katsuhaa/abarth595-round-gauge/ui_spec.md

# 595 表示器 仕様書

- 2026-11-12(表示器 meter_display 2.16.0、CANリーダー c6_can_link 2.0.0)
- 対象: アバルト 595(シリーズ 4)の純正ブースト計の位置に付ける丸型表示器と、OBD コネクタ付近の CANリーダー。画面・操作・使う CAN 信号・RaceChrono の登録をこの 1 冊にまとめた(2026-10-08 の UI 仕様書、サーキット画面・減光の仕様書、RaceChrono チャンネル一覧を統合)
- 配線・部品は別資料「595表示器_配線図」(Rev.1.6)
- 数値はファームウェア(meter_display/config.h)の値。設定で変えられるものは 8 章

## 1. 構成

| 部分 | 内容 |
| --- | --- |
| 表示器 | Waveshare ESP32-S3-Touch-AMOLED-1.75(丸型 466×466、タッチ、IMU QMI8658 内蔵)。arduino-esp32 3.3.11、NimBLE-Arduino 1.4.3。ボード「ESP32S3 Dev Module」、USB CDC On Boot = Enabled、PSRAM = OPI PSRAM、Partition Scheme = Huge APP |
| CANリーダー | Seeed XIAO ESP32C6 + SN65HVD230 ×2。C-CAN(500 kbps)と B-CAN(50 kbps)を受信だけ(送信・ACK なし)。CAN の生データを UART 921600 bps で表示器へ送る: 中身が変わった ID は最短 20 ms 間隔、変わらない ID は 1 秒ごと、1.5 秒受けていない ID は送らない |
| GPS | HGLRC M100(u-blox M10)。表示器が UBX で設定を書く: 衛星系は GPS・Galileo・QZSS(BeiDou・GLONASS・SBAS は切)、測位 20 回/秒、115200 bps、NAV-PVT だけ。M10 の測位の上限は GPS+Galileo で既定 10 回/秒なので、表示器が起動時に M10 の OTP(一度だけ書ける設定)に高性能設定を書いて 20 回/秒にする(未設定のときだけ書き、M100 をリセットして確かめる。永久で元に戻せない。結果は 受信の状態 → GPS →「OTP」。手順は u-blox の SAM-M10Q 統合マニュアル 2.1.5 のとおり: 確かめる問い合わせ(VALGET 層 4)が NAK = まだ書いていない → 書いてリセットし、同じ問い合わせが高性能の値を返せば「済」。書くのはこの表示器で一度だけ(NVS に印。2.14.5))。表示器の「IO17」← M100 の送信、「IO18」→ M100 の受信(2026-10-31 の試験で確定。配線図 Rev.1.7 の GPS の矢印とは逆)。時計・過負荷時間の時刻・RaceChrono に使う |
| RaceChrono | 表示器が Bluetooth LE 機器「595 meter」(RaceChrono DIY)になり、GPS・車の CAN の生データ・IMU を 1 台で送る(10 章) |
| 電源 | IG 連動の 12 V(ヒューズ F49 から 5A→3A のヒューズ電源)→ 表示器内の降圧コンバータ(MP1584EN)で 5 V → CANリーダー・M100 |

## 2. 操作

- タッチは触れて 0.1 秒で確定し、離したときに動く。それより短いタッチは無視。
- 画面(サーキット・タコ・データ): 左へスワイプ = 次、右へ = 前(サーキット → タコ → データ → サーキット)。スワイプ = 横に 160 px 以上(縦の 2 倍以上)。タップは何もしない。
- 長押し: 0.4 秒で案内(上「‹ スワイプ ›」、下「長押し ▶ 設定」)と外周の円が出て、1.2 秒で設定に入る。途中で離す・80 px 以上動かすと何もしない。
- 設定の中: 上の帯「‹ 名前」= 1 つ上へ(設定の段では「‹ 設定」で元の画面へ)。左右の半分のタップかスワイプ = 前・次。長押し 1.2 秒 = カテゴリ・メニューに入る(下の帯「長押しで開く」)。変更の画面: − + で値、「決定」のタップで保存(帯が 3 回点滅)、「‹ 戻る」で捨てる。リセットなどの赤い帯はタップ(確認の画面を通す)。
- 自動で戻る: 設定の中で操作が無いまま「自動で戻る」(初期 3 分)たつと、覚えている画面へ。覚えている画面 = 60 秒以上見ていたサーキット・タコ・データ。次の起動もその画面から。
- オープニング: 電源 ON で覚えている画面に応じた動き(サーキット = 輪が点いて消える、タコ = 針が振り切って戻る、データ = 外周の輪と自己診断 CAN・GPS・IMU・タッチ、版の表示)約 3 秒。タッチで飛ばせる。

## 3. 回転数の表示(全画面で共通)

S = 設定「シフトポイント」(初期 5800 rpm)。S を変えると下の回転数は同じ幅だけ動く。

| 項目 | 決まり |
| --- | --- |
| 輪(両側) | 26 マス(400 rpm/マス、すき間 2°)、半径 176〜228。左右対称に下から上へ点く。点き始め S−4400(1400)、S で全周 |
| 輪(片側) | 4 時の位置から右回りに真上まで 23 マス(200 rpm/マス)。点き始めは同じ、S で真上(最後のマス)。真上〜4 時には何も出さない |
| 色 | 灰 #8D97AD → 青 #2B7BFF(S−2800)→ 緑 #22E36A(S−1800)→ 黄 #FFDC00(S−400)→ 赤 #FF2A2A(S+400)。切り替わりの手前 400 rpm で直線的に混ぜる。消えているマスは背景色 |
| 背景(サーキット) | 黄の手前まで黒。黄 #C4A000、赤 #A31515(輪と同じ混ぜ方) |
| 点滅 | S−400 から。消灯 80 ms 一定、点灯は 150 ms(始まり)→ 50 ms(S)に回転数に比例して短く。画面全体を明るさ 0 で消す。S+200 以上は点滅せず、全点灯・明るさ 100 % |
| ピークホールド | 3000 rpm 以上で 200 rpm 以上はっきり上がったら、最高の回転数に印を出す(1.5 秒止まり、2000 rpm/s で今の回転数まで下がる)。最後に上がってから 5 秒で消す。3000 rpm 未満に下がったら消す。回転数が印を超えたら取り直す。サーキット = 画面の端の黄色の三角(輪のマスの位置。片側は 1 つ)、タコ = 黄色の印(半径 186〜228) |
| 明るさ | ふだん = 「明るさ」(初期 80 %)。ライトのスイッチが入の間 = 「イルミネーションの明るさ」(初期 30 %)。点滅の消灯 = 0。S+200 以上とオープニングの赤 = 100 %(ライトに関係なく)。フェードなし。明るさの 2 項目は、変更の画面を出している間はその値で表示 |

## 4. サーキット画面

| 要素 | 決まり |
| --- | --- |
| 回転数の輪 | 3 章 |
| 時計 | 輪の内側。目盛 60 本(毎時は長く太い。太さは毎時 4.5 px、1 分ごと 2.5 px。2.16.0 で太くした)。時針・分針は四角の塗りつぶしで、色で見分ける(2.16.0): 時針(短針)= 白、分針(長針)= 黄 #FFDC00(背景が黄のときは紺)。まわりに細い黒の縁(弧・目盛の上と、黄・赤の背景で形を分ける)。秒針は赤 #FF3B30 の正三角形(縁つき)。時刻 = GPS の UTC + 9 時間。GPS の時刻が分かるまで針は出さない(デモの間はビルドした時刻から進める)。1 秒ごとに動く |
| 水温・燃料の弧 | 時計の内側(半径 98〜134、長さ 100°)。水温 = 上の弧(左端から時計回り。40〜120 ℃、70 ℃まで青 #2F8BFF、それより上は白。警告温度から上の地は暗い赤 #6A1C26)、アイコンは右端。燃料 = 下の弧(左端から反時計回り。0〜100 %、白。燃料の警告 未満の地は暗い赤)、アイコンは左端。信号なしは「– –」 |
| 真ん中 | 上から順に当てはまる 1 つ: ① ピークの三角を出している間 = ピークの回転数(88 px)と「rpm」。上がり切って下がったあとは黄、加速中(今の回転数が数字の 100 rpm 以内)は白。② 過負荷時間が黄(黄が切なら赤)になってから 0 に戻るまで = 半径 96 の黒い円に、タイトル「過負荷」と 分:秒(白・黄・赤)。クールダウン中はタイトル「クールダウン」とリセットまでの残り(水色)。条件を満たせば下に「▼ (過負荷 回転数)rpm」と経過時間、GPS の時刻が不明なら上に「時刻 待ち」。③ 過負荷の機能が切で、ギア N が 60 秒続いた = 「▼ (過負荷 回転数)rpm」とその回転数未満になってからの経過時間。④ そのほか = デジタル時計(時:分)。接続の状態(GPS・IMU・RaceChrono・CAN の 4 行、点は 緑 = 正常・灰 = 待ち・切・赤 = 異常)は、変わってから 10 秒の間と GPS の時刻が分かるまでの間だけ出す |
| 注意・警告 | 2 段。注意 = 水温 ≥ 警告温度 − 5 ℃、燃料 < 燃料の警告 + 10 %: 弧の伸びた所とアイコンが暗い黄 #E0B000(点滅なし)。警告 = 水温 ≥ 警告温度、燃料 < 燃料の警告: 赤 #E3241B で 250 ms ごとに点滅(消灯側は暗い赤 #8E130D)。背景は塗らない(黒のまま)。戻るときは境目から 1 ℃・1 % の幅 |
| メンテナンス | 累積時間がメンテナンスの時間に達したら赤の「メンテナンス」(7 章) |
| デモ | 模擬データの間は「SIM」と場面番号 |

## 5. タコ画面

| 要素 | 決まり |
| --- | --- |
| 回転計 | 0〜8000 rpm。0 を左下(3 時から時計回りに 120°)に置き、1000 rpm = 25°(6000 が真上)。目盛線は 1000・500・250 ごと(灰)、数字は ×1000(60 px、白)。赤の範囲は S から(暗い赤の帯、数字は赤)。回転数が S 以上の間は目盛線・数字・針を全部赤(S−100 まで下がると戻す)。針は白、太さ 14 px、黒い縁 3 px と影。ピークの印は黄(3 章) |
| ブースト | 中央の輪(半径 62〜108)。0 bar を左下(回転計の 0 と同じ角度)、1.4 bar を真上、2.0 bar を端(回転計の 8000 と同じ角度)に置き、その間は比例。1.4 bar から赤。目盛線 0・0.5・1.0・1.4・2.0、数字 0・1・2 は輪の内側。今の値は右上に数字(bar、小数 2 桁、56 px、白。負圧は −。信号なし「– –」) |
| ギア | ブーストの数字の下(右下、100 px)。1〜5・N・R、分からないときは「–」(9 章) |
| 注意・警告 | 水温・燃料が注意・警告のときだけ、右下に札(アイコン + 数字)。注意 = 黒地に暗い黄の枠と文字(点滅なし)、警告 = 赤い札に白い文字(250 ms 点滅)。正常なら出さない。境目は 4 章と同じ |
| SPORT | スポーツモードの間、下の真ん中に赤の「SPORT」 |
| メンテナンス | 7 章 |

## 6. データ画面

| 要素 | 決まり |
| --- | --- |
| 外周 | 回転数の輪(半径 222〜232)。真上から時計回りに 0〜8000 rpm で一周。色は 3 章 |
| 上の 3 行 | GPS: 衛星の数と測位の回数/秒(受信なし = 赤、切 = 灰)。IMU: 前後・横の加速度 [g](応答なし = 赤、切 = 灰)。CAN: C-CAN・B-CAN の受信数/秒(C-CAN が 0 = 赤)。左の点 = 緑(正常)・灰(待ち・切)・赤(異常) |
| 中 | 水温 ℃・燃料 %(注意は暗い黄、警告は赤で点滅、信号なし「– –」。境目は 4 章と同じ) |
| 下 | ▲ 累積時間(過負荷 回転数以上だった時間の累計)。その下は ▼(未満の累計)。メンテナンスまでの累積時間が入なら、▼ の代わりに「メンテまで」の残り、達したら赤の「メンテナンス」 |

## 7. 過負荷時間・累積時間・メンテナンス

境目 = 設定「過負荷 回転数」(初期 3000 rpm)。

| 項目 | 決まり |
| --- | --- |
| 過負荷時間 | 回転数が境目以上なら 1 秒に 1 秒増え、未満なら 1 秒に 1 秒減る(エンジン停止中も。電源 OFF の間は GPS の時刻から求めて次の起動で引く)。未満が「過負荷がリセットされる時間」(初期 5 分)続いたら 0。上限 9:59:59。回転数の信号が無い間は変わらない |
| 色 | 「過負荷時間 黄」(初期 10 分)以上で黄、「過負荷時間 赤」(初期 30 分)以上で赤。0 の色は使わない。両方 0 で機能を切(数えない・出さない) |
| クールダウン | リセットのあと一度黄(黄が切なら赤)になり、境目未満が 1 分続いたら、タイトルを「クールダウン」にしてリセットまでの残りを水色で出す。境目以上に戻ると「過負荷」に戻る |
| 累積時間 | ▲ = 境目以上だった時間の累計、▼ = 未満の累計(回転数の信号がある間だけ数える)。1 分ごとに保存し、電源を切っても続く |
| メンテナンス | 「メンテナンスまでの累積時間」(初期 5 時間、0 = 切)に ▲ が達したら、サーキット・タコ・データに赤の「メンテナンス」 |
| 累積時間 リセット | 値を 0:00:00 から 30 分ずつ入れて「リセット」: ▲ をその値、▼ を 0、過負荷時間もその値以下にする |

## 8. 設定

設定の段(左右で送る)にカテゴリ、長押しで中へ。中は 1 画面 1 項目。保存先は NVS(名前空間 "meter")。カテゴリの並びは下の表の順(走行記録が最初。2.15.3)。電源を入れてから最初に設定に入ったときは走行記録、そのあとは前に見ていたカテゴリから。

| カテゴリ | 項目 | 範囲 / 刻み | 初期値 |
| --- | --- | --- | --- |
| 走行記録 | 今の ODO。長押しで 1 年の画面(8.1) | | |
| 画面 | 明るさ | 10〜100 % / 10 | 80 |
| | イルミネーションの明るさ | 10〜100 % / 10 | 30 |
| | 自動で戻る | 1〜10 分 / 1 | 3 |
| シフトポイント | シフトポイント | 3000〜7500 rpm / 100 | 5800 |
| | 回転数の輪 | 両側・片側 | 両側 |
| 警告・過負荷 | 水温の警告 | 90〜125 ℃ / 5 | 110 |
| | 燃料の警告 | 5〜50 % / 5 | 20 |
| | 過負荷 回転数 | 2000〜6000 rpm / 100 | 3000 |
| | 過負荷時間 黄 | 0〜90 分 / 5(0 = 切) | 10 |
| | 過負荷時間 赤 | 0〜90 分 / 5(0 = 切) | 30 |
| | 過負荷がリセットされる時間 | 1〜30 分 / 1 | 5 |
| | メンテナンスまでの累積時間 | 0〜99 時間 / 1(0 = 切) | 5 |
| | 累積時間 リセット | 0:00:00 から 30 分ずつ、99 時間まで | – |
| 受信の状態 | 長押しで中へ。CAN・GPS・IMU・RaceChrono の 4 グループ(下) | | |
| 本体の状態 | 長押しで中へ。FPS(直近 3 分のグラフ。平均 20 未満で赤)・CPU・クロック・温度・RAM・PSRAM・フラッシュ・起動のきっかけ・走行記録(件数・今日の距離・ODO の受信。下の行に ODO と最後に書いた時刻) | | |
| その他 | デモ | 入・切 | 切 |
| | デフォルトに戻す | 設定を全部初期値に。過負荷時間は 0。累積時間・IMU の向きは残す | |

受信の状態の中:

- CAN: 通信速度・受信・誤り・欠落・CANリーダー(版)・C-CAN/B-CAN(受信数。ここから「CAN確認」)・燃料(b5 の生の値)・ライト(点/消と今の明るさ)・前後で比べる。
- GPS: 測位(衛星の数と回数/秒)・位置・速度・OTP(M100 の高性能設定: 済 20 Hz / 待ち / 未 10 Hz / 不明 / 異常。不明・異常は赤)。IMU: 加速度・向きの補正(取り直し)。RaceChrono: 送信(入・切。次の起動から)・接続・送った数(CAN・GPS・IMU の数/秒。捨てた数。2.14.2: RaceChrono が IMU の PID 0618A0F1/F2 を頼んでいなければ「IMU 未設定」(片方なら F1/F2未設定)で待ち)。
- 点の色: 緑 = 正常、赤 = 異常、灰 = 待ち・切。まとめは、赤が 1 つでもあれば「異常 n」、通信の項目が全部緑なら「正常」、ほかは「待ち」。
- CAN確認: 「変化を記録」を押すたびに、前の記録から 1〜8 回変わったバイトを持つ ID に絞る(スイッチのような信号)。行を開くと 8 バイトの値と 20 秒の折れ線。「前後で比べる」(2.16.0 で作り直し): 下の「前を記録」「後を記録」を交互に押す(1 回目は前)。押してから 10 秒受けたものを 1 回の記録にし、何回でも繰り返して絞る。記録は保存されるので、電源を切っても続けられる(エンジンをかけ直さないと戻らない切り替えにも使える)。候補は、毎回の記録の間ずっと変わらなかったビットで、前ではいつも同じ値・後ではいつもその逆のもの(一覧の「b0 & 02  01 → 03」= バイト & 候補のビット、1 回目の前 → 1 回目の後のそのバイトの値)と、前では毎回受けて後では一度も受けなかった ID(後は受信なし)、その逆(前は受信なし)。受信が始まって 15 秒は記録できない(帯に待ちの秒)。記録の間に状態を変えると、変わったビットは候補から外れて戻らないので、切り替えてから押す。画面: 候補の件数・前と後の回数・件数の移り変わり、左「やり直す」(記録を全部消す)、右「一覧」(今は受けていない ID は「今は受信していない」で、詳細なし)。2.15.x までの前の記録は読み戻さない。
- デモ: 入の間は UART を読まず、模擬の値(場面 1〜9)を出す。
- 落ちる起動が 2 回続いたら、表示器が RaceChrono 送信と GPS を自分で切にする(送信を入に戻すと次の起動から戻る)。
- 保存するもの: 設定、累積時間 ▲▼、覚えている画面、IMU の向き、過負荷時間と時刻、前後で比べるの記録、GPS を止めた印。走行記録はパーティション spiffs(8.1)。

### 8.1 走行記録(2.15.0。詳しくは仕様書 odo_log_spec.md)

- 記録: ODO(B-CAN 0C014003、km)とその日の過走行時間(▲ と同じ数え方)を、低速(10 km/h 以下。停車も入る)かリバースのとき、前の記録から増えていて 60 秒以上あいていれば 1 件(32 バイト)書く。日付は GPS の時刻(日本時間)。時刻が分かるまでは書かない。0 時をまたいだら、次に低速・リバースになったときに前の日の締めの記録を書く。
- 保存先: パーティション spiffs(Huge APP で 896 KB = 28,672 件、輪のように古い方から消す)。Partition Scheme を切り替えると消える。
- 画面: 設定 → 走行記録(今の ODO)→ 長押しで 1 年 → 長押しで 3 ヶ月 → 1 ヶ月 → 1 週(日曜〜土曜)→ 1 日(1 年は 2.15.2 から)。1 画面 1 期間: 期間・終わりの ODO(大きく。今の期間は今の ODO)・始まり〜終わりの ODO・距離・▲ 過走行時間。左右のタップかスワイプで前・次の期間(今の期間より先、いちばん古い記録の期間より前へは進まない)。長押しで細かい方(その期間の中の、今日までで最後の期間)、上の帯で粗い方(来た期間へ戻る)。記録の無い日は、その前の記録の ODO。3 ヶ月は 1〜3 月・4〜6 月・7〜9 月・10〜12 月。GPS の時刻が分かるまでは「時刻 待ち」と今の ODO・起動からの距離。

## 9. 使う CAN 信号(表示器での換算)

すべて 29 ビット ID。b0 が先頭のバイト。「信号なし」= その時間受けなかったら値を消す。

| 信号 | バス | ID | 位置・換算 | 使う所 | 信号なし |
| --- | --- | --- | --- | --- | --- |
| 回転数 | C | 0618A001 | b2〜b3(ビッグエンディアン)= rpm | 輪・タコ・ピーク・過負荷・累積時間 | 2 秒 |
| アクセル | C | 0618A001 | b7 / 2.55 = % | (表示には使っていない) | 2 秒 |
| 車速 | C | 0210A006 | b4〜b5 / 128 = km/h | ギアの推定 | 2 秒 |
| クラッチ | C | 0628A001 | b5 の 0x20 = 踏んでいる | (ギアの保持には使っていない) | 2 秒 |
| 水温 | C | 0A18A001 | b3 − 40 = ℃ | 弧・数字・警告 | 3 秒 |
| リバース | C | 0A18A001 | b7 の 0x04 = R | ギア | 2 秒 |
| ブースト | C | 0A1CA001 | b2 × 0.02 = bar(大気圧との差) | タコ | 2 秒 |
| 燃料 | C | 0A18A000 | b5 = %。0 と 100 超は捨てて前の値のまま(エンジン停止中と始動・停止の前後約 1 秒は 0 で来る) | 弧・数字・警告 | 5 秒 |
| スポーツモード | C | 0A18A000 | b4 の 0x10 = SPORT | タコ | 5 秒 |
| ODO | B | 0C014003 | b1 の下位 4 ビット + b2 + b3(20 ビット、ビッグエンディアン)= km。減った値と 5 km を超えて増えた値は捨てる(同じ値が 20 回続いたら使う) | 走行記録 | 2 秒(書かない) |
| ライトのスイッチ | B | 06214000 | b0 の 0x08 = 入(ほかのビットは見ない。違う値が 0.3 秒続いたら切り替え) | 明るさ | 5 秒(明るさは最後の状態のまま) |
| ギア | – | – | R はリバースのビット。1〜5 は 回転数 ÷ 車速 を各ギアの計算値(変速比 3.909 / 2.238 / 1.520 / 1.156 / 0.872、最終減速比 3.353、タイヤ外周 1.878 m)と比べ、±12 % に入ったギア。車速 2 km/h 未満は N、5 km/h 未満か 500 rpm 未満は前の値のまま、どれにも合わなければ「–」 | タコ | |

## 10. RaceChrono の登録

### 10.1 機器

RaceChrono(iPhone)の 設定 → Add other device → Add other device → RaceChrono DIY で「595 meter」(Bluetooth LE)を 1 台登録する。GPS はこれで届く(登録不要)。IMU と車の CAN は、車両プロファイル → CAN-Bus チャンネル に 10.3 の表を登録する。IMU は CAN の形で 20 回/秒送る(取り付けの向きは自動で覚える: 停車 3 秒で「上」、発進の加速で「前」)。

### 10.2 入力の決まり

- チャンネルは「種類」を一覧から選ぶ(自由な名前は付けられない)。種類ごとに RaceChrono が受ける単位が決まっているので、方程式はその単位に合わせてある: 速度・ホイールスピード = m/s(km/h ÷ 3.6)、マニホールド圧 = psi(bar × 14.5038)、ポジション = %、温度 = ℃、角度 = °、加速度 = m/s²、ヨーレート = deg/s。
- PID は 10 進で入力する(入れると「0x 06 18 A0 01」のように表示される)。
- 方程式の割る数には小数点を付けてある(整数 ÷ 整数は切り捨てになる)。ビット番号は b0 の最上位ビットを 0 と数える。
- 表示器は登録した PID だけを送る(最大 48 種、1 PID につき最短 50 ms)。B-CAN の登録は不要。
- リバースとスポーツモードは、合う種類が無いので RaceChrono には登録しない(表示器で見る)。

### 10.3 チャンネル

| # | 種類 | PID(10 進) | 方程式 | 備考 |
| --- | --- | --- | --- | --- |
| 1 | エンジン回転数 | 102277121 | `bytesToUint(raw, 2, 2)` | rpm |
| 2 | スロットルポジション | 102277121 | `bytesToUint(raw, 7, 1) / 2.55` | % |
| 3 | 速度 | 34643974 | `bytesToUint(raw, 4, 2) / 460.8` | m/s(km/h ÷ 3.6) |
| 4 | ホイールスピード FL | 35168262 | `bytesToUint(raw, 6, 2) / 57.6` | 左前。m/s |
| 5 | ホイールスピード FR | 35168262 | `bytesToUint(raw, 4, 2) / 57.6` | 右前 |
| 6 | ホイールスピード RL | 35168262 | `bytesToUint(raw, 2, 2) / 57.6` | 左後 |
| 7 | ホイールスピード RR | 35168262 | `bytesToUint(raw, 0, 2) / 57.6` | 右後 |
| 8 | ステアリング角 | 3186690 | `(bitsToUint(raw, 24, 20) - 7235) * 0.1` | °、左が +。7235 = 直進の生の値(10/22 の走行ログの直進区間)。直進で値が出るときは、その 10 倍を 7235 に足して直す(+1.5° なら 7250) |
| 9 | ブレーキ圧 | 1089542 | `bytesToUint(raw, 1, 2)` | 生の値(圧力への倍率は未確定。単位は付かない数字として見る) |
| 10 | ブレーキポジション | 135307264 | `bitsToUint(raw, 18, 1) * 100` | 0 / 100 %(踏んでいる = 100) |
| 11 | クラッチポジション | 103325697 | `bitsToUint(raw, 42, 1) * 100` | 0 / 100 %(踏んでいる = 100) |
| 12 | 水温 | 169385985 | `bytesToUint(raw, 3, 1) - 40` | ℃ |
| 13 | マニホールド圧(吸気圧) | 169648129 | `bytesToUint(raw, 2, 1) * 0.290076` | ブースト。psi(0.02 bar = 0.290076 psi。68 → 19.7 psi = 1.36 bar)、大気圧との差。要るときだけ |
| 14 | 燃料レベル | 169385984 | `lowPass(highPass(bytesToUint(raw, 5, 1), 1), 100)` | %。1〜100 以外(エンジン停止中の 0)は NaN で記録しない。要るときだけ |
| 15 | 縦加速度 | 102277361 | `bytesToIntLe(raw, 0, 2) * 0.00980665` | m/s²、前が + |
| 16 | 横加速度 | 102277361 | `bytesToIntLe(raw, 2, 2) * 0.00980665` | m/s²、右が + |
| 17 | Z加速度 | 102277361 | `bytesToIntLe(raw, 4, 2) * 0.00980665` | m/s²、上が +(重力は引いてある)。10/15 に登録済みの種類 |
| 18 | ヨーレート | 102277362 | `bytesToIntLe(raw, 0, 2) * 0.01` | deg/s、左が + |

- 1〜12 と 15〜18 がふだんの登録(PID 10 種)。13・14 は要るときだけ(PID が 1 種ずつ増える)。
- 種類の名前は RaceChrono の一覧の表記に合わせる(英語表示なら Engine RPM / Throttle position / Speed / Wheel speed FL〜RR / Steering angle / Brake pressure / Brake position / Clutch position / Coolant temperature / Manifold pressure / Fuel level / Longitudinal acceleration / Lateral acceleration / Z acceleration / Yaw rate)。
