katsuhaa/abarth595-round-gauge/cad/595merter.FCStd

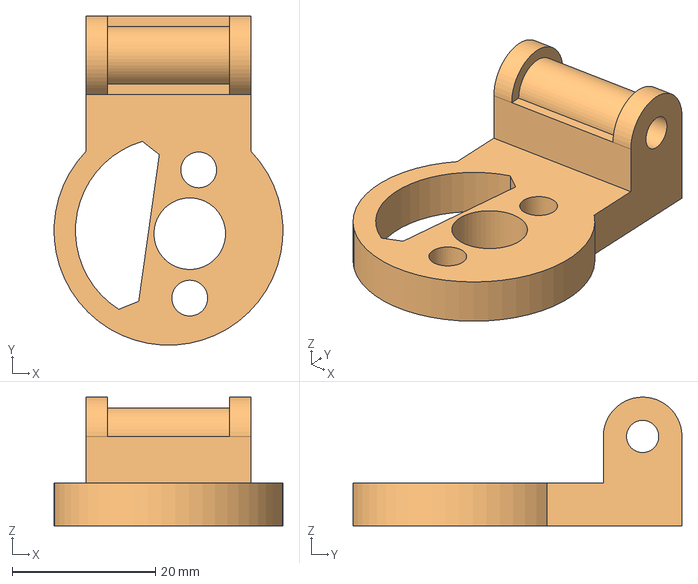
[picture p5: CAD file, 2026-10-29]
cad/595merter.FCStd
32.0 x 46.0 x 18.0 mm
flex-bracket-spacer
flex-bracket+spacer
