katsuhaa/abarth595-round-gauge/cad/obd2-can-link.FCStd

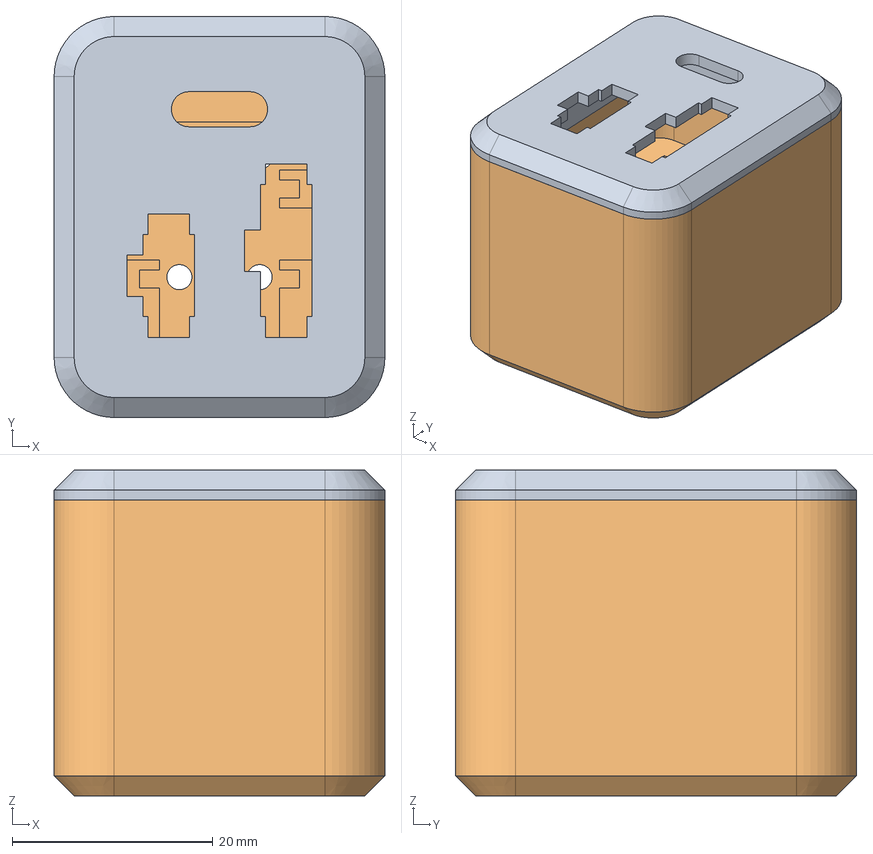
[picture p6: CAD file, 2026-10-25]
cad/obd2-can-link.FCStd
33.0 x 40.0 x 32.5 mm
canreader-lid
canreader-body
