katsuhaa/abarth595-round-gauge/meter_display/config.h

// config.h - 595 メーター表示器の設定値
//
// 画面の配置と色は ui_spec.md(キャンバス版 23)のとおり ui.cpp に書いてある。
// ここには、仕様書で【仮】【未定】になっている値と、基板まわりの値をまとめた。
// 【未定→仮】は、仕様書で未定だった所に今回仮に置いた値。
#pragma once

// ---------------------------------------------------------------- 版(2026-10-23 から git で管理。上げるたびにコミットする)
// 形式は「大.中.小」。小 = 直しだけ、中 = 機能・画面の追加や変更、大 = CANリーダー(c6_can_link)とのデータ形式が変わるとき。
// データのオープニング(自己診断の下)と設定の上の帯に出す。CANリーダーの版は 受信の状態 → CAN の「CANリーダー」に出る
// 2.0.0(2026-10-23): 値への換算・ギアの推定・燃料のなましを c6_can_link から移した(c6_can_link 2.0.0 と組で使う。1.x の c6_can_link でも動く)
// 2.0.1(2026-10-23): タッチの読み取りのあとに 0xAB を書くのをやめた(長押しが「離した」で切れる)。受信の状態の「描画」を、
//   サーキット・タコで 1 回描いて送る時間の最長にした(前は直近 1 秒に送った回数で、受信の状態の画面では必ず 2 になっていた)
// 2.1.0(2026-10-23): サーキット・タコ・データの操作を、左右のスワイプで画面を替え、長押しで設定に入る形にした(短いタップは何もしない)
// 2.2.0(2026-10-23): 実車で試した結果から、長押し 0.8 秒・表示は半分から・スワイプの幅 160 px。ピークホールドは 3000 rpm 以上で、
//   回転数が下がっているときだけ出し、ピークを超えたら消す(時間がたつと下がるのは前のまま)。通信が切れているのに設定の「受信の状態」
//   「RaceChrono」が「正常」と出ていたのを直した。
//   受信の状態に「燃料」(生の値となましの値)を足した(燃料が 100 % から動かない件を実車で見るため)
// 2.3.0(2026-10-24): タッチは TOUCH_CONFIRM_MS 押し続けてから決める(短いタッチは何もしない)。サーキット・タコ・データでは
//   決まった時点で真ん中に操作の案内を出す。長押しは表示が 0.8 秒、設定へ 1.2 秒。設定の「決定」で保存したら「保存しました」を出す。
//   設定の上の帯を「‹ 設定」にした。設定の並びを 明るさ・受信の状態・シフトポイント・水温の警告・時間の記録・自動で戻る・デモ にし、
//   RaceChrono と CAN確認 は受信の状態の中へ移した(受信の状態に GPS・IMU も足した)。受信の状態の「描画」を「FPS」にし、
//   1 回だけの大きな描き直し(受信が切れた瞬間など)で赤にならないようにした
// 2.3.1(2026-10-24): 2.3.0 を実機で試した結果から: タッチが決まるまでを 0.3 → 0.1 秒(設定の中で、ふつうのタップが効かなかった)。
//   長押しは 0.4 秒で表示を出し、外周は 0.8 秒で一周して 1.2 秒で設定(2.3.0 は 0.8 秒で表示、外周 0.4 秒)。案内は長押しの表示と
//   同じ形の札 2 つ(上に「長押し ▶ 設定」、真ん中に「‹ スワイプ ›」)にし、動きをなくした。「保存しました」の画面をやめ、保存した値を
//   緑で数回点滅させる(2.3.0 はコミットしていない試しの版)
// 2.4.0(2026-10-24): 2.3.1 を実機で試した結果から(2.3.0・2.3.1 はコミットしていない試しの版):
//   受信の状態を分け直した(CAN・GPS・IMU・RaceChrono のグループ。中は 1 ページ 1 項目。同じ値は 1 か所だけ。CAN確認は CAN の
//   「C-CAN・B-CAN」から開く。「送り元」は「CANリーダー」)。受信と関係ない FPS・起動は、設定の新しい項目「本体の状態」へ。
//   上の帯は今いる所の名前。変更の画面は値を枠で囲み、下の「決定」を水色の帯にした(項目の画面と見た目を分けた)。
//   スワイプは右へ = 次(前は左へ = 次。2.4.2 で左へ = 次に戻した)。設定の中の項目・ページの送りもスワイプにし、どの画面も離したときに決める。
//   案内は上に「‹ スワイプ ›」、下に「長押し ▶ 設定」(上下対称)。長押しの途中は案内のままスワイプの札を灰にして外周が回る
//   (暗くしない)。長押しを取り消す動きを 30 → 80 px にし、取り消したら案内は出したまま長押しの札を灰にする。
//   ピークホールドは 5 秒止まってから下がり、ピークが 3000 rpm 以上なら上がっていても出す。タコは回転数がシフト点以上の間、
//   目盛線・数字・針を全部赤にする
// 2.4.1(2026-10-24): 設定の中の左右の「‹」「›」のタップで前・次に送るのを戻した(2.4.0 はスワイプだけで、矢印が押せなかった。
//   スワイプでも送れる)。変更の画面の値の枠をやめ、値を水色にした(「決定」の水色の帯はそのまま。2.4.0 はコミットしていない試しの版)
// 2.4.2(2026-10-24): スワイプを左へ = 次(サーキット → タコ)に戻した(2.4.0〜2.4.1 は右へ = 次。本人「間違えました 左にスワイプでタコでした」)。
//   設定の中のスワイプも左へ = 次(右の「›」のタップと同じ向き)。2.4.1 はコミットしていない試しの版
// 2.4.3(2026-10-24): 設定の中の下の帯は、開く・変更するときはどれも「決定」にした(「開く」「変更」「詳細」をやめた。本人「操作の統一感
//   がなく戸惑う」)。CAN確認は CAN の最後のページから開く。IMU の向きの取り直しは確認の画面を通す。変更の画面で「決定」で保存したら、
//   押した所(下の帯)を点滅させ、その間は値を太くし、終わってから戻る(戻った画面で値を緑で点滅させるのはやめた)。
//   本体の状態に CPU・クロック・温度・RAM・PSRAM・フラッシュを足した。FPS は直近 3 分(サーキット・タコを出していた秒)の 1 秒ごとの値の
//   グラフを出し、赤は平均で決める(前は最低で決めていて、毎回赤だった)。サーキットのピークの三角形は、シフト点で輪の真上まで行く
//   (前は 12 マス目で止まっていた)。2.4.2 はコミットしていない試しの版
// 2.4.4(2026-10-24): 設定の中でメニューに入る(開く)のは、下の帯の長押しにした(サーキット・タコ・データから設定に入るのと同じ HOLD_MS。
//   下の帯は「長押しで開く」。本人「メニューに入るときは長押しで開くにします。下の帯にも長押しで開くと書いてください」)。「決定」は値を
//   確定するとき(変更の画面)だけ(2.4.3 は開くのも「決定」で、意味が 2 つになっていた)。ピークホールドは、止まる時間を 2.2.0 と同じ
//   1.5 秒に戻し、そのあと下がりながら出し続け、回転が落ち始めてから 5 秒で消す(2.4.0 の「5 秒止まる」は本人の意図の取り違え)。
//   2.4.3 はコミットしていない試しの版
// 2.4.5(2026-10-24): 2.4.4 を実機で試した結果から: 「長押しで開く」は画面のどこを長押ししても開く(2.4.4 は下の帯だけ。本人「その場所では
//   なく画面全体です」)。「決定」は変えていなくても押したら点滅させる(本人「決定のフラッシュが消えました」。2.4.3〜2.4.4 は保存したときだけ)。
//   ピークホールドの印を出す時間(5 秒)を数え直すのは、回転数がはっきり上がったとき(PEAK_RISE_RPM 以上)だけにした(本人「今度ピーク
//   ホールドが消えていません」。2.4.4 は 3000 rpm 以上で回転数が少しでも上がるたびに数え直していて、走っている間は消えなかった)。
//   印が 3000 rpm を切ったら消す(本人「3000 以下に下がった場合は消してしまっていいです」。2.4.4 は 5 秒までは出していた)。
//   2.4.4 はコミットしていない試しの版
// 2.5.0(2026-10-24): オープニングを、覚えた画面(サーキット・タコ・データ)ごとの 3 種類にして、長く(約 3.3 秒)した(本人「もう少し長く
//   印象的に」「アニメーションはサーキット、タコ、データの 3 つ」「データは GPS などの状態を出す。それ以外は状態の画面は出さなくていい」)。
//   サーキット: 白い光が輪を走り、回転数を上げるように点いて、背景も赤のリミッター、下げるように消えてギアが浮かぶ。タコ: 針が振り切りまで
//   上がって戻る(通った所から文字盤が出る)。データ: 外周の輪と、1 行ずつ確かめる自己診断。流れは下のオープニングの節。
//   データ画面の外周に回転数の輪を足した(本人「実際の画面にも回転数のグラフを追加したい」「アニメーションと同じ幅で」。DATA_RING_*)。
//   2.4.5 を実機で試した結果から: 設定の中で、矢印のタップでは下の帯「長押しで開く」を変えない(水色にするのは長押しの外周が回り始める
//   HOLD_SHOW_MS から。本人「左右の矢印をタップした時に長押しで開くボタンが反転してしまうので混乱します」)。
//   2.4.5 はコミットしていない試しの版
// 2.6.0(2026-10-24): CAN確認に「前後で比べる」を足した(受信の状態 → CAN の最後のページ。本人「長く変化する燃料のような CAN ID を
//   今のメニューで絞り込めるか」「変化が少ない項目の中で、給油のようなイベントを記録して変化が大きいものを検出する」)。前を記録 →
//   電源を切って給油など → 入れ直して後を記録で、前も後も変化が少なく差が大きいバイトを出す。前の記録は NVS に保存する。CAN_PP_*
// 2.7.0(2026-10-24): 燃料を C-CAN 0A18A000 b5(残りの %)にした(2.6.0 までの B-CAN 0C014003 b5 は燃料ではなかった。本人「どうも燃料の
//   canID が違うのではないかとおもうぐらいズレます」)。値が落ち着いているので、なまし・給油の判定・保存をやめた(下の 燃料)。
//   長押しの表示(外周)が出たあとに離したら何もしない(本人「長押しを認識して、アニメーションが出た後に指を離した場合は何も動作しない
//   ほうがいい」。2.6.0 までは、その所のタップになっていた)。設定・CAN確認の上の帯と、タップで動く下の帯は、押している間は反転し、
//   下の帯は離して PRESS_FLASH_MS 見せてから動く(本人「can確認画面などでボタンを押した時に押したことがわかりにくいので、反転表示を
//   入れてください」)。前後で比べるの案内を「エンジンを切る前に記録」にした。2.6.0 はコミットしていない試しの版
// 2.8.0(2026-10-25): ブーストを C-CAN 0A1CA001 b2 × 0.02 bar にした。2.7.0 までの 0A18A001 b4 は燃料の量だった(本人「ブースト圧と車速は
//   比例で立ち上がりますか？」「燃料ではないですか？　減速ですぐに０になるも理にかないます」。減速の燃料カットで 0、クラッチを踏んで
//   900〜1300 rpm に落ちると戻る)。係数は本人決定(「0.02で行きます」)。10/22 の全開(2 速)の最大 68 → 1.36 bar。
//   タコのブーストの輪は、真上(0 時)を 1.4 bar、端を 2.0 bar にした(本人「ブーストのグラフを１．４barを天井にしてください」
//   「グラフが０時になったときに１．４としてください」「端は２．０にします」。2.7.0 は真上が 1.5 bar)。赤は 1.4 bar から。
//   0〜1.4 bar を左下から真上まで、1.4〜2.0 bar を真上から端まで、それぞれ比例。目盛線は 0・0.5・1.0・1.4・2.0
// 2.9.0(2026-10-26): ライトのスイッチ(B-CAN 06214000 b0 の 0x08。下の VEH_ID_LIGHT)が入の間は、ふだんの明るさを設定の新しい項目
//   「イルミネーションの明るさ」(明るさの次。初期値 30 %)にする(本人「ライトがONの時に表示の明るさを落とす機能を追加したい」。
//   Project の仕様書 light_dimming_spec.md 第 3 版)。点滅の消灯(0)、シフト点 + RING_SOLID_OFFSET 以上の最大(100 %)とオープニングの赤は
//   ライトに関係なく今のまま(本人「A」)。明るさの 2 つの項目は、変更の画面を出している間はその値で表示する。
//   受信の状態 → CAN に「ライト」(燃料の次)。設定の名前が 1 行に入らないときは 2 行に分ける
// 2.10.0(2026-10-27): サーキット画面を作り直した(Project の仕様書 circuit_screen_spec.md 第 3 版、キャンバス「595 メーター サーキット画面・
//   タコ画面 案」)。輪の内側にアナログ時計(GPS の時刻 + 9 時間。目盛 12 本、四角い時針・分針・秒針を水温・燃料の弧の半分から重ねる)、
//   水温・燃料の弧は時計の内側(半径 98〜134。アイコンは水温が右端、燃料が左端)。真ん中のギアをやめ、ピークの回転数(「rpm」を下に)・
//   高負荷時間(黒い円の上にタイトルと白・黄・赤の文字。クールダウン時間を超えたらタイトルを「クールダウン」)・接続の状態(GPS・IMU・
//   RaceChrono・CAN)を出し分ける。高負荷時間(load): 3000 rpm 以上で増え、未満で減り、3000 rpm 以下が「高負荷時間 リセット」続いたら 0。
//   ▼ 3000rpm は高負荷時間の下に出し、高負荷時間が 0 になったら消す。タコはブースト圧の数字を上に小さくし、下にギア。警告の札を下へ。
//   設定に「高負荷時間 黄」「高負荷時間 赤」「クールダウン時間」「高負荷時間 リセット」「デフォルトに戻す」(本人 14:51「デフォルト設定を
//   作り、デフォルトに戻すを入れたい」)を足して 14 項目。GPS は RaceChrono 送信の入・切に関係なく動かす(meter_display.ino)。
//   スケッチが既定の 1.2MB APP を超えた(1,339,367 バイト)ので、「ツール」の Partition Scheme を Huge APP か Minimal SPIFFS にする(meter_display.ino の先頭)
// 2.11.0(2026-10-28): 時計の針と目盛を Apple Watch 風にした(時針・分針は枠が白・中が黒の四角、明るい背景では逆。目盛は 1 分ごとに
//   60 本。秒針は縁の付いた赤の正三角形。本人 10/28。キャンバス W1〜W6。下の HAND_*・SEC_*・CLK_TICK_*)。ピークの回転数は、回転が上がり切って
//   下がったあと印が止まっている間(TACH_PEAK_HOLD_MS)だけ黄、加速中と印が下がっている間は白(本人「ホールドしているときに黄色　それ以外は白」
//   「ピークになったときだけ黄色に。加速中も白」。下の PEAK_NUM_DROP_RPM)。サーキットの真ん中の接続の状態は、変わってから 10 秒と時刻が分からない間だけにし、ふだんはデジタル時計(STATUS_SHOW_MS)。タコの下の真ん中に「SPORT」(スポーツモードの間。C-CAN 0A18A000 b4 の 0x10。
//   本人 10/28「スポーツモードのCANIDが確定した」。下の VEH_SPORT_MASK・TACH_SPORT_*)。デモ表示の間は、GPS の時刻が分かるまで、ビルドした時刻
//   (日本時間)から電源を入れてからの時間で時計を進める(本人「デモで時計表示が無いので時刻を確かめられません」。meter_display.ino の timePoll。
//   時計の表示だけで、高負荷時間と保存する時刻には使わない)
// 2.12.0(2026-10-28): 設定に「回転数の輪」(両側・片側)を足して 15 項目(シフトポイントの次)。片側は、4 時の位置から右回りに
//   真上まで 23 マス(200 rpm ごと)並べ、シフト点(最後のマス)が真上(本人 10/28「片方だけのを実装したい」「シフトタイミングが天井で」
//   「なんで左回り？」「右の水平から天井までの回転角で表すように」「回転数の始まりは４時の位置から」。下の RING_ONE_*)。ピークの三角も 1 つ。既定は今までと同じ両側(SET_RING_DEFAULT)。
//   走行画面の背景は黄の手前まで黒(緑をやめた。本人「回転数の警告 → 黄色までは背景を黒に」。ui.cpp の BACK_C)
//   同じ 2.12.0 で(本人「versionは今のままで大丈夫です」)、設定を 6 つのカテゴリにまとめた(本人 10/28「設定の項目が長くなったので
//   カテゴリにまとめて」「シフトと言うメニューの名前はシフトポイントに」「過負荷のは高負荷メニューとして水温、高負荷のしたに」)。設定の段:
//   画面・シフトポイント・水温・過負荷・受信の状態・本体の状態・その他(左右で送り、長押しで中へ。受信の状態・本体の状態は今までどおり
//   長押しでその中へ)。カテゴリの中: 1 画面 1 項目(上の帯「‹ カテゴリ名」で戻る)。
//   過負荷(本人「過負荷は短期的な上昇によりクールダウンが必要になるという考え方と、それの累積によりメンテナンスの期間を推測する機能」
//   「過負荷に統一して今の過負荷計測を累積時間に」): 「高負荷時間」を「過負荷時間」に(サーキットの真ん中のタイトルも「過負荷」)。
//   「時間の記録」を「累積時間」に(▲ = 過負荷 回転数を超えていた時間の累計)。境目の回転数は設定の「過負荷 回転数」1 つにまとめ、
//   過負荷時間・累積時間・サーキットの「▼ 3000rpm」に使う(SET_LOADRPM_*。今までは LOAD_RPM・TIME_RPM・IDLE_RPM の 3000 固定)。
//   設定「メンテナンスまでの累積時間」(時間。0 = 切。初期値 5 時間): 累積時間がこれに達したらメンテナンスの時期。データ画面の下の行をメンテナンスまでの
//   残り(達したら赤の「メンテナンス」)にする(切のときは今までどおり ▼)。「累積時間 リセット」は 0:00:00 から 30 分ずつ値を入れてから
//   リセット(▲ をその値、▼ を 0。過負荷時間もその値以下にする。本人「累積時間が０なのに過負荷４９：３３と表示されています」)。
//   「デフォルトに戻す」で過負荷時間も 0 にする(本人「デモで過負荷時間が増えてしまうとそのあと消せません。デフォルト値に設定する場合には
//   クリアしてください」。累積時間と IMU の向きは残す)。
//   累積時間がメンテナンスの時間に達したら、サーキット・タコにも赤の「メンテナンス」(本人「メンテナンスの
//   表示は全ての画面で表示してください」)。
//   クールダウン(本人「タイトルは今何をしているのかを表示しているので、これをしろというタイトルはわかりにくく」「黄色以上の過負荷累積がある
//   場合…クールダウンという表示にリセット時間までのカウントダウンがはじまる」「回転数が落ちて１分以上過負荷にならなければ」「減らして
//   大丈夫です」): リセットのあとに一度でも黄になっていて、過負荷 回転数未満が 1 分続いたら、タイトルを「クールダウン」にして時間の所を
//   リセットまでの残り(水色)にする。設定の「クールダウン時間」はなくした。黄の初期値 15 → 10 分(本人「過負荷のしきい値は１０分程度」)。
//   境目は過負荷時間・リセット・累積時間・▼ のどれも「以上 = 過負荷、未満 = それ以外」にそろえた
// 2.12.1(2026-10-29): サーキットの真ん中の過負荷時間は、黄(黄が切なら赤)になってから 0 に戻るまで出す(黄になる前の白は出さない。
//   本人 10/29「過負荷回転数を超えたとき警告になっていないときに一瞬過負荷時間が表示されます」。過負荷 回転数を少し超えて下がると、
//   ピークの三角が消えてから過負荷時間が 1 秒を切るまでの間、白の「過負荷 0:01」が出ていた)。「黄になった」は電源を切ると忘れる。
//   サーキットの真ん中のピークの数字は、ピークを過ぎたら三角が消えるまで黄のまま(本人 10/29「ピークホールドの回転数が表示されたあとにも
//   一瞬白でその回転数が表示されます」。2.12.0 までは印が下がり始めると白になり、シフトアップのあと次のギアで前の最高の近くまで上がるまでと、
//   印が 3000 rpm を切って消えるまでの間、前の最高が白で出ていた)。白は今の回転数が数字の近くまで上がっている間(加速中)だけ
// 2.13.0(2026-10-29): GPS の測位が 10 回/秒で止まっていた(本人「GPSの更新が１０Hzのままです」)。M100(u-blox M10)は GPS+Galileo だと測位の上限が
//   既定で 10 回/秒(データシート 1.2 の表)。本人の決定: 衛星系は GPS+Galileo のまま、M10 の OTP に高性能設定を書いて上限を 20 回/秒にする
//   (「衛星系はGPS + Galileoで行きます　２０HzがでればOKです」「OTP入でお願いします」)。頼む回数は 20 回/秒(RC_GPS_RATE_HZ)。
//   起動時に版(MON-VER)と OTP の鍵(VALGET)を読み、未設定なら設定列 2 本を書いて M100 をリセットし、再起動後にもう一度読んで確かめる
//   (meter_display.ino の otpManage。RC_GPS_OTP_HIGH_PERF)。結果は 受信の状態 → GPS の 4 ページ目「OTP」とシリアル。永久の設定で元に戻せない
// 2.14.0(2026-10-30): 水温・燃料の警告を 2 段にした(本人「燃料の警告しきい値がちょっと高すぎます。まず、薄い黄色にしてから赤い警告にしたい」
//   「警告が目につきすぎて気になってしまうので、背景は黒のままにしてください」「水温についても同じように…しきい値−５度の時点で燃料と同じように
//   薄い黄色から警告表示に移行する」)。注意 = 暗い黄(点滅なし)、警告 = 赤(点滅)。どの画面でも背景は塗らない(サーキットの上下の赤い塗りはやめた)。
//   燃料の警告は設定「燃料の警告」(初期 20 %。注意は +10 % の 30 % 未満から)、水温の注意は 警告温度 − 5 ℃ から。設定のカテゴリ名は「警告・過負荷」
// 2.14.2(2026-10-30): 本人「IMU の値が RaceChrono で記録されていない」。表示器で切り分けられるように、受信の状態 → RaceChrono の「送った数」に
//   IMU の送信数/秒を足し、RaceChrono が IMU の PID(0618A0F1 加速度・0618A0F2 ヨーレート)を頼んでいなければ「IMU 未設定」(片方なら F1/F2未設定)と
//   出す(黄)。シリアルの 5 秒ごとの行にも同じ値。送る中身・ID は変えていない
// 2.14.3(2026-10-30): M100 への送信を仕様どおりの普通の UART にした(本人「仕様書どおりに設計してください。余計なコードは抜いてください」)。
//   2.14.2 までは、逆配線でも壊れないようにと送信をオープンドレイン + 内蔵の弱いプルアップで駆動し、受信ピンを起動時に自動判定していたが、
//   弱いプルアップでは M100 に設定が届かず(ACK/NAK が一度も返らない)、OTP の確認(MON-VER・VALGET)も「不明」のままだった。
//   オープンドレイン・受信ピンの自動判定・その試験の細工はすべて削除。配線は写真で確認済み(下の PIN_GPS_*)
// 2.14.4(2026-10-31): GPS の受信ピンと送信ピンを入れ替えた(受信 =「IO17」← M100 の送信、送信 =「IO18」→ M100 の受信。本人「本体に修正をいれ」)。
//   10/31 の試験(UART だけのスケッチ)で確かめた事実: M100 のデータ(115200 bps の UBX・NMEA)は「IO17」に来て、「IO18」には一度も来ない
//   (表示器のプルダウンでも H = M100 の受信の振る舞い)。受信「IO17」・送信「IO18」の普通の UART にすると、M100 は MON-VER と VALGET に毎回 1 回目で答える。
//   2.14.3 の説明(弱いプルアップでは届かない)は誤り: 2.13.0〜2.14.2 は受信ピンの自動判定の途中(受信を「IO17」に切り替えた所)で位置が届くと
//   判定がそこで止まり、受信も送信も「IO17」のまま問い合わせを M100 の送信の線に出していた。2.14.3 は受信が「IO18」(データの来ない線)だった。
//   OTP: この M100(ROM SPG 5.10)は OTP を確かめる VALGET(層 4)に NAK を返すので、otpManage は「異常」にして書かない
//   (RAM 層のクロックは 128 MHz × 3・64 MHz = 高性能設定は入っていない。10/31 の試験)
// 2.14.5(2026-10-31): OTP の高性能化を実行する(本人「高性能化を実行してください」)。2.13.0〜2.14.4 は確かめる問い合わせ(VALGET 層 4)の NAK を
//   「この版では読めない」とみなして書かなかったが、u-blox の手順(SAM-M10Q 統合マニュアル 2.1.5)ではこの問い合わせは書いたあとの確認(手順 5)で、
//   書く前は NAK になる(10/31 の試験: 層 4 は NAK、RAM 層のクロックは 128 MHz × 3・64 MHz = 未設定)。NAK のときは版を確かめて手順 3 の設定列 2 本を書き、
//   手順 4 のリセットのあと、手順 5 の問い合わせが高性能の値(192 MHz × 3・96 MHz)を返せば「済み」。別の値で返ったときは書かない。
//   OTP は書くたびに減るので、書くのはこの表示器で一度だけ(書く前に NVS の "otpw" を 1 にする。確かめられなくても自動では二度と書かない)
// 2.15.0(2026-11-08): 走行記録(仕様書 odo_log_spec.md 第 3 版)。B-CAN 0C014003 の ODO(km)と、その日の過走行時間(▲ と同じ数え方)を、
//   停車・低速(10 km/h 以下)・リバースのときに 60 秒以上あけて、パーティション spiffs(今まで使っていなかった 896 KiB)に 32 バイトずつ追記する
//   (本人 11/2「停止時（または低速走行時、リバース時）に書き換えたい」)。日付は GPS の時刻(日本時間)。設定に「走行記録」(本体の状態の前。
//   本人 11/8「設定に入れてください」): 3 ヶ月 → 1 ヶ月 → 1 週(日曜始まり)→ 1 日と、集計した ODO から長押しで細かい期間へ(2.15.2 で一番上に 1 年。本人 11/8「集計して出して、
//   選択して細かいデータにアクセスするように」)。1 画面 1 期間: 終わりの ODO・始まり〜終わりの ODO・距離・▲ 過走行時間。
//   本体の状態に「走行記録」(件数・今日の距離・ODO の受信)
// 2.15.1(2026-11-09): 2.15.0 はビルドできなかった(走行記録のシリアル出力の文字列 3 か所に改行が入っていた)。その文字列を直しただけ
// 2.15.2(2026-11-09): 走行記録の一番上に「1 年」(本人 11/9「入れてください」。年をまたいでも古い日へ早く行けるように)。
//   設定の「走行記録」の長押しで今年の画面、長押しで 3 ヶ月 → 1 ヶ月 → 1 週 → 1 日
// 2.15.3(2026-11-09): 設定のカテゴリの並びで「走行記録」を一番最初に(本人 11/9「設定のメニューで、この走行記録を一番最初にしてください」)。
//   設定に入ったとき最初に出る(電源を入れてから最初に設定に入ったとき。そのあとは前に見ていたカテゴリ)
// 2.16.0(2026-11-12): CAN確認の「前後で比べる」を作り直した(本人 11/12「燃料のCANIDを捕捉するエンジンを切っても保存するものがありますが、
//   それはもう使っていません。これを汎用的に作り直してESCのCANIDを捕捉するものを作成できますか？」。制御 OFF(スティーレが CAN のエラーを
//   起こして ESC を切る)の ID を探す。変化を記録では 13 件から先を絞れなかった)。「前を記録」「後を記録」を交互に何回でも押し、押してから
//   CAN_PP_WIN_MS 受けたものを 1 回の記録にする。候補はビット単位(毎回の記録の間ずっと変わらず、前ではいつも同じ値・後ではいつもその逆)と、
//   後は受信なし・前は受信なしの ID。全部の記録を NVS に書く(エンジンをかけ直さないと戻らない切り替えでも続けられる)。下の CAN_PP_*
//   サーキット画面の時計の時針・分針を、枠だけから塗りつぶしにして色で見分ける(本人 11/12「時計の短針と長針の枠のみから塗りつぶし＋色分け」
//   「青はちょっと醜いですね。黄色で行きます」。時針 = 白、分針 = 黄。細い黒の縁つき。背景が黄のときの分針は紺。下の HAND_*)。
//   時計の目盛を太くした(本人 11/12「メモリが見えないので少し太くしてください」。毎時 3 → 4.5、1 分ごと 1.5 → 2.5。下の CLK_TICK_*)
#define METER_FW_VERSION "2.16.0"

// ---------------------------------------------------------------- 回転数の輪(仕様書 3 章)
// シフト点(設定画面で変える値)を基準に、ほかの回転数はここからの差で決める。
// 【未定→仮】シフト点を変えると、点き始め・色の切り替わり・点滅の始まりが同じ幅だけ動く。
#define RING_STEP_RPM 400           // 1 マスぶんの回転数
#define RING_R_IN 176.0f            // 輪の内側の半径(10/20: 200 → 184、10/21: → 176。輪を太くする)
#define RING_R_OUT 228.0f           // 輪の外側の半径
// 10/21: 真上と真下の切れ目にも 1 マスずつ置いて全周 26 マスにした(シフト点で全周が点く。真下は 1 マス目と、真上は 12 マス目と
// 一緒に点く)。26 マスを等間隔(360/26 = 13.85°)に並べ、マスの間のすき間はこの角度
#define RING_GAP_DEG 2.0f
// 2.12.0: 片側の輪(設定「回転数の輪」= 片側)。4 時の位置から右回り(時計回り)に真上まで RING_ONE_SEGS マス: 1 マス目(点き始め)の
// 外の端が RING_ONE_START_DEG(3 時が 0°、時計回り。4 時 = 30°)、最後のマス(シフト点)の真ん中が真上。マスの間隔はこの間に全部が入る幅(約 10.7°)、
// すき間は RING_GAP_DEG。1 マス = RING_ONE_STEP_RPM(両側の半分。270° を使うので細かくした)。点き始めは両側と同じ
// シフト点 − 11 × RING_STEP_RPM(5800 なら 1400)。真上から 4 時まで(右上〜右)には何も出さない(消えているマスは両側と同じく背景のまま)。
// 色・点滅は両側と同じ
#define RING_ONE_START_DEG 30.0f     // 4 時(本人 10/28「回転数の始まりは４時の位置から」。その前は 3 時)
#define RING_ONE_STEP_RPM 200
#define RING_ONE_SEGS (11 * RING_STEP_RPM / RING_ONE_STEP_RPM + 1)  // 23
// 2.10.0: サーキットの真ん中のギアはやめた(ギアはタコの画面へ。下の TACH_GEAR_*)
#define RING_IDLE_MARK 0           // 1 = 点き始めより下の回転数で一番下のマスを橙に点ける(仕様書 3.2。LED バーで両端を確かめるためのもの)。
                                    // 0 = 点けない(2026-10-18 の決定。10/18 に渡した版は Mac に入っていなかったので 10/20 に入れた)
#define RING_BLEND_RPM 400          // 色の切り替わりの手前、この幅で色を混ぜる
#define RING_BLUE_OFFSET (-2800)    // 青になる回転数 = シフト点 + この値(5800 なら 3000)
#define RING_GREEN_OFFSET (-1800)   // 緑(5800 なら 4000)
#define RING_YELLOW_OFFSET (-400)   // 黄(5800 なら 5400)
#define RING_RED_OFFSET 400         // 赤(5800 なら 6200)
// 点滅の始まり = シフト点 + この値(10/21: 輪が黄になる所と同じ RING_YELLOW_OFFSET。5800 なら 5400。10/20 の 1000 rpm 手前(4800)は
// 最初の点滅が遅すぎた)。点滅はシフト点に近づくほど速くなる。消灯の時間は速さによらず一定(BLINK_OFF_MS)で、点灯の時間だけを
// BLINK_ON_SLOW_MS から BLINK_ON_FAST_MS まで回転数に比例して縮める(2026-10-20: 遅い点滅で画面が一瞬消えて見えなくなる
// のを避けるため、消灯を長くしない)。周期は始まりで 230 ms(1 秒に 4.3 回)、シフト点以上で 130 ms(1 秒に 7.7 回)。
// 切り替えの時刻は前の切り替えから数えるので、速さが変わっても位相は飛ばない。
// 0 以上(シフト点から点滅)にすると、点灯の時間は BLINK_ON_FAST_MS だけになる。
// 10/13〜10/19 の動き(シフト点から 100 ms 点灯 / 100 ms 消灯)に戻すなら 0、100、100、100。10/20 の動きは −1000、50、250、50。
#define RING_BLINK_OFFSET RING_YELLOW_OFFSET
#define BLINK_OFF_MS 80             // 消灯の時間(一定。10/21: 50 → 80、短すぎた)。パネルの描き替えは 60 Hz(1 コマ 16.7 ms。CO5300
                                    //   データシート)なので、50 より大きく縮めると消灯が出ないことがある
#define BLINK_ON_SLOW_MS 150        // 点滅の始まりでの点灯の時間(10/21: 250 → 150。始まりから、ある程度の速さにする)
#define BLINK_ON_FAST_MS 50         // シフト点以上での点灯の時間
// 点滅の終わり = シフト点 + この値(2026-10-20: 5800 なら 6000)。これ以上では点滅せず、輪は全部点いたまま、画面の明るさを
// 設定の値ではなく最大(100 %)にする。下回ると点滅に戻り、走行画面・ブースト計以外の画面では設定の明るさに戻る
#define RING_SOLID_OFFSET 200
// 点滅のしかた(走行画面)。1 = 画面全体: 消灯の間は画面全体を消す(輪は点いたまま)。
//                         0 = 輪だけ消す(仕様書 3.4、10/8 時点)。
#define BLINK_WHOLE_SCREEN 1
// 画面全体の消し方。1 = パネルの明るさを 0 にする(画面に送らないので、境目が出ない。消灯は黒だけ)。
//                   0 = BLINK_OFF_RGB の一色を画面に送る(色を選べるが、送っている途中の境目が見えることがある)。
#define BLINK_BY_BRIGHTNESS 1
#define BLINK_OFF_RGB 0x000000      // BLINK_BY_BRIGHTNESS 0 のときの消灯の色(0xRRGGBB)。例: 赤なら 0xE3241B
#define BG_MIN_INTERVAL_MS 80       // 背景の色を塗り直す最短の間隔(点滅の間隔を守るため)

// ---------------------------------------------------------------- オープニング画面(2026-10-21。仕様書に無い)
// 電源を入れると、覚えた画面(サーキット・タコ・データ)の前に見せる。タップ・スワイプで飛ばせる。
// 2.5.0(本人の指示 10/24「もう少し長く印象的に」「アニメーションはサーキット、タコ、データの 3 つ」「データ画面のアニメーションは
// GPS などの状態を出す。それ以外は状態の画面は出さなくていい」): 覚えた画面ごとに 3 種類にした(2.4.x までは 1 種類 2 秒で、
// 最後に自己診断を出していた)。どれも時刻だけで進む。
//   サーキット(合計 OPC_TOTAL_MS): 1. 輪を下から上へ、左右 2 つの白い光が走る(通ったマスは、消えているマスとして暗い灰で見せる)。
//     2. 真上で光が止まり、水温と燃料の弧の地とアイコンが出る。3. 回転数を上げるように輪が点いていく(はじめはゆっくり。色・点滅・
//     最大輝度は本物と同じ決まりで、仮の回転数から決める)。弧も一杯まで伸びる。4. 全部点いたら背景も赤にして最大輝度(リミッター)。
//     5. 背景が黒に戻り、回転数を下げるように消えていく(はじめは速く。今の回転数まで)。弧は今の値まで縮む。6. 時計(目盛と針)と
//     真ん中が浮かび(2.10.0。2.9.0 まではギア)、サーキットの画面になる
//   タコ(合計 OPT_TOTAL_MS): 1. 針が 0 から振り切り(TACH_MAX_RPM)まで上がり、針が通った所から目盛と数字が出る。ブーストの輪と
//     数字も一緒に上がる。シフト点を超えると目盛と針が赤、点滅・最大輝度も本物と同じ。2. 振り切りで止まる。3. 0 まで戻る。
//     4. 今の値に落ち着き、描き直さずにそのままタコの画面になる
//   データ(合計 OPD_TOTAL_MS): 1. 外周に輪の地を真上から左右へ描く(データ画面の回転数の輪と同じ所・同じ太さ。DATA_RING_R_*)。
//     2. 自己診断(CAN・GPS・IMU・タッチ)を 1 行ずつ出す。行を出してから OPD_CHECK_MS は確かめている間(点が点滅し、外周の輪が
//     1/4 埋まる)、そのあと結果(緑 = OK、灰 = 待ち・切、赤 = NG)。値はデータの画面に移るまで更新し続ける(受信が始まれば「待ち」が
//     OK に変わる)。3. 全部出たら外周の輪を結果の色(NG が無ければ緑、あれば赤)にし、版を出す。NG があれば OPENING_NG_EXTRA_MS 長く見せる
#define OPENING_ON 1                // 0 にするとオープニングなし(覚えた画面から始める)
#define OPC_SCAN_MS 420             // サーキット 1: 光が下から上へ走る
#define OPC_FLASH_MS 160            //            2: 真上で止まる
#define OPC_RISE_MS 1000            //            3: 点いていく
#define OPC_LIMIT_MS 600            //            4: 全部点いて背景も赤
#define OPC_FALL_MS 800             //            5: 消えていく
#define OPC_CLOCK_MS 400            //            6: 時計と真ん中が浮かぶ(2.10.0。2.9.0 まではギア)
#define OPC_TOTAL_MS (OPC_SCAN_MS + OPC_FLASH_MS + OPC_RISE_MS + OPC_LIMIT_MS + OPC_FALL_MS + OPC_CLOCK_MS)  // 3.38 秒
#define OPT_UP_MS 1300              // タコ 1: 0 から振り切りまで
#define OPT_TOP_MS 400              //      2: 振り切りで止まる
#define OPT_DOWN_MS 1100            //      3: 0 まで戻る
#define OPT_SETTLE_MS 500           //      4: 今の値に落ち着く
#define OPT_TOTAL_MS (OPT_UP_MS + OPT_TOP_MS + OPT_DOWN_MS + OPT_SETTLE_MS)  // 3.3 秒
#define OPD_RING_MS 400             // データ 1: 外周の輪の地
#define OPD_ROW_MS 400              //        2: 行を出す間隔
#define OPD_CHECK_MS 260            //           1 行を確かめている間
#define OPD_PULSE_MS 90             //           確かめている間の点の点滅(明・暗それぞれの時間)
#define OPD_HOLD_MS 1140            //        3: 全部出てから(版を出して見せる時間)
#define OPD_TOTAL_MS (OPD_RING_MS + 3 * OPD_ROW_MS + OPD_CHECK_MS + OPD_HOLD_MS)  // 3.0 秒
#define OPENING_NG_EXTRA_MS 2000    // データ: NG があるときに延ばす時間

// ---------------------------------------------------------------- 水温と燃料(仕様書 5 章)
// 走行画面では、回転数の輪の内側の円弧で出す(仕様書 5.4・5.5 の横バーから変えた。2026-10-14)。
// 水温は上の弧(左端から時計回りに伸びる)、燃料は下の弧(左端から反時計回りに伸びる)。
// 2026-10-22: 実走行で「細くて見えない」ので太さ 18 → 40 にした(遠目の案 A)。長さは 140° → 100°(太くしたぶん、端がギアに近づかないように)
// 2.10.0: 時計を外側にしたので、弧は時計の内側へ(126〜166 → 98〜134、太さ 36)。角度・色の決まりは同じ
#define ARC_R_IN 98.0f              // 弧の内側の半径
#define ARC_R_OUT 134.0f
#define ARC_SWEEP_DEG 100.0f        // 弧の長さ [度]
#define WATER_ARC_START_DEG 220.0f  // 水温の弧の左端(3 時が 0°、時計回り)。ここから 320° まで
#define FUEL_ARC_START_DEG 140.0f   // 燃料の弧の左端。ここから 40° まで(角度が減る向き)
// 弧のある側(水温は上、燃料は下)を、輪の内側の円の中で横一直線に切った形で区切る範囲(10/22)。2.13.0 までは警告の点滅の点灯側にここを
// 赤く塗っていたが、2.14.0 でやめた(本人 10/30「背景は黒のままにしてください」)。今はオープニングで弧とアイコンを消すのに使うだけ
#define ALARM_FILL_R 172.0f         // 区切る円の半径(輪の内側 RING_R_IN より内)
#define ALARM_WATER_Y1 170          // 水温: この y より上
#define ALARM_FUEL_Y0 296           // 燃料: この y から下
#define WATER_BAR_MIN_C 40.0f       // 弧の始まり【仮】
#define WATER_BAR_MAX_C 120.0f      // 弧の終わり【仮】
#define WATER_BLUE_END_C 70.0f      // ここまで青【仮】
// 2.14.0: 水温・燃料は 注意 → 警告 の 2 段(本人 10/30「まず、薄い黄色にしてから赤い警告にしたい」)。
//   注意 = 弧の伸びた所・アイコン・数字・札が暗い黄(点滅なし): 水温は 警告温度 − WATER_CAUTION_BELOW_C 以上(本人「しきい値−５度の時点で」)、
//          燃料は 燃料の警告 + FUEL_CAUTION_ABOVE_PCT 未満
//   警告 = 赤で点滅(消灯側は暗い赤): 水温は 警告温度(設定)以上、燃料は 燃料の警告(設定 SET_FUELWARN_*)未満。2.13.0 までは 30 % 固定(FUEL_ALARM_PCT)
//   背景はどの画面でも塗らない(本人「警告が目につきすぎて気になってしまうので、背景は黒のままにしてください」)。弧の地は正常と同じ
#define WATER_CAUTION_BELOW_C 5     // 注意になる水温 = 警告温度 − これ [℃]
#define FUEL_CAUTION_ABOVE_PCT 10   // 注意になる残量 = 燃料の警告 + これ [%](未満)
#define WATER_ALARM_HYST_C 1.0f     // 【未定→仮】境目を下回ってから、この温度ぶん下がるまで上の段のまま(ちらつき防止。注意・警告どちらの境目も)
#define FUEL_ALARM_HYST_PCT 1.0f    // 【未定→仮】上と同じ目的(境目以上に戻ってから、これだけ増えるまで上の段のまま)
// 警告の表示(水温が警告温度以上、燃料が 燃料の警告 未満)は赤で点滅する(2026-10-14)。
// データ画面: 点灯はアイコン・数字・単位が赤、消灯は暗い赤。走行画面は弧の伸びた所とアイコン、アナログ計は AN_BADGE_* の札
#define ALARM_BLINK_HALF_MS 250     // 250 ms 点灯、250 ms 消灯

// ---------------------------------------------------------------- ブースト計のページ(仕様書に無い。2026-10-14 に追加)
// 目盛の範囲は【未確認】: 取扱説明書(2016 年)は「車種により 2.0 bar まで」。写真では 0.5 刻みで 2 までの個体と、
// 0.4 刻みで 1.6 までの個体がある。実車の目盛に合わせてここを変える。
#define BOOST_SCALE_MIN_BAR 0.0f    // 帯の始まり(帯はこれより下に行かない。数字は負の値も出す)
#define BOOST_SCALE_MAX_BAR 2.0f    // 帯の終わり(端。角度は BOOST_END_DEG)。これより上は帯が端で止まる(数字は今の値のまま)
#define BOOST_TOP_BAR 1.4f          // 真上(0 時、BOOST_TOP_DEG)に来る値。2.8.0: 本人「グラフが０時になったときに１．４としてください」(2.7.0 は真上が 1.5)
#define BOOST_RED_FROM_BAR 1.4f     // ここから帯を赤にする(真上から端まで)。2.8.0: 真上と同じにした(2.7.0 は 1.6)
// 2026-10-21: このページは「アナログ計」になった。回転計が主役。10/22: ブーストは外周の右下の帯、水温・燃料は異常のときだけ。
// 角度は 3 時が 0°、時計回り。回転計は 0 rpm を TACH_START_DEG に置き、1000 rpm ごとに TACH_DEG_PER_1000 進める
// (120° + 25° × 6 = 270° → 6000 rpm が真上に来る)。
#define TACH_MAX_RPM 8000           // 目盛の終わり【仮】(595 の赤線は未確認)
#define TACH_START_DEG 120.0f       // 0 rpm の角度(左下)
#define TACH_DEG_PER_1000 25.0f     // 1000 rpm あたりの角度(6000 で 270° = 真上)
#define TACH_LABEL_STEP_RPM 1000    // 数字の間隔(×1000 で 0〜8)
// 2026-10-22(遠目の案): 実走行で「目盛の主張が強く針が見えにくい」ので、目盛線は灰色に落として 1000 と 500 だけにした。
// 数字は大きく(42 → 60 px)。赤の範囲は目盛の外側の細い帯
// 10/22 夜(決定): 10/21 の配置(白い目盛線 1000・500・250)のまま、目盛線の色を抑えた灰色にした(赤の範囲は暗い赤)。
// 数字は 60 px・太さ 600(白、赤の範囲は赤)
#define TACH_TICK_STEP_RPM 250      // 目盛線の間隔(1000 の倍数は長い、500 の倍数は中くらい)
#define TACH_RED_OFFSET 0           // 赤の始まり = シフト点 + この値【仮】(5800 から赤)
// 2.4.0(本人の指示 10/24): 回転数がシフト点以上の間は、回転計の目盛線・数字・針を全部赤にする。シフト点からこの値だけ下がったら戻す
// (境目で何度も描き直さないため。赤にする・戻すときは文字盤を全部描き直す)
#define TACH_ALL_RED_HYST_RPM 100
#define TACH_TICK_R_IN 198.0f       // 1000 ごとの目盛線の内側の半径
#define TACH_TICK_R_IN_M 208.0f     // 500 ごと
#define TACH_TICK_R_IN_S 216.0f     // 250 ごと
#define TACH_TICK_R_OUT 228.0f
#define TACH_TICK_HALF_DEG 1.1f     // 1000 ごとの目盛線の太さ(片側の角度。両側で約 8 px)
#define TACH_TICK_HALF_DEG_M 0.75f  // 500 ごと(両側で約 5.6 px)
#define TACH_TICK_HALF_DEG_S 0.5f   // 250 ごと(両側で約 3.9 px)
#define TACH_LABEL_R 166.0f         // 数字の中心の半径(書体は FONT_DIAL600_60)
// 針(10/22 夜): 白、根元から先まで同じ太さ、黒い縁と影つき。中央のブーストの輪(半径 124 まで)の外から伸ばす
#define TACH_NEEDLE_R_IN 126.0f     // 針の根元と先の半径、太さ(根元は中央のブーストの輪と目盛線の外)
#define TACH_NEEDLE_R_OUT 230.0f
#define TACH_NEEDLE_W_IN 14.0f
#define TACH_NEEDLE_W_OUT 14.0f
#define TACH_NEEDLE_EDGE 3.0f       // 針のまわりの黒い縁の幅 [px](目盛線や数字の上でも針が見えるように)
#define TACH_SHADOW_DX 5.0f         // 影: 針から右下へずらす量 [px]
#define TACH_SHADOW_DY 6.0f
#define TACH_SHADOW_GROW 4.0f       // 影の濃い所: 針より太くする量 [px]
#define TACH_SHADOW_SOFT 6.0f       // 影のぼけた所: さらに太くする量 [px](薄く重ねて、ぼかしの代わりにする)
#define TACH_SHADOW_ALPHA 215       // 影の濃さ(0〜255。黒をこの濃さで重ねる)。ぼけた所はこの半分
// 回転計のピークホールド(10/21): 最高の回転数の所に黄色の印(半径 TACH_PEAK_R_IN〜TACH_TICK_R_OUT、片側 TACH_PEAK_HALF_DEG)を
// 残す。TACH_PEAK_HOLD_MS 止まったあと、TACH_PEAK_FALL_RPM_PER_S の速さで今の回転数まで下がる(下がり切ったら消える)。
// 回転数の信号が無いときは消える。回転数の記録はどの画面でも続けている(アナログ計に切り替えたとき、直前の最高が見える)
// 2.2.0(本人 10/23「回転数が下がっているときに表示、ピークを超えたら消す」「時間が経ったら下がるは残す」): 印は回転数がピークより
// 下がっている間だけ出し、回転数がピークを超えたら消す(そこからまた最高を取り直す)。時間で下がるのは前のまま
// 2.4.0(本人 10/24「回転が下がっても 5 秒程度は残し、回転数が高い状態では上がっても下がっても表示し続けて」): ピークが PEAK_MIN_RPM
// 以上なら、回転数が上がっている間も出す(回転計の印は針の下、サーキットの三角形は点いたマスの上)。
// 2.4.4(本人 10/24「その仕様で大丈夫です」): 2.4.0 で止まる時間を 1.5 → 5 秒にしたのは取り違え(「回転が下がっても 5 秒ほど印を残す」の
// 意味だった)。止まる時間は 1.5 秒に戻し、そのあと TACH_PEAK_FALL_RPM_PER_S で今の回転数まで下がる。印は、最後にピークを付けてから
// (回転が落ち始めてから)TACH_PEAK_SHOW_MS で消す。2.4.5: 下がっている途中で PEAK_MIN_RPM を切ったら、その時に消す
// (本人「3000 以下に下がった場合は消してしまっていいです」。2.4.4 は TACH_PEAK_SHOW_MS までは出していた)
#define TACH_PEAK_HOLD_MS 1500
#define TACH_PEAK_FALL_RPM_PER_S 2000
#define TACH_PEAK_SHOW_MS 5000
// 2.4.5: 印を出す時間を数え直すのは、回転数がはっきり上がったとき: PEAK_MIN_RPM 以上で、前に数え直してからの最低の回転数より
// この値以上高い(回転数が一定のときのゆらぎでは数え直さない。2.4.4 は少しでも上がるたびに数え直していて、走っている間は消えなかった)
#define PEAK_RISE_RPM 200
// ピークホールドの印を出す条件(回転計の印とサーキットの三角形の両方): 回転数が PEAK_MIN_RPM 以上ではっきり上がってから(低い回転数では
// 出さない。本人 10/23)TACH_PEAK_SHOW_MS の間(2.4.4。2.4.5: はっきり = PEAK_RISE_RPM)。上がっている間は数え直し続けるので出ている。
// 回転計の印は針の下に描く
#define PEAK_MIN_RPM 3000
#define TACH_PEAK_R_IN 186.0f       // 10/22 夜: 見にくいので長く(210 → 186)、太く(1.6 → 2.0)
#define TACH_PEAK_HALF_DEG 2.0f
// 10/23: 針とブースト以外を少しだけ暗くした(数字 × 0.82、目盛線 × 0.93、ピークの印 × 0.88)。水温・燃料の札は暗くしない。色は ui.cpp の C_TICK など
// ブースト(10/22 夜・決定、10/23 に太く): 中央の輪。回転計と同じ向き(0 bar が TACH_START_DEG = 左下、時計回り)。
// 2.8.0: 0 bar = TACH_START_DEG(左下)、BOOST_TOP_BAR = BOOST_TOP_DEG(真上)、BOOST_SCALE_MAX_BAR = BOOST_END_DEG(端)で、その間はそれぞれ比例
// (0〜1.4 bar は 1 bar あたり 107°、1.4〜2.0 bar は 83°)。2.7.0 は 1 bar あたり 100° の比例で、真上が 1.5 bar。
// 10/23: 内側へ太くした(84〜108 → 62〜108)。伸びた所はトーンを落とした白(#A9AFBA)、BOOST_RED_FROM_BAR から上は
// 暗めの赤。地は暗い紺(赤の範囲は暗い赤)。目盛線(BOOST_TICK_BARS)は輪の外、数字(1 bar ごと)は輪の内側。今の値は輪の右に大きい数字(太さ 500、白)
#define BOOST_RING_R_IN 62.0f
#define BOOST_RING_R_OUT 108.0f
#define BOOST_TOP_DEG 270.0f        // 真上(回転計の 6000 rpm と同じ角度)
#define BOOST_END_DEG 320.0f        // 端(回転計の 8000 rpm と同じ角度。2.7.0 の 2.0 bar と同じ所)
#define BOOST_TICK_BARS { 0.0f, 0.5f, 1.0f, 1.4f, 2.0f }  // 目盛線を引く値(2.8.0: 真上の 1.4 と端の 2.0。2.7.0 は 0.5 ごと)
#define BOOST_TICK_R_IN 111.0f      // 目盛線
#define BOOST_TICK_R_OUT 120.0f
#define BOOST_TICK_HALF_DEG 1.3f
#define BOOST_MARK_R_IN 58.0f       // 先端の白い目印の半径と片側の角度
#define BOOST_MARK_R_OUT 112.0f
#define BOOST_MARK_HALF_DEG 1.3f
#define BOOST_LABEL_R 44.0f         // 数字 0・1・2 の中心の半径(書体は FONT_DIAL500_28)。10/23: 輪を内側へ太くしたので 64 → 44
// 2.10.0: ブースト圧の数字を上に移して小さく(76 → 56 px)、その下にギア(本人「ブースト　とギヤは上下逆にしてください」)
#define BOOST_NUM_FONT FONT_DIAL500_56  // 今の値の数字の書体(太さ 500、白。10/23: 水色 → 白)
#define BOOST_NUM_X 430             // 今の値の数字の右端とベースライン(2.10.0: 278 → 205。右端はキャンバス T1 の 426 から 4 px 右へ:
#define BOOST_NUM_BASE 205          //   負圧の「−」が輪の終わり(2 bar の所)に触れないように)
#define TACH_GEAR_FONT FONT_GEAR_100   // ギア(2.10.0。サーキットの真ん中から移した)。文字の中心の x とベースライン
#define TACH_GEAR_CX 372
#define TACH_GEAR_BASE 294
// 水温・燃料(10/22): 純正のメーターにあるので、ここには異常のときだけ赤い札を出す(ギアの下、右下の空き。両方なら 2 段、
// 1 つなら上の段)。札 = アイコン(40 px)+ 数字(FONT_DIAL500_40)。点滅の消灯側は暗い赤の札
// スポーツモードの「SPORT」(2.11.0。タコの下の真ん中。目盛・輪・札の無い所)。文字の中心の x とベースライン、色
#define TACH_SPORT_FONT FONT_NUM600_34
#define TACH_SPORT_CX 233
#define TACH_SPORT_BASE 446
#define TACH_SPORT_RGB 0xE3241B
#define AN_BADGE_X 234
#define AN_BADGE_W 140
#define AN_BADGE_H 46
#define AN_BADGE_Y 318              // 上の段の上端(2.10.0: ギアの入る所を空けるため 304 → 318。本人「水温、燃料は少し端に移動して」)
#define AN_BADGE_PITCH 52           // 段の間隔

// ---------------------------------------------------------------- サーキット画面(走行画面)の追加(10/23)
// 回転数のピークホールド: 輪の両側、画面の端に付く黄色の三角形(内向き)。位置は輪のマスと同じ並び(ピークの回転数のマスの位置)。
// 三角形は外周の所で幅 32 px・高さ 28 px(正三角形に近い)。底辺は画面の外(半径 PEAK_TRI_R_BASE)に置き、画面の円で切れて端に付く
#define PEAK_TRI_R_TIP 205.0f       // 先の半径
#define PEAK_TRI_R_BASE 250.0f      // 底辺の半径(画面の外)
#define PEAK_TRI_HALF_W 26.0f       // 底辺の半幅(半径 233 の所で 16 px になる)
// 3000rpm 以下の経過時間: 回転数が IDLE_RPM 以下になってからの時間を数える(停止・走行に関係なく。IDLE_RPM を超えたら 0 に戻る)。
// ギアが N のまま IDLE_SHOW_AFTER_N_MS 続いたら「▼ 3000rpm」と経過時間(分:秒)を出す(2.10.0: 高負荷時間の下。高負荷時間が 0 になったら消す)
#define IDLE_RPM 3000                // 2.12.0: 設定の「過負荷 回転数」の初期値と同じ(表示器は設定の値を使う)
#define IDLE_SHOW_AFTER_N_MS 60000

// ---------------------------------------------------------------- サーキット画面の時計と真ん中(2.10.0。仕様書 circuit_screen_spec.md 第 3 版 4 章)
// 時計: 輪の内側に目盛と、時針・分針・秒針(2.11.0: 目盛 60 本、時針・分針は四角の枠、秒針は赤の三角。下の 2.11.0 の説明)。時刻は GPS の時刻(UTC)+ CLOCK_TZ_SEC。GPS の時刻が分かるまで針は出さない
// (2.11.0: デモ表示の間は、ビルドした時刻から進めた時刻で出す)。
// 針は水温・燃料の弧の太さの半分(HAND_R_IN)から出して、弧とアイコンの上に重ねる(本人「針はH3のデザインでいきます」)。
// 針を除いた絵を別の画面メモリーに取っておき、針が動いたら前の所をそこから写して消す(輪のマスには掛からないよう、半径 CLK_CLIP_R の中だけ)
#define CLOCK_TZ_SEC (9 * 3600)     // 日本時間
// 2.11.0: 針と目盛は Apple Watch 風(本人 10/28「applewatchの針の配色を採用」「枠白中黒　背景が明るい場合は逆」「メモリは細くていいので
// applewatchのメモリの配置関係に」。キャンバス W1〜W6)。目盛は 1 分ごとに 60 本(毎時の 12 本は長く太い)。暗い背景では毎時が白、ほかは白の
// 半分の濃さ。明るい背景(黄)では黒と、黒の半分弱の濃さ。
// 2.11.0〜2.15.x の時針・分針は、四角の枠と中の 2 色(暗い背景は枠が白・中が黒、明るい背景は逆。枠の太さ 3.5、枠の外側の太さ 15.5)。
// 秒針は赤の正三角形(軸なし。外向き)に縁(暗い背景は白、明るい背景は黒。本人「三角形は正三角形」「フチありで」)。
// 背景が赤でも赤のまま(本人「背景が赤でも赤でいいです」)
// 2.16.0: 時針・分針を塗りつぶしにして、色で見分ける(本人 11/12「時計の短針と長針の枠のみから塗りつぶし＋色分け」)。2.15.x までの枠の外側と
// 同じ大きさの四角(太さ HAND_W、角の丸み HAND_CORNER)を、時針は HAND_H_RGB、分針は HAND_M_RGB で塗る。色は 時針(短針)= 白、分針(長針)= 黄
// (本人 11/12「青はちょっと醜いですね。黄色で行きます」。はじめに出した水色 0x5FD0FF をやめた。黄は回転数の輪の黄と同じ色)。
// 背景が明るい(黄)ときは、黄の分針が見えないので紺にする(ピークの回転数と同じ決まり。ui.cpp の handColOn。これは Claude の仮の判断)。
// 塗りのまわりに細い黒の縁(HAND_EDGE。黒の背景では見えない。水温・燃料の弧、目盛、アイコンの上と、黄・赤の背景で針の形を分ける)。
// 秒針は 2.11.0 のまま
#define CLK_TICK_R_OUT 174.0f       // 目盛の外の半径(輪の内側 RING_R_IN の 2 px 内)
#define CLK_TICK_H_R_IN 156.0f      // 毎時の目盛の内の半径と太さ
#define CLK_TICK_H_W 4.5f           // 2.16.0: 3.0 → 4.5(本人 11/12「メモリが見えないので少し太くしてください」)
#define CLK_TICK_M_R_IN 167.0f      // 1 分ごとの目盛
#define CLK_TICK_M_W 2.5f           // 2.16.0: 1.5 → 2.5(同じ)
#define HAND_R_IN 115.0f            // 時針・分針の縁の外側の根元の半径(塗りは 116.5 から。真ん中の文字の四角(半径 114 以内)に掛からない所)
#define HAND_H_R_OUT 163.0f         // 時針の縁の外側の先の半径(塗りの先は 161.5。2.15.x までの枠の外側と同じ)
#define HAND_M_R_OUT 174.0f         // 分針の縁の外側の先の半径(塗りの先は 172.5。縁の画素が、消すときに写す円(半径 CLK_CLIP_R)から出ないよう 174)
#define HAND_W 15.5f                // 時針・分針の塗りの太さ(2.15.x までの枠の外側と同じ)
#define HAND_EDGE 1.5f              // 塗りのまわりの縁の太さ
#define HAND_CORNER 3.75f           // 塗りの角の丸み(2.15.x までの枠の外側と同じ。本人「丸い形状の針が全体のイメージと合わないで、少し四角く」)
#define HAND_H_RGB 0xFFFFFF         // 時針(短針)の色: 白
#define HAND_M_RGB 0xFFDC00         // 分針(長針)の色: 黄(背景が黄のときは紺)
#define HAND_EDGE_RGB 0x000000      // 縁の色: 黒
#define SEC_TRI_SIDE 26.0f          // 秒針の正三角形の一辺(縁の線の真ん中)
#define SEC_TRI_R_TIP 174.0f        // 秒針の縁の外側の先の半径(キャンバスは線の真ん中で 174。分針と同じ理由で 174)
#define SEC_FRAME 1.5f              // 秒針の縁の太さ
#define SEC_RGB 0xFF3B30            // 秒針の赤
#define CLK_CLIP_R 175.0f           // 針を消すときに写す円の半径(輪のマスは RING_R_IN − 0.5 から)
// 真ん中(弧とアイコンと針に掛からない四角 CENTER_*。角まで半径 111 以内)。上から順に当てはまった 1 つを出す:
//   1. ピークの三角を出している間: ピークの回転数(PEAK_NUM_FONT)と、その下に「rpm」。回転が上がり切って下がったあとは黄(背景が黄色の
//      ときは紺)、加速中(今の回転数が数字の近く)は白(2.11.0。PEAK_NUM_DROP_RPM。2.12.1: 印が下がり始めても黄のまま)
//   2. 過負荷時間が黄(黄が切なら赤)になってから 0 に戻るまで(2.12.1。黄になる前の白は出さない。load::warned): 半径 LOAD_DISC_R の
//      黒い円の上に、タイトル(「過負荷」か「クールダウン」)と時間を白・黄・赤(クールダウンは水色)の文字で。
//      条件を満たせば下に ▼ 3000rpm と経過時間。GPS の時刻がまだ分からないときは上に「時刻 待ち」
//   3. 高負荷時間の機能が切で、▼ 3000rpm の条件を満たす: ▼ 3000rpm と経過時間(2.9.0 と同じ決まり)
//   4. どれでもない: 接続の状態(GPS・IMU・RaceChrono・CAN の 1 行ずつ。データ画面の簡易版。本人「接続状態を確認しておきたい」)
#define CENTER_X0 141
#define CENTER_X1 326
#define CENTER_Y0 172
#define CENTER_Y1 295
#define PEAK_NUM_FONT FONT_NUM600_88
#define PEAK_NUM_BASE 253           // ピークの数字のベースライン
#define PEAK_RPM_BASE 276           // 「rpm」のベースライン(FONT_NUM600_22)
// 2.11.0: ピークの数字を黄にするのは、今の回転数が数字(最高)よりこれ以上低いときだけ(本人 10/28「回転数はピークになったときだけ黄色に。
// 加速中も白」)。加速中は数字 = 今の回転数なので白。回転数のゆらぎで黄と白が入れ替わらないよう、少し下がっただけでは黄にしない
#define PEAK_NUM_DROP_RPM 100
#define LOAD_DISC_R 96.0f           // 高負荷時間の黒い円の半径(本人「背景は円形のが自然かもしれません」。弧 ARC_R_IN の 2 px 内)
#define LOAD_WAIT_BASE 178          // 「時刻 待ち」のベースライン(FONT_JP600_18)
#define LOAD_TITLE_BASE 209         // タイトルのベースライン(2.11.0: 「高負荷」を FONT_JP600_30。入らない「クールダウン」は FONT_JP500_24)
#define LOAD_TITLE_MAX_W 120        // タイトルを 30 px で出す最大の幅(黒い円の中)
#define LOAD_TIME_BASE 258          // 時間のベースライン(分:秒は FONT_NUM600_64、時:分:秒は FONT_NUM600_56)
#define LOAD_IDLE_BASE 289          // ▼ 3000rpm の行のベースライン
// 2.12.0: クールダウン(本人 10/28「タイトルは今何をしているのかを表示している」「黄色以上の過負荷累積がある場合…クールダウンという表示に
// リセット時間までのカウントダウンがはじまる」「カウントダウンの表示は回転数が落ちて１分以上過負荷にならなければ」「減らして大丈夫です」):
// リセットのあとに一度でも黄(黄が切なら赤)になっていて、過負荷 回転数未満がこの時間続いたら、タイトルを「クールダウン」にして、
// 時間の所をリセットまでの残り(水色)にする。過負荷 回転数以上になったら「過負荷」に戻す
#define LOAD_COOL_SHOW_MS 60000
#define STATUS_Y0 186               // 接続の状態の 1 行目の真ん中の y と、行の間隔
#define STATUS_PITCH 30
#define STATUS_DOT_X 148            // 点の真ん中の x(半径 6)、名前の書き出し、値の書き出し(キャンバス N1〜N3 と同じ)
#define STATUS_NAME_X 160
#define STATUS_VALUE_X 274
// 2.11.0: 真ん中の 4 番目(ほかに出すものが無いとき)は、ふだんはデジタル時計(時:分、日本時間)。接続の状態は、変わってから STATUS_SHOW_MS の
// 間と、GPS の時刻がまだ分からない間に出す(本人 10/28「サーキットでの状態表示はデジタル時計にして、状態のデータは変化があった時に１０秒
// 程度表示する」)。変わったかは行ごとの色と言葉で見る(GPS の衛星の数は見ない)
#define STATUS_SHOW_MS 10000
#define CLOCK_DIGI_FONT FONT_NUM600_64
#define CLOCK_DIGI_BASE 256

// ---------------------------------------------------------------- 高負荷時間(2.10.0。app.cpp の load。仕様書 circuit_screen_spec.md 第 3 版 3 章)
// 回転数が LOAD_RPM 以上なら 1 秒で 1 秒増え、未満なら 1 秒で 1 秒減る(案 B。エンジンが止まっている間も)。LOAD_RPM 未満が
// 設定の「高負荷時間 リセット」(分)続いたら 0(2.12.0: 「以下」→「未満」)。表示器の電源が切れていた時間も減らす(GPS の時刻で求める。
// 1 分ごとに NVS へ)。色: 設定の「高負荷時間 黄」以上で黄、「高負荷時間 赤」以上で赤(0 の色は使わない。両方 0 で機能を切)。
// 2.12.0: 「クールダウン」は黄に達したあとの冷ましている途中の表示(上の LOAD_COOL_SHOW_MS。2.11.0 までは設定の「クールダウン時間」以上で
// タイトルを替えて 0 まで残していた)
#define LOAD_RPM 3000                // 2.12.0: 設定の「過負荷 回転数」の初期値(表示器は設定の値を使う)
#define LOAD_MAX_MS (35999UL * 1000UL)  // 上限 9:59:59【仮】

// ---------------------------------------------------------------- データ画面(仕様書 6 章)
// 10/23: 回転数と全開の割合をやめて、上に GPS・IMU・CAN の値、下に 3000rpm 超と 3000rpm 以下の累計時間(電源を切っても続けて数える。
// TIME_SAVE_MS ごとに NVS へ。設定の「時間の記録」でリセット)
#define TIME_RPM 3000               // ▲ = この回転数以上の時間、▼ = この回転数未満の時間(回転数の信号があるときだけ数える)。2.12.0: 表示器は設定の「過負荷 回転数」
// 2.5.0: 外周に回転数の輪(本人 10/24「データのオープニング画面で外周のアニメーションは実際の画面ではないので、実際の画面にも回転数の
// グラフを追加したい」「アニメーションと同じ幅で」)。真上から時計回りに、0〜DATA_RING_MAX_RPM で一周。点いている所の色はサーキットの
// 輪と同じ決まり(シフト点と RING_*_OFFSET で 灰・青・緑・黄・赤。切り替わりの手前 RING_BLEND_RPM で混ぜる)、残りは輪の地(暗い紺)。
// データのオープニングの輪も同じ所・同じ太さ。中の絵(行・水温と燃料・時間)は、この内側(中心から 217 px まで)に収まっている
#define DATA_RING_R_IN 222.0f       // 輪の内側の半径(2.5.0: オープニングの輪の 214 から外へ寄せた。中の絵と重ならないように)
#define DATA_RING_R_OUT 232.0f      // 輪の外側の半径(太さ 10 px。オープニングの輪と同じ。画面の縁は 233)
#define DATA_RING_MAX_RPM TACH_MAX_RPM  // 一周の回転数(タコの振り切りと同じ)
#define TIME_SAVE_MS 60000          // 累計時間と「覚えている画面」を NVS に書く間隔(変わったときだけ書く)
#define WOT_THROTTLE_PCT 95.0f      // 全開とするアクセル開度【仮】
#define MOVING_SPEED_KMH 1.0f       // 【未定→仮】走行時間 = 車速がこの値以上の時間。全開の時間もこの間だけ数える

// ---------------------------------------------------------------- CAN確認(10/23。2.4.0: 設定 → 受信の状態 → CAN の「C-CAN・B-CAN」の下「CAN確認」)
// 「変化を記録」を押すたびに候補を絞り込む。1 回目 = 基準を取る(全部の ID が候補)。2 回目から = 前の候補のうち、前の記録から今までに
// 「値が違っていて、変わった回数が 1〜CAN_REC_MAX_CHANGES 回」のバイトを持つ ID だけを残し、基準を取り直す
// (カウンターや回転数のように動き続けるバイトは回数が多くて外れる)。【仮】回数の上限は実車で試して決める
#define CAN_MAX_IDS 160             // 覚える ID の数(C-CAN と B-CAN の合計)
#define CAN_HIST_SAMPLES 200        // 詳細の折れ線に出す点の数
#define CAN_HIST_INTERVAL_MS 100    // 【未定→仮】点の間隔。200 点 × 100 ms = 20 秒ぶん
#define CAN_REC_MAX_CHANGES 8       // 記録と記録の間にこの回数より多く変わったバイトは候補から外す
#define CAN_REC_HIST 4              // 件数の移り変わりを出す数(312 → 41 → 12 …)
// 2.16.0: 「前後で比べる」を作り直した(下の 2.16.0 の所)。2.6.0〜2.15.x の説明は記録として残す。
// 2.6.0: 「前後で比べる」(受信の状態 → CAN の最後のページ)。燃料のように、ゆっくり変わる値の ID を、給油などの前後で見つける
// (本人 10/24「長く変化する燃料のような CAN ID を絞り込めないか」「変化が少ない項目の中で、給油のようなイベントの前後で変化が大きい
// ものを検出する」)。「前を記録」「後を記録」を押した時点の直前 CAN_PP_WIN_MS の履歴(上の CAN_HIST_*)から、バイトごとに最小・最大・
// 真ん中の値を取る。候補 = 前も後も幅(最大 − 最小)が CAN_PP_QUIET 以下で、真ん中の値の差が CAN_PP_MIN_DIFF 以上のバイト。
// 前の記録は NVS に書く(給油で電源を切っても残る)。
// 2.7.0: 前も後もエンジンがかかっている間に記録する(燃料 0A18A000 b5 などは、エンジンが止まっている間 0 になり、前の 10 秒に入ると
// 「変化が少ない」から外れる)。10/22 の給油のログで試すと、前 = 止まってエンジンを切る前の 10 秒、後 = エンジンをかけて 5〜15 秒で、
// 増えたもの 3 個(燃料 0A18A000 b5 の 31 → 100 と、同じ値の B-CAN 06214000 b5 を含む)・減ったもの 4 個だった
// (2.6.0 の試験は前の 10 秒にエンジンを切った所が入っていて燃料が外れていた。そこで 1 番目だった 0C014003 b5 は燃料ではなかった)
// 2.16.0: 作り直した「前後で比べる」(本人 11/12「汎用的に作り直してESCのCANIDを捕捉するもの」)。下「前を記録」「後を記録」を交互に押す
// (1 回目は前)。押してから CAN_PP_WIN_MS のあいだ受けたフレームを 1 回の記録にして、何回でも繰り返して絞る。候補は
//   ビット: 毎回の記録で受けた ID の、記録の間ずっと変わらなかったビットのうち、前ではいつも同じ値、後ではいつもその逆のもの
//           (カウンターや回転数のように記録の間に動くビットは外れる。ゆっくり動く値は、前をもう一度記録すると合わなくなって外れる)
//   ID:     前では毎回受けて後では一度も受けなかった ID(後は受信なし)と、その逆(前は受信なし)
// 全部の記録を NVS に書く(電源を切っても続けられる: 制御 OFF のように、エンジンをかけ直さないと戻らない切り替え)。
// 記録の間に状態を変えると、変えたビットは「ずっと変わらなかった」から外れて候補に戻らないので、切り替えてメーターの表示が
// 変わってから押す。CAN確認の変化を記録とは別(互いに消さない)
#define CAN_PP_WIN_MS 10000         // 1 回の記録の長さ [ms](押してから)
#define CAN_PP_SETTLE_MS 15000      // 受信が始まってから記録できるまで [ms](電源を入れた直後・エンジンをかける間の値を入れない)
#define CAN_PP_MAX 40               // 一覧に出す候補の数(C-CAN → B-CAN、ID の小さい順に。件数は全部を数える)

// ---------------------------------------------------------------- 画面の操作(10/23。2.1.0 でスワイプと長押しに変えた)
// タッチ(2.3.0): 触れてから TOUCH_CONFIRM_MS 押し続けたら「タッチ」と決める。それより前に離したタッチは何もしない
//   (反応が良すぎて、軽く触れただけで動いていた。本人の指示 10/24「0.3 秒ぐらいから試す」)。時間はすべて触れた瞬間から数える。
//   TOUCH_CONFIRM_MS < HOLD_SHOW_MS < HOLD_MS にしておくこと
// 2.4.0: どの画面も離したときに決める。スワイプ = 触れた所から横に SWIPE_MIN_PX 以上動いていて、横の動きが縦の SWIPE_DIR_RATIO 倍以上。
//   左へ = 次、右へ = 前(2.1.0 から。2.4.0〜2.4.1 は右へ = 次にしていたが、本人 10/24「間違えました 左にスワイプでタコでした」で戻した)。
//   サーキット・タコ・データは画面
//   (サーキット → タコ → データ → サーキット)、設定の中は項目・ページ(本人の指示 10/24「設定の項目移動もスワイプに」)。
//   タップ = 動きが HOLD_CANCEL_PX 未満(位置は触れた所)。サーキット・タコ・データのタップは何もしない。
// サーキット・タコ・データ: タッチが決まったら案内を出す: 上に「‹ スワイプ ›」、下に「長押し ▶ 設定」(2.4.0: 上下対称、同じ幅。
//   本人の指示 10/24)。決まった時点で指が HOLD_CANCEL_PX 以上動いていれば(スワイプの途中)出さない。案内の間は画面の描き直しを止め、
//   離したら消す。
//   長押し: HOLD_SHOW_MS 押し続けたら、案内のままスワイプの札を灰にし、外周がそこから HOLD_MS までに一周していく(2.4.0: 暗くしない。
//   札の文字も位置も変えない。本人の指示 10/24「タイトルが変わることで認識しづらい」)。HOLD_MS で設定(前回見ていた項目)。
//   指が HOLD_CANCEL_PX 以上動いたら長押しを取り消し、案内は出したまま長押しの札を灰にする(2.4.0。前は元の画面に戻っていて、
//   タッチを受けているのか分からなかった)。
//   2.2.0(10/23 実車): 長押し 0.4 → 0.8 秒、表示を出すのを 0.1 秒 → 長押しの半分に(スワイプの途中で出てうるさい)、
//   スワイプの幅 80 → 160 px(80 px は画面で約 7.5 mm。ごく小さく動かしただけで替わっていた)。画面は 466 px で直径 約 44 mm
//   2.3.1(10/24): 外周が一周する時間を 0.4 → 0.8 秒、設定へ 0.8 → 1.2 秒(表示を出すのは 0.4 秒のまま。本人の指示「この時間を 0.8 秒に」)。
//   タッチが決まるまで 0.1 秒(2.3.0 の 0.3 秒では、設定の中のふつうのタップが効かなかった)
//   2.4.0(10/24): 長押しを取り消す動き 30 → 80 px(約 3 → 約 8 mm。本人「少しだけ指がずれたときに長押しになりません」)
//   【未確認】しきい値は実車で試して決める。シリアルの「タッチ: 離した(…)」の行に、触れた所からの動き(横・縦)を出す
// 設定の中: 画面を上・下の帯と、真ん中の左半分・右半分に分ける。上の帯 = 「‹ 今いる所の名前」(1 つ上へ。設定の項目は「‹ 設定」で
// 元の画面へ)、下の帯 = その画面の操作、真ん中の左右 = 前・次(変更の画面では − +)。2.4.1: 2.4.0 でやめた左右のタップを戻した
// (本人「設定画面は選ぶ量が多いのでボタンの方がわかりやすい。矢印があるのに押せないのはイラつく」)。スワイプでも送れる。
// タップもスワイプも離したときに決めるので、動きが HOLD_CANCEL_PX 未満の短いスワイプは、触れた側の半分のタップになる。
// 2.4.4: メニューに入る(項目・グループ・CAN確認の一覧などを開く)のは長押し(HOLD_MS。サーキット・タコ・データから設定に入るのと同じ。
//   2.4.5: 画面のどこでも。本人「長押しで開くはその場所ではなく画面全体です」)。下の帯は「長押しで開く」。HOLD_SHOW_MS 押し続けたら
//   帯が水色になり、外周が回る(2.5.0: 2.4.5 までは TOUCH_CONFIRM_MS で水色にしていて、矢印のタップでも帯が反転した。本人「混乱します」)。
//   指が HOLD_CANCEL_PX 以上動いたら取り消し(帯は灰。離すと戻る)。外周が回り始めてから HOLD_MS の前に離したら何もしない(2.7.0)。
//   短いタップでは開かない(その所のタップ)。値を確定する「決定」(変更の画面)、消す操作の赤い帯、「変化を記録」はタップ
#define TOUCH_CONFIRM_MS 100
#define HOLD_SHOW_MS 400
#define HOLD_MS 1200
#define HOLD_CANCEL_PX 80           // 長押しを取り消す動き(触れた所からの距離)。これ未満で離せばタップ(2.4.0: 30 → 80)
#define SWIPE_MIN_PX 160            // スワイプとみなす横の動き(約 15 mm。画面の幅の 3 分の 1 ほど)
#define SWIPE_DIR_RATIO 2           // 横の動きが縦の何倍以上ならスワイプか
#define ZONE_TOP_Y 120              // これより上 = 上の帯
#define ZONE_BOT_Y 346              // これから下 = 下の帯
// 「覚えている画面」: サーキット・タコ・データのうち、HOME_CONFIRM_MS 続けて見ていた画面。次の起動と、設定から時間で戻るときにこれを出す
#define HOME_CONFIRM_MS 60000
// 設定の「決定」で値を保存したあと、押した所(下の「決定」の帯)を点滅させる回数と、消す・点けるのそれぞれの時間。点滅の間は値を太くし、
// 終わってから元の画面へ戻る(2.4.3。本人「押したところにアクションがある方が直感的」「値は太くするか少し大きく」。2.3.1〜2.4.2 は
// 戻った画面で値を緑で点滅させていた。2.3.0 の「保存しました」の画面はうるさかった。本人の指示 10/24「数回フラッシュぐらいで十分」)
#define SAVED_FLASH_COUNT 3
#define SAVED_FLASH_MS 100
// 押した帯の反転(2.7.0。本人「can確認画面などでボタンを押した時に押したことがわかりにくいので、反転表示を入れてください」):
// 設定・CAN確認の上の帯と、タップで動く下の帯(「変化を記録」「前を記録」「後を記録」、赤い帯)は、タッチが決まってから離すまで
// 反転して描く(水色の帯に地の色の字。赤い帯は白い帯に赤の字)。下の帯の操作は、離してから PRESS_FLASH_MS 反転のまま見せてから行う
// (押している間は指で帯が隠れる)。上の帯は離したらすぐ 1 つ上へ。長押しの表示が出たら・指が動いて取り消したら反転をやめる。
// 「長押しで開く」の帯と「決定」(押したあとに点滅する)は今までどおり
#define PRESS_FLASH_MS 250

// ---------------------------------------------------------------- 受信の状態・本体の状態の判定(2026-10-22 夜。1 画面 1 項目にしたので、
// 下の点の色で全項目の判定を一度に見せる。緑 = 正常、赤 = 異常、灰 = 待ち・切)【仮】
//   2.4.0: 受信の状態 = グループ(CAN・GPS・IMU・RaceChrono)のまとめ。中は 1 ページ 1 項目:
//     CAN: 通信速度 = 受けていれば緑(バイトは届くのに読めなければ赤)、受信 = フレームが来ていれば緑、
//       誤り・欠落 = 直近 INFO_RECENT_MS に増えたら赤、CANリーダー = 版が違えば赤、C-CAN・B-CAN = C-CAN が 0 なら赤(下「CAN確認」)、
//       燃料 = 表示に使っている % (0A18A000 b5。2.7.0。判定に使わない)、
//       ライト = ライトのスイッチ(点・消)と今の明るさ %。下の行に b0 と、電源を入れてから最初に受けるまでの秒(2.9.0。判定に使わない)
//     GPS: 測位 = 送信が入なのに届かなければ赤、位置・速度。IMU: 加速度 = 応答なしは赤、向きの補正(下「向きを取り直す」)
//     RaceChrono: 送信(入・切。下「変更」)、接続 = 開始できなければ赤、送った数 = 直近 INFO_RECENT_MS に捨てたら赤。
//     GPS・IMU・RaceChrono は、送信が切なら「切」の灰(GPS・IMU も動かしていない)
//   本体の状態(2.4.0: 受信の状態から移した): FPS = 下の FPS_*、起動 = 起動のきっかけ
// まとめ(2.2.0): 赤が 1 つでもあれば「異常 n」。無くても、通信の項目(CAN: 通信速度・受信・誤り・欠落・CANリーダー・C-CAN・B-CAN、
//   GPS: 測位、IMU: 加速度、RaceChrono: 接続・送った数)が 1 つでも緑でなければ「待ち」。全部緑のときだけ「正常」(2.1.0 までは、
//   起動などの緑が 1 つあれば通信が切れていても「正常」と出ていた)。設定の「受信の状態」のまとめは、4 グループの赤を全部数え、
//   「待ち」は CAN の項目だけで決める(スマホが未接続でも「待ち」にしない)。CAN の 通信速度 は、起動から INFO_LINK_GRACE_MS たっても
//   受けていなければ赤(デモ表示の間は灰)
#define INFO_RECENT_MS 60000
#define INFO_LINK_GRACE_MS 5000
// FPS(2.3.0。2.0.1〜2.2.0 は「描画」で、1 回描いて送る時間の最長を出していた): サーキット・タコで 1 回描いて送るのにかかった時間から
// 「回/秒」を出す。2.4.3(本人「過去数分の FPS の値がここに出るほうがいい」): 1 秒ごとにまとめ、サーキット・タコを出していた秒だけを
// 新しい方から PERF_FPS_SECS 秒ぶん覚える。平均 = 全部の回の平均、最低 = 1 秒ごとの値で一番低い秒(「平均 45 最低 21」)。下にグラフ
// (縦は 0〜FPS_GRAPH_MAX 回/秒、INFO_FPS_MIN に細い線)。平均が INFO_FPS_MIN 未満なら赤。数えた回が FPS_MIN_FRAMES 未満なら「– –」の灰。
// 画面を切り替えた回・タコの目盛を赤にする(戻す)回の全体の描き直しと、案内・長押しの表示は数えない(サーキットの背景の色を塗り直す回は
// 数える。全体の描き直しで遅い)。2.3.0〜2.4.2 は直近 100 回の遅い方 5 % を除いた最低で赤にしていたので、背景の色が変わる回が多いと
// 毎回「最低 9」の赤になっていた
#define PERF_FPS_SECS 180
#define FPS_GRAPH_MAX 60
#define FPS_MIN_FRAMES 30
#define INFO_FPS_MIN 20

// ---------------------------------------------------------------- 設定(仕様書 8 章)
// 【未定→仮】刻みと上下限。値は NVS(名前空間 "meter")に保存する。
#define SET_SHIFT_DEFAULT 5800
#define SET_SHIFT_MIN 3000
#define SET_SHIFT_MAX 7500
#define SET_SHIFT_STEP 100
#define SET_AUTORET_DEFAULT 3       // 分【決定】
#define SET_AUTORET_MIN 1
#define SET_AUTORET_MAX 10
#define SET_AUTORET_STEP 1
#define SET_BRIGHT_DEFAULT 80       // %【仮】
#define SET_BRIGHT_MIN 10
#define SET_BRIGHT_MAX 100
#define SET_BRIGHT_STEP 10
// イルミネーションの明るさ(2.9.0): ライトのスイッチが入の間のふだんの明るさ(切・まだ受けていない間は上の明るさ)。
// 「明るさ」と同じ値にすれば、ライトで変わらない
#define SET_ILLUM_DEFAULT 30        // %【仮】
#define SET_ILLUM_MIN 10
#define SET_ILLUM_MAX 100
#define SET_ILLUM_STEP 10
#define SET_WARN_DEFAULT 110        // ℃【仮】
#define SET_WARN_MIN 90
#define SET_WARN_MAX 125
#define SET_WARN_STEP 5
// 燃料の警告(2.14.0): 残量がこれ未満で警告(赤)、これ + FUEL_CAUTION_ABOVE_PCT 未満で注意(暗い黄)。2.13.0 までは 30 % 固定(10/22 に 15 → 30)。
// 本人 10/30「燃料の警告しきい値がちょっと高すぎます」: 30 % は注意の始まりにして、警告の初期値は 20 %【仮】
#define SET_FUELWARN_DEFAULT 20     // %
#define SET_FUELWARN_MIN 5
#define SET_FUELWARN_MAX 50
#define SET_FUELWARN_STEP 5
#define SET_DEMO_DEFAULT 0          // デモ表示(0 = 切、1 = 入)。入の間は UART を使わず、表示器の中で作った模擬の値を出す
#define SET_RING_DEFAULT 0          // 回転数の輪(2.12.0。0 = 両側、1 = 片側。上の RING_ONE_*)
// 過負荷 回転数(2.12.0): 過負荷時間(これ以上で増え、未満で減る)・累積時間(▲ = これ以上の時間、▼ = これ未満の時間)・サーキットの
// 「▼ 3000rpm」(これ未満の経過時間)の境目。初期値は LOAD_RPM・TIME_RPM・IDLE_RPM と同じ 3000
#define SET_LOADRPM_DEFAULT LOAD_RPM
#define SET_LOADRPM_MIN 2000
#define SET_LOADRPM_MAX 6000
#define SET_LOADRPM_STEP 100
// メンテナンスまでの累積時間(2.12.0): 累積時間(▲)がこの時間に達したらメンテナンスの時期。時間。0 = 切。初期値 5 時間(本人 10/28「時間は５時間」)
#define SET_MAINT_DEFAULT 5
#define SET_MAINT_MIN 0
#define SET_MAINT_MAX 99
#define SET_MAINT_STEP 1
// 累積時間 リセット(2.12.0): 値を入れてからリセットする(本人 10/28「今の累積走行時間を入れる入力を追加してください」「累積時間の入力は
// リセットと同じ画面に」「最初0:00:00が出て＋ーボタンで３０分ずつ」)。0:00:00 から TRIP_IN_STEP_MIN 分ずつ、0〜TRIP_IN_MAX_H 時間。
// 下「リセット」で ▲ をその値、▼ を 0 にしてすぐ保存
#define TRIP_IN_STEP_MIN 30
#define TRIP_IN_MAX_H 99
#define SET_RC_DEFAULT 1            // RaceChrono への送信(0 = 切、1 = 入)。変えると次の起動から効く。
                                    //   BLE・GPS・IMU のどれかが原因で落ちる(リセットが続く)と、表示器が自分で 0 にする(下の RC_CRASH_LIMIT)
// 過負荷時間(2.10.0)。分。黄・赤は 0 で「切」
#define SET_LOADY_DEFAULT 10        // 過負荷時間 黄(2.12.0: 15 → 10。本人 10/28「過負荷のしきい値は１０分程度にすると思います」)
#define SET_LOADR_DEFAULT 30        // 過負荷時間 赤【仮】
// 2.12.0: 設定の「クールダウン時間」はなくした(「クールダウン」は黄に達したあとの冷ましている途中の表示にした。下の LOAD_COOL_SHOW_MS)
#define SET_LOAD_MIN 0
#define SET_LOAD_MAX 90
#define SET_LOAD_STEP 5
#define SET_LOADRS_DEFAULT 5        // 高負荷時間 リセット(本人「５分は設定で」)
#define SET_LOADRS_MIN 1
#define SET_LOADRS_MAX 30
#define SET_LOADRS_STEP 1
// 2.10.0: 設定の「デフォルトに戻す」は、上の *_DEFAULT に全部戻して保存する(時間の記録・IMU の向き・高負荷時間の値は戻さない)

// ---------------------------------------------------------------- 受信
#define LINK_TIMEOUT_MS 1000        // 【未定→仮】この時間フレームが来なければ「信号がない」(LED バーの 1 秒と同じ)
// 速度の自動合わせ(候補は meter_link.h の METER_LINK_BAUD_CANDIDATES)。
// 「バイトは届くのに正しいフレームが 1 つも無い」区間が続いたら、次の候補へ移る。
// XIAO のリセット直後に出る短い起動ログ(115200 bps、1 秒未満)では移らない長さにしてある。
#define LINK_BAUD_WINDOW_MS 500     // 判定する区間の長さ
#define LINK_BAUD_BAD_WINDOWS 3     // この回数続いたら移る(500 ms × 3 = 1.5 秒)
#define LINK_BAUD_MIN_BYTES 16      // 区間の中のバイト数がこれ未満なら「届いていない」とみなす(移らない)

// ---------------------------------------------------------------- 車の CAN の生データから表示に使う値を作る(app.cpp の veh。2026-10-23 に c6_can_link から移した)
// 1.x の c6_can_link(XIAO)は値に直して「値のフレーム」(MlSignals)で送っていた。2.0.0 からは CAN の生データだけを送り、
// 値への換算・ギアの推定は全部ここで行う。値のフレームが届いているとき(c6_display_debug・デモ表示・
// 1.x の c6_can_link)はそちらを使い、届いていないときに生データから作る(mlink::getSignals)。
// 値の出どころ(すべて 29 ビット ID。「確認済み」は実車ログで確かめたもの):
//   回転数     C-CAN 0618A001 b2-b3(ビッグエンディアン、そのまま rpm)           確認済み(9/7)
//   アクセル   C-CAN 0618A001 b7(0〜255 = 0〜100 %)                             確認済み(9/7)
//   車速       C-CAN 0210A006 b4-b5(ビッグエンディアン)÷ 128 = km/h             確認済み(9/7)
//   クラッチ   C-CAN 0628A001 b5 の bit5(1 = 踏んでいる)。ギアの推定にだけ使う   確認済み(9/7)
//   水温       C-CAN 0A18A001 b3 − 40 = ℃                                      確認済み(10/22)
//   ブースト   C-CAN 0A1CA001 b2 × VEH_BOOST_BAR_PER_LSB = bar(大気圧との差)     確認済み(10/25。アイドル 0、10/22 の全開で最大 68)
//              (0A18A001 b4-b5 は燃料の量で、ブーストではない。2.7.0 まではこの b4 をブーストに使っていた)
//   リバース   C-CAN 0A18A001 b7 の bit2(1 = R)                                 確認済み(10/22)
//   燃料       C-CAN 0A18A000 b5 = %(0 は測れていない値。下の 燃料)                 確認済み(10/22 のログ 3 本。2.7.0)
//   ライト     B-CAN 06214000 b0 の 0x08(1 = ライトのスイッチが入)。明るさに使う(下の ライト)  確認済み(10/26 本人。2.9.0。10/28 本人: 実車で動作している)
//   スポーツ   C-CAN 0A18A000 b4 の 0x10(1 = スポーツモード)。タコに「SPORT」  確認済み(10/28 本人の写真: b4 = 10 でメーターがスポーツの表示、
//              00 で通常。10/22 のログ 3 本では b4 は 00 と 02 だけ)。2.11.0
//   ギア       R は上のビット。1〜5 は回転数 ÷ 車速の比から推定(下の VEH_GEAR_*)。2 km/h 未満は N
#define VEH_ID_RPM_ACCEL 0x0618A001UL
#define VEH_ID_SPEED 0x0210A006UL
#define VEH_ID_CLUTCH 0x0628A001UL
#define VEH_ID_ENGINE 0x0A18A001UL     // 水温・リバース
#define VEH_ID_FUEL 0x0A18A000UL       // 燃料(b5)
#define VEH_ID_BOOST 0x0A1CA001UL      // ブースト(b2)。2.8.0
#define VEH_BOOST_BAR_PER_LSB 0.02f    // ブーストの 1 LSB [bar](本人決定 10/25。2.7.0 までは 0A18A001 b4 × 0.01)
#define VEH_REVERSE_MASK 0x04          // 0A18A001 b7 のリバースのビット
#define VEH_ID_LIGHT 0x06214000UL      // ライト(B-CAN。b0)。2.9.0
#define VEH_LIGHT_BYTE 0               // 見るバイト(b0)
#define VEH_LIGHT_MASK 0x08            // 06214000 b0 のライトのスイッチのビット
// (B-CAN 02214000 b1 もライトで 28 / 00 に変わる(10/28 本人の写真、10/22 のログ)。使っていない)
#define VEH_SPORT_MASK 0x10            // 0A18A000(VEH_ID_FUEL)b4 のスポーツモードのビット(2.11.0。受けているかは燃料と同じ VEH_FUEL_TIMEOUT_MS)
// 「信号なし」にするまでの時間。c6_can_link は中身の変わらない ID を 1 秒ごとに送り直すので、それより長くする
// (1.x は XIAO が CAN を受けた時刻から 1 秒で判定していた)。受けていない ID は c6_can_link が送らなくなる(2.0.0)
#define VEH_TIMEOUT_MS 2000            // 回転数・アクセル・車速・クラッチ・ブースト・リバース
#define VEH_WATER_TIMEOUT_MS 3000      // 水温(1.x と同じ)
#define VEH_FUEL_TIMEOUT_MS 5000       // 燃料(b5 = 0 のフレームも数える。1.x と同じ長さ)
// ライト(2.9.0。B-CAN 06214000 b0 の 0x08 = ライトのスイッチ。本人 10/26: 表示器の CAN確認で、スイッチを 切 → 入 → 切 にして
//   b0 が 20 → 28 → 20。ほかの 7 バイトは同じ)。b0 のほかのビットは見ない(バイト全体では比べない): 10/22 の実車ログでは、
//   ライトが入のまま b0 = 28(停車中)と 08(走行中)を行き来する(0x20 は停車中に 1。意味は未確認)。
//   電源を入れてから最初に受けた値はすぐ使う。そのあとは、今と違う値を受けてから VEH_LIGHT_SETTLE_MS のあいだに元の値を受けなければ
//   切り替える。VEH_LIGHT_TIMEOUT_MS 受けなければ受信の状態に「受信なし」と出すが、明るさは最後の状態のまま(XIAO の再起動などの
//   短い途切れで明るさが上下しないように)。c6_can_link は中身の変わらない ID も 1 秒ごとに送り直す
#define VEH_LIGHT_SETTLE_MS 300        // 【仮】
#define VEH_LIGHT_TIMEOUT_MS 5000      // 【仮】
// ODO(2.15.0。B-CAN 0C014003 の b1 の下位 4 ビット + b2 + b3 = 20 ビットのビッグエンディアン = km。10/22 のログで 22927 → 22934 と
//   走行に合わせて 1 ずつ増えた。本人 11/2: 純正メーターの ODO が約 23,500 km で矛盾なし)。前の値より小さい値と、前の値から ODO_MAX_JUMP_KM を
//   超えて増えた値は捨てる(同じ値が ODO_ACCEPT_REPEAT 回続いたら、その値を使う。最初の値が壊れていたときに止まらないように)
#define VEH_ID_ODO 0x0C014003UL
#define ODO_MAX_JUMP_KM 5
#define ODO_ACCEPT_REPEAT 20
#define ODO_STALE_MS 2000              // これより長く受けていなければ「古い」(書かない)

// ---------------------------------------------------------------- 走行記録(2.15.0。仕様書 odo_log_spec.md 第 3 版)
// 書くのは次を全部満たしたとき: 低速(ODO_LOW_KMH 以下。停車も入るので、仕様書 第 3 版の「停車 3 秒」は待たない)・リバースのどちらか、GPS の時刻が分かっている、
//   前の記録から ODO か過走行時間が増えた、前の書き込みから ODO_MIN_INTERVAL_MS 以上。日付(日本時間)が変わったら、次に停車・低速・リバースに
//   なったときに前の日の締めの記録を書く(増えていなくても、間隔を待たずに)
// 記録は 1 件 ODO_REC_BYTES。パーティションの先頭から追記し、ODO_SECTOR_BYTES の区切りの最初に書く前にその区切りを消す(輪のように使う)
#define ODO_LOW_KMH 10.0f              // 本人 11/2
#define ODO_STILL_KMH 0.5f             // これ未満なら、記録の「書いたきっかけ」を停車にする
#define ODO_MIN_INTERVAL_MS 60000      // 本人 11/2
#define ODO_REC_BYTES 32
#define ODO_SECTOR_BYTES 4096
#define ODO_TABLE_DAYS 4096            // 日ごとの表(PSRAM)の日数。1 日 12 バイト。輪が一周する日数(1 日 10 回で約 2,870 日)より多く
#define ODO_WEEK_START 0               // 週の始まりの曜日(0 = 日曜。本人 11/8)
// 燃料(2.7.0): C-CAN 0A18A000 の b5 が残りの %(B-CAN 06214000 b5 にも同じ値)。10/22 のログ 3 本で 35 → 33 → 32・31、給油して 100。
//   どの区間もほとんど揺れない(幅 0〜2)ので、なましはしない(そのまま表示する)。
//   b5 = 0 は測れていない値で、使わない(前の値のまま): エンジンが止まっている間(IG ON でも)と、かけた直後・止めた直後の約 1 秒は 0 で来る。
//   100 を超える値も使わない。電源を入れてからエンジンがかかるまでは値なし(「– –」)。
//   2.6.0 までは B-CAN 0C014003 b5(1 LSB = 1 L と見ていた)をなまして使っていたが、燃料ではなかった(純正の燃料計が 8 目盛すべて点いて
//   いる間に 1 時間で 189 → 135 → 115 と動いた。本人 10/24「どうも燃料の canID が違うのではないかとおもうぐらいズレます」。
//   10/22 の給油の前後で +25(給油 25 L)だったのは偶然)。なましの値の保存(NVS の "fuel")もやめた
// ギアの推定【仮】: 回転数 ÷ 車速 [rpm per km/h] が、各ギアの計算値の ±VEH_GEAR_TOL_PCT % に入ればそのギア。
// 変速比と最終減速比は 595(C510 5 速)の公表値、タイヤ外周は 205/40R17 の計算値。この車で確かめた値ではない。
// 実車で合わなければ、シリアルの 5 秒ごとの「車の値」の行の「比」(クラッチを離して走っているときの rpm/kmh)を見てここを直す
#define VEH_GEAR_RATIOS { 3.909f, 2.238f, 1.520f, 1.156f, 0.872f }
#define VEH_FINAL_DRIVE 3.353f
#define VEH_TIRE_CIRC_M 1.878f
#define VEH_GEAR_TOL_PCT 12.0f
#define VEH_GEAR_MIN_KMH 5.0f          // これより遅いときは推定しない(前の値のまま)
#define VEH_STOP_KMH 2.0f              // これより遅ければ停車とみなして N
#define VEH_GEAR_MIN_RPM 500
// クラッチのビットでギアを止めるか(c6_can_link 1.0.0 で 0 にした)。10/22 のログでは、1 速でつながって走っている間も
// 0628A001 b5 bit5 がほぼ 1 のまま(1 速 901 回中 892 回が 1、2 速でも 4 割)で、1 速がなかなか出ない原因と見ている(有力)。
// 半クラッチの間は比がどのギアにも合わないので、止めなくても誤ったギアは出にくい。元に戻すときは 1
#define VEH_GEAR_HOLD_ON_CLUTCH 0

// ---------------------------------------------------------------- RaceChrono へ送る(BLE、GPS、IMU)。2026-10-14 に追加
// RC_ENABLE 0 にすると、この機能をコンパイルから外す(NimBLE-Arduino が無くてもビルドできる。切り分け用)
#define RC_ENABLE 1
// 落ちる起動(パニックやウォッチドッグによるリセット)がこの回数続いたら、RaceChrono の送信を設定で「切」にして、
// 表示器としては動き続ける。設定 → 受信の状態 → RaceChrono の「送信」で入に戻せる。60 秒落ちずに動いたら回数は 0 に戻る
#define RC_CRASH_LIMIT 2
// 表示器が RaceChrono DIY の BLE 機器(仕様: github.com/aollin/racechrono-ble-diy-device)になり、
// GPS(M100)・CAN(XIAO から届く生データ)・IMU(QMI8658)を 1 台で送る。RaceChrono では「設定 → Add other device →
// Add other device → RaceChrono DIY」(接続の種類 Bluetooth LE)で 1 つ登録する(GPS 機器の一覧には出ない。GPS も CAN も
// この 1 つの登録で届く)。
#define RC_BLE_NAME "595 meter"      // RaceChrono の機器一覧に出る名前
#define RC_BLE_CONN_PARAMS 0         // 1 = つながった直後に接続の間隔 7.5〜15 ms を頼む。0 = 頼まない(スマホ任せ。参考にした 2 つの実装と同じ)
#define RC_GPS_RATE_HZ 20            // M100 に頼む測位の回数/秒(2.13.0: 25 → 20)。M100(u-blox M10)の上限は GPS+Galileo で、既定 10、OTP の高性能設定で 20
                                     //   (GPS だけなら 18 / 25)。頼んだ値が上限より多いと上限で止まる。実際の回数は 受信の状態 → GPS に出る
// 2.13.0: M100 の OTP の高性能設定。1 = 起動時に確かめ、入っていなければ書く(永久。元に戻せない。本人 10/29 の決定、10/31「高性能化を実行してください」)。
//   0 = 確かめるだけ(書かない)。書くのは版(MON-VER の swVersion)が RC_GPS_OTP_FW_PREFIX で始まるときだけ(マニュアルの手順は ROM SPG 5.10 のもの)。
//   2.14.5: 確かめ方はマニュアルの手順 5 の問い合わせ(VALGET 層 4)。NAK = まだ書いていない。書くのはこの表示器で一度だけ(NVS の "otpw"。
//   別の M100 に替えたときも、"otpw" を消すまでは書かない)
#define RC_GPS_OTP_HIGH_PERF 1
#define RC_GPS_OTP_FW_PREFIX "ROM SPG 5.10"
#define RC_GPS_OTP_SETTLE_MS 1000    // 位置が届き始めてから、版と鍵を読むまでの間
#define RC_GPS_OTP_REPLY_MS 3000     // 応答(MON-VER・VALGET・ACK)を待つ時間。過ぎたら送り直す(RC_GPS_OTP_TRIES 回まで)
#define RC_GPS_OTP_TRIES 3
#define RC_GPS_BAUD 115200           // M100 の UART の速度。届かなければ別の速度(9600 など)で速度を書き換えてから使う
#define RC_GPS_CFG_LAYERS 0x03       // M100 の設定を書く層(bit0 = RAM、bit1 = BBR(電池で保持)、bit2 = フラッシュ)。
                                     //   RAM だけなら毎回の起動で設定し直す(数秒かかる)。BBR にも書くと次からすぐ届く
#define RC_GPS_RETRY_MS 2000         // 設定を送って、この時間 UBX が届かなければ速度を変えて送り直す
#define RC_GPS_LOST_MS 3000          // 位置(NAV-PVT)がこの時間来なければ「GPS が途切れた」として設定を送り直す
#define RC_IMU_HZ 20                 // IMU の値を RaceChrono へ送る回数/秒【仮】
#define IMU_SAMPLE_HZ 50             // IMU を読む回数/秒
#define RC_QUEUE_LEN 48              // 送る前の通知を溜める数(あふれた分は「捨てた」に数える)
#define RC_SEND_BCAN 1               // 1 = B-CAN の生データも RaceChrono へ送る。0 = C-CAN だけ(ID が C-CAN と重なるときは 0)
// 車の CAN を RaceChrono へ送る最短の間隔(PID ごと)。RaceChrono が頼む間隔がこれより短くても、この間隔より詰めない。
// c6_can_link 2.0.0 は表示器に回転数などを 50 回/秒で届けるため、生データを最短 20 ms 間隔で送る(1.x は 50 ms)。
// RaceChrono へ送る量を 1.x のときと同じに保つため、ここで 50 ms にそろえる(BLE の帯域。IMU は RC_IMU_HZ のまま)
#define RC_CAN_MIN_MS 50
// IMU の値を RaceChrono に CAN の 1 つとして送るときの ID。RaceChrono(iPhone)の PID 欄は 0x1FFFFF01 も 0x0FFFFF01 も
// 「有効な PID を入力してください」で弾いた(10/15。上限の規則は未確認)。通っている車の ID(0x0618A001)と同じ形で、
// 車が使っていない値にしてある【未確認: 車のログの ID 一覧と照合する。同じ ID が車から届いたらシリアルに警告が出る】。
// RaceChrono の CAN チャンネルの PID にこの値を入れる(0x 06 18 A0 F1)。中身は int16(下位が先)× 3:
//   RC_PID_IMU_ACCEL: 前後・横・上下の加速度 [mg](前が正、右が正、上が正。重力は引いてある)
//   RC_PID_IMU_GYRO : ヨーレート [0.01 deg/s](左回りが正)、ほか 2 軸は 0
#define RC_PID_IMU_ACCEL 0x0618A0F1
#define RC_PID_IMU_GYRO 0x0618A0F2
// IMU の向きの補正(取り付け角は自動で覚える。停車中の重力で「上」、発進の加速で「前」。覚えた向きは NVS に保存)
// 覚える前の向き(初期値)は「画面を立てて運転者に向け、本体の背面が車の前」。机の上で画面を立てた状態で 0/0/0 になる。
// 実機で確かめた軸(10/15): 画面を立てると +X が上、画面を伏せる(背面が上)と +Z が上 = +Z は背面の向き。
#define IMU_DEF_UP { 1.0f, 0.0f, 0.0f }   // 覚える前の「上」(センサーの軸、長さ 1)
#define IMU_DEF_FWD { 0.0f, 0.0f, 1.0f }  // 覚える前の「前」(= 背面)
#define IMU_LAT_SIGN 1               // 横加速度の符号(1 = 右が正。RaceChrono の向きと合わなければ -1)
#define IMU_STILL_KMH 0.5f           // この車速未満を停車とみなす
#define IMU_LEVEL_STILL_MS 3000      // 停車がこの時間続いたら「上」を覚える
// 車速の信号が無いとき(机の上、XIAO も GPS も無い)は、値が動かず大きさが 1 g に近い状態が 3 秒続いたら静止とみなして
// そのときの重力の向きを「上」にする(置き直すたびに更新)。ただし初期の「上」から IMU_QUIET_TILT 以内のときだけ
// (伏せた・仰向けの試験で「上」が動かないように)。「前」は車速が要る(発進の加速)
#define IMU_QUIET_G 0.03f            // 直前の値からの変化がこれ未満 [g] なら静止(大きさは 0.8〜1.2 g のとき。実機は 1.1 g と出る)
#define IMU_QUIET_TILT_COS 0.707f    // 初期の「上」との内積がこれ以上(45° 以内)
#define IMU_UP_EMA_MIN_KMH 5.0f      // 走行中の長期平均で「上」を直す(この車速以上の間だけ。坂に止めたままでも動かない)
#define IMU_UP_TAU_MS 600000         // その長期平均の時定数(10 分)
#define IMU_FWD_FROM_KMH 3.0f        // 発進の加速で「前」を覚える車速の範囲(集め始め)
#define IMU_FWD_TO_KMH 25.0f         // これより速いと集めない
#define IMU_FWD_DONE_KMH 15.0f       // ここまで加速したら平均を取る(後退ではここまで出さない前提)
#define IMU_FWD_SAMPLES 40           // 「前」を決めるのに最低限必要な加速中の値の数(50 回/秒なら 0.8 秒ぶん)
#define IMU_RELEARN_COUNT 5          // 覚えた向きと大きく違う値がこの回数続いたら、付け直したとみなして覚え直す

// ---------------------------------------------------------------- 数字の形
// 1 = 数字の幅をそろえる(仕様書 9.2)。Saira の等幅数字を使う。
// 0 = キャンバスの絵と同じ(書体に等幅数字が無く、数字ごとに幅が違う)。値が変わると数字が左右に動く。
#define DIGITS_TABULAR 1

// ---------------------------------------------------------------- 基板(Waveshare ESP32-S3-Touch-AMOLED-1.75)
// ピン番号は Waveshare 公式リポジトリの HARDWARE_REFERENCE.md と examples/arduino の pin_config.h による。
#define PIN_LCD_CS 12
#define PIN_LCD_SCLK 38
#define PIN_LCD_D0 4
#define PIN_LCD_D1 5
#define PIN_LCD_D2 6
#define PIN_LCD_D3 7
#define PIN_LCD_RST 39
#define PIN_I2C_SDA 15
#define PIN_I2C_SCL 14
#define PIN_TP_INT 11
#define PIN_TP_RST 40
#define PIN_LINK_RX 16              // 8 ピンヘッダの「IO16」 ← XIAO「D6」
#define PIN_GPS_RX 17               // 8 ピンヘッダの「IO17」 ← M100 の送信(UBX・NMEA が来る線)。2.14.4: 10/31 の試験で確定
#define PIN_GPS_TX 18               // 8 ピンヘッダの「IO18」 → M100 の受信(M100 の設定を送る線。普通の出力)。2.14.4: 10/31 の試験で確定
#define LCD_SPI_HZ 40000000         // 公式の例と同じ 40 MHz
#define LCD_COL_OFFSET 6            // 公式の例と同じ(画面の左端がコントローラーの 6 列目)
