katsuhaa/abarth595-round-gauge/meter_display/app.cpp

// app.cpp - 受信データの解釈(mlink)、車の CAN から値を作る(veh)、CAN の表(cantab)、全開と走行の時間(trip)。説明は app.h
#include "app.h"
#include <string.h>
#include <stdlib.h>
#include <algorithm>
#include <math.h>

// ================================================================ mlink
namespace mlink {

static uint8_t g_buf[192];
static int g_len = 0;

static MlSignals g_sig;
static bool g_sigSeen = false;
static uint32_t g_sigMs = 0;

static LinkStats g_st;
static uint32_t g_infoMs = 0;
static bool g_haveSeq = false;
static uint8_t g_lastSeq = 0;
static uint32_t g_lastGoodMs = 0;
static bool g_anySeen = false;  // 何かの正しいフレームを受けた(値のフレームが来ないとき、getSignals の linkUp に使う)
static uint32_t g_tickMs = 0, g_tickFrames = 0;
static uint32_t g_rxBytes = 0, g_tickBytes = 0;
static volatile bool g_graceOn = false;
static volatile uint32_t g_graceUntil = 0;

void graceUntil(uint32_t untilMs) {
  g_graceUntil = untilMs;
  g_graceOn = true;
}
static bool inGrace(uint32_t nowMs) {
  if (!g_graceOn) return false;
  if ((int32_t)(nowMs - g_graceUntil) >= 0) {
    g_graceOn = false;
    return false;
  }
  return true;
}

// 速度の自動合わせ
static const uint32_t BAUDS[] = METER_LINK_BAUD_CANDIDATES;
static const int N_BAUDS = sizeof(BAUDS) / sizeof(BAUDS[0]);
static int g_abIdx = 0;
static bool g_abStarted = false;
static uint32_t g_abWinMs = 0, g_abWinRx = 0, g_abWinGood = 0;
static int g_abBadWins = 0;

void begin() {
  g_len = 0;
  g_sigSeen = false;
  g_haveSeq = false;
  g_anySeen = false;
  g_tickMs = 0;
  g_tickFrames = 0;
  g_rxBytes = 0;
  g_tickBytes = 0;
  g_graceOn = false;
  g_abIdx = 0;
  g_abStarted = false;
  g_abBadWins = 0;
  memset(&g_st, 0, sizeof(g_st));
  g_st.baud = BAUDS[0];
}

// 種類と長さの組み合わせが、決めた形に合っているか
static bool plausible(uint8_t type, uint8_t len, const uint8_t *payload) {
  switch (type) {
    case ML_TYPE_SIGNALS: return len == sizeof(MlSignals);
    case ML_TYPE_INFO: return len == sizeof(MlInfo);
    case ML_TYPE_CAN: return len >= sizeof(MlCanHead) && (payload[0] & 0x0F) <= 8 && len == sizeof(MlCanHead) + (payload[0] & 0x0F);
    default: return false;
  }
}

static void handle(uint8_t type, uint8_t seq, const uint8_t *p, uint32_t nowMs) {
  platLock();
  if (g_haveSeq && (uint32_t)(nowMs - g_lastGoodMs) <= LINK_TIMEOUT_MS && !inGrace(nowMs)) {
    g_st.lostFrames += (uint8_t)(seq - g_lastSeq - 1);
  }
  g_haveSeq = true;
  g_lastSeq = seq;
  g_lastGoodMs = nowMs;
  g_anySeen = true;
  g_st.framesOk++;
  if (type == ML_TYPE_SIGNALS) {
    memcpy(&g_sig, p, sizeof(g_sig));
    g_sigSeen = true;
    g_sigMs = nowMs;
  } else if (type == ML_TYPE_INFO) {
    memcpy(&g_st.info, p, sizeof(MlInfo));
    g_st.info.name[sizeof(g_st.info.name) - 1] = 0;
    for (char *c = g_st.info.name; *c; c++) {  // 画面に出せる文字(ASCII)だけにする
      if (*c < 0x20 || *c > 0x7E) *c = '?';
    }
    g_st.infoValid = true;
    g_infoMs = nowMs;
  }
  platUnlock();
  if (type == ML_TYPE_CAN) {
    MlCanHead h;
    memcpy(&h, p, sizeof(h));
    cantab::onFrame((h.info >> 7) & 1, (h.info >> 6) & 1, h.id, h.info & 0x0F, p + sizeof(h), nowMs);
    platCanFrame((h.info >> 7) & 1, (h.info >> 6) & 1, h.id, h.info & 0x0F, p + sizeof(h), nowMs);
    veh::onFrame((h.info >> 7) & 1, (h.info >> 6) & 1, h.id, h.info & 0x0F, p + sizeof(h), nowMs);
  }
}

void feed(const uint8_t *data, size_t n, uint32_t nowMs) {
  g_rxBytes += (uint32_t)n;
  while (n > 0) {
    size_t room = sizeof(g_buf) - (size_t)g_len;
    size_t take = n < room ? n : room;
    memcpy(g_buf + g_len, data, take);
    g_len += (int)take;
    data += take;
    n -= take;

    int i = 0;
    for (;;) {
      while (i + 1 < g_len && !(g_buf[i] == ML_SYNC0 && g_buf[i + 1] == ML_SYNC1)) {
        i++;
        g_st.junkBytes++;
      }
      if (g_len - i < 5) break;  // 種類・連番・長さまでそろうのを待つ
      uint8_t type = g_buf[i + 2], seq = g_buf[i + 3], len = g_buf[i + 4];
      if (len > ML_MAX_PAYLOAD) {
        i++;
        g_st.junkBytes++;
        continue;
      }
      int total = (int)len + ML_OVERHEAD;
      if (g_len - i < total) break;  // 残りが届くのを待つ
      if (!plausible(type, len, g_buf + i + 5)) {
        i++;
        g_st.junkBytes++;
        continue;
      }
      uint16_t crc = mlCrc16(g_buf + i + 2, (size_t)len + 3);
      uint16_t got = (uint16_t)(g_buf[i + 5 + len] | (g_buf[i + 6 + len] << 8));
      if (crc == got) {
        handle(type, seq, g_buf + i + 5, nowMs);
        i += total;
      } else {
        if (!inGrace(nowMs)) g_st.crcErrors++;
        i++;  // 同期の 1 バイト目だけを捨てて探し直す(続きに正しいフレームがあれば拾える)
      }
    }
    if (i > 0) {
      memmove(g_buf, g_buf + i, (size_t)(g_len - i));
      g_len -= i;
    }
  }
}

void tick(uint32_t nowMs) {
  if ((uint32_t)(nowMs - g_tickMs) >= 1000) {
    g_tickMs = nowMs;
    g_st.framesPerSec = g_st.framesOk - g_tickFrames;
    g_tickFrames = g_st.framesOk;
    g_st.bytesPerSec = g_rxBytes - g_tickBytes;
    g_tickBytes = g_rxBytes;
    if (g_st.infoValid && (uint32_t)(nowMs - g_infoMs) > 3000) g_st.infoValid = false;
    // 長く途切れた値は「見ていない」に戻す(getSignals が時刻の差を符号つきで見るので、古いまま残さない)
    if (g_sigSeen && (uint32_t)(nowMs - g_sigMs) > 2 * LINK_TIMEOUT_MS) {
      platLock();
      g_sigSeen = false;
      platUnlock();
    }
    if (g_anySeen && (uint32_t)(nowMs - g_lastGoodMs) > 2 * LINK_TIMEOUT_MS) {
      platLock();
      g_anySeen = false;
      platUnlock();
    }
  }
}

void resyncSeq() {
  platLock();
  g_haveSeq = false;
  g_len = 0;
  platUnlock();
}

uint32_t baud() {
  return BAUDS[g_abIdx];
}

uint32_t autoBaud(uint32_t nowMs, size_t rxBytes) {
  if (!g_abStarted) {
    g_abStarted = true;
    g_abWinMs = nowMs;
    g_abWinRx = 0;
    g_abWinGood = g_st.framesOk;
    g_abBadWins = 0;
  }
  g_abWinRx += (uint32_t)rxBytes;
  bool locked = g_haveSeq && (uint32_t)(nowMs - g_lastGoodMs) <= LINK_TIMEOUT_MS;
  uint32_t next = 0;
  if ((uint32_t)(nowMs - g_abWinMs) >= LINK_BAUD_WINDOW_MS) {
    // この区間に、バイトは届いたのに正しいフレームが 1 つも無かったか
    bool bad = g_abWinRx >= LINK_BAUD_MIN_BYTES && g_st.framesOk == g_abWinGood;
    g_abBadWins = bad ? g_abBadWins + 1 : 0;
    g_abWinMs = nowMs;
    g_abWinRx = 0;
    g_abWinGood = g_st.framesOk;
    if (g_abBadWins >= LINK_BAUD_BAD_WINDOWS) {
      g_abBadWins = 0;
      g_abIdx = (g_abIdx + 1) % N_BAUDS;
      g_len = 0;  // 前の速度で読んだ途中のバイトは捨てる
      next = BAUDS[g_abIdx];
      locked = false;
    }
  }
  platLock();
  g_st.baud = BAUDS[g_abIdx];
  g_st.locked = locked;
  platUnlock();
  return next;
}

// 値のフレームが LINK_TIMEOUT_MS 以内に届いているか(platLock の中で呼ぶ)。
// 時刻は受信タスクが付けたもの。呼び出し側が nowMs を読んだあとに届いたフレームだと nowMs より新しい(差が負)
static bool sigUpLocked(uint32_t nowMs) {
  return g_sigSeen && (int32_t)(nowMs - g_sigMs) <= (int32_t)LINK_TIMEOUT_MS;
}
static bool anyUpLocked(uint32_t nowMs) {
  return g_anySeen && (int32_t)(nowMs - g_lastGoodMs) <= (int32_t)LINK_TIMEOUT_MS;
}

bool usingRaw(uint32_t nowMs) {
  platLock();
  bool raw = !sigUpLocked(nowMs) && anyUpLocked(nowMs);
  platUnlock();
  return raw;
}

void getSignals(Signals *out, uint32_t nowMs) {
  MlSignals s;
  bool sigUp, anyUp;
  platLock();
  s = g_sig;
  sigUp = sigUpLocked(nowMs);
  anyUp = anyUpLocked(nowMs);
  platUnlock();
  memset(out, 0, sizeof(*out));
  if (!sigUp) {
    // 値のフレームが来ていない(2.0.0 の c6_can_link は送らない): CAN の生データから作る(veh)
    out->linkUp = anyUp;
    if (anyUp) veh::getSignals(out, nowMs);
    return;
  }
  out->linkUp = true;
  out->rpmOk = s.valid & ML_V_RPM;
  out->speedOk = s.valid & ML_V_SPEED;
  out->throttleOk = s.valid & ML_V_THROTTLE;
  out->waterOk = s.valid & ML_V_WATER;
  out->fuelOk = s.valid & ML_V_FUEL;
  out->boostOk = s.valid & ML_V_BOOST;
  // ギアは、表示できる文字('1'〜'9'、'N'、'R')のときだけ使う。それ以外は「分からない」
  out->gearOk = (s.valid & ML_V_GEAR) && ((s.gear >= '1' && s.gear <= '9') || s.gear == 'N' || s.gear == 'R');
  out->rpm = s.rpm;
  out->speedKmh = s.speed_c / 100.0f;
  out->throttlePct = s.throttle_h / 2.0f;
  out->waterC = s.water_d / 10.0f;
  out->fuelPct = s.fuel_h / 2.0f;
  out->boostBar = s.boost_c / 100.0f;
  out->gear = s.gear;
  out->sim = s.flags & ML_F_SIM;
  out->scene = s.scene;
}

void getStats(LinkStats *out) {
  platLock();
  *out = g_st;
  platUnlock();
}

}  // namespace mlink

// ================================================================ veh(config.h の VEH_*。c6_can_link 1.1.0 の decode・decodeB・updateGear・sendSignals を移した)
namespace veh {

struct State {
  uint16_t rpm;
  uint8_t accel;          // 0〜255
  uint16_t speedRaw;      // km/h × 128
  bool clutch;
  int water;              // ℃
  uint8_t boostRaw;       // 0A1CA001 b2(そのまま。2.8.0。2.7.0 までは 0A18A001 b4 = 燃料の量だった)
  bool reverse;           // R に入っている
  uint32_t rpmMs, speedMs, clutchMs, engMs, boostMs;  // 最後に受けた時刻(0 = まだ)
  // 燃料(2.7.0: 0A18A000 b5 = %)
  uint32_t fuelSeenMs;    // 0A18A000 を最後に受けた時刻(b5 = 0 も含む)
  uint8_t fuelPct;        // 最後に使った値 [%]
  uint8_t fuelLastB5;     // 最後に受けた b5(0 も含む)
  bool fuelHave;          // fuelPct に値がある
  uint32_t fuelIgnored;   // 捨てた b5(0 と 100 超)のフレームの数
  // ライト(2.9.0: B-CAN 06214000 b0 の 0x08 = ライトのスイッチ)
  bool sport;             // スポーツモード(0A18A000 b4 の VEH_SPORT_MASK。2.11.0。受けた時刻は fuelSeenMs)
  uint32_t lightSeenMs;   // 最後に受けた時刻(0 = まだ)
  uint32_t lightFirstMs;  // 最初に受けた時刻(電源を入れてからの ms)
  uint8_t lightLastB0;    // 最後に受けた b0
  bool lightOn;           // ライトのスイッチ(使っている値)
  bool lightPend;         // lightOn と違う値を受けて、VEH_LIGHT_SETTLE_MS 待っている
  uint32_t lightPendMs;   // その値を最初に受けた時刻
  uint32_t lightChanges;  // 切り替えた回数(最初の値は数えない)
  // ODO(2.15.0: B-CAN 0C014003)
  bool odoHave;           // 使える値を受けた
  uint32_t odoKm;         // 使っている値
  uint32_t odoMs;         // 使える値を最後に受けた時刻
  uint32_t odoRejected;   // 捨てた値のフレームの数
  uint32_t odoCand;       // 捨てた値(同じ値が続いた数を数える)
  uint16_t odoCandN;
};
static State g;              // 受信タスクが書き、loop() が読む(platLock で守る)
static char g_gear = 0;      // 推定したギア('1'〜'5'、'N'、0 = 分からない)。getSignals だけが使う
static float g_lastRatio = 0;

static inline uint32_t stamp(uint32_t t) {  // 時刻 0 は「まだ」に使うので、0 は 1 にする
  return t ? t : 1;
}
// t が timeout 以内か。受信タスクの時刻が now より新しいことがある(差が負)
static bool within(uint32_t t, uint32_t now, uint32_t timeout) {
  return t && (int32_t)(now - t) <= (int32_t)timeout;
}

void begin() {
  platLock();
  memset(&g, 0, sizeof(g));
  platUnlock();
  g_gear = 0;
  g_lastRatio = 0;
}

// ライト: lightOn と違う値を受けてから VEH_LIGHT_SETTLE_MS のあいだに元の値を受けなければ、切り替える(platLock の中で呼ぶ。
// 次のフレームを待たずに切り替わるよう、lightInfo からも呼ぶ)。受信タスクの時刻が now より新しいとき(差が負)は待つ
static void lightSettle(uint32_t now) {
  if (g.lightPend && (int32_t)(now - g.lightPendMs) >= (int32_t)VEH_LIGHT_SETTLE_MS) {
    g.lightOn = !g.lightOn;
    g.lightPend = false;
    g.lightChanges++;
  }
}

void onFrame(uint8_t bus, uint8_t ext, uint32_t id, uint8_t dlc, const uint8_t *d, uint32_t now) {
  if (!ext) return;  // 使う値はどれも 29 ビット ID
  if (bus == 1) {
    if (id == VEH_ID_LIGHT && dlc > VEH_LIGHT_BYTE) {  // ライト(2.9.0)。b0 のほかのビットは見ない
      const bool on = (d[VEH_LIGHT_BYTE] & VEH_LIGHT_MASK) != 0;
      platLock();
      if (!g.lightSeenMs) {  // 電源を入れてから最初: すぐ使う
        g.lightOn = on;
        g.lightFirstMs = stamp(now);
      } else {
        lightSettle(now);
        if (on == g.lightOn) {
          g.lightPend = false;  // 元の値: 待っていた切り替えはやめる
        } else if (!g.lightPend) {
          g.lightPend = true;
          g.lightPendMs = stamp(now);
        }
      }
      g.lightLastB0 = d[VEH_LIGHT_BYTE];
      g.lightSeenMs = stamp(now);
      platUnlock();
    } else if (id == VEH_ID_ODO && dlc >= 4) {  // ODO(2.15.0)。b1 の下位 4 ビット + b2 + b3 = km
      const uint32_t km = ((uint32_t)(d[1] & 0x0F) << 16) | ((uint32_t)d[2] << 8) | d[3];
      platLock();
      if (!g.odoHave || (km >= g.odoKm && km - g.odoKm <= (uint32_t)ODO_MAX_JUMP_KM)) {
        g.odoKm = km;
        g.odoHave = true;
        g.odoMs = stamp(now);
        g.odoCandN = 0;
      } else {
        g.odoRejected++;
        // 同じ値が ODO_ACCEPT_REPEAT 回続いたら使う(最初に受けた値が壊れていたとき・ODO が本当に変わったとき)
        if (g.odoCandN && km == g.odoCand) g.odoCandN++;
        else g.odoCand = km, g.odoCandN = 1;
        if (g.odoCandN >= ODO_ACCEPT_REPEAT) {
          g.odoKm = km;
          g.odoMs = stamp(now);
          g.odoCandN = 0;
        }
      }
      platUnlock();
    }
    return;
  }
  if (bus == 0) {
    if (id == VEH_ID_RPM_ACCEL && dlc >= 8) {
      platLock();
      g.rpm = (uint16_t)(((uint16_t)d[2] << 8) | d[3]);
      g.accel = d[7];
      g.rpmMs = stamp(now);
      platUnlock();
    } else if (id == VEH_ID_SPEED && dlc >= 6) {
      platLock();
      g.speedRaw = (uint16_t)(((uint16_t)d[4] << 8) | d[5]);
      g.speedMs = stamp(now);
      platUnlock();
    } else if (id == VEH_ID_CLUTCH && dlc >= 6) {
      platLock();
      g.clutch = (d[5] & 0x20) != 0;
      g.clutchMs = stamp(now);
      platUnlock();
    } else if (id == VEH_ID_ENGINE && dlc >= 8) {
      platLock();
      g.water = (int)d[3] - 40;
      g.reverse = (d[7] & VEH_REVERSE_MASK) != 0;
      g.engMs = stamp(now);
      platUnlock();
    } else if (id == VEH_ID_BOOST && dlc >= 3) {
      platLock();
      g.boostRaw = d[2];
      g.boostMs = stamp(now);
      platUnlock();
    } else if (id == VEH_ID_FUEL && dlc >= 6) {
      platLock();
      g.fuelSeenMs = stamp(now);
      g.fuelLastB5 = d[5];
      g.sport = (d[4] & VEH_SPORT_MASK) != 0;  // 2.11.0
      if (d[5] == 0 || d[5] > 100) {
        g.fuelIgnored++;  // 0 = 測れていない(エンジンが止まっている間など)。前の値のまま
      } else {
        g.fuelPct = d[5];
        g.fuelHave = true;
      }
      platUnlock();
    }
  }
}

// ---- ギアの推定(c6_can_link 1.1.0 の updateGear と同じ)
// rpm ÷ km/h の計算値。1 km/h = 1000 m/h → タイヤ 1000/外周 回転/h → ÷60 回転/分 × 減速比
static float rpmPerKmh(int gear) {
  static const float RATIO[5] = VEH_GEAR_RATIOS;
  return RATIO[gear] * VEH_FINAL_DRIVE * (1000.0f / VEH_TIRE_CIRC_M) / 60.0f;
}
static void updateGear(bool rpmOk, bool speedOk, bool clutchOk, const State &r) {
  if (!rpmOk || !speedOk) {
    g_gear = 0;
    return;
  }
  float kmh = r.speedRaw / 128.0f;
  if (kmh < VEH_STOP_KMH) {
    g_gear = 'N';
    return;
  }
  if (kmh < VEH_GEAR_MIN_KMH || r.rpm < VEH_GEAR_MIN_RPM) return;  // 遅いときは前の値のまま
  if (VEH_GEAR_HOLD_ON_CLUTCH && clutchOk && r.clutch) return;    // クラッチを踏んでいる間は前の値のまま(VEH_GEAR_HOLD_ON_CLUTCH 1 のとき)
  (void)clutchOk;
  float ratio = r.rpm / kmh;
  g_lastRatio = ratio;
  for (int k = 0; k < 5; k++) {
    float ref = rpmPerKmh(k);
    if (ratio >= ref * (1.0f - VEH_GEAR_TOL_PCT / 100.0f) && ratio <= ref * (1.0f + VEH_GEAR_TOL_PCT / 100.0f)) {
      g_gear = (char)('1' + k);
      return;
    }
  }
  g_gear = 0;  // どのギアにも合わない(変速の途中など)
}

void getSignals(Signals *out, uint32_t now) {
  State r;
  platLock();
  r = g;
  platUnlock();
  bool rpmOk = within(r.rpmMs, now, VEH_TIMEOUT_MS);
  bool speedOk = within(r.speedMs, now, VEH_TIMEOUT_MS);
  bool clutchOk = within(r.clutchMs, now, VEH_TIMEOUT_MS);
  bool waterOk = within(r.engMs, now, VEH_WATER_TIMEOUT_MS);
  bool engOk = within(r.engMs, now, VEH_TIMEOUT_MS);  // 0A18A001(リバース)が届いている
  bool boostOk = within(r.boostMs, now, VEH_TIMEOUT_MS);  // 0A1CA001(ブースト)が届いている
  bool fuelOk = r.fuelHave && within(r.fuelSeenMs, now, VEH_FUEL_TIMEOUT_MS);
  updateGear(rpmOk, speedOk, clutchOk, r);
  char gear = (engOk && r.reverse) ? 'R' : g_gear;  // R のビットは推定より優先

  // 値の刻みは 1.x の c6_can_link が値のフレームで送っていたときと同じにする(表示と判定が変わらないように)
  out->rpmOk = rpmOk;
  out->throttleOk = rpmOk;
  out->speedOk = speedOk;
  out->waterOk = waterOk;
  out->boostOk = boostOk;
  out->fuelOk = fuelOk;
  out->gearOk = gear != 0;
  out->rpm = r.rpm;
  out->speedKmh = (uint16_t)((uint32_t)r.speedRaw * 100 / 128) / 100.0f;
  out->throttlePct = (uint8_t)(((uint32_t)r.accel * 200 + 127) / 255) / 2.0f;
  int w = r.water < -3276 ? -3276 : (r.water > 3276 ? 3276 : r.water);
  out->waterC = (int16_t)(w * 10) / 10.0f;
  out->fuelPct = r.fuelPct;
  int bc = (int)(r.boostRaw * VEH_BOOST_BAR_PER_LSB * 100.0f + 0.5f);
  out->boostBar = (int16_t)(bc > 32767 ? 32767 : bc) / 100.0f;
  out->gear = gear;
  out->sportOk = within(r.fuelSeenMs, now, VEH_FUEL_TIMEOUT_MS);  // 2.11.0: 0A18A000 を受けている
  out->sport = out->sportOk && r.sport;
}

void fuelInfo(FuelInfo *out, uint32_t now) {
  platLock();
  out->seen = within(g.fuelSeenMs, now, VEH_FUEL_TIMEOUT_MS);
  out->have = g.fuelHave;
  out->pct = g.fuelPct;
  out->lastB5 = g.fuelLastB5;
  out->ignored = g.fuelIgnored;
  platUnlock();
}

float lastRatio() {
  return g_lastRatio;
}

void lightInfo(LightInfo *out, uint32_t now) {
  platLock();
  lightSettle(now);
  out->have = g.lightSeenMs != 0;
  out->seen = within(g.lightSeenMs, now, VEH_LIGHT_TIMEOUT_MS);
  out->on = g.lightOn;
  out->lastB0 = g.lightLastB0;
  out->firstMs = g.lightFirstMs;
  out->changes = g.lightChanges;
  platUnlock();
}

void odoInfo(OdoInfo *out, uint32_t now) {
  platLock();
  out->have = g.odoHave;
  out->seen = g.odoHave && within(g.odoMs, now, ODO_STALE_MS);
  out->km = g.odoKm;
  out->rejected = g.odoRejected;
  platUnlock();
}

}  // namespace veh

// ================================================================ bright(画面の明るさ。2.9.0)
namespace bright {

int normalPct(const Settings &s, bool lightOn) {
  return lightOn ? s.illumPct : s.brightnessPct;
}

int panelPct(uint8_t level, int normal) {
  return level == BL_OFF ? 0 : level == BL_MAX ? 100 : normal;
}

}  // namespace bright

// ================================================================ cantab
namespace cantab {

struct Entry {
  uint32_t id;
  uint8_t bus, ext, dlc;
  uint8_t cand;           // 候補のバイトの印(bit b = バイト b)。記録 0 回のときは使わない
  uint8_t data[8];
  uint8_t base[8];        // 前の記録の値
  uint16_t changes[8];    // 前の記録から変わった回数
  uint8_t hist[8][CAN_HIST_SAMPLES];
  // 前後で比べるの記録中(2.16.0): 記録を始めてから最初に受けた値、それから変わったビット、受けた回数、長さ
  uint8_t wFirst[8];
  uint8_t wTog[8];
  uint16_t wCnt;
  uint8_t wDlc;
};

static Entry *g_e = nullptr;
static int g_n = 0;
static int g_histPos = 0, g_histCount = 0;
static uint32_t g_sampleMs = 0;
static int g_rec = 0;                    // 記録した回数
static int g_recHist[CAN_REC_HIST];      // 件数の移り変わり(新しいものが最後)
static int g_recHistN = 0;
static bool g_firstSeen = false;         // begin のあとにフレームを受けた(2.6.0)
static uint32_t g_firstMs = 0;           // 最初のフレームを受けた時刻(2.6.0。前後で比べるのは CAN_PP_SETTLE_MS たってから)

// ---- 前後で比べる(2.6.0。2.16.0 で作り直し)。記録は、この形のまま NVS に書く(PpHead のあとに PpRec が n 個)
struct PpHead {
  uint16_t magic;  // PP_MAGIC
  uint8_t ver;     // PP_VER
  uint8_t nHist;   // hist に入れた数
  uint16_t n;      // PpRec の数
  uint8_t nPre;    // 前を記録した回数
  uint8_t nPost;   // 後を記録した回数
  uint16_t hist[CAN_REC_HIST];  // 件数の移り変わり(古い順。後を記録してからの記録ごと)
};
struct PpRec {
  uint32_t id;
  uint8_t bus, ext, dlc;
  uint8_t seenPre, seenPost;  // その ID を受けた、前・後の記録の回数
  uint8_t pad[3];
  uint8_t cand[8];  // 候補のビット(バイトごと)。毎回の記録の間ずっと変わらず、前では ref と同じ、後では ref の逆だったビット
  uint8_t ref[8];   // 1 回目の前の値
  uint8_t post[8];  // 1 回目の後の値(一覧に出す)
};
static const uint16_t PP_MAGIC = 0x5050;
static const uint8_t PP_VER = 2;  // 2.16.0(1 = 2.6.0〜2.15.x の前の記録。読み戻さない)
static const size_t PP_BYTES = sizeof(PpHead) + sizeof(PpRec) * CAN_MAX_IDS;
static uint8_t *g_ppBuf = nullptr;  // 記録(PP_BYTES)
static bool g_ppRec = false;        // 記録中
static bool g_ppRecPost = false;    // 記録中のものは「後」
static uint32_t g_ppRecStart = 0;   // 記録を始めた時刻
static uint32_t g_ppRecFrames = 0;  // 記録中に受けたフレームの数(0 なら数に入れない)

static PpHead *ppHead() {
  return (PpHead *)g_ppBuf;
}
static PpRec *ppRecs() {
  return (PpRec *)(g_ppBuf + sizeof(PpHead));
}
static void ppReset() {  // 記録を空にする(保存はしない)
  memset(g_ppBuf, 0, PP_BYTES);
  ppHead()->magic = PP_MAGIC;
  ppHead()->ver = PP_VER;
}
static bool ppBuf() {  // 記録の置き場所を用意する(できなければ false)
  if (!g_ppBuf) {
    g_ppBuf = (uint8_t *)platAlloc(PP_BYTES);
    if (g_ppBuf) ppReset();
  }
  return g_ppBuf != nullptr;
}
static void ppLoad() {  // 保存した記録を読み戻す(begin から)。形が違う(2.15.x までの前の記録など)ときは空にする
  if (!ppBuf()) return;
  const size_t n = platLoadCanPre(g_ppBuf, PP_BYTES);
  const PpHead *h = ppHead();
  const bool ok = n >= sizeof(PpHead) && h->magic == PP_MAGIC && h->ver == PP_VER && h->n <= CAN_MAX_IDS && h->nHist <= CAN_REC_HIST &&
                  n == sizeof(PpHead) + sizeof(PpRec) * h->n;
  if (!ok) ppReset();
}

void begin() {
  if (!g_e) g_e = (Entry *)platAlloc(sizeof(Entry) * CAN_MAX_IDS);
  g_n = 0;
  g_histPos = 0;
  g_histCount = 0;
  g_rec = 0;
  g_recHistN = 0;
  g_firstSeen = false;
  g_ppRec = false;
  ppLoad();
}

void onFrame(uint8_t bus, uint8_t ext, uint32_t id, uint8_t dlc, const uint8_t *data, uint32_t nowMs) {
  if (!g_e) return;
  if (dlc > 8) dlc = 8;
  platLock();
  if (!g_firstSeen) {
    g_firstSeen = true;
    g_firstMs = nowMs;
  }
  int i = 0;
  while (i < g_n && !(g_e[i].id == id && g_e[i].bus == bus && g_e[i].ext == ext)) i++;
  if (i == g_n) {
    if (g_n >= CAN_MAX_IDS) {
      platUnlock();
      return;
    }
    Entry &e = g_e[g_n++];
    memset(&e, 0, sizeof(e));
    e.id = id;
    e.bus = bus;
    e.ext = ext;
    e.dlc = dlc;
    memcpy(e.data, data, dlc);
    memcpy(e.base, e.data, 8);  // 初めて見たときの値を基準にする
    e.cand = 0;                 // 記録を始めたあとに初めて見た ID は候補にしない
    for (int b = 0; b < 8; b++) memset(e.hist[b], e.data[b], CAN_HIST_SAMPLES);
  } else {
    Entry &e = g_e[i];
    for (int b = 0; b < dlc; b++) {
      if (e.data[b] != data[b]) {
        e.data[b] = data[b];
        if (e.changes[b] < 0xFFFF) e.changes[b]++;
      }
    }
    e.dlc = dlc;
  }
  if (g_ppRec) {  // 前後で比べるの記録中(2.16.0): 最初の値と、それから変わったビット
    Entry &e = g_e[i];
    if (e.wCnt == 0) {
      memset(e.wFirst, 0, 8);
      memcpy(e.wFirst, data, dlc);
      e.wDlc = dlc;
    } else {
      const int nb = dlc < e.wDlc ? dlc : e.wDlc;
      for (int b = 0; b < nb; b++) e.wTog[b] |= (uint8_t)(e.wFirst[b] ^ data[b]);
      if (dlc != e.wDlc) {  // 長さが変わった: 長い方にしかないバイトは変わったものとして、短い方にそろえる
        const int nx = dlc > e.wDlc ? dlc : e.wDlc;
        for (int b = nb; b < nx; b++) e.wTog[b] = 0xFF;
        e.wDlc = (uint8_t)nb;
      }
    }
    if (e.wCnt < 0xFFFF) e.wCnt++;
    g_ppRecFrames++;
  }
  platUnlock();
}

void tick(uint32_t nowMs) {
  if (!g_e || (uint32_t)(nowMs - g_sampleMs) < CAN_HIST_INTERVAL_MS) return;
  g_sampleMs = nowMs;
  platLock();
  for (int i = 0; i < g_n; i++) {
    for (int b = 0; b < 8; b++) g_e[i].hist[b][g_histPos] = g_e[i].data[b];
  }
  g_histPos = (g_histPos + 1) % CAN_HIST_SAMPLES;
  if (g_histCount < CAN_HIST_SAMPLES) g_histCount++;
  platUnlock();
}

int count() {
  return g_n;
}

static int candCountLocked() {
  int n = 0;
  for (int i = 0; i < g_n; i++) n += g_e[i].cand ? 1 : 0;
  return n;
}

int record() {
  if (!g_e) return 0;
  platLock();
  for (int i = 0; i < g_n; i++) {
    Entry &e = g_e[i];
    const uint8_t all = (uint8_t)((1u << e.dlc) - 1u);
    if (g_rec == 0) {
      e.cand = all;  // 1 回目: 全部が候補
    } else {
      uint8_t keep = 0;
      for (int b = 0; b < e.dlc; b++) {
        if ((e.cand >> b & 1) && e.data[b] != e.base[b] && e.changes[b] >= 1 && e.changes[b] <= CAN_REC_MAX_CHANGES) keep |= (uint8_t)(1u << b);
      }
      e.cand = keep;
    }
    memcpy(e.base, e.data, 8);
    memset(e.changes, 0, sizeof(e.changes));
  }
  g_rec++;
  int n = candCountLocked();
  if (g_recHistN == CAN_REC_HIST) {
    memmove(g_recHist, g_recHist + 1, sizeof(int) * (CAN_REC_HIST - 1));
    g_recHistN--;
  }
  g_recHist[g_recHistN++] = n;
  platUnlock();
  return n;
}

void clearRecord() {
  if (!g_e) return;
  platLock();
  for (int i = 0; i < g_n; i++) g_e[i].cand = 0;
  g_rec = 0;
  g_recHistN = 0;
  platUnlock();
}

int recordCount() {
  return g_rec;
}

int recordHistory(int *out) {
  platLock();
  int n = g_recHistN;
  memcpy(out, g_recHist, sizeof(int) * (size_t)n);
  platUnlock();
  return n;
}

int candidates(uint16_t *entries, uint8_t *masks, int maxOut) {
  if (!g_e || g_rec == 0) return 0;
  platLock();
  int n = 0;
  for (int i = 0; i < g_n; i++) {
    if (!g_e[i].cand) continue;
    if (n < maxOut) {
      entries[n] = (uint16_t)i;
      masks[n] = g_e[i].cand;
    }
    n++;
  }
  platUnlock();
  return n;
}

bool getView(int entry, View *out) {
  if (!g_e || entry < 0) return false;
  platLock();
  bool ok = entry < g_n;
  if (ok) {
    const Entry &e = g_e[entry];
    out->id = e.id;
    out->bus = e.bus;
    out->ext = e.ext;
    out->dlc = e.dlc;
    memcpy(out->data, e.data, 8);
    memcpy(out->base, e.base, 8);
  }
  platUnlock();
  return ok;
}

int getHistory(int entry, int byteIndex, uint8_t *out) {
  if (!g_e || entry < 0 || byteIndex < 0 || byteIndex > 7) return 0;
  platLock();
  int n = 0;
  if (entry < g_n) {
    n = g_histCount;
    int start = (g_histPos - n + CAN_HIST_SAMPLES) % CAN_HIST_SAMPLES;
    for (int i = 0; i < n; i++) out[i] = g_e[entry].hist[byteIndex][(start + i) % CAN_HIST_SAMPLES];
  }
  platUnlock();
  return n;
}

// ---- 前後で比べる(2.6.0。2.16.0 で作り直し)
int ppWaitMs(uint32_t nowMs) {
  if (!g_e || !g_firstSeen) return -1;
  const int32_t el = (int32_t)(nowMs - g_firstMs);  // 受信タスクの時刻が少し先のときは負
  if (el < 0) return CAN_PP_SETTLE_MS;
  return el >= CAN_PP_SETTLE_MS ? 0 : (int)(CAN_PP_SETTLE_MS - el);
}

bool ppRecording() {
  return g_ppRec;
}

int ppRecLeftMs(uint32_t nowMs) {
  if (!g_ppRec) return 0;
  const int32_t el = (int32_t)(nowMs - g_ppRecStart);
  if (el < 0) return CAN_PP_WIN_MS;
  return el >= CAN_PP_WIN_MS ? 0 : (int)(CAN_PP_WIN_MS - el);
}

int ppPreCount() {
  return g_ppBuf ? ppHead()->nPre : 0;
}

int ppPostCount() {
  return g_ppBuf ? ppHead()->nPost : 0;
}

bool ppNextIsPost() {
  return ppPreCount() > ppPostCount();
}

bool ppHasPre() {
  return ppPreCount() > 0;
}

bool ppHasResult() {
  return ppPostCount() > 0;
}

bool ppStart(uint32_t nowMs) {
  if (g_ppRec || ppWaitMs(nowMs) != 0 || !ppBuf()) return false;
  const PpHead *h = ppHead();
  if (h->nPre == 255 || h->nPost == 255) return false;  // 回数の上限(uint8_t で数えている)
  platLock();
  for (int i = 0; i < g_n; i++) {
    g_e[i].wCnt = 0;
    memset(g_e[i].wTog, 0, sizeof(g_e[i].wTog));
  }
  g_ppRecFrames = 0;
  g_ppRecPost = h->nPre > h->nPost;
  g_ppRecStart = nowMs;
  g_ppRec = true;
  platUnlock();
  return true;
}

static int ppFindRec(uint32_t id, uint8_t bus, uint8_t ext) {
  const PpHead *h = ppHead();
  const PpRec *r = ppRecs();
  for (int k = 0; k < h->n; k++)
    if (r[k].id == id && r[k].bus == bus && r[k].ext == ext) return k;
  return -1;
}

// 記録を数に入れる(platLock の中で呼ぶ)。post = 後の記録
static void ppMergeLocked(bool post) {
  PpHead *h = ppHead();
  PpRec *r = ppRecs();
  const bool first = h->nPre == 0 && h->nPost == 0;  // 1 回目の前: 受けた ID の、記録の間ずっと変わらなかったビットを全部候補にする
  const bool firstPost = post && h->nPost == 0;       // 1 回目の後: 一覧に出す値を取る
  static bool matched[CAN_MAX_IDS];
  memset(matched, 0, sizeof(matched));
  for (int i = 0; i < g_n; i++) {
    const Entry &e = g_e[i];
    int k = ppFindRec(e.id, e.bus, e.ext);
    bool created = false;
    if (k < 0) {
      if (h->n >= CAN_MAX_IDS) continue;
      k = h->n++;
      memset(&r[k], 0, sizeof(PpRec));
      r[k].id = e.id;
      r[k].bus = e.bus;
      r[k].ext = e.ext;
      r[k].dlc = e.wCnt ? e.wDlc : e.dlc;
      created = true;
    }
    matched[k] = true;
    PpRec &p = r[k];
    const bool seen = e.wCnt > 0;
    if (seen) {
      uint8_t &c = post ? p.seenPost : p.seenPre;
      if (c < 255) c++;
    }
    if (seen && firstPost) memcpy(p.post, e.wFirst, 8);
    if (first) {
      memset(p.cand, 0, sizeof(p.cand));
      if (seen) {
        for (int b = 0; b < e.wDlc; b++) p.cand[b] = (uint8_t)~e.wTog[b];
        memcpy(p.ref, e.wFirst, 8);
        p.dlc = e.wDlc;
      }
    } else if (created || !seen) {
      memset(p.cand, 0, sizeof(p.cand));  // 毎回の記録で受けた ID でなければ、ビットの候補にしない
    } else {
      const int nb = e.wDlc < p.dlc ? e.wDlc : p.dlc;
      for (int b = 0; b < 8; b++) {
        if (b >= nb) {
          p.cand[b] = 0;
          continue;
        }
        const uint8_t steady = (uint8_t)~e.wTog[b];
        const uint8_t diff = (uint8_t)(e.wFirst[b] ^ p.ref[b]);
        p.cand[b] &= (uint8_t)(steady & (post ? diff : (uint8_t)~diff));
      }
    }
  }
  for (int k = 0; k < h->n; k++)
    if (!matched[k]) memset(r[k].cand, 0, sizeof(r[k].cand));  // 電源を入れてから一度も受けていない ID
  if (post) h->nPost++;
  else h->nPre++;
}

bool ppPoll(uint32_t nowMs) {
  if (!g_ppRec || !g_ppBuf || ppRecLeftMs(nowMs) > 0) return false;
  bool counted = false;
  platLock();
  g_ppRec = false;
  if (g_ppRecFrames > 0) {  // 何も受けなかった記録は数に入れない(CANリーダーがつながっていない)
    ppMergeLocked(g_ppRecPost);
    counted = true;
  }
  platUnlock();
  if (!counted) return true;
  PpHead *h = ppHead();
  if (h->nPost > 0) {  // 件数の移り変わり(後を記録してから)
    if (h->nHist == CAN_REC_HIST) {
      memmove(h->hist, h->hist + 1, sizeof(h->hist[0]) * (CAN_REC_HIST - 1));
      h->nHist--;
    }
    const int c = ppResults(nullptr, 0);
    h->hist[h->nHist++] = (uint16_t)(c < 65535 ? c : 65535);
  }
  platSaveCanPre(g_ppBuf, sizeof(PpHead) + sizeof(PpRec) * (size_t)h->n);  // 書けなくても、電源を切るまでは使える
  return true;
}

static int ppFindEntryLocked(uint32_t id, uint8_t bus, uint8_t ext) {
  for (int i = 0; i < g_n; i++)
    if (g_e[i].id == id && g_e[i].bus == bus && g_e[i].ext == ext) return i;
  return -1;
}

int ppResults(PpResult *out, int maxOut) {
  if (!g_ppBuf) return 0;
  const PpHead *h = ppHead();
  const PpRec *r = ppRecs();
  if (h->nPre == 0 || h->nPost == 0) return 0;
  // 並べ方: C-CAN → B-CAN、ID の小さい順(記録の並びは見つけた順なので、毎回並べ直す)
  static uint8_t order[CAN_MAX_IDS];
  const int n = h->n;
  for (int k = 0; k < n; k++) order[k] = (uint8_t)k;
  for (int a = 1; a < n; a++) {
    const uint8_t t = order[a];
    int b = a;
    while (b > 0 && (r[order[b - 1]].bus > r[t].bus || (r[order[b - 1]].bus == r[t].bus && r[order[b - 1]].id > r[t].id))) {
      order[b] = order[b - 1];
      b--;
    }
    order[b] = t;
  }
  int total = 0;
  platLock();
  for (int a = 0; a < n; a++) {
    const PpRec &p = r[order[a]];
    PpResult q;
    memset(&q, 0, sizeof(q));
    q.id = p.id;
    q.bus = p.bus;
    q.ext = p.ext;
    q.entry = -1;
    int nq = 0;  // この ID の候補の数
    if (p.seenPre == h->nPre && p.seenPost == 0) {
      q.kind = PP_GONE;
      nq = 1;
    } else if (p.seenPre == 0 && p.seenPost == h->nPost) {
      q.kind = PP_NEW;
      nq = 1;
    } else {
      for (int b = 0; b < 8; b++) nq += p.cand[b] ? 1 : 0;
    }
    if (nq == 0) continue;
    if (out && total < maxOut) q.entry = (int16_t)ppFindEntryLocked(p.id, p.bus, p.ext);
    if (q.kind != PP_BITS) {
      if (out && total < maxOut) out[total] = q;
      total++;
      continue;
    }
    for (int b = 0; b < 8; b++) {
      if (!p.cand[b]) continue;
      q.byte = (uint8_t)b;
      q.mask = p.cand[b];
      q.pre = p.ref[b];
      q.post = p.post[b];
      if (out && total < maxOut) out[total] = q;
      total++;
    }
  }
  platUnlock();
  return total;
}

int ppHistory(int *out) {
  if (!g_ppBuf) return 0;
  const PpHead *h = ppHead();
  for (int i = 0; i < h->nHist; i++) out[i] = h->hist[i];
  return h->nHist;
}

void ppClear() {
  platLock();
  g_ppRec = false;
  platUnlock();
  if (g_ppBuf) ppReset();
  platSaveCanPre(nullptr, 0);
}

}  // namespace cantab

// ================================================================ trip
namespace trip {

static uint32_t g_lastMs = 0;
static bool g_started = false;
static uint32_t g_moving = 0, g_wot = 0;
static uint32_t g_above = 0, g_below = 0;

void update(const Signals &s, uint32_t nowMs, int rpm) {
  uint32_t dt = g_started ? (uint32_t)(nowMs - g_lastMs) : 0;
  g_started = true;
  g_lastMs = nowMs;
  if (dt > 500) dt = 500;  // 画面の切り替えなどで間が空いても、数えすぎない
  if (s.speedOk && s.speedKmh >= MOVING_SPEED_KMH) {
    g_moving += dt;
    if (s.throttleOk && s.throttlePct >= WOT_THROTTLE_PCT) g_wot += dt;
  }
  if (s.rpmOk) {  // 停止・走行に関係なく数える
    if (s.rpm >= rpm) g_above += dt;  // 2.12.0: 過負荷時間が増える所とそろえた(2.11.0 までは「超える」)
    else g_below += dt;
  }
}
uint32_t aboveMs() {
  return g_above;
}
uint32_t belowMs() {
  return g_below;
}
void setTimes(uint32_t above, uint32_t below) {
  g_above = above;
  g_below = below;
}
void resetTimes() {
  g_above = g_below = 0;
}
uint32_t movingMs() {
  return g_moving;
}
uint32_t wotMs() {
  return g_wot;
}

}  // namespace trip

// ================================================================ 設定の初期値(2.10.0。設定の「デフォルトに戻す」と起動時)
void settingsDefaults(Settings *s) {
  s->shiftRpm = SET_SHIFT_DEFAULT;
  s->autoReturnMin = SET_AUTORET_DEFAULT;
  s->brightnessPct = SET_BRIGHT_DEFAULT;
  s->warnTempC = SET_WARN_DEFAULT;
  s->demoOn = SET_DEMO_DEFAULT;
  s->rcOn = SET_RC_DEFAULT;
  s->illumPct = SET_ILLUM_DEFAULT;
  s->loadYellowMin = SET_LOADY_DEFAULT;
  s->loadRedMin = SET_LOADR_DEFAULT;
  s->loadResetMin = SET_LOADRS_DEFAULT;
  s->ringOne = SET_RING_DEFAULT;
  s->loadRpm = SET_LOADRPM_DEFAULT;
  s->maintHours = SET_MAINT_DEFAULT;
  s->fuelWarnPct = SET_FUELWARN_DEFAULT;  // 2.14.0
}

// ================================================================ odo(走行記録。2.15.0。説明は app.h。仕様書 odo_log_spec.md 第 3 版)
namespace odo {

static const uint16_t MAGIC = 0x4F44;  // "OD"
static const uint8_t VER = 1;
static const int SLOTS_PER_SECTOR = ODO_SECTOR_BYTES / ODO_REC_BYTES;

struct Rec {
  uint8_t reason;
  uint32_t seq;     // 通し番号(書くたびに +1)
  uint32_t utc;     // 書いた時刻
  int32_t day;      // 日付(日本時間の日数)
  uint32_t odo;     // 今の ODO
  uint32_t start;   // その日の始まりの ODO
  uint32_t aboveS;  // その日の過走行時間 [秒]
};
// 日ごとの表(PSRAM)。日 d は d % ODO_TABLE_DAYS の所。day1 = d + 1(0 = 空き)
struct DayEnt {
  int32_t day1;
  uint32_t seq;    // その値の記録の通し番号(いちばん新しい記録の値にする)
  uint32_t start;  // その日の始まりの ODO
  uint32_t odo;    // その日の最後の ODO
  uint32_t aboveS;
};

static DayEnt *g_tab = nullptr;
static uint8_t g_buf[ODO_SECTOR_BYTES];  // 起動時の読み込みと、消す前の数え
static bool g_storageOk = false;
static uint32_t g_slots = 0;        // 入る記録の数
static uint32_t g_pos = 0;          // 次に書く所(バイト)
static uint32_t g_seq = 0;          // 最後の通し番号
static uint32_t g_records = 0, g_writes = 0, g_failures = 0;
static int32_t g_earliest = 0;      // いちばん古い記録の日
static bool g_haveEarliest = false;
static bool g_haveLatest = false;   // 起動時に読んだいちばん新しい記録(今日の続きに使う)
static Rec g_latest;
static bool g_haveLast = false;     // 最後に書いた記録(状態の表示)
static Rec g_last;
// 今の日
static bool g_dayKnown = false;     // 今日が分かっている
static int32_t g_curDay = 0;
static bool g_startSet = false;     // その日の始まりの ODO がある
static uint32_t g_start = 0;
static uint32_t g_aboveMs = 0;      // その日の過走行時間 [ms](時刻が分かる前は起動からの分)
static bool g_aboveInit = false;
static uint32_t g_lastAbove = 0;    // 前の update の trip::aboveMs
static uint32_t g_cur = 0;          // 今の ODO
static bool g_wrote = false;        // この起動で書こうとした
static uint32_t g_lastWriteMs = 0;
static bool g_closePending = false; // 前の日の締めの記録を書く
static Rec g_close;
// 最後に書いた記録の値(増えたかの判定)
static bool g_lwHave = false;
static int32_t g_lwDay = 0;
static uint32_t g_lwOdo = 0, g_lwAbove = 0;

static void put16(uint8_t *p, uint16_t v) {
  p[0] = (uint8_t)v;
  p[1] = (uint8_t)(v >> 8);
}
static void put32(uint8_t *p, uint32_t v) {
  for (int i = 0; i < 4; i++) p[i] = (uint8_t)(v >> (8 * i));
}
static uint16_t get16(const uint8_t *p) {
  return (uint16_t)(p[0] | (p[1] << 8));
}
static uint32_t get32(const uint8_t *p) {
  return (uint32_t)p[0] | ((uint32_t)p[1] << 8) | ((uint32_t)p[2] << 16) | ((uint32_t)p[3] << 24);
}
static uint16_t crc16(const uint8_t *p, size_t n) {  // CRC-16/CCITT-FALSE
  uint16_t c = 0xFFFF;
  for (size_t i = 0; i < n; i++) {
    c ^= (uint16_t)p[i] << 8;
    for (int b = 0; b < 8; b++) c = (c & 0x8000) ? (uint16_t)((c << 1) ^ 0x1021) : (uint16_t)(c << 1);
  }
  return c;
}
// 32 バイト(仕様書 5 章): 印 2・版 1・きっかけ 1・通し番号 4・時刻 4・日付 2・ODO 4・始まりの ODO 4・過走行時間 4・予備 4(0xFF)・CRC 2
static void encode(const Rec &r, uint8_t *o) {
  memset(o, 0xFF, ODO_REC_BYTES);
  put16(o, MAGIC);
  o[2] = VER;
  o[3] = r.reason;
  put32(o + 4, r.seq);
  put32(o + 8, r.utc);
  put16(o + 12, (uint16_t)r.day);
  put32(o + 14, r.odo);
  put32(o + 18, r.start);
  put32(o + 22, r.aboveS);
  put16(o + 30, crc16(o, 30));
}
static bool decode(const uint8_t *in, Rec *r) {
  if (get16(in) != MAGIC || in[2] != VER || get16(in + 30) != crc16(in, 30)) return false;
  r->reason = in[3];
  r->seq = get32(in + 4);
  r->utc = get32(in + 8);
  r->day = get16(in + 12);
  r->odo = get32(in + 14);
  r->start = get32(in + 18);
  r->aboveS = get32(in + 22);
  return true;
}
static uint32_t recKm(const Rec &r) {
  return r.odo >= r.start ? r.odo - r.start : 0;
}
static DayEnt *slotOf(int32_t d) {
  if (!g_tab) return nullptr;
  int32_t i = d % ODO_TABLE_DAYS;
  if (i < 0) i += ODO_TABLE_DAYS;
  return &g_tab[i];
}
static void tabPut(int32_t d, uint32_t seq, uint32_t start, uint32_t odo, uint32_t aboveS) {
  DayEnt *e = slotOf(d);
  if (!e) return;
  if (e->day1 == d + 1) {
    if ((int32_t)(seq - e->seq) < 0) return;  // 古い記録
  } else if (e->day1 != 0 && e->day1 - 1 > d) {
    return;  // その所にはもっと新しい日がある
  }
  e->day1 = d + 1;
  e->seq = seq;
  e->start = start;
  e->odo = odo;
  e->aboveS = aboveS;
  if (!g_haveEarliest || d < g_earliest) g_earliest = d, g_haveEarliest = true;
}
static int32_t dayOf(uint32_t utc) {
  return (int32_t)(((uint64_t)utc + CLOCK_TZ_SEC) / 86400u);
}
// 区切り off の正しい記録の数(消す前に、数から引く)
static uint32_t countValid(uint32_t off) {
  if (!platOdoRead(off, g_buf, ODO_SECTOR_BYTES)) return 0;
  uint32_t n = 0;
  Rec r;
  for (int i = 0; i < SLOTS_PER_SECTOR; i++) n += decode(g_buf + i * ODO_REC_BYTES, &r) ? 1 : 0;
  return n;
}
static bool eraseAt(uint32_t off) {
  const uint32_t n = countValid(off);
  if (!platOdoErase(off, ODO_SECTOR_BYTES)) return false;
  g_records = g_records > n ? g_records - n : 0;
  return true;
}
static bool blank(const uint8_t *p) {
  for (int i = 0; i < ODO_REC_BYTES; i++)
    if (p[i] != 0xFF) return false;
  return true;
}
// 1 件書く。書いた(読み返して合った)ら true
static bool writeRec(Rec r, uint32_t nowMs) {
  g_wrote = true;
  g_lastWriteMs = nowMs;
  if (!g_storageOk || g_slots == 0) return false;
  const uint32_t total = g_slots * ODO_REC_BYTES;
  if (g_pos >= total) g_pos = 0;
  if (g_pos % ODO_SECTOR_BYTES == 0) {
    if (!eraseAt(g_pos)) {
      g_failures++;
      return false;
    }
  } else {
    uint8_t cur[ODO_REC_BYTES];
    if (!platOdoRead(g_pos, cur, ODO_REC_BYTES) || !blank(cur)) {  // 書きかけ(電源が切れた)などで空いていない: 次の区切りから
      g_pos = (g_pos / ODO_SECTOR_BYTES + 1) * ODO_SECTOR_BYTES;
      if (g_pos >= total) g_pos = 0;
      if (!eraseAt(g_pos)) {
        g_failures++;
        return false;
      }
    }
  }
  r.seq = ++g_seq;
  uint8_t o[ODO_REC_BYTES], back[ODO_REC_BYTES];
  encode(r, o);
  const uint32_t at = g_pos;
  g_pos += ODO_REC_BYTES;
  if (g_pos >= total) g_pos = 0;
  if (!platOdoWrite(at, o, ODO_REC_BYTES) || !platOdoRead(at, back, ODO_REC_BYTES) || memcmp(o, back, ODO_REC_BYTES) != 0) {
    g_failures++;
    return false;
  }
  g_records++;
  g_writes++;
  tabPut(r.day, r.seq, r.start, r.odo, r.aboveS);
  g_last = r;
  g_haveLast = true;
  g_lwHave = true;
  g_lwDay = r.day;
  g_lwOdo = r.odo;
  g_lwAbove = r.aboveS;
  return true;
}

static void resetState() {
  g_storageOk = false;
  g_slots = g_pos = g_seq = 0;
  g_records = g_writes = g_failures = 0;
  g_haveEarliest = g_haveLatest = g_haveLast = false;
  g_earliest = 0;
  g_dayKnown = g_startSet = g_aboveInit = false;
  g_curDay = 0;
  g_start = g_aboveMs = g_lastAbove = g_cur = 0;
  g_wrote = false;
  g_lastWriteMs = 0;
  g_closePending = false;
  g_lwHave = false;
  g_lwDay = 0;
  g_lwOdo = g_lwAbove = 0;
}

void begin() {
  resetState();
  if (!g_tab) g_tab = (DayEnt *)platAlloc(sizeof(DayEnt) * ODO_TABLE_DAYS);
  if (g_tab) memset(g_tab, 0, sizeof(DayEnt) * ODO_TABLE_DAYS);
  const uint32_t size = platOdoSize();
  g_slots = size / ODO_SECTOR_BYTES * SLOTS_PER_SECTOR;
  if (g_slots == 0) return;
  bool readOk = true;
  uint32_t latestSlot = 0;
  for (uint32_t sec = 0; sec < g_slots / SLOTS_PER_SECTOR; sec++) {
    if (!platOdoRead(sec * ODO_SECTOR_BYTES, g_buf, ODO_SECTOR_BYTES)) {
      readOk = false;
      continue;
    }
    for (int i = 0; i < SLOTS_PER_SECTOR; i++) {
      Rec r;
      if (!decode(g_buf + i * ODO_REC_BYTES, &r)) continue;
      g_records++;
      tabPut(r.day, r.seq, r.start, r.odo, r.aboveS);
      if (!g_haveLatest || (int32_t)(r.seq - g_latest.seq) > 0) {
        g_latest = r;
        g_haveLatest = true;
        latestSlot = sec * SLOTS_PER_SECTOR + i;
      }
    }
  }
  g_storageOk = readOk;
  if (g_haveLatest) {
    g_seq = g_latest.seq;
    g_pos = ((latestSlot + 1) % g_slots) * ODO_REC_BYTES;
    g_lwHave = true;
    g_lwDay = g_latest.day;
    g_lwOdo = g_latest.odo;
    g_lwAbove = g_latest.aboveS;
    g_last = g_latest;
    g_haveLast = true;
  }
}

void update(const Input &in, uint32_t nowMs) {
  // 今の日(GPS の時刻、日本時間)
  if (in.timeOk) {
    const int32_t d = dayOf(in.utc);
    if (!g_dayKnown) {
      g_dayKnown = true;
      g_curDay = d;
      // 前の起動の記録が今日なら、その日の始まりの ODO と過走行時間を引き継ぐ(時刻が分かる前に数えた分は足す)
      if (g_haveLatest && g_latest.day == d && (!in.odoHave || in.odoKm >= g_latest.start)) {
        g_start = g_latest.start;
        g_startSet = true;
        g_aboveMs += g_latest.aboveS * 1000u;
      }
    } else if (d != g_curDay) {
      // 日付が変わった: 前の日の締めの記録(増えていれば。次に書いてよい状態になったら書く)と、新しい日の始まり
      if (g_startSet) {
        Rec c;
        c.reason = R_CLOSE;
        c.seq = 0;
        c.utc = in.utc;
        c.day = g_curDay;
        c.odo = g_cur;
        c.start = g_start;
        c.aboveS = g_aboveMs / 1000u;
        const uint32_t km = recKm(c);
        const bool changed = (!g_lwHave || g_lwDay != g_curDay) ? (km > 0 || c.aboveS > 0) : (c.odo > g_lwOdo || c.aboveS > g_lwAbove);
        if (changed) {
          g_close = c;
          g_closePending = true;
          tabPut(c.day, g_seq, c.start, c.odo, c.aboveS);  // 表には今すぐ(書いたら通し番号の新しい値で置き換わる)
        }
        g_start = g_cur;
      }
      g_curDay = d;
      g_aboveMs = 0;
    }
  }
  // 過走行時間(trip::aboveMs の増えた分。減ったのは累積時間のリセット: 足さない)
  if (!g_aboveInit) {
    g_aboveInit = true;
  } else if (in.aboveMs >= g_lastAbove) {
    g_aboveMs += in.aboveMs - g_lastAbove;
  }
  g_lastAbove = in.aboveMs;
  // ODO
  if (in.odoHave) {
    g_cur = in.odoKm;
    if (!g_startSet) {
      g_start = in.odoKm;
      g_startSet = true;
    }
  }
  // 書いてよい状態: 低速(ODO_LOW_KMH 以下。停車も入る)・リバース。きっかけは ODO_STILL_KMH 未満なら停車
  const bool low = in.speedOk && in.speedKmh <= ODO_LOW_KMH;
  if (!(low || in.reverse) || !g_storageOk) return;
  const uint8_t reason = (in.speedOk && in.speedKmh < ODO_STILL_KMH) ? R_STILL : in.reverse ? R_REVERSE : R_LOW;
  if (g_closePending) {  // 前の日の締め(間隔は待たない)
    g_closePending = false;
    writeRec(g_close, nowMs);
    return;
  }
  if (!in.timeOk || !g_dayKnown || !g_startSet || !in.odoOk) return;
  Rec r;
  r.reason = reason;
  r.seq = 0;
  r.utc = in.utc;
  r.day = g_curDay;
  r.odo = g_cur;
  r.start = g_start;
  r.aboveS = g_aboveMs / 1000u;
  const uint32_t km = recKm(r);
  const bool changed = (!g_lwHave || g_lwDay != g_curDay) ? (km > 0 || r.aboveS > 0) : (r.odo > g_lwOdo || r.aboveS > g_lwAbove);
  if (!changed) return;
  if (g_wrote && (uint32_t)(nowMs - g_lastWriteMs) < ODO_MIN_INTERVAL_MS) return;
  writeRec(r, nowMs);
}

void status(Status *o) {
  memset(o, 0, sizeof(*o));
  o->storageOk = g_storageOk;
  o->records = g_records;
  o->capacity = g_slots;
  o->writes = g_writes;
  o->failures = g_failures;
  o->timeKnown = g_dayKnown;
  o->today = g_curDay;
  o->todayKm = g_startSet && g_cur >= g_start ? g_cur - g_start : 0;
  o->todayAboveS = g_aboveMs / 1000u;
  o->curOk = g_startSet;
  o->cur = g_cur;
  if (g_haveLast) {
    o->lastUtc = g_last.utc;
    o->lastReason = g_last.reason;
    o->lastKm = recKm(g_last);
    o->lastAboveS = g_last.aboveS;
    o->lastOdo = g_last.odo;
  }
}
bool wroteSince(uint32_t *writes) {
  if (g_writes == *writes) return false;
  *writes = g_writes;
  return true;
}
// 日 d の記録(今日はまだ書いていない分も)。start・odo = その日の始まりと最後の ODO
static bool dayRec(int32_t d, uint32_t *start, uint32_t *odo, uint32_t *aboveS) {
  bool rec = false;
  *start = *odo = *aboveS = 0;
  const DayEnt *e = slotOf(d);
  if (e && e->day1 == d + 1) {
    *start = e->start;
    *odo = e->odo;
    *aboveS = e->aboveS;
    rec = true;
  }
  if (g_dayKnown && d == g_curDay && g_startSet) {  // 今日: 表の値は書いたときの値
    if (!rec || g_cur != *odo || g_aboveMs / 1000u != *aboveS) {
      *start = g_start;
      *odo = g_cur;
      *aboveS = g_aboveMs / 1000u;
      if (g_cur > g_start || *aboveS > 0) rec = true;
    }
  }
  return rec;
}
bool day(int32_t d, uint32_t *km, uint32_t *aboveS) {
  uint32_t st, od;
  const bool rec = dayRec(d, &st, &od, aboveS);
  *km = od >= st ? od - st : 0;
  return rec;
}
int32_t earliest() {
  if (g_haveEarliest) return g_dayKnown && g_curDay < g_earliest ? g_curDay : g_earliest;
  return g_dayKnown ? g_curDay : 0;
}

// 日数 ⇔ 年月日(1970-01-01 = 0。H. Hinnant の days_from_civil / civil_from_days)
int32_t daysFrom(int y, int m, int d) {
  y -= m <= 2;
  const int era = (y >= 0 ? y : y - 399) / 400;
  const unsigned yoe = (unsigned)(y - era * 400);
  const unsigned doy = (unsigned)((153 * (m + (m > 2 ? -3 : 9)) + 2) / 5 + d - 1);
  const unsigned doe = yoe * 365 + yoe / 4 - yoe / 100 + doy;
  return era * 146097 + (int32_t)doe - 719468;
}
void civil(int32_t z, int *y, int *m, int *d, int *wday) {
  const int32_t zz = z + 719468;
  const int era = (zz >= 0 ? zz : zz - 146096) / 146097;
  const unsigned doe = (unsigned)(zz - era * 146097);
  const unsigned yoe = (doe - doe / 1460 + doe / 36524 - doe / 146096) / 365;
  const unsigned doy = doe - (365 * yoe + yoe / 4 - yoe / 100);
  const unsigned mp = (5 * doy + 2) / 153;
  const int dd = (int)(doy - (153 * mp + 2) / 5 + 1);
  const int mm = (int)(mp < 10 ? mp + 3 : mp - 9);
  *y = (int)yoe + era * 400 + (mm <= 2);
  *m = mm;
  *d = dd;
  int w = (int)((z + 4) % 7);  // 1970-01-01 は木曜
  if (w < 0) w += 7;
  *wday = w;
}

bool today(int32_t *d) {
  if (!g_dayKnown) return false;
  *d = g_curDay;
  return true;
}
// 日 d を含む期間の最初と最後の日(level: 0 = 1 年、1 = 3 ヶ月(1〜3 月・4〜6 月・7〜9 月・10〜12 月)、2 = 1 ヶ月、3 = 1 週(ODO_WEEK_START 始まり)、
// 4 = 1 日。2.15.2: 1 年を足した)
void bounds(int level, int32_t d, int32_t *first, int32_t *last) {
  int y, m, dd, w;
  civil(d, &y, &m, &dd, &w);
  if (level <= ODO_LV_MONTH) {
    const int m0 = level == ODO_LV_YEAR ? 1 : level == ODO_LV_QUARTER ? (m - 1) / 3 * 3 + 1 : m;  // 期間の最初の月
    const int n = level == ODO_LV_YEAR ? 12 : level == ODO_LV_QUARTER ? 3 : 1;                  // 期間の月の数
    const int mi = y * 12 + (m0 - 1) + n;  // 次の期間の最初の月
    *first = daysFrom(y, m0, 1);
    *last = daysFrom(mi / 12, mi % 12 + 1, 1) - 1;
  } else if (level == ODO_LV_WEEK) {
    *first = d - ((w - ODO_WEEK_START + 7) % 7);
    *last = *first + 6;
  } else {
    *first = *last = d;
  }
}
// 日 d の終わりの時点の ODO(その日か、それより前でいちばん近い記録の日の最後の ODO。今日は今の ODO)
static bool odoAt(int32_t d, uint32_t *odo) {
  if (!g_haveEarliest && !(g_dayKnown && g_startSet)) return false;
  const int32_t lo = earliest();
  for (int32_t x = d; x >= lo && x > d - ODO_TABLE_DAYS; x--) {
    uint32_t st, a;
    if (dayRec(x, &st, odo, &a)) return true;
    if (g_dayKnown && x == g_curDay && g_startSet) {  // 今日で、まだ増えていない
      *odo = g_cur;
      return true;
    }
  }
  return false;
}
bool periodAt(int level, int32_t anchor, Period *o) {
  memset(o, 0, sizeof(*o));
  if (!g_dayKnown) return false;
  const int32_t today = g_curDay;
  if (anchor > today) anchor = today;
  bounds(level, anchor, &o->first, &o->last);
  const int32_t end = o->last < today ? o->last : today;
  o->current = o->last >= today;
  // 終わりの ODO と、始まりの ODO(期間の前の日の終わりの ODO。前に記録が無ければ、期間の中の最初の記録の始まり)
  o->odoKnown = odoAt(end, &o->odoEnd);
  bool startOk = odoAt(o->first - 1, &o->odoStart);
  for (int32_t d = o->first; d <= end; d++) {
    uint32_t st, od, a;
    if (!dayRec(d, &st, &od, &a)) continue;
    o->hasRecord = true;
    o->aboveS += a;
    if (!startOk) o->odoStart = st, startOk = true;
  }
  if (!startOk) o->odoStart = o->odoEnd;
  o->km = o->odoKnown && o->odoEnd >= o->odoStart ? o->odoEnd - o->odoStart : 0;
  o->canBack = earliest() < o->first;
  o->canFwd = o->last < today;
  return true;
}
int32_t prevAnchor(int level, int32_t anchor) {  // 前の期間の、今日までで最後の日
  int32_t f, l;
  bounds(level, anchor, &f, &l);
  bounds(level, f - 1, &f, &l);
  return l;
}
int32_t nextAnchor(int level, int32_t anchor) {  // 次の期間の、今日までで最後の日
  int32_t f, l;
  bounds(level, anchor, &f, &l);
  bounds(level, l + 1, &f, &l);
  return g_dayKnown && l > g_curDay ? g_curDay : l;
}

void testReset() {
  resetState();
  if (g_tab) memset(g_tab, 0, sizeof(DayEnt) * ODO_TABLE_DAYS);
}

}  // namespace odo

// ================================================================ load(高負荷時間。2.10.0。説明は app.h)
namespace load {

static uint32_t g_value = 0;       // 今の値 [ms]
static uint32_t g_lastMs = 0;      // 前に update を呼んだ時刻
static bool g_started = false;
static uint32_t g_lowSince = 0;    // 回転数が過負荷 回転数未満になった時刻(0 = 今は以上・信号なし)
static bool g_hot = false;         // リセットのあとに一度でも黄(黄が切なら赤)になった(2.12.0。クールダウンを出す条件)
static bool g_haveSaved = false;   // restore で保存した値を受けた
static uint32_t g_savedUtc = 0;    // 前の起動で最後に書いた時刻(0 = 分からなかった)
static uint32_t g_savedLow = 0;    // そのときの過負荷 回転数未満の経過 [ms]
static bool g_timeDone = false;    // 起動してから時刻を受けた(電源が切れていた時間を引くのは 1 回だけ)

static uint32_t minMs(int m) {
  return m > 0 ? (uint32_t)m * 60000UL : 0;
}
bool enabled(const Settings &set) {
  return set.loadYellowMin > 0 || set.loadRedMin > 0;
}
static void hotTrack(const Settings &set) {  // 2.12.0: 黄(黄が切なら赤)になったら覚え、0 になったら忘れる
  if (g_value == 0) g_hot = false;
  else if (level(set) >= 1) g_hot = true;
}

void update(const Signals &s, const Settings &set, uint32_t nowMs) {
  uint32_t dt = g_started ? (uint32_t)(nowMs - g_lastMs) : 0;
  g_started = true;
  g_lastMs = nowMs;
  if (dt > 500) dt = 500;  // 画面の切り替えなどで間が空いても、数えすぎない(trip と同じ)
  // 過負荷 回転数未満が続いている時間(リセットの数え。▼ 3000rpm の経過時間と同じ数え方。信号なしは 0 から)。2.12.0: 設定の過負荷 回転数。
  // 境目は過負荷時間が増える所(以上)とそろえた(2.11.0 までは「以下」で、ちょうどのときは増えながらリセットも数えていた)
  if (s.rpmOk && s.rpm < set.loadRpm) {
    if (!g_lowSince) g_lowSince = nowMs ? nowMs : 1;
  } else {
    g_lowSince = 0;
  }
  if (!enabled(set)) {  // 機能が切: 数えず 0
    g_value = 0;
    g_hot = false;
    return;
  }
  if (!s.rpmOk) return;  // 信号がない間は変わらない
  if (s.rpm >= set.loadRpm) g_value = g_value + dt > LOAD_MAX_MS ? LOAD_MAX_MS : g_value + dt;
  else g_value = g_value > dt ? g_value - dt : 0;
  if (g_lowSince && (uint32_t)(nowMs - g_lowSince) >= minMs(set.loadResetMin)) g_value = 0;  // リセット
  hotTrack(set);
}
uint32_t valueMs() {
  return g_value;
}
uint8_t level(const Settings &set) {
  // 0 の色は使わない。黄 ≥ 赤 のときは赤を優先(黄は出ない)
  if (set.loadRedMin > 0 && g_value >= minMs(set.loadRedMin)) return 2;
  if (set.loadYellowMin > 0 && g_value >= minMs(set.loadYellowMin)) return 1;
  return 0;
}
bool warned(const Settings &set) {  // 黄になったのを覚えるのは update(設定を変えた直後は、次の update の前でも色で分かる)
  return g_value > 0 && (g_hot || level(set) >= 1);
}
bool coolDown(uint32_t nowMs) {
  return g_hot && g_value > 0 && lowMs(nowMs) >= LOAD_COOL_SHOW_MS;
}
uint32_t coolLeftMs(const Settings &set, uint32_t nowMs) {
  const uint32_t r = minMs(set.loadResetMin), l = lowMs(nowMs);
  return l >= r ? 0 : r - l;
}
uint32_t lowMs(uint32_t nowMs) {
  return g_lowSince ? (uint32_t)(nowMs - g_lowSince) : 0;
}
void restore(uint32_t valueMs, uint32_t savedUtc, uint32_t lowMs) {
  g_value = valueMs > LOAD_MAX_MS ? LOAD_MAX_MS : valueMs;
  g_savedUtc = savedUtc;
  g_savedLow = lowMs;
  g_haveSaved = true;
  g_timeDone = false;
}
void onTime(uint32_t utc, const Settings &set, uint32_t nowMs) {
  if (g_timeDone) return;
  g_timeDone = true;
  if (!g_haveSaved || g_savedUtc == 0 || !enabled(set)) return;  // 前の起動で時刻が分からなかった: 引かない
  // 起動した時刻(今の時刻 − 起動してからの時間)と、前の起動で最後に書いた時刻の差 = 電源が切れていた時間(最大 1 分多い)
  const int64_t boot = (int64_t)utc - (int64_t)(nowMs / 1000);
  const int64_t offS = boot - (int64_t)g_savedUtc;
  if (offS <= 0) return;  // 差が負: 引かない
  const uint64_t offMs = (uint64_t)offS * 1000ULL;
  if ((uint64_t)g_savedLow + offMs >= (uint64_t)minMs(set.loadResetMin)) g_value = 0;  // 切る前の過負荷 回転数以下 + 切れていた時間でリセット
  else g_value = (uint64_t)g_value > offMs ? g_value - (uint32_t)offMs : 0;
  hotTrack(set);
}
void capMs(uint32_t ms) {
  if (g_value > ms) g_value = ms;
  if (g_value == 0) g_hot = false;
}
void testSet(uint32_t valueMs, bool hot) {
  g_value = valueMs > LOAD_MAX_MS ? LOAD_MAX_MS : valueMs;
  g_hot = hot && g_value > 0;
  g_lowSince = 0;
  g_started = false;
}
void testReset() {
  g_value = 0;
  g_hot = false;
  g_lowSince = 0;
  g_started = false;
  g_haveSaved = false;
  g_savedUtc = g_savedLow = 0;
  g_timeDone = false;
}

}  // namespace load

// ================================================================ perf(本体の状態の「FPS」。2.3.0。2.4.3: 1 秒ごと)
namespace perf {

// 2.4.3(本人「過去数分の FPS の値がここに出るほうがいい」): 1 秒ごとに 回数・時間の合計 をまとめる。回を数えた秒だけを覚えるので、
// 設定などを出していた間は飛ばして、サーキット・タコを出していた直近 PERF_FPS_SECS 秒になる
struct Sec {
  uint32_t frames;
  uint32_t sumUs;
};
static Sec g_sec[PERF_FPS_SECS];  // 閉じた秒(古い方から g_n 個。g_pos が次に書く所)
static int g_n = 0, g_pos = 0;
static bool g_open = false;       // 今の秒を数えている
static uint32_t g_openSec = 0;    // 今の秒(ms / 1000)
static Sec g_cur;

void pageAdd(uint32_t us, uint32_t nowMs) {
  if (!us) us = 1;
  const uint32_t sec = nowMs / 1000;
  if (g_open && sec != g_openSec) {  // 前の秒を閉じる
    g_sec[g_pos] = g_cur;
    g_pos = (g_pos + 1) % PERF_FPS_SECS;
    if (g_n < PERF_FPS_SECS) g_n++;
    g_open = false;
  }
  if (!g_open) {
    g_open = true;
    g_openSec = sec;
    g_cur.frames = 0;
    g_cur.sumUs = 0;
  }
  g_cur.frames++;
  g_cur.sumUs += us;
}
// 覚えている秒(数えている今の秒も入れて、新しい方から PERF_FPS_SECS 秒)から入れる。平均 = 全部の回の時間の平均、
// 最低 = 1 秒ごとの平均の時間が一番長い秒、fpsHist = 1 秒ごとの回/秒(古い方から)
void pageStats(PerfStats *ps) {
  ps->pageFrames = 0;
  ps->pageAvgUs = ps->pageSlowUs = 0;
  ps->histN = 0;
  const int total = g_n + (g_open ? 1 : 0);
  const int use = total > PERF_FPS_SECS ? PERF_FPS_SECS : total;
  if (!use) return;
  const int skip = total - use;  // 古い方から捨てる数(今の秒があって、閉じた秒が満杯のとき 1)
  uint64_t frames = 0, sum = 0;
  uint32_t slow = 0;
  for (int i = skip; i < total; i++) {
    const Sec &x = i < g_n ? g_sec[(g_pos - g_n + i + PERF_FPS_SECS) % PERF_FPS_SECS] : g_cur;
    frames += x.frames;
    sum += x.sumUs;
    const uint32_t avg = (uint32_t)((x.sumUs + x.frames / 2) / x.frames);
    if (avg > slow) slow = avg;
    const uint32_t fps = avg ? (1000000u + avg / 2) / avg : 255;
    ps->fpsHist[ps->histN++] = (uint8_t)(fps > 255 ? 255 : fps);
  }
  ps->pageFrames = (uint32_t)frames;
  ps->pageAvgUs = (uint32_t)((sum + frames / 2) / frames);
  ps->pageSlowUs = slow;
}
void pageClear() {
  g_n = g_pos = 0;
  g_open = false;
}

}  // namespace perf

// ================================================================ gnss
namespace gnss {

static Fix g_fix;
static bool g_have = false;
static uint32_t g_pvt = 0, g_ack = 0, g_nak = 0, g_bad = 0;
// 2.13.0: OTP の高性能設定のための受信(UBX-MON-VER の版、UBX-CFG-VALGET の応答、CFG-OTP(0x06 0x41)と VALGET の ACK/NAK の数)
static char g_monSw[31], g_monHw[11];
static uint32_t g_monVerCount = 0, g_valgetCount = 0, g_ackOtp = 0, g_nakOtp = 0, g_nakValget = 0;
static uint8_t g_valget[100];
static uint16_t g_valgetLen = 0;
// 組み立て中のメッセージ
static int g_state = 0;  // 0 = 同期 1 待ち、1 = 同期 2 待ち、2 = class、3 = id、4 = len L、5 = len H、6 = 中身、7 = ck A、8 = ck B
static uint8_t g_cls = 0, g_id = 0, g_ckA = 0, g_ckB = 0;
static uint16_t g_plen = 0, g_pos = 0;
static uint8_t g_pay[100];  // NAV-PVT(92 バイト)が入る。長いものは中身を捨てて読み飛ばす
static const uint16_t MAX_SKIP = 1024;

void begin() {
  memset(&g_fix, 0, sizeof(g_fix));
  g_have = false;
  g_pvt = g_ack = g_nak = g_bad = 0;
  g_state = 0;
  g_monSw[0] = g_monHw[0] = 0;
  g_monVerCount = g_valgetCount = g_ackOtp = g_nakOtp = g_nakValget = 0;
  g_valgetLen = 0;
}

static inline uint16_t u16(const uint8_t *p) {
  return (uint16_t)(p[0] | (p[1] << 8));
}
static inline uint32_t u32(const uint8_t *p) {
  return (uint32_t)p[0] | ((uint32_t)p[1] << 8) | ((uint32_t)p[2] << 16) | ((uint32_t)p[3] << 24);
}
static inline int32_t i32(const uint8_t *p) {
  return (int32_t)u32(p);
}

// NAV-PVT の中身(u-blox の仕様。SparkFun の UBX_NAV_PVT_data_t と同じ並び)
static void decodePvt(const uint8_t *d, uint32_t nowMs) {
  Fix f;
  memset(&f, 0, sizeof(f));
  f.iTOW = u32(d + 0);
  f.year = u16(d + 4);
  f.month = d[6];
  f.day = d[7];
  f.hour = d[8];
  f.min = d[9];
  f.sec = d[10];
  uint8_t valid = d[11];
  f.timeOk = (valid & 0x03) == 0x03;  // validDate && validTime
  f.nano = i32(d + 16);
  f.fixType = d[20];
  uint8_t flags = d[21];
  f.fixOk = (flags & 0x01) && (f.fixType == 2 || f.fixType == 3 || f.fixType == 4);
  f.diffSoln = (flags & 0x02) != 0;
  f.numSV = d[23];
  f.lon = i32(d + 24);
  f.lat = i32(d + 28);
  f.hMSL = i32(d + 36);
  f.gSpeed = i32(d + 60);
  f.headMot = i32(d + 64);
  f.pDOP = u16(d + 76);
  f.rxMs = nowMs;
  g_fix = f;
  g_have = true;
  g_pvt++;
}

int feed(const uint8_t *data, size_t n, uint32_t nowMs) {
  int got = 0;
  for (size_t i = 0; i < n; i++) {
    uint8_t b = data[i];
    switch (g_state) {
      case 0:
        if (b == 0xB5) g_state = 1;
        break;
      case 1:
        g_state = (b == 0x62) ? 2 : (b == 0xB5 ? 1 : 0);
        break;
      case 2:
        g_cls = b;
        g_ckA = b;
        g_ckB = b;
        g_state = 3;
        break;
      case 3:
        g_id = b;
        g_ckA = (uint8_t)(g_ckA + b);
        g_ckB = (uint8_t)(g_ckB + g_ckA);
        g_state = 4;
        break;
      case 4:
        g_plen = b;
        g_ckA = (uint8_t)(g_ckA + b);
        g_ckB = (uint8_t)(g_ckB + g_ckA);
        g_state = 5;
        break;
      case 5:
        g_plen |= (uint16_t)(b << 8);
        g_ckA = (uint8_t)(g_ckA + b);
        g_ckB = (uint8_t)(g_ckB + g_ckA);
        g_pos = 0;
        if (g_plen > MAX_SKIP) {
          g_state = 0;  // ありえない長さ: 同期を取り直す
        } else {
          g_state = g_plen ? 6 : 7;
        }
        break;
      case 6:
        if (g_pos < sizeof(g_pay)) g_pay[g_pos] = b;
        g_pos++;
        g_ckA = (uint8_t)(g_ckA + b);
        g_ckB = (uint8_t)(g_ckB + g_ckA);
        if (g_pos >= g_plen) g_state = 7;
        break;
      case 7:
        g_state = (b == g_ckA) ? 8 : 9;
        break;
      case 8:
      case 9:
        if (g_state == 8 && b == g_ckB) {
          if (g_cls == 0x01 && g_id == 0x07 && g_plen == 92) {
            decodePvt(g_pay, nowMs);
            got++;
          } else if (g_cls == 0x05 && g_id == 0x01) {
            g_ack++;
            if (g_plen == 2 && g_pay[0] == 0x06 && g_pay[1] == 0x41) g_ackOtp++;  // 2.13.0: CFG-OTP の ACK
          } else if (g_cls == 0x05 && g_id == 0x00) {
            g_nak++;
            if (g_plen == 2 && g_pay[0] == 0x06 && g_pay[1] == 0x41) g_nakOtp++;
            if (g_plen == 2 && g_pay[0] == 0x06 && g_pay[1] == 0x8B) g_nakValget++;
          } else if (g_cls == 0x0A && g_id == 0x04 && g_plen >= 40) {  // 2.13.0: MON-VER(swVersion 30 文字 + hwVersion 10 文字 + 拡張。拡張は使わない)
            memcpy(g_monSw, g_pay, 30);
            g_monSw[30] = 0;
            memcpy(g_monHw, g_pay + 30, 10);
            g_monHw[10] = 0;
            g_monVerCount++;
          } else if (g_cls == 0x06 && g_id == 0x8B && g_plen >= 4) {  // 2.13.0: CFG-VALGET の応答(版・層・位置 + 鍵と値の並び)
            g_valgetLen = g_plen < sizeof(g_pay) ? g_plen : (uint16_t)sizeof(g_pay);
            memcpy(g_valget, g_pay, g_valgetLen);
            g_valgetCount++;
          }
        } else {
          g_bad++;
        }
        g_state = 0;
        break;
      default:
        g_state = 0;
        break;
    }
  }
  return got;
}

bool latest(Fix *out) {
  if (!g_have) return false;
  *out = g_fix;
  return true;
}
uint32_t pvtCount() {
  return g_pvt;
}
uint32_t ackCount() {
  return g_ack;
}
uint32_t nakCount() {
  return g_nak;
}
uint32_t badCount() {
  return g_bad;
}
// ---- 2.13.0: M10 の OTP の高性能設定(SAM-M10Q 統合マニュアル 2.1.5。本人 10/29 の決定: GPS + Galileo で 20 回/秒)
// マニュアル Table 3 の 2 つの列(UBX-CFG-OTP、0x06 0x41。CPU のクロックを上げる設定を OTP に書く。永久)と、確かめる VALGET の問い合わせ。
// チェックサムは 10/29 に計算して照合した
static const uint8_t OTP_HP1[] = { 0xB5, 0x62, 0x06, 0x41, 0x10, 0x00, 0x03, 0x00, 0x04, 0x1F, 0x54, 0x5E, 0x79, 0xBF, 0x28, 0xEF, 0x12, 0x05, 0xFD, 0xFF, 0xFF, 0xFF, 0x8F, 0x0D };
static const uint8_t OTP_HP2[] = { 0xB5, 0x62, 0x06, 0x41, 0x1C, 0x00, 0x04, 0x01, 0xA4, 0x10, 0xBD, 0x34, 0xF9, 0x12, 0x28, 0xEF, 0x12, 0x05, 0x05, 0x00, 0xA4, 0x40,
                                   0x00, 0xB0, 0x71, 0x0B, 0x0A, 0x00, 0xA4, 0x40, 0x00, 0xD8, 0xB8, 0x05, 0xDE, 0xAE };
static const uint8_t OTP_VALGET_POLL[] = { 0xB5, 0x62, 0x06, 0x8B, 0x14, 0x00, 0x00, 0x04, 0x00, 0x00, 0x01, 0x00, 0xA4, 0x40, 0x03, 0x00, 0xA4, 0x40,
                                           0x05, 0x00, 0xA4, 0x40, 0x0A, 0x00, 0xA4, 0x40, 0x4C, 0x15 };
static const uint32_t OTP_KEYS[4] = { 0x40A40001, 0x40A40003, 0x40A40005, 0x40A4000A };
static const uint32_t OTP_VALUES[4] = { 0x0B71B000, 0x0B71B000, 0x0B71B000, 0x05B8D800 };  // 192 MHz × 3、96 MHz
size_t buildOtpHighPerf(int part, uint8_t *out, size_t cap) {
  const uint8_t *src = part == 0 ? OTP_HP1 : OTP_HP2;
  const size_t n = part == 0 ? sizeof(OTP_HP1) : sizeof(OTP_HP2);
  if (cap < n) return 0;
  memcpy(out, src, n);
  return n;
}
size_t buildOtpValgetPoll(uint8_t *out, size_t cap) {
  if (cap < sizeof(OTP_VALGET_POLL)) return 0;
  memcpy(out, OTP_VALGET_POLL, sizeof(OTP_VALGET_POLL));
  return sizeof(OTP_VALGET_POLL);
}
static void copyStr(char *dst, size_t cap, const char *src) {
  if (!cap) return;
  size_t i = 0;
  for (; i + 1 < cap && src[i]; i++) dst[i] = src[i];
  dst[i] = 0;
}
bool monVer(char *sw, size_t swCap, char *hw, size_t hwCap) {
  if (!g_monVerCount) return false;
  copyStr(sw, swCap, g_monSw);
  copyStr(hw, hwCap, g_monHw);
  return true;
}
uint32_t monVerCount() {
  return g_monVerCount;
}
uint32_t valgetCount() {
  return g_valgetCount;
}
uint32_t ackOtpCount() {
  return g_ackOtp;
}
uint32_t nakOtpCount() {
  return g_nakOtp;
}
uint32_t nakValgetCount() {
  return g_nakValget;
}
bool valgetValue(uint32_t key, uint32_t *val) {
  size_t pos = 4;  // 版(1)・層(1)・位置(2)の次から鍵と値
  while (pos + 4 <= g_valgetLen) {
    uint32_t k = u32(g_valget + pos);
    int size = (int)((k >> 28) & 7);
    int n = (size == 3) ? 2 : (size == 4) ? 4 : (size == 5) ? 8 : 1;
    if (pos + 4 + (size_t)n > g_valgetLen) return false;
    if (k == key) {
      uint32_t v = 0;
      for (int i = 0; i < n && i < 4; i++) v |= (uint32_t)g_valget[pos + 4 + i] << (8 * i);
      *val = v;
      return true;
    }
    pos += 4 + (size_t)n;
  }
  return false;
}
int otpHighPerfState() {
  if (!g_valgetCount) return 0;
  for (int i = 0; i < 4; i++) {
    uint32_t v;
    if (!valgetValue(OTP_KEYS[i], &v)) return 2;
    if (v != OTP_VALUES[i]) return 2;
  }
  return 1;
}

// UBX の枠(同期 2 + class + id + 長さ 2 + 中身 + チェックサム 2)を作る
static size_t ubxFrame(uint8_t *out, size_t cap, uint8_t cls, uint8_t id, const uint8_t *payload, uint16_t len) {
  size_t total = (size_t)len + 8;
  if (cap < total) return 0;
  out[0] = 0xB5;
  out[1] = 0x62;
  out[2] = cls;
  out[3] = id;
  out[4] = (uint8_t)(len & 0xFF);
  out[5] = (uint8_t)(len >> 8);
  if (len) memcpy(out + 6, payload, len);  // 2.13.0: 中身なし(MON-VER の問い合わせ)も作れるように
  uint8_t a = 0, b = 0;
  for (size_t i = 2; i < 6 + (size_t)len; i++) {
    a = (uint8_t)(a + out[i]);
    b = (uint8_t)(b + a);
  }
  out[6 + len] = a;
  out[7 + len] = b;
  return total;
}

// CFG-VALSET の中身に「鍵 + 値」を足す。値の大きさは鍵の上位 3 ビット(1 = 1 バイト、2 = 1、3 = 2、4 = 4、5 = 8)
static size_t putKey(uint8_t *p, uint32_t key, uint32_t val) {
  p[0] = (uint8_t)key;
  p[1] = (uint8_t)(key >> 8);
  p[2] = (uint8_t)(key >> 16);
  p[3] = (uint8_t)(key >> 24);
  int size = (int)((key >> 28) & 7);
  int n = (size == 3) ? 2 : (size == 4) ? 4 : 1;
  for (int i = 0; i < n; i++) p[4 + i] = (uint8_t)(val >> (8 * i));
  return 4 + (size_t)n;
}

// 鍵の番号は u-blox の設定一覧(SparkFun の u-blox_config_keys.h で照合済み)
static const uint32_t KEY_RATE_MEAS = 0x30210001, KEY_RATE_NAV = 0x30210002, KEY_MSGOUT_PVT_UART1 = 0x20910007;
static const uint32_t KEY_UART1OUT_UBX = 0x10740001, KEY_UART1OUT_NMEA = 0x10740002, KEY_UART1IN_UBX = 0x10730001;
static const uint32_t KEY_DYNMODEL = 0x20110021, KEY_UART1_BAUD = 0x40520001;
static const uint32_t KEY_GPS = 0x1031001f, KEY_GPS_L1CA = 0x10310001, KEY_GAL = 0x10310021, KEY_GAL_E1 = 0x10310007;
static const uint32_t KEY_QZSS = 0x10310024, KEY_QZSS_L1CA = 0x10310012, KEY_BDS = 0x10310022, KEY_GLO = 0x10310025, KEY_SBAS = 0x10310020;

size_t buildConfig(uint8_t *out, size_t cap, int rateHz) {
  uint8_t pay[96];
  size_t n = 0;
  pay[n++] = 0x00;  // version 0
  pay[n++] = (uint8_t)RC_GPS_CFG_LAYERS;  // 層(bit0 = RAM、bit1 = BBR、bit2 = フラッシュ)
  pay[n++] = 0x00;  // reserved
  pay[n++] = 0x00;
  int meas = rateHz > 0 ? 1000 / rateHz : 1000;
  if (meas < 40) meas = 40;
  n += putKey(pay + n, KEY_RATE_MEAS, (uint32_t)meas);
  n += putKey(pay + n, KEY_RATE_NAV, 1);
  n += putKey(pay + n, KEY_MSGOUT_PVT_UART1, 1);
  n += putKey(pay + n, KEY_UART1OUT_UBX, 1);
  n += putKey(pay + n, KEY_UART1OUT_NMEA, 0);
  n += putKey(pay + n, KEY_UART1IN_UBX, 1);
  n += putKey(pay + n, KEY_DYNMODEL, 4);  // 4 = automotive
  return ubxFrame(out, cap, 0x06, 0x8A, pay, (uint16_t)n);
}

size_t buildSignals(uint8_t *out, size_t cap) {
  uint8_t pay[96];
  size_t n = 0;
  pay[n++] = 0x00;
  pay[n++] = (uint8_t)RC_GPS_CFG_LAYERS;
  pay[n++] = 0x00;
  pay[n++] = 0x00;
  n += putKey(pay + n, KEY_GPS, 1);
  n += putKey(pay + n, KEY_GPS_L1CA, 1);
  n += putKey(pay + n, KEY_GAL, 1);  // GPS + Galileo(本人 10/29 の決定。u-blox M10 の測位の上限は、既定で 10 回/秒、OTP の高性能設定で 20 回/秒)
  n += putKey(pay + n, KEY_GAL_E1, 1);
  n += putKey(pay + n, KEY_QZSS, 1);
  n += putKey(pay + n, KEY_QZSS_L1CA, 1);
  n += putKey(pay + n, KEY_BDS, 0);
  n += putKey(pay + n, KEY_GLO, 0);
  n += putKey(pay + n, KEY_SBAS, 0);
  return ubxFrame(out, cap, 0x06, 0x8A, pay, (uint16_t)n);
}

size_t buildMonVerPoll(uint8_t *out, size_t cap) {  // 2.13.0: UBX-MON-VER の問い合わせ(中身なし)
  return ubxFrame(out, cap, 0x0A, 0x04, nullptr, 0);
}
size_t buildReset(uint8_t *out, size_t cap) {  // 2.13.0: UBX-CFG-RST = ハードウェアリセット(navBbrMask 0 = ホットスタート)。OTP の設定は再起動で効く
  const uint8_t pay[4] = { 0x00, 0x00, 0x00, 0x00 };
  return ubxFrame(out, cap, 0x06, 0x04, pay, 4);
}
size_t buildBaud(uint8_t *out, size_t cap, uint32_t baud) {
  uint8_t pay[16];
  size_t n = 0;
  pay[n++] = 0x00;
  pay[n++] = (uint8_t)RC_GPS_CFG_LAYERS;
  pay[n++] = 0x00;
  pay[n++] = 0x00;
  n += putKey(pay + n, KEY_UART1_BAUD, baud);
  return ubxFrame(out, cap, 0x06, 0x8A, pay, (uint16_t)n);
}

}  // namespace gnss

// ================================================================ gtime(今の時刻。2.10.0。説明は app.h)
namespace gtime {

static bool g_ok = false;
static uint32_t g_utc = 0;  // 合わせた時刻(秒の始まり)
static uint32_t g_ms = 0;   // そのときの millis

uint32_t epoch(uint16_t year, uint8_t month, uint8_t day, uint8_t hour, uint8_t min, uint8_t sec) {
  // 1970-01-01 からの日数(グレゴリオ暦。3 月始まりの年で数える)
  const int y = (int)year - (month <= 2 ? 1 : 0);
  const int era = (y >= 0 ? y : y - 399) / 400;
  const unsigned yoe = (unsigned)(y - era * 400);
  const unsigned doy = (153u * (unsigned)(month > 2 ? month - 3 : month + 9) + 2u) / 5u + day - 1u;
  const unsigned doe = yoe * 365u + yoe / 4u - yoe / 100u + doy;
  const int64_t days = (int64_t)era * 146097 + (int64_t)doe - 719468;
  return (uint32_t)(days * 86400 + (int64_t)hour * 3600 + (int64_t)min * 60 + sec);
}
void onFix(const gnss::Fix &f) {
  if (!f.timeOk || f.year < 2020 || f.month < 1 || f.month > 12 || f.day < 1 || f.day > 31 || f.hour > 23 || f.min > 59 || f.sec > 60) return;
  g_utc = epoch(f.year, f.month, f.day, f.hour, f.min, f.sec);
  g_ms = f.rxMs - (uint32_t)(f.nano / 1000000);  // 秒の始まりの millis(nano は負もある。受けるまでの遅れは見ない)
  g_ok = true;
}
uint32_t demoBase(const char *date, const char *time) {
  static const char MON[] = "JanFebMarAprMayJunJulAugSepOctNovDec";
  if (!date || !time || strlen(date) != 11 || strlen(time) != 8 || time[2] != ':' || time[5] != ':') return 0;
  int mon = 0;
  for (int i = 0; i < 12; i++)
    if (strncmp(date, MON + i * 3, 3) == 0) mon = i + 1;
  const int day = atoi(date + 4), year = atoi(date + 7), hh = atoi(time), mm = atoi(time + 3), ss = atoi(time + 6);
  if (mon == 0 || day < 1 || day > 31 || year < 2020 || year > 2099 || hh > 23 || mm > 59 || ss > 59) return 0;
  return epoch((uint16_t)year, (uint8_t)mon, (uint8_t)day, (uint8_t)hh, (uint8_t)mm, (uint8_t)ss) - (uint32_t)CLOCK_TZ_SEC;
}
bool now(uint32_t nowMs, uint32_t *utc) {
  if (!g_ok) return false;
  const int32_t d = (int32_t)(nowMs - g_ms);
  *utc = d >= 0 ? g_utc + (uint32_t)d / 1000u : g_utc - (uint32_t)(-d + 999) / 1000u;
  return true;
}
void testReset() {
  g_ok = false;
  g_utc = g_ms = 0;
}

}  // namespace gtime

// ================================================================ rcdiy
namespace rcdiy {

static inline int32_t clampI(int32_t v, int32_t lo, int32_t hi) {
  return v < lo ? lo : (v > hi ? hi : v);
}

uint32_t dateHourCode(const gnss::Fix &f) {
  int y = (int)f.year - 2000;
  if (y < 0) y = 0;
  int mo = f.month ? f.month - 1 : 0, d = f.day ? f.day - 1 : 0;
  return (uint32_t)(y * 8928 + mo * 744 + d * 24 + f.hour) & 0x1FFFFF;
}

void encodeGpsMain(const gnss::Fix &f, uint8_t sync, uint8_t out[20]) {
  // 時刻: 正時からの経過 = 分 × 30000 + 秒 × 500 + ms / 2(21 ビット)
  int32_t ms = (int32_t)f.min * 60000 + (int32_t)f.sec * 1000 + f.nano / 1000000;
  if (ms < 0) ms = 0;
  if (ms > 3599999) ms = 3599999;
  uint32_t t = (uint32_t)(ms / 2) & 0x1FFFFF;
  out[0] = (uint8_t)(((sync & 7) << 5) | ((t >> 16) & 0x1F));
  out[1] = (uint8_t)(t >> 8);
  out[2] = (uint8_t)t;
  // fix の種類(NMEA GGA の quality と同じ: 0 = なし、1 = GPS、2 = 補正あり)と衛星数
  uint8_t q = f.fixOk ? (f.diffSoln ? 2 : 1) : 0;
  uint8_t sv = f.numSV > 0x3E ? 0x3E : f.numSV;
  out[3] = (uint8_t)((q << 6) | (sv & 0x3F));
  uint32_t lat = f.fixOk ? (uint32_t)f.lat : 0x7FFFFFFFu, lon = f.fixOk ? (uint32_t)f.lon : 0x7FFFFFFFu;
  out[4] = (uint8_t)(lat >> 24);
  out[5] = (uint8_t)(lat >> 16);
  out[6] = (uint8_t)(lat >> 8);
  out[7] = (uint8_t)lat;
  out[8] = (uint8_t)(lon >> 24);
  out[9] = (uint8_t)(lon >> 16);
  out[10] = (uint8_t)(lon >> 8);
  out[11] = (uint8_t)lon;
  uint32_t alt = 0xFFFF, spd = 0xFFFF, brg = 0xFFFF;
  if (f.fixOk) {
    float m = f.hMSL / 1000.0f;
    if (m > 2776.7f) alt = ((uint32_t)clampI((int32_t)lroundf(m + 500.0f), 0, 0x7FFF) & 0x7FFF) | 0x8000;
    else alt = (uint32_t)clampI((int32_t)lroundf((m + 500.0f) * 10.0f), 0, 0x7FFF) & 0x7FFF;
    float kmh = f.gSpeed * 0.0036f;
    if (kmh > 327.67f) spd = ((uint32_t)clampI((int32_t)lroundf(kmh * 10.0f), 0, 0x7FFF) & 0x7FFF) | 0x8000;
    else spd = (uint32_t)clampI((int32_t)lroundf(kmh * 100.0f), 0, 0x7FFF) & 0x7FFF;
    int32_t deg100 = f.headMot / 1000;  // 1e-5 度 → 0.01 度
    while (deg100 < 0) deg100 += 36000;
    while (deg100 >= 36000) deg100 -= 36000;
    brg = (uint32_t)deg100;
  }
  out[12] = (uint8_t)(alt >> 8);
  out[13] = (uint8_t)alt;
  out[14] = (uint8_t)(spd >> 8);
  out[15] = (uint8_t)spd;
  out[16] = (uint8_t)(brg >> 8);
  out[17] = (uint8_t)brg;
  // HDOP の欄には pDOP(NAV-PVT には hDOP が無い。pDOP ≥ hDOP なので控えめな値になる)
  uint32_t dop = f.fixOk ? (uint32_t)clampI((f.pDOP + 5) / 10, 0, 0xFE) : 0xFF;
  out[18] = (uint8_t)dop;
  out[19] = 0xFF;  // VDOP: なし
}

void encodeGpsTime(const gnss::Fix &f, uint8_t sync, uint8_t out[3]) {
  uint32_t c = dateHourCode(f);
  out[0] = (uint8_t)(((sync & 7) << 5) | ((c >> 16) & 0x1F));
  out[1] = (uint8_t)(c >> 8);
  out[2] = (uint8_t)c;
}

size_t encodeCan(uint32_t id, const uint8_t *d, uint8_t dlc, uint8_t out[20]) {
  if (dlc > 16) dlc = 16;
  out[0] = (uint8_t)id;
  out[1] = (uint8_t)(id >> 8);
  out[2] = (uint8_t)(id >> 16);
  out[3] = (uint8_t)(id >> 24);
  memcpy(out + 4, d, dlc);
  return 4 + (size_t)dlc;
}

// ---- PID フィルタ
static const int MAX_PIDS = 48;
static bool g_allowAll = false;
static uint16_t g_allInterval = 0;
static int g_n = 0;
static uint32_t g_pid[MAX_PIDS];
static uint16_t g_interval[MAX_PIDS];
static uint32_t g_lastMs[MAX_PIDS];
// 全部許可のときの PID ごとの最終送信時刻(小さい表。あふれたら間隔を見ずに送る)
static uint32_t g_allPid[MAX_PIDS], g_allMs[MAX_PIDS];
static int g_allN = 0;

void filterReset() {
  g_allowAll = false;
  g_allInterval = 0;
  g_n = 0;
  g_allN = 0;
}

void filterCommand(const uint8_t *data, size_t len) {
  if (len < 1) return;
  uint8_t cmd = data[0];
  if (cmd == 0) {  // 全部拒否
    g_allowAll = false;
    g_n = 0;
  } else if (cmd == 1 && len >= 3) {  // 全部許可
    g_allowAll = true;
    g_allInterval = (uint16_t)((data[1] << 8) | data[2]);
    g_n = 0;
    g_allN = 0;
  } else if (cmd == 2 && len >= 7) {  // この PID を許可
    uint16_t iv = (uint16_t)((data[1] << 8) | data[2]);
    uint32_t pid = ((uint32_t)data[3] << 24) | ((uint32_t)data[4] << 16) | ((uint32_t)data[5] << 8) | data[6];
    for (int i = 0; i < g_n; i++) {
      if (g_pid[i] == pid) {
        g_interval[i] = iv;
        return;
      }
    }
    if (g_n < MAX_PIDS) {
      g_pid[g_n] = pid;
      g_interval[g_n] = iv;
      g_lastMs[g_n] = 0;
      g_n++;
    }
  }
}

bool filterPass(uint32_t pid, uint32_t nowMs, uint16_t minMs) {
  if (g_allowAll) {
    const uint16_t iv = g_allInterval > minMs ? g_allInterval : minMs;
    if (iv == 0) return true;
    for (int i = 0; i < g_allN; i++) {
      if (g_allPid[i] == pid) {
        if ((uint32_t)(nowMs - g_allMs[i]) < iv) return false;
        g_allMs[i] = nowMs;
        return true;
      }
    }
    if (g_allN < MAX_PIDS) {
      g_allPid[g_allN] = pid;
      g_allMs[g_allN] = nowMs;
      g_allN++;
    }
    return true;
  }
  for (int i = 0; i < g_n; i++) {
    if (g_pid[i] != pid) continue;
    const uint16_t iv = g_interval[i] > minMs ? g_interval[i] : minMs;
    if (iv && g_lastMs[i] && (uint32_t)(nowMs - g_lastMs[i]) < iv) return false;
    g_lastMs[i] = nowMs;
    return true;
  }
  return false;
}

int filterCount() {
  return g_allowAll ? -1 : g_n;
}

bool filterAllowed(uint32_t pid) {
  if (g_allowAll) return true;
  for (int i = 0; i < g_n; i++)
    if (g_pid[i] == pid) return true;
  return false;
}

}  // namespace rcdiy

// ================================================================ imu
namespace imu {

struct V3 {
  float x, y, z;
};
static inline V3 add(V3 a, V3 b) {
  return V3{ a.x + b.x, a.y + b.y, a.z + b.z };
}
static inline V3 sub(V3 a, V3 b) {
  return V3{ a.x - b.x, a.y - b.y, a.z - b.z };
}
static inline V3 mul(V3 a, float k) {
  return V3{ a.x * k, a.y * k, a.z * k };
}
static inline float dot(V3 a, V3 b) {
  return a.x * b.x + a.y * b.y + a.z * b.z;
}
static inline V3 cross(V3 a, V3 b) {
  return V3{ a.y * b.z - a.z * b.y, a.z * b.x - a.x * b.z, a.x * b.y - a.y * b.x };
}
static inline float norm(V3 a) {
  return sqrtf(dot(a, a));
}
static const V3 DEF_UP = IMU_DEF_UP, DEF_FWD = IMU_DEF_FWD;  // 覚える前の向き(画面を立てて、背面が前)

static inline V3 unit(V3 a) {
  float n = norm(a);
  return n > 1e-6f ? mul(a, 1.0f / n) : DEF_UP;
}
// v の、up に垂直な成分(水平成分)。v が up と平行なら初期の「前」「上」で代用する
static V3 horiz(V3 v, V3 up) {
  V3 h = sub(v, mul(up, dot(v, up)));
  if (norm(h) < 1e-3f) h = sub(DEF_FWD, mul(up, dot(DEF_FWD, up)));
  if (norm(h) < 1e-3f) h = sub(DEF_UP, mul(up, dot(DEF_UP, up)));
  return unit(h);
}

static const float NEAR_UP = 0.9f;        // 覚えた「上」と 25° 以内なら同じ向きとみなす
static const float NEAR_FWD = 0.7f;       // 覚えた「前」と 45° 以内
static const float VER_UP = 0.99939f;     // 2° 以上動いたら版を進める(保存のきっかけ)
static const float VER_FWD = 0.99905f;    // 2.5°

static V3 g_up = DEF_UP, g_fwd = DEF_FWD;
static bool g_levelOk = false, g_fwdOk = false;
static uint32_t g_calVer = 0;
static V3 g_upAtVer = DEF_UP, g_fwdAtVer = DEF_FWD;  // 版を進めたときの値
static float g_g0 = 1.0f;  // 停車中に測った重力の大きさ [g](倍率のずれ。実機は 1.1 と出た)
static int g_upReject = 0, g_fwdReject = 0;  // 覚えた向きと大きく違う値が続いた回数(付け直しの検出)
static V3 g_last = { 0, 0, 0 };
static uint32_t g_lastMs = 0;
// 「上」の長期平均: 走行中(IMU_UP_EMA_MIN_KMH 以上)の加速度の指数移動平均。走っているうちに坂やカーブの影響が平均される
static V3 g_lt = { 0, 0, 1 };
// 「上」の短期平均: 停車中(車速 0 が IMU_LEVEL_STILL_MS 以上)。最初の学習と、付け直しの検出に使う
static V3 g_stillSum = { 0, 0, 0 };
static int g_stillN = 0;
static uint32_t g_stillStart = 0;  // いまの 3 秒区間の始まり
static uint32_t g_stillSince = 0;  // 静止が始まった時刻(区間をまたいで持つ。stillNow 用)
static bool g_still = false;
// 「前」: 発進(車速が IMU_FWD_FROM_KMH から IMU_FWD_DONE_KMH へ増える間)の水平方向の加速度の平均
static V3 g_fwdSum = { 0, 0, 0 };
static int g_fwdN = 0;
static bool g_fwdDone = false;  // この発進ではもう使った
static float g_prevKmh = 0;
static uint32_t g_prevKmhMs = 0;
static bool g_accel = false;

void begin() {
  g_up = DEF_UP;
  g_fwd = DEF_FWD;
  g_levelOk = g_fwdOk = false;
  g_calVer = 0;
  g_upAtVer = g_up;
  g_fwdAtVer = g_fwd;
  g_g0 = 1.0f;
  g_upReject = g_fwdReject = 0;
  g_stillSince = 0;
  g_last = V3{ 0, 0, 0 };
  g_lastMs = 0;
  g_lt = g_up;
  g_stillN = 0;
  g_still = false;
  g_fwdSum = V3{ 0, 0, 0 };
  g_fwdN = 0;
  g_fwdDone = false;
  g_accel = false;
  g_prevKmh = 0;
  g_prevKmhMs = 0;
}

void reset() {
  begin();
}

static void setUp(V3 up, bool forgetFwd) {
  g_up = up;
  g_lt = up;
  g_upAtVer = up;
  g_levelOk = true;
  g_upReject = 0;
  g_calVer++;
  if (forgetFwd) {
    g_fwdOk = false;
    g_fwdReject = 0;
    g_fwdSum = V3{ 0, 0, 0 };
    g_fwdN = 0;
  }
}
// 車速が無いとき(机の上): 置いた向きをそのまま「上」に。版は 2° 以上動いたときだけ進める(保存が続かないように)
static void refreshUp(V3 up) {
  g_up = up;
  g_lt = up;
  g_upReject = 0;
  if (dot(up, g_upAtVer) < VER_UP) {
    g_upAtVer = up;
    g_calVer++;
  }
}
static void setGravity(float m) {
  if (m < 0.8f || m > 1.2f) return;
  if (fabsf(m - g_g0) > 0.02f) g_calVer++;
  g_g0 = m;
}

void sample(float ax, float ay, float az, bool speedOk, float speedKmh, uint32_t nowMs) {
  V3 a = { ax, ay, az };
  float jump = norm(sub(a, g_last));  // 直前の値からの変化
  g_last = a;
  uint32_t dt = g_lastMs ? nowMs - g_lastMs : 20;
  if (dt > 100) dt = 100;
  g_lastMs = nowMs;
  float n = norm(a);
  bool plausible = n > 0.8f && n < 1.2f;  // 1 g 前後の値だけ使う(強い振動や手で持っているときを除く)
  // 停車の判定: 車速があればそれで。無ければ「値が動かず、大きさが 1 g に近く、立てた向き(初期の上から 45° 以内)」(机の上)
  bool quiet = jump < IMU_QUIET_G && plausible && dot(a, DEF_UP) > n * IMU_QUIET_TILT_COS;
  bool stopped = speedOk ? (speedKmh < IMU_STILL_KMH) : quiet;
  if (!speedOk) g_fwdN = 0;  // 「前」は車速が無いと覚えない
  // 上(長期): 走行中の平均。時定数 IMU_UP_TAU_MS
  if (g_levelOk && plausible && speedKmh >= IMU_UP_EMA_MIN_KMH) {
    float k = (float)dt / (float)IMU_UP_TAU_MS;
    g_lt = add(g_lt, mul(sub(a, g_lt), k));
    g_up = unit(g_lt);
    if (dot(g_up, g_upAtVer) < VER_UP) {
      g_upAtVer = g_up;
      g_calVer++;
    }
  }
  // 上(短期): 停車中の平均
  if (stopped) {
    if (!g_still) {
      g_still = true;
      g_stillSince = nowMs;
      g_stillStart = nowMs;
      g_stillSum = V3{ 0, 0, 0 };
      g_stillN = 0;
    }
    if (plausible) {
      g_stillSum = add(g_stillSum, a);
      g_stillN++;
    }
    if ((uint32_t)(nowMs - g_stillStart) >= IMU_LEVEL_STILL_MS && g_stillN >= 20) {
      V3 mean = mul(g_stillSum, 1.0f / g_stillN);
      V3 up = unit(mean);
      setGravity(norm(mean));  // 重力の大きさ(倍率のずれ)も覚える
      if (!g_levelOk) {
        setUp(up, false);  // 最初の 1 回(坂で止まっていても、走っているうちに長期平均が直す)
      } else if (!speedOk) {
        refreshUp(up);  // 机の上: 置いた向きに合わせる(「前」は残す)
      } else if (dot(up, g_up) > NEAR_UP) {
        g_upReject = 0;
      } else if (++g_upReject >= IMU_RELEARN_COUNT) {
        setUp(up, true);  // 大きく違う向きが続いた = 付け直した。「前」も覚え直す
      }
      g_stillStart = nowMs;  // 次の区間へ
      g_stillSum = V3{ 0, 0, 0 };
      g_stillN = 0;
    }
  } else {
    g_still = false;
  }
  // 前: 発進の加速。車速が IMU_FWD_FROM_KMH〜IMU_FWD_TO_KMH で増えている間の水平成分を集め、
  // IMU_FWD_DONE_KMH に達したら平均を取る(そこまで加速するのは前進。後退では普通そこまで出さない)
  if (g_levelOk && speedOk) {
    uint32_t sdt = nowMs - g_prevKmhMs;
    if (sdt >= 200) {
      g_accel = (speedKmh - g_prevKmh) > 0.5f;  // 0.2 秒で 0.5 km/h 以上の増加(約 0.07 g)
      g_prevKmh = speedKmh;
      g_prevKmhMs = nowMs;
    }
    if (speedKmh < IMU_FWD_FROM_KMH) {
      g_fwdSum = V3{ 0, 0, 0 };
      g_fwdN = 0;
      g_fwdDone = false;
    } else if (speedKmh > IMU_FWD_TO_KMH || !g_accel) {
      g_fwdSum = V3{ 0, 0, 0 };
      g_fwdN = 0;
    } else if (!g_fwdDone) {
      V3 h = sub(a, mul(g_up, dot(a, g_up)));  // 水平成分
      if (norm(h) > 0.08f) {
        g_fwdSum = add(g_fwdSum, h);
        g_fwdN++;
      }
      if (speedKmh >= IMU_FWD_DONE_KMH && g_fwdN >= IMU_FWD_SAMPLES) {
        V3 f = unit(mul(g_fwdSum, 1.0f / g_fwdN));
        if (!g_fwdOk) {
          g_fwd = f;
          g_fwdAtVer = f;
          g_fwdOk = true;
          g_fwdReject = 0;
          g_calVer++;
        } else if (dot(f, g_fwd) > NEAR_FWD) {
          g_fwd = unit(add(mul(g_fwd, 0.75f), mul(f, 0.25f)));  // 少しずつ寄せる
          g_fwdReject = 0;
          if (dot(g_fwd, g_fwdAtVer) < VER_FWD) {
            g_fwdAtVer = g_fwd;
            g_calVer++;
          }
        } else if (++g_fwdReject >= IMU_RELEARN_COUNT) {
          g_fwd = f;
          g_fwdAtVer = f;
          g_fwdReject = 0;
          g_calVer++;
        }
        g_fwdSum = V3{ 0, 0, 0 };
        g_fwdN = 0;
        g_fwdDone = true;
      }
    }
  }
}

bool levelOk() {
  return g_levelOk;
}
bool forwardOk() {
  return g_fwdOk;
}
bool stillNow() {
  return g_still && (uint32_t)(g_lastMs - g_stillSince) >= 1000;
}
float gravity() {
  return g_g0;
}

void toCar(float x, float y, float z, float *lon, float *lat, float *vert) {
  V3 a = { x, y, z };
  V3 up = g_up;
  V3 fwd = horiz(g_fwd, up);  // 前を水平に直す
  V3 right = cross(fwd, up);
  *lon = dot(a, fwd);
  *lat = dot(a, right) * (float)IMU_LAT_SIGN;
  *vert = dot(a, up);
}

void car(float *lon, float *lat, float *vert) {
  toCar(g_last.x, g_last.y, g_last.z, lon, lat, vert);
  float k = 1.0f / g_g0;  // 倍率のずれを直す(停車中に 1 g になるように)
  *lon *= k;
  *lat *= k;
  *vert = *vert * k - 1.0f;  // 重力を引く
}

uint32_t calVersion() {
  return g_calVer;
}

void exportCal(float out[9]) {
  out[0] = g_up.x;
  out[1] = g_up.y;
  out[2] = g_up.z;
  out[3] = g_fwd.x;
  out[4] = g_fwd.y;
  out[5] = g_fwd.z;
  out[6] = g_levelOk ? 1.0f : 0.0f;
  out[7] = g_fwdOk ? 1.0f : 0.0f;
  out[8] = g_g0;
}

void importCal(const float in[9]) {
  V3 up = { in[0], in[1], in[2] }, fwd = { in[3], in[4], in[5] };
  float nu = norm(up), nf = norm(fwd);
  if (in[6] > 0.5f && nu > 0.9f && nu < 1.1f) {
    g_up = up;  // 保存したときの値をそのまま(長さは 1 に近い)
    g_lt = up;
    g_upAtVer = up;
    g_levelOk = true;
    g_upReject = 0;
  }
  if (in[7] > 0.5f && nf > 0.9f && nf < 1.1f) {
    g_fwd = fwd;
    g_fwdAtVer = fwd;
    g_fwdOk = true;
    g_fwdReject = 0;
  }
  g_g0 = (in[8] > 0.8f && in[8] < 1.2f) ? in[8] : 1.0f;
}

}  // namespace imu
