katsuhaa/abarth595-round-gauge/pc_test/unit_main.cpp

// unit_main.cpp - PC 上の単体試験: UART データの受け取り方、画面の操作(タップ・スワイプ・長押し)、設定、自動で戻る、
//                 車の CAN の生データから値を作る(veh。../logs/ の 10/22 の実車ログも流す)、本体の状態の「FPS」(2.3.0)、タコの赤(2.4.0)
#include "../meter_display/app.h"
#include "../meter_display/gfx.h"
#include "../meter_display/ui.h"
#include <math.h>
#include <stdio.h>
#include <stdlib.h>
#include <string.h>
#include <vector>

extern int g_hostBrightness, g_hostSaves, g_hostImuResets, g_hostBlank, g_hostBlinks, g_hostLevel, g_hostTimeSaves;
extern bool g_hostSaveOk;
extern unsigned char g_hostCanPre[];  // plat_pc.cpp: 「前後で比べる」の記録(NVS の代わり)
extern size_t g_hostCanPreN;
extern int g_hostCanPreSaves;
extern unsigned char g_hostOdo[];  // 2.15.0: 走行記録の保存領域
extern uint32_t g_hostOdoSize;
extern bool g_hostOdoWriteOk;
static uint16_t fb[gfx::W * gfx::H];
static float scratch[gfx::W * (gfx::H + 2)];
static Settings set;  // main で settingsDefaults(2.10.0)
static LinkStats ls;
static PerfStats ps;
static SysInfo si;
static int fails = 0, passes = 0;
#define CHECK(cond, what) do { if (cond) passes++; else { fails++; printf("FAIL: %s  (%s:%d)\n", what, __FILE__, __LINE__); } } while (0)

static std::vector<uint8_t> frame(uint8_t type, uint8_t seq, const void *p, uint8_t len) {
  uint8_t buf[ML_MAX_PAYLOAD + ML_OVERHEAD];
  size_t n = mlBuild(buf, type, seq, p, len);
  return std::vector<uint8_t>(buf, buf + n);
}
static MlSignals sigMsg(uint16_t rpm) {
  MlSignals s;
  memset(&s, 0, sizeof(s));
  s.valid = ML_V_RPM | ML_V_SPEED | ML_V_THROTTLE | ML_V_WATER | ML_V_FUEL | ML_V_GEAR | ML_V_BOOST;
  s.rpm = rpm; s.speed_c = 6000; s.throttle_h = 200; s.fuel_h = 124; s.water_d = 925; s.gear = '3'; s.boost_c = -45;
  return s;
}
static void upd(const Signals &s, uint32_t now) {
  ui::update(s, ls, ps, si, now);
  ui::update(s, ls, ps, si, now + 60);
  gfx::dirtyClear();
}
// 設定の中の下の帯「長押しで開く」を長押しして離す(2.4.4。2.4.3 までは帯のタップで開いていた)
static void holdOpen(const Signals &sg, uint32_t &tt) {
  ui::touchDown(233, 400, tt += 100);
  ui::update(sg, ls, ps, si, tt + TOUCH_CONFIRM_MS + 10);
  ui::update(sg, ls, ps, si, tt + HOLD_SHOW_MS + 10);
  ui::update(sg, ls, ps, si, tt + HOLD_MS);
  ui::touchUp(tt += HOLD_MS + 20);
  ui::update(sg, ls, ps, si, tt);
  ui::update(sg, ls, ps, si, tt + 60);
  gfx::dirtyClear();
}

int main() {
  settingsDefaults(&set);
  gfx::begin(fb, scratch);
  mlink::begin();
  cantab::begin();
  odo::begin();  // 2.15.0: 走行記録(PC 上では RAM の保存領域)
  ui::begin(&set);
  memset(&ps, 0, sizeof(ps));
  memset(&si, 0, sizeof(si));
  LinkStats st;
  Signals s;

  // ---------------- 1. 受け取り: CRC が合っている値のフレーム
  {
    MlSignals m = sigMsg(4200);
    auto f = frame(ML_TYPE_SIGNALS, 0, &m, sizeof(m));
    mlink::feed(f.data(), f.size(), 1000);
    mlink::getSignals(&s, 1000);
    CHECK(s.linkUp && s.rpmOk && s.rpm == 4200, "値のフレームを受ける");
    CHECK(s.waterOk && s.waterC > 92.4f && s.waterC < 92.6f && s.fuelPct == 62.0f && s.gear == '3', "水温 0.1℃・燃料 0.5% の換算");
    CHECK(s.speedKmh == 60.0f && s.throttlePct == 100.0f, "車速・アクセルの換算");
    CHECK(s.boostOk && s.boostBar > -0.451f && s.boostBar < -0.449f, "ブースト圧 0.01 bar の換算(負圧)");
    mlink::getSignals(&s, 1000 + LINK_TIMEOUT_MS);
    CHECK(s.linkUp, "LINK_TIMEOUT_MS ちょうどまでは受信あり");
    mlink::getSignals(&s, 1001 + LINK_TIMEOUT_MS);
    CHECK(!s.linkUp && !s.rpmOk, "LINK_TIMEOUT_MS を過ぎたら信号なし");
  }
  // ---------------- 2. 1 バイトずつ届いても同じ結果
  {
    MlSignals m = sigMsg(5100);
    auto f = frame(ML_TYPE_SIGNALS, 1, &m, sizeof(m));
    for (uint8_t b : f) mlink::feed(&b, 1, 2000);
    mlink::getSignals(&s, 2000);
    CHECK(s.rpm == 5100, "1 バイトずつ届いたフレーム");
  }
  // ---------------- 3. ごみ(XIAO の起動ログ)に続くフレーム、ごみに同期と同じ並びが混じる場合
  {
    mlink::getStats(&st);
    uint32_t crc0 = st.crcErrors, ok0 = st.framesOk;
    std::vector<uint8_t> w;
    const char *boot = "ESP-ROM:esp32c6-20220919\r\nBuild:Sep 19 2022\r\nrst:0x1 (POWERON),boot:0xc (SPI_FAST_FLASH_BOOT)\r\n";
    w.insert(w.end(), boot, boot + strlen(boot));
    const uint8_t fake[] = { 0xA5, 0x5A, 0x01, 0x07, (uint8_t)sizeof(MlSignals), 1, 2, 3 };  // 途中で切れた偽のフレーム(長さは値のフレームと同じ)
    w.insert(w.end(), fake, fake + sizeof(fake));
    MlSignals m = sigMsg(3300);
    auto f = frame(ML_TYPE_SIGNALS, 2, &m, sizeof(m));
    w.insert(w.end(), f.begin(), f.end());
    auto f2 = frame(ML_TYPE_SIGNALS, 3, &m, sizeof(m));
    w.insert(w.end(), f2.begin(), f2.end());
    mlink::feed(w.data(), w.size(), 3000);
    mlink::getSignals(&s, 3000);
    mlink::getStats(&st);
    CHECK(s.rpm == 3300 && st.framesOk == ok0 + 2, "ごみの後ろのフレームを 2 つとも拾う");
    CHECK(st.crcErrors == crc0 + 1, "途中で切れた偽のフレームは CRC 誤り 1 回");
    CHECK(st.junkBytes > 50, "ごみは捨てたバイトとして数える");
  }
  // ---------------- 4. 壊れたフレームと連番の飛び
  {
    mlink::getStats(&st);
    uint32_t crc0 = st.crcErrors, lost0 = st.lostFrames, ok0 = st.framesOk;
    MlSignals m = sigMsg(2500);
    auto bad = frame(ML_TYPE_SIGNALS, 4, &m, sizeof(m));
    bad[10] ^= 0x04;  // 中身を 1 ビット壊す
    mlink::feed(bad.data(), bad.size(), 3100);
    auto good = frame(ML_TYPE_SIGNALS, 8, &m, sizeof(m));  // 4〜7 が届かなかった
    mlink::feed(good.data(), good.size(), 3120);
    mlink::getStats(&st);
    mlink::getSignals(&s, 3120);
    CHECK(st.crcErrors == crc0 + 1, "1 ビット壊れたフレームは CRC 誤り");
    CHECK(st.framesOk == ok0 + 1 && s.rpm == 2500, "壊れたフレームは使わず、次のフレームを使う");
    CHECK(st.lostFrames == lost0 + 4, "連番の飛び 4 つぶんを欠落として数える");
    // 長い切れ目(受信なし)の後は、連番の飛びを数えない
    auto later = frame(ML_TYPE_SIGNALS, 200, &m, sizeof(m));
    mlink::feed(later.data(), later.size(), 3120 + LINK_TIMEOUT_MS + 500);
    mlink::getStats(&st);
    CHECK(st.lostFrames == lost0 + 4, "受信が途切れた後の最初のフレームでは欠落を数えない");
  }
  // ---------------- 5. CAN の生データ
  {
    uint8_t p[sizeof(MlCanHead) + 8];
    MlCanHead h;
    h.info = 0x40 | 8; h.id = 0x0618A001;
    uint8_t d[8] = { 0, 0x19, 0x10, 0x68, 7, 0x18, 0x46, 0x00 };
    memcpy(p, &h, sizeof(h)); memcpy(p + sizeof(h), d, 8);
    auto f = frame(ML_TYPE_CAN, 201, p, sizeof(p));
    mlink::feed(f.data(), f.size(), 5000);
    h.info = 0x80 | 0x40 | 4; h.id = 0x04214001;
    memcpy(p, &h, sizeof(h));
    auto f2 = frame(ML_TYPE_CAN, 202, p, sizeof(MlCanHead) + 4);
    mlink::feed(f2.data(), f2.size(), 5000);
    cantab::View v;
    CHECK(cantab::count() == 2, "CAN の ID を 2 つ覚える");
    CHECK(cantab::getView(0, &v) && v.id == 0x0618A001 && v.bus == 0 && v.ext == 1 && v.dlc == 8 && v.data[3] == 0x68, "C-CAN のフレームの中身");
    CHECK(cantab::getView(1, &v) && v.id == 0x04214001 && v.bus == 1 && v.dlc == 4, "B-CAN のフレーム(長さ 4)");
    // 「変化を記録」(10/23): 1 回目 = 全部が候補、2 回目から = 1〜CAN_REC_MAX_CHANGES 回だけ変わったバイトの ID に絞る
    uint16_t ce[8];
    uint8_t cm[8];
    CHECK(cantab::recordCount() == 0 && cantab::candidates(ce, cm, 8) == 0, "記録 0 回: 候補なし");
    CHECK(cantab::record() == 2 && cantab::recordCount() == 1, "1 回目の記録: 2 つとも候補");
    d[7] = 0x4C;
    h.info = 0x40 | 8; h.id = 0x0618A001;
    memcpy(p, &h, sizeof(h)); memcpy(p + sizeof(h), d, 8);
    auto f3 = frame(ML_TYPE_CAN, 203, p, sizeof(p));
    mlink::feed(f3.data(), f3.size(), 5100);
    CHECK(cantab::record() == 1, "2 回目: 1 回だけ変わった 0618A001 だけが残る");
    int n = cantab::candidates(ce, cm, 8);
    CHECK(n == 1 && ce[0] == 0 && cm[0] == 0x80, "候補は 0618A001 の b7");
    for (int i = 0; i < CAN_REC_MAX_CHANGES + 2; i++) {  // 動き続ける(回数が多い)と外れる
      d[7] = (uint8_t)(0x10 + i);
      cantab::onFrame(0, 1, 0x0618A001, 8, d, 5200 + i);
    }
    CHECK(cantab::record() == 0, "3 回目: CAN_REC_MAX_CHANGES 回より多く変わったバイトは外れる");
    int hist[CAN_REC_HIST];
    int nh = cantab::recordHistory(hist);
    CHECK(nh == 3 && hist[0] == 2 && hist[1] == 1 && hist[2] == 0, "件数の移り変わり 2 → 1 → 0");
    cantab::clearRecord();
    CHECK(cantab::recordCount() == 0 && cantab::candidates(ce, cm, 8) == 0 && cantab::recordHistory(hist) == 0, "やり直すと記録 0 回");
    // 長さが合わない CAN フレームは受け付けない
    mlink::getStats(&st);
    uint32_t ok0 = st.framesOk;
    h.info = 0x40 | 8;
    memcpy(p, &h, sizeof(h));
    auto f4 = frame(ML_TYPE_CAN, 204, p, sizeof(MlCanHead) + 3);
    mlink::feed(f4.data(), f4.size(), 5200);
    mlink::getStats(&st);
    CHECK(st.framesOk == ok0, "長さの合わない CAN フレームは使わない");
  }

  // ---------------- 6. 画面の操作(2.1.0 / 2.3.0 / 2.4.0): タッチは TOUCH_CONFIRM_MS 押し続けたら決まる(短いタッチは何もしない)。
  //                  2.4.0: どの画面も離したときに決める。左へスワイプ = 次、右へ = 前(2.4.2。サーキット・タコ・データは画面、設定の中は
  //                  項目・ページ)。動きが HOLD_CANCEL_PX 未満ならタップ。サーキット・タコ・データは長押しで設定、タッチが決まったら案内
  Signals live;
  memset(&live, 0, sizeof(live));
  live.linkUp = live.rpmOk = live.waterOk = live.fuelOk = live.gearOk = live.speedOk = live.throttleOk = true;
  live.rpm = 3000; live.waterC = 90; live.fuelPct = 50; live.gear = '2';
  const int TOPX = 233, TOPY = 60, BOTX = 233, BOTY = 400, LX = 100, RX = 366, MY = 233;
  uint32_t t = 10000;
  // 長押し(HOLD_MS)で設定に入って離す
  auto longPress = [&](const Signals &sg, uint32_t &tt) {
    ui::touchDown(233, 233, tt += 100);
    ui::update(sg, ls, ps, si, tt + TOUCH_CONFIRM_MS + 10);
    ui::update(sg, ls, ps, si, tt + HOLD_SHOW_MS + 10);
    ui::update(sg, ls, ps, si, tt + HOLD_MS);
    ui::touchUp(tt += HOLD_MS + 50);
    upd(sg, tt);
  };
  // 真ん中から (dx, dy) だけ指を動かして離す(途中の知らせ 2 回)。触れてから離すまで ms
  auto swipe = [&](const Signals &sg, uint32_t &tt, int dx, int dy, uint32_t ms = TOUCH_CONFIRM_MS + 100) {
    ui::touchDown(233, 233, tt += 100);
    ui::update(sg, ls, ps, si, tt + 20);
    ui::touchMove(233 + dx / 2, 233 + dy / 2, tt + ms / 3);
    ui::touchMove(233 + dx, 233 + dy, tt + ms * 2 / 3);
    ui::update(sg, ls, ps, si, tt + ms * 2 / 3 + 5);
    ui::touchUp(tt += ms);
    upd(sg, tt);
  };
  // 設定の中などの送り(指で左へ = 次、右へ = 前)
  auto next = [&](uint32_t &tt) { swipe(live, tt, -200, 0); };
  auto prev = [&](uint32_t &tt) { swipe(live, tt, 200, 0); };
  ui::testShow(ui::SC_DRIVE);
  upd(live, t);
  CHECK(ui::screen() == ui::SC_DRIVE, "サーキットから");
  // スワイプ(2.4.2: 左へ = 次、右へ = 前。2.4.0〜2.4.1 の右へ = 次を戻した。本人「間違えました 左にスワイプでタコでした」)
  swipe(live, t, -200, 10);
  CHECK(ui::screen() == ui::SC_BOOST, "スワイプ: 左へでタコ(次)");
  swipe(live, t, -(SWIPE_MIN_PX + 10), -20);
  CHECK(ui::screen() == ui::SC_DATA, "スワイプ: 左へでデータ(次)");
  swipe(live, t, -200, 0);
  CHECK(ui::screen() == ui::SC_DRIVE, "スワイプ: データの次はサーキット");
  swipe(live, t, 200, 0);
  CHECK(ui::screen() == ui::SC_DATA, "スワイプ: 右へで前(サーキットの前はデータ)");
  swipe(live, t, 200, 0);
  CHECK(ui::screen() == ui::SC_BOOST && !ui::testHolding() && !ui::testGuide(), "スワイプ: 右へで前(データの前はタコ)。離したら案内・長押しの表示は消える");
  swipe(live, t, -(SWIPE_MIN_PX - 10), 0);
  CHECK(ui::screen() == ui::SC_BOOST, "スワイプ: 横の動きが SWIPE_MIN_PX 未満なら替えない(2.2.0: 80 px では替わっていた幅)");
  swipe(live, t, -80, 0);
  CHECK(ui::screen() == ui::SC_BOOST, "スワイプ: 2.1.0 で替わっていた 80 px では替えない");
  swipe(live, t, -200, 110);
  CHECK(ui::screen() == ui::SC_BOOST, "スワイプ: 斜め(横が縦の SWIPE_DIR_RATIO 倍未満)なら替えない");
  swipe(live, t, 0, -150);
  CHECK(ui::screen() == ui::SC_BOOST, "スワイプ: 縦は何もしない");
  swipe(live, t, -200, 0, TOUCH_CONFIRM_MS - 60);
  CHECK(ui::screen() == ui::SC_BOOST, "スワイプ: TOUCH_CONFIRM_MS より短いスワイプは何もしない(2.3.0)");
  swipe(live, t, -200, 0, TOUCH_CONFIRM_MS + 1);
  CHECK(ui::screen() == ui::SC_DATA, "スワイプ: TOUCH_CONFIRM_MS 押していれば替える(update でまだ決めていなくても、離したときに確かめる)");
  swipe(live, t, 200, 0);
  CHECK(ui::screen() == ui::SC_BOOST, "スワイプ: 右へでタコに戻る");
  // 短いタッチ(タップ)は何もしない。案内も出さない
  ui::touchDown(233, 233, t += 100);
  ui::update(live, ls, ps, si, t + TOUCH_CONFIRM_MS - 20);
  CHECK(!ui::testGuide(), "案内: タッチが決まる前は出さない");
  ui::touchUp(t += TOUCH_CONFIRM_MS - 10);
  upd(live, t);
  CHECK(ui::screen() == ui::SC_BOOST && !ui::testHolding() && !ui::testGuide(), "タコ: 短いタッチは何もしない");
  ui::tap(233, 233, t += 100); upd(live, t);
  CHECK(ui::screen() == ui::SC_BOOST, "タコ: タップ(ui::tap)も何もしない");
  // 案内(2.4.0: 上に「‹ スワイプ ›」、下に「長押し ▶ 設定」)。出している間は描き直さない。指が HOLD_CANCEL_PX 以上ずれたら、
  // 案内のまま長押しの札を灰にする(元の画面に戻さない。本人「タッチしているのかを認識しているかが分かりづらい」)。離したら消して描き直す
  {
    ui::touchDown(233, 233, t += 100);
    ui::update(live, ls, ps, si, t + TOUCH_CONFIRM_MS + 10);
    CHECK(ui::testGuide() && ui::testGuideMode() == 0 && ui::screen() == ui::SC_BOOST && gfx::dirtyCount() > 0, "案内: タッチが決まったら出す(2.3.0)");
    gfx::dirtyClear();
    Signals l2 = live;
    l2.rpm = 4500;
    ui::update(l2, ls, ps, si, t + TOUCH_CONFIRM_MS + 30);
    CHECK(ui::testGuide() && gfx::dirtyCount() == 0, "案内: 出している間は回転数が変わっても描き直さない");
    ui::touchMove(233 + HOLD_CANCEL_PX - 10, 236, t + TOUCH_CONFIRM_MS + 40);
    ui::update(l2, ls, ps, si, t + TOUCH_CONFIRM_MS + 50);
    CHECK(ui::testGuide() && ui::testGuideMode() == 0 && gfx::dirtyCount() == 0, "案内: HOLD_CANCEL_PX 未満のずれでは何も変えない(2.4.0: 30 → 80 px)");
    ui::touchMove(233 + HOLD_CANCEL_PX + 10, 236, t + TOUCH_CONFIRM_MS + 60);
    ui::update(l2, ls, ps, si, t + TOUCH_CONFIRM_MS + 70);
    CHECK(ui::testGuide() && ui::testGuideMode() == 2 && gfx::dirtyCount() > 0 && ui::screen() == ui::SC_BOOST, "案内: HOLD_CANCEL_PX 以上ずれたら、案内のまま長押しの札を灰(2.4.0)");
    gfx::dirtyClear();
    ui::touchMove(233 + SWIPE_MIN_PX + 5, 238, t + TOUCH_CONFIRM_MS + 80);
    ui::update(l2, ls, ps, si, t + TOUCH_CONFIRM_MS + 90);
    CHECK(ui::testGuide() && ui::testGuideMode() == 2 && gfx::dirtyCount() == 0, "案内: 灰にしたあとは、動かしても描き直さない");
    ui::update(l2, ls, ps, si, t + HOLD_MS + 100);
    CHECK(ui::testGuide() && !ui::testHolding() && ui::screen() == ui::SC_BOOST, "案内: ずれたら長押しにならない(HOLD_MS を過ぎても案内のまま)");
    ui::touchMove(233 + 20, 236, t + HOLD_MS + 110);  // 戻してから離す: スワイプにならない
    ui::touchUp(t += HOLD_MS + 120);
    ui::update(live, ls, ps, si, t);
    CHECK(!ui::testGuide() && ui::screen() == ui::SC_BOOST && gfx::dirtyCount() > 0, "案内: 離したら消して描き直す(スワイプの所から戻して離せば替えない)");
    gfx::dirtyClear();
    // タッチが決まる前に動き出していたら(スワイプの途中)案内は出さない
    ui::touchDown(233, 233, t += 100);
    ui::touchMove(233 + HOLD_CANCEL_PX + 10, 234, t + TOUCH_CONFIRM_MS / 2);
    ui::update(live, ls, ps, si, t + TOUCH_CONFIRM_MS + 10);
    CHECK(!ui::testGuide(), "案内: 決まる前に動き出していたら出さない(スワイプの途中)");
    ui::touchUp(t += TOUCH_CONFIRM_MS + 20);
    upd(live, t);
    CHECK(ui::screen() == ui::SC_BOOST, "案内: そのまま離してもスワイプにならない所なら替えない");
  }
  // 長押し: タッチが決まったら案内、HOLD_SHOW_MS で長押しの途中(2.4.0: 案内のまま、スワイプの札を灰にして外周)、HOLD_MS で設定へ。
  // 押したままでも画面は回らず、離してもタップにしない
  ui::touchDown(233, 233, t += 100);
  ui::update(live, ls, ps, si, t + TOUCH_CONFIRM_MS + 10);
  ui::update(live, ls, ps, si, t + HOLD_SHOW_MS - 10);
  CHECK(ui::testGuide() && !ui::testHolding() && ui::testGuideMode() == 0, "長押し: HOLD_SHOW_MS より前は案内だけ");
  ui::touchMove(236, 231, t + HOLD_SHOW_MS);  // HOLD_CANCEL_PX 未満のずれは取り消さない
  ui::update(live, ls, ps, si, t + HOLD_SHOW_MS + 10);
  CHECK(ui::testHolding() && ui::testGuide() && ui::testGuideMode() == 1 && ui::screen() == ui::SC_BOOST, "長押し: HOLD_SHOW_MS で長押しの途中(案内のまま、スワイプの札を灰。2.4.0)");
  ui::update(live, ls, ps, si, t + HOLD_MS - 10);
  CHECK(ui::testHolding() && ui::screen() == ui::SC_BOOST, "長押し: HOLD_MS の手前ではまだタコ");
  ui::update(live, ls, ps, si, t + HOLD_MS);
  CHECK(ui::screen() == ui::SC_SET_LIST && ui::testSetCat() == 0, "長押し HOLD_MS で設定の 1 つ目のカテゴリ(画面。2.12.0)");
  ui::update(live, ls, ps, si, t + 3 * HOLD_MS);
  CHECK(ui::screen() == ui::SC_SET_LIST, "押したままでも設定のまま(画面は回らない)");
  ui::touchUp(t += 3 * HOLD_MS + 50);
  upd(live, t);
  CHECK(ui::screen() == ui::SC_SET_LIST && ui::testSetCat() == 0 && !ui::testHolding(), "離してもタップにしない(設定のカテゴリはそのまま)");
  ui::tap(TOPX, TOPY, t += 100); upd(live, t);
  CHECK(ui::screen() == ui::SC_BOOST, "設定: 上の帯「‹ 設定」で来た画面(タコ)へ");
  // 長押しの取り消し(2.4.0): 長押しの途中で HOLD_CANCEL_PX 以上動いたら、外周を消し(描き直す)、案内のまま長押しの札を灰。設定に入らない
  ui::touchDown(233, 233, t += 100);
  ui::update(live, ls, ps, si, t + TOUCH_CONFIRM_MS + 10);
  ui::update(live, ls, ps, si, t + HOLD_SHOW_MS + 10);
  CHECK(ui::testHolding(), "取り消し: まず長押しの途中の表示が出る");
  ui::touchMove(233, 233 + HOLD_CANCEL_PX, t + HOLD_SHOW_MS + 20);
  ui::update(live, ls, ps, si, t + HOLD_SHOW_MS + 30);
  CHECK(!ui::testHolding() && ui::testGuide() && ui::testGuideMode() == 2 && ui::screen() == ui::SC_BOOST, "取り消し: HOLD_CANCEL_PX 動いたら外周を消し、案内のまま長押しの札を灰(2.4.0: 元の画面に戻さない)");
  ui::update(live, ls, ps, si, t + 2 * HOLD_MS);
  CHECK(ui::screen() == ui::SC_BOOST && !ui::testHolding() && ui::testGuide(), "取り消し: HOLD_MS を過ぎても設定に入らない(離すまで案内)");
  ui::touchUp(t += 2 * HOLD_MS + 10);
  upd(live, t);
  CHECK(ui::screen() == ui::SC_BOOST && !ui::testGuide(), "取り消し: 離しても何もしない(縦の動きはスワイプでない)");
  gfx::dirtyClear();
  // 少しずれても長押しになる(2.4.0: HOLD_CANCEL_PX 30 → 80。本人「少しだけ指がずれたときに長押しになりません」)
  ui::touchDown(233, 233, t += 100);
  ui::update(live, ls, ps, si, t + TOUCH_CONFIRM_MS + 10);
  ui::touchMove(233 + 50, 233 + 30, t + TOUCH_CONFIRM_MS + 50);
  ui::update(live, ls, ps, si, t + HOLD_SHOW_MS + 10);
  CHECK(ui::testHolding() && ui::testGuideMode() == 1, "長押し: 58 px のずれ(2.3.1 の 30 px では取り消していた)でも長押しの途中");
  ui::update(live, ls, ps, si, t + HOLD_MS);
  CHECK(ui::screen() == ui::SC_SET_LIST, "長押し: 少しずれても HOLD_MS で設定");
  ui::touchUp(t += HOLD_MS + 50);
  upd(live, t);
  ui::tap(TOPX, TOPY, t += 100); upd(live, t);
  CHECK(ui::screen() == ui::SC_BOOST, "設定: 上の帯「‹ 設定」でタコへ");
  // 設定(長押しで入る。前回見ていたカテゴリから)。2.12.0: 6 カテゴリ(画面・シフトポイント・水温・過負荷・受信の状態・本体の状態・その他)
  longPress(live, t);
  CHECK(ui::screen() == ui::SC_SET_LIST && ui::testSetCat() == 0, "長押しで設定へ(最初は 1 つ目のカテゴリ = 走行記録。2.15.3)");
  // 項目の送り: スワイプ(2.4.0。本人「設定の項目移動もスワイプにしないとオペレーションがあわない」。左へ = 次、右へ = 前)と、
  // 左右の「‹」「›」(左半分・右半分)のタップ(2.4.1: 2.4.0 でやめたのを戻した。本人「ボタンの方がわかりやすい」)
  next(t); next(t);
  CHECK(ui::screen() == ui::SC_SET_LIST && ui::testSetCat() == 2, "設定: 左へスワイプで次のカテゴリ(サーキット → タコと同じ向き)");
  ui::tap(RX, MY, t += 100); upd(live, t);
  CHECK(ui::screen() == ui::SC_SET_LIST && ui::testSetCat() == 3, "設定: 右の「›」(右半分)のタップで次(2.4.1)");
  ui::tap(LX, MY, t += 100); upd(live, t);
  CHECK(ui::screen() == ui::SC_SET_LIST && ui::testSetCat() == 2, "設定: 左の「‹」(左半分)のタップで前");
  ui::touchDown(RX, MY, t += 100);
  ui::update(live, ls, ps, si, t + TOUCH_CONFIRM_MS + 10);
  CHECK(ui::testSetCat() == 2, "設定: 右半分を押している間はまだ送らない(離したときに決める)");
  ui::touchUp(t += TOUCH_CONFIRM_MS + 30);
  upd(live, t);
  CHECK(ui::testSetCat() == 3, "設定: 右半分を押して離したら次");
  ui::touchDown(LX, MY, t += 100);
  ui::touchMove(LX + 30, MY, t + 50);
  ui::update(live, ls, ps, si, t + TOUCH_CONFIRM_MS + 10);
  ui::touchUp(t += TOUCH_CONFIRM_MS + 30);
  upd(live, t);
  CHECK(ui::testSetCat() == 2, "設定: 動きが HOLD_CANCEL_PX 未満なら、触れた側(左半分)のタップ = 前");
  ui::tap(TOPX, TOPY, t += 100); upd(live, t);
  longPress(live, t);
  CHECK(ui::screen() == ui::SC_SET_LIST && ui::testSetCat() == 2, "設定は前回見ていたカテゴリから(電源を切るまで覚える)");
  prev(t); prev(t); prev(t);
  CHECK(ui::testSetCat() == 6, "右へスワイプで前へ(最初から最後のその他に回る。2.12.0: 6 カテゴリ。2.15.0: 走行記録で 7)");
  next(t);
  CHECK(ui::testSetCat() == 0, "左へスワイプ(最後の次は最初の画面)");
  // 指で押す(2.4.0: 離したときにタップ)。短いタッチと、HOLD_CANCEL_PX 以上動いたタッチは何もしない
  ui::touchDown(BOTX, BOTY, t += 100);
  ui::update(live, ls, ps, si, t + TOUCH_CONFIRM_MS - 10);
  ui::touchUp(t += TOUCH_CONFIRM_MS - 5);
  upd(live, t);
  CHECK(ui::screen() == ui::SC_SET_LIST, "設定: 短いタッチは何もしない(2.3.0)");
  ui::touchDown(BOTX, BOTY, t += 100);
  ui::touchMove(BOTX + HOLD_CANCEL_PX + 20, BOTY, t + 50);
  ui::update(live, ls, ps, si, t + TOUCH_CONFIRM_MS + 10);
  ui::touchUp(t += TOUCH_CONFIRM_MS + 30);
  upd(live, t);
  CHECK(ui::screen() == ui::SC_SET_LIST && ui::testSetCat() == 0, "設定: HOLD_CANCEL_PX 以上動いて離したタッチ(スワイプ未満)は何もしない");
  // 2.4.4: 下の帯「長押しで開く」は、タップでは開かず、長押し(HOLD_MS)で開く。2.5.0: HOLD_SHOW_MS で帯が水色になり外周が回る
  // (決まっただけでは帯を変えない)。動いたら取り消し(帯の字は灰、外周は消す)
  {
    auto countIn = [&](uint16_t c, int x0, int y0, int x1, int y1) {
      int n = 0;
      for (int y = y0; y < y1; y++)
        for (int x = x0; x < x1; x++) n += fb[y * gfx::W + x] == c;
      return n;
    };
    const uint16_t ACC = gfx::rgb(0x5FD0FF), DIM = gfx::rgb(0x5A606A), TRACK = gfx::rgb(0x1A2433);
    CHECK(countIn(ACC, 100, 380, 366, 466) > 1500 && countIn(ACC, 100, 380, 366, 466) < 6000, "項目の画面: 下の帯は「長押しで開く」(暗い帯に水色の字)");
    ui::touchDown(BOTX, BOTY, t += 100);
    ui::update(live, ls, ps, si, t + TOUCH_CONFIRM_MS + 10);
    CHECK(!ui::testGuide() && !ui::testHolding() && countIn(ACC, 100, 380, 366, 466) < 6000, "押して決まっただけでは帯を変えない(2.5.0)");
    ui::update(live, ls, ps, si, t + HOLD_SHOW_MS + 10);
    CHECK(ui::testHolding() && ui::testGuide() && countIn(ACC, 100, 380, 366, 466) > 10000 && countIn(TRACK, 0, 0, 466, 30) > 100 && ui::screen() == ui::SC_SET_LIST,
          "HOLD_SHOW_MS で帯が水色になり、外周が回り始める(まだ開かない。2.5.0)");
    ui::touchUp(t += HOLD_SHOW_MS + 30);
    upd(live, t);
    CHECK(ui::screen() == ui::SC_SET_LIST && !ui::testGuide() && countIn(TRACK, 0, 0, 466, 30) == 0 && countIn(ACC, 100, 380, 366, 466) < 6000,
          "HOLD_MS の前に離したら開かない(タップでは開かない)。帯と外周は元に戻る");
    ui::touchDown(BOTX, BOTY, t += 100);
    ui::update(live, ls, ps, si, t + TOUCH_CONFIRM_MS + 10);
    ui::update(live, ls, ps, si, t + HOLD_SHOW_MS + 10);
    ui::touchMove(BOTX + HOLD_CANCEL_PX + 5, BOTY, t + HOLD_SHOW_MS + 20);
    ui::update(live, ls, ps, si, t + HOLD_SHOW_MS + 30);
    CHECK(!ui::testHolding() && ui::testGuide() && ui::testGuideMode() == 2 && countIn(DIM, 100, 380, 366, 466) > 1000 && countIn(TRACK, 0, 0, 466, 30) == 0,
          "長押しの途中で動いたら取り消し: 外周を消し、帯の字を灰に");
    ui::update(live, ls, ps, si, t + 2 * HOLD_MS);
    CHECK(ui::screen() == ui::SC_SET_LIST, "取り消したら HOLD_MS を過ぎても開かない");
    ui::touchUp(t += 2 * HOLD_MS + 10);
    upd(live, t);
    CHECK(ui::screen() == ui::SC_SET_LIST && !ui::testGuide() && countIn(DIM, 100, 380, 366, 466) == 0, "取り消して離したら帯は元に戻る(何もしない)");
    ui::tap(BOTX, BOTY, t += 100); upd(live, t);
    CHECK(ui::screen() == ui::SC_SET_LIST, "下の帯のタップでは開かない(2.4.4)");
    // 2.4.5: 長押しは画面のどこでも(本人「長押しで開くはその場所ではなく画面全体です」)。短いタップはその所のタップ。
    // 2.5.0: 矢印(左右の半分)のタップ・スワイプでは帯を変えない(本人「設定で左右の矢印をタップした時に長押しで開くボタンが反転して
    // しまうので混乱します」)
    ui::touchDown(RX, MY, t += 100);
    ui::update(live, ls, ps, si, t + TOUCH_CONFIRM_MS + 10);
    CHECK(!ui::testGuide() && countIn(ACC, 100, 380, 366, 466) > 1500 && countIn(ACC, 100, 380, 366, 466) < 6000, "右の矢印を押して決まっても、下の帯は変えない(2.5.0)");
    ui::update(live, ls, ps, si, t + TOUCH_CONFIRM_MS + 60);
    CHECK(!ui::testGuide() && countIn(ACC, 100, 380, 366, 466) < 6000, "右の矢印を押している間(HOLD_SHOW_MS の前)も、下の帯は変えない(2.5.0)");
    ui::touchUp(t += TOUCH_CONFIRM_MS + 80);
    upd(live, t);
    CHECK(ui::screen() == ui::SC_SET_LIST && ui::testSetCat() == 1 && !ui::testGuide(), "右の矢印を押してすぐ離したのはタップ(次)");
    {
      bool band = true;
      ui::touchDown(RX, MY, t += 100);
      ui::update(live, ls, ps, si, t + TOUCH_CONFIRM_MS + 10);
      band = band && countIn(ACC, 100, 380, 366, 466) < 6000 && countIn(DIM, 100, 380, 366, 466) == 0;
      ui::touchMove(RX - 100, MY, t + TOUCH_CONFIRM_MS + 40);
      ui::update(live, ls, ps, si, t + TOUCH_CONFIRM_MS + 50);
      band = band && countIn(ACC, 100, 380, 366, 466) < 6000 && countIn(DIM, 100, 380, 366, 466) == 0;
      ui::touchMove(RX - 200, MY, t + TOUCH_CONFIRM_MS + 80);
      ui::update(live, ls, ps, si, t + TOUCH_CONFIRM_MS + 90);
      band = band && countIn(ACC, 100, 380, 366, 466) < 6000 && countIn(DIM, 100, 380, 366, 466) == 0 && !ui::testGuide();
      ui::touchUp(t += TOUCH_CONFIRM_MS + 100);
      upd(live, t);
      CHECK(band && ui::screen() == ui::SC_SET_LIST && ui::testSetCat() == 2, "スワイプ(次)の途中も、下の帯は水色にも灰にもしない(2.5.0)");
    }
    prev(t);
    prev(t);
    ui::touchDown(RX, MY, t += 100);
    ui::update(live, ls, ps, si, t + TOUCH_CONFIRM_MS + 10);
    ui::update(live, ls, ps, si, t + HOLD_SHOW_MS + 10);
    CHECK(ui::testHolding() && countIn(ACC, 100, 380, 366, 466) > 10000, "右の矢印でも、HOLD_SHOW_MS 押し続けたら帯が水色になり外周が回る(長押し)");
    ui::touchMove(RX, MY + HOLD_CANCEL_PX + 10, t + HOLD_SHOW_MS + 20);  // 縦に動かして取り消し、離す(タップにもスワイプにもならない)
    ui::update(live, ls, ps, si, t + HOLD_SHOW_MS + 30);
    ui::touchUp(t += HOLD_SHOW_MS + 40);
    upd(live, t);
    CHECK(ui::screen() == ui::SC_SET_LIST && ui::testSetCat() == 0 && !ui::testGuide() && countIn(ACC, 100, 380, 366, 466) < 6000 && countIn(TRACK, 0, 0, 466, 30) == 0,
          "取り消して離したら、帯と外周は元に戻る");
    // 2.7.0: 外周が出たあと(HOLD_SHOW_MS から)HOLD_MS の前に、動かさずに離したら何もしない(本人「長押しを認識して、アニメーションが
    // 出た後に指を離した場合は何も動作しないほうがいい」。2.6.0 までは、その所のタップになって次・前・戻るに移っていた)
    ui::touchDown(RX, MY, t += 100);
    ui::update(live, ls, ps, si, t + TOUCH_CONFIRM_MS + 10);
    ui::update(live, ls, ps, si, t + HOLD_SHOW_MS + 10);
    ui::touchUp(t += HOLD_SHOW_MS + 200);
    upd(live, t);
    CHECK(ui::screen() == ui::SC_SET_LIST && ui::testSetCat() == 0 && !ui::testGuide() && countIn(ACC, 100, 380, 366, 466) < 6000 && countIn(TRACK, 0, 0, 466, 30) == 0,
          "外周が出てから HOLD_MS の前に離したら何もしない(次へ動かない。帯と外周は元に戻る。2.7.0)");
    ui::touchDown(TOPX, TOPY, t += 100);
    ui::update(live, ls, ps, si, t + TOUCH_CONFIRM_MS + 10);
    ui::update(live, ls, ps, si, t + HOLD_SHOW_MS + 10);
    ui::touchUp(t += HOLD_MS - 100);
    upd(live, t);
    CHECK(ui::screen() == ui::SC_SET_LIST && ui::testSetCat() == 0, "上の帯でも、外周が出てから離したら戻らない(2.7.0)");
    ui::touchDown(RX, MY, t += 100);
    ui::update(live, ls, ps, si, t + TOUCH_CONFIRM_MS + 10);
    ui::touchUp(t += HOLD_SHOW_MS - 50);
    upd(live, t);
    CHECK(ui::screen() == ui::SC_SET_LIST && ui::testSetCat() == 1, "外周が出る前(HOLD_SHOW_MS より前)に離したのはタップ(次。2.15.3: 2 つ目 = 画面)");
    for (int k = 0; k < 3; k++) {  // 上の帯・真ん中・左半分の長押しでも開く
      static const int px[3] = { TOPX, MY, LX }, py[3] = { TOPY, MY, MY };
      ui::touchDown(px[k], py[k], t += 100);
      ui::update(live, ls, ps, si, t + TOUCH_CONFIRM_MS + 10);
      ui::update(live, ls, ps, si, t + HOLD_SHOW_MS + 10);
      ui::update(live, ls, ps, si, t + HOLD_MS);
      CHECK(ui::screen() == ui::SC_SET_CAT && ui::testSetCat() == 1 && ui::testSetItem() == 0,
            k == 0 ? "上の帯の長押しで開く(カテゴリの中の明るさ。2.4.5・2.12.0)" : k == 1 ? "真ん中の長押しで開く(2.4.5)" : "左半分の長押しで開く(2.4.5)");
      ui::touchUp(t += HOLD_MS + 20);
      upd(live, t);
      CHECK(ui::screen() == ui::SC_SET_CAT, "開いたあとに離しても、タップにはならない");
      ui::tap(TOPX, TOPY, t += 100); upd(live, t);
    }
    CHECK(ui::screen() == ui::SC_SET_LIST && ui::testSetCat() == 1, "カテゴリの中の上「‹ 画面」で設定の段の画面へ(2.12.0)");
  }
  holdOpen(live, t);
  CHECK(ui::screen() == ui::SC_SET_CAT && ui::testSetItem() == 0, "設定の段の長押しでカテゴリの中(画面 → 明るさ。2.12.0)");
  ui::touchDown(BOTX, BOTY, t += 100);
  ui::update(live, ls, ps, si, t + TOUCH_CONFIRM_MS + 10);
  ui::update(live, ls, ps, si, t + HOLD_MS);
  CHECK(ui::screen() == ui::SC_SET_EDIT && ui::testSetItem() == 0, "カテゴリの中: 下の帯を HOLD_MS 押し続けても開く(明るさの変更へ)");
  ui::update(live, ls, ps, si, t + 3 * HOLD_MS);
  ui::touchUp(t += 3 * HOLD_MS + 10);
  upd(live, t);
  CHECK(ui::screen() == ui::SC_SET_EDIT, "開いたあとに離しても、変更の画面の「決定」にはならない");
  ui::tap(TOPX, TOPY, t += 100); upd(live, t);
  CHECK(ui::screen() == ui::SC_SET_CAT && ui::testSetItem() == 0, "変更: 上「‹ 戻る」で明るさの項目へ");
  next(t); next(t);
  CHECK(ui::screen() == ui::SC_SET_CAT && ui::testSetItem() == 2, "画面の中: 明るさ・イルミネーションの明るさ・自動で戻る");
  next(t);
  CHECK(ui::testSetItem() == 0, "カテゴリの中: 最後の次は最初(カテゴリの中で回る)");
  prev(t);
  CHECK(ui::testSetItem() == 2, "カテゴリの中: 最初の前は最後");
  ui::tap(TOPX, TOPY, t += 100); upd(live, t);
  CHECK(ui::screen() == ui::SC_SET_LIST && ui::testSetCat() == 1, "カテゴリの中: 上「‹ 画面」で設定の段");
  // 受信の状態(2.12.0: 4 つ目のカテゴリ。2.15.3: 5 つ目): CAN・GPS・IMU・RaceChrono の 4 グループ(まとめ。下「開く」で中へ)。中は 1 ページ 1 項目
  next(t); next(t); next(t);
  holdOpen(live, t);
  CHECK(ui::screen() == ui::SC_SET_INFO && ui::testPage() == 0, "5 つ目のカテゴリ(受信の状態)の下「長押しで開く」で受信の状態(1 ページ目 = CAN)");
  next(t);
  CHECK(ui::screen() == ui::SC_SET_INFO && ui::testPage() == 1, "受信の状態: 左へスワイプで次のグループ(GPS)");
  ui::tap(RX, MY, t += 100); upd(live, t);
  CHECK(ui::screen() == ui::SC_SET_INFO && ui::testPage() == 2, "受信の状態: 右の「›」のタップで次(IMU)");
  ui::tap(LX, MY, t += 100); upd(live, t);
  CHECK(ui::screen() == ui::SC_SET_INFO && ui::testPage() == 1, "受信の状態: 左の「‹」のタップで前(GPS)");
  prev(t); prev(t);
  CHECK(ui::screen() == ui::SC_SET_INFO && ui::testPage() == 3, "受信の状態: 最初の前は最後の RaceChrono");
  holdOpen(live, t);
  CHECK(ui::screen() == ui::SC_SET_GRP && ui::testGroup() == 3 && ui::testPage() == 0, "RaceChrono の下「長押しで開く」で中(1 ページ目 = 送信)");
  next(t); next(t); next(t);
  CHECK(ui::screen() == ui::SC_SET_GRP && ui::testPage() == 0, "RaceChrono の中: 3 ページで回る(送信・接続・送った数)");
  ui::tap(TOPX, TOPY, t += 100); upd(live, t);
  CHECK(ui::screen() == ui::SC_SET_INFO && ui::testPage() == 3, "RaceChrono の中: 上「‹ RaceChrono」で受信の状態の RaceChrono のページ");
  next(t);
  ui::tap(BOTX, BOTY, t += 100); upd(live, t);
  CHECK(ui::screen() == ui::SC_SET_INFO, "受信の状態: 下の帯のタップでは開かない(2.4.4)");
  holdOpen(live, t);
  CHECK(ui::screen() == ui::SC_SET_GRP && ui::testGroup() == 0 && ui::testPage() == 0, "CAN の下「長押しで開く」で中(1 ページ目 = 通信速度)");
  prev(t);
  CHECK(ui::testPage() == 8, "CAN の中: 最初の前は最後の「前後で比べる」(2.6.0。2.9.0: 9 ページ)");
  prev(t);
  CHECK(ui::testPage() == 7, "CAN の中: その前が CAN確認(2.4.3)");
  // CAN確認(2.4.0: CAN の「C-CAN・B-CAN」の下「CAN確認」。CAN のメニューは 1 つ)
  {
    uint8_t d[8] = { 0, 0x19, 0x10, 0x68, 7, 0x18, 0x46, 0x77 };
    cantab::onFrame(0, 1, 0x0618A001, 8, d, t);
    ui::tap(BOTX, BOTY, t += 100); upd(live, t);
    CHECK(ui::screen() == ui::SC_SET_GRP, "CAN確認のページ: 下の帯のタップでは開かない(2.4.4)");
    holdOpen(live, t);
    CHECK(ui::screen() == ui::SC_CAN, "CAN確認: CAN確認のページの下「長押しで開く」で CAN の画面(2.4.4)");
    ui::tap(RX, MY, t += 100); upd(live, t);
    CHECK(ui::screen() == ui::SC_CAN, "記録 0 回では一覧へ行かない");
    ui::tap(BOTX, BOTY, t += 100); upd(live, t);
    CHECK(cantab::recordCount() == 1, "下「変化を記録」で 1 回目の記録");
    d[7] = 0x78;
    cantab::onFrame(0, 1, 0x0618A001, 8, d, t);
    ui::tap(BOTX, BOTY, t += 100); upd(live, t);
    CHECK(cantab::recordCount() == 2, "2 回目の記録");
    ui::tap(RX, MY, t += 100); upd(live, t);
    CHECK(ui::screen() == ui::SC_CAN_ID, "右半分「一覧」で 1 件ずつの画面");
    ui::tap(BOTX, BOTY, t += 100); upd(live, t);
    CHECK(ui::screen() == ui::SC_CAN_ID, "一覧: 下の帯のタップでは開かない(2.4.4)");
    holdOpen(live, t);
    CHECK(ui::screen() == ui::SC_CAN_DETAIL, "一覧: 下「長押しで開く」で詳細(2.4.4)");
    next(t);
    upd(live, t += 4 * 60000);
    CHECK(ui::screen() == ui::SC_CAN_DETAIL, "詳細: スワイプはバイトを選ぶだけ。4 分たっても自動では戻らない");
    ui::tap(TOPX, TOPY, t += 100); upd(live, t);
    CHECK(ui::screen() == ui::SC_CAN_ID, "詳細: 上「‹ 戻る」で一覧");
    ui::tap(TOPX, TOPY, t += 100); upd(live, t);
    CHECK(ui::screen() == ui::SC_CAN, "一覧: 上「‹ 戻る」で CAN の画面");
    ui::tap(LX, MY, t += 100); upd(live, t);
    CHECK(ui::screen() == ui::SC_CAN_REDO, "左半分「やり直す」で確認");
    ui::tap(TOPX, TOPY, t += 100); upd(live, t);
    CHECK(ui::screen() == ui::SC_CAN && cantab::recordCount() == 2, "確認: 上「‹ 戻る」は消さない");
    ui::tap(LX, MY, t += 100); upd(live, t);
    ui::tap(BOTX, BOTY, t += 100); upd(live, t);
    CHECK(ui::screen() == ui::SC_CAN && cantab::recordCount() == 0, "確認: 下「やり直す」で記録を消す");
    ui::tap(TOPX, TOPY, t += 100); upd(live, t);
    CHECK(ui::screen() == ui::SC_SET_GRP && ui::testGroup() == 0 && ui::testPage() == 7, "CAN の画面: 上「‹ 戻る」で CAN の「CAN確認」のページ(2.4.3)");
  }
  ui::tap(TOPX, TOPY, t += 100); upd(live, t);
  CHECK(ui::screen() == ui::SC_SET_INFO && ui::testPage() == 0, "CAN の中: 上「‹ CAN」で受信の状態の CAN のページ");
  ui::tap(TOPX, TOPY, t += 100); upd(live, t);
  CHECK(ui::screen() == ui::SC_SET_LIST && ui::testSetCat() == 4, "受信の状態: 上「‹ 受信の状態」で設定の受信の状態");
  // 走行記録(2.15.0。2.15.3: 1 つ目のカテゴリ。1 項目だけで、長押しでそのまま 1 年の画面。2.15.1 までは 3 ヶ月)
  next(t); next(t); next(t);
  CHECK(ui::screen() == ui::SC_SET_LIST && ui::testSetCat() == 0, "最後(その他)の次は 1 つ目のカテゴリ = 走行記録(2.15.3)");
  holdOpen(live, t);
  CHECK(ui::screen() == ui::SC_ODO && ui::testOdoLevel() == odo::ODO_LV_YEAR, "走行記録の長押しで 1 年の画面");
  holdOpen(live, t);
  CHECK(ui::screen() == ui::SC_ODO && ui::testOdoLevel() == odo::ODO_LV_YEAR, "時刻が分からない間は、長押しで細かい方へは行かない");
  ui::tap(TOPX, TOPY, t += 100); upd(live, t);
  CHECK(ui::screen() == ui::SC_SET_LIST && ui::testSetCat() == 0, "1 年の画面: 上「‹ 1 年」で設定の走行記録");
  // 本体の状態(2.12.0: 5 つ目のカテゴリ。2.15.0: 6 つ目。2.4.0: 受信と関係ない FPS・起動を受信の状態から出した): 下「開く」で中。上の帯で設定へ
  prev(t); prev(t);
  holdOpen(live, t);
  CHECK(ui::screen() == ui::SC_SET_GRP && ui::testGroup() == 4 && ui::testPage() == 0, "6 つ目のカテゴリ = 本体の状態。下「長押しで開く」で中(1 ページ目 = FPS)");
  next(t);
  CHECK(ui::testPage() == 1, "本体の状態: 2 ページ目 = CPU(2.4.3)");
  prev(t); prev(t);
  CHECK(ui::testPage() == 8, "本体の状態: 最初の前は最後の 走行記録(9 ページ。2.4.3。2.15.0: 走行記録)");
  next(t);
  ui::tap(TOPX, TOPY, t += 100); upd(live, t);
  CHECK(ui::screen() == ui::SC_SET_LIST && ui::testSetCat() == 5, "本体の状態: 上「‹ 本体の状態」で設定の本体の状態");

  // ---------------- 7. 設定の変更(下「変更」→ 左右の半分で − +、下「決定」で保存して戻り、値が緑で点滅する(2.3.1)。上「‹ 戻る」で変えずに戻る)
  //                  2.4.0: 変更の画面は値を枠で囲み、下の「決定」を水色の帯にした(項目の画面と見た目が同じで、移ったのが分からなかった)
  prev(t); prev(t); prev(t);
  CHECK(ui::screen() == ui::SC_SET_LIST && ui::testSetCat() == 2, "3 つ目のカテゴリ = シフトポイント(2.15.3)");
  holdOpen(live, t);
  CHECK(ui::screen() == ui::SC_SET_CAT && ui::testSetItem() == 3, "シフトポイントの中の 1 項目目 = シフトポイント");
  auto countIn = [&](uint16_t c, int x0, int y0, int x1, int y1) {
    int n = 0;
    for (int y = y0; y < y1; y++)
      for (int x = x0; x < x1; x++) n += fb[y * gfx::W + x] == c;
    return n;
  };
  const uint16_t ACCENT = gfx::rgb(0x5FD0FF);
  CHECK(countIn(ACCENT, 80, 196, 386, 304) == 0 && countIn(ACCENT, 100, 380, 366, 466) < 6000, "項目の画面: 値は水色でなく、下の帯も水色でない");
  holdOpen(live, t);
  CHECK(ui::screen() == ui::SC_SET_EDIT, "設定: 下「長押しで開く」で変更の画面へ");
  CHECK(ui::previewPct() == -1, "明るさ以外の項目(シフトポイント)の変更の画面では、明るさを変えない(previewPct = -1。2.9.0)");
  CHECK(countIn(ACCENT, 80, 196, 386, 304) > 1000 && countIn(ACCENT, 100, 380, 366, 466) > 10000, "変更の画面: 値は水色、下の「決定」は水色の帯(2.4.1: 2.4.0 の枠はやめた)");
  ui::tap(RX, MY, t += 100); upd(live, t);
  CHECK(set.shiftRpm == SET_SHIFT_DEFAULT + 100, "右半分で 100 上がる");
  CHECK(countIn(ACCENT, 80, 196, 386, 304) > 1000, "値を変えても水色のまま");
  {
    static uint16_t fbE[gfx::W * gfx::H];
    memcpy(fbE, fb, sizeof(fbE));
    ui::testRedraw();
    upd(live, t);
    CHECK(memcmp(fbE, fb, sizeof(fbE)) == 0, "変更の画面: 値を変えて描き直した絵 = 最初から描いた絵");
  }
  ui::tap(LX, MY, t += 100); ui::tap(LX, MY, t += 100); upd(live, t);
  CHECK(set.shiftRpm == SET_SHIFT_DEFAULT - 100, "左半分 2 回で 200 下がる");
  int saves0 = g_hostSaves;
  {
    // 値の所(名前の下〜下の点の上)の画素を数える
    auto areaCount = [&](uint16_t c) {
      int n = 0;
      for (int y = 196; y < 304; y++)
        for (int x = 80; x < 386; x++) n += fb[y * gfx::W + x] == c;
      return n;
    };
    auto areaNonBg = [&]() {
      int n = 0;
      for (int y = 196; y < 304; y++)
        for (int x = 80; x < 386; x++) n += fb[y * gfx::W + x] != 0;
      return n;
    };
    const uint16_t GREEN = gfx::rgb(0x22E36A), WHITE = gfx::rgb(0xFFFFFF);
    const int accent0 = countIn(ACCENT, 80, 196, 386, 304);  // ふだんの太さの値
    (void)areaNonBg;
    const uint32_t t0 = t += 100;
    ui::tap(BOTX, BOTY, t0);
    ui::update(live, ls, ps, si, t0);
    // 2.4.3: 押した所(下の「決定」の帯)が点滅し、その間は値が太い。変更の画面のまま。点滅が終わってから戻る
    CHECK(ui::screen() == ui::SC_SET_EDIT && g_hostSaves == saves0 + 1 && ui::testFlashing(), "下「決定」で保存し、押した所が点滅する(その間は変更の画面のまま。2.4.3)");
    CHECK(countIn(ACCENT, 100, 380, 366, 466) < 3000, "点滅: 最初は帯を消す(押した所がすぐ変わる)");
    CHECK(countIn(ACCENT, 80, 196, 386, 304) > accent0 + 200, "点滅の間は値が太い");
    ui::update(live, ls, ps, si, t0 + SAVED_FLASH_MS + 10);
    CHECK(countIn(ACCENT, 100, 380, 366, 466) > 10000, "点滅: 次は水色の帯");
    ui::tap(RX, MY, t0 + SAVED_FLASH_MS + 20);
    CHECK(set.shiftRpm == SET_SHIFT_DEFAULT - 100 && g_hostSaves == saves0 + 1, "点滅の間は − + を受けない");
    ui::update(live, ls, ps, si, t0 + 2 * SAVED_FLASH_MS + 10);
    CHECK(countIn(ACCENT, 100, 380, 366, 466) < 3000 && ui::screen() == ui::SC_SET_EDIT, "点滅: また消す");
    {
      static uint16_t fbS[gfx::W * gfx::H];
      memcpy(fbS, fb, sizeof(fbS));
      ui::testRedraw();
      ui::update(live, ls, ps, si, t0 + 2 * SAVED_FLASH_MS + 10);
      CHECK(memcmp(fbS, fb, sizeof(fbS)) == 0, "点滅: 少しずつ描いた絵 = 同じ時刻に最初から描いた絵");
    }
    ui::update(live, ls, ps, si, t0 + 2 * SAVED_FLASH_COUNT * SAVED_FLASH_MS - 10);
    CHECK(ui::screen() == ui::SC_SET_EDIT, "点滅の終わる手前では、まだ変更の画面");
    ui::update(live, ls, ps, si, t0 + 2 * SAVED_FLASH_COUNT * SAVED_FLASH_MS + 10);
    ui::update(live, ls, ps, si, t0 + 2 * SAVED_FLASH_COUNT * SAVED_FLASH_MS + 70);
    ui::update(live, ls, ps, si, t0 + 2 * SAVED_FLASH_COUNT * SAVED_FLASH_MS + 130);
    CHECK(ui::screen() == ui::SC_SET_CAT && ui::testSetItem() == 3 && !ui::testFlashing(), "点滅が終わったら項目の画面へ");
    CHECK(areaCount(GREEN) == 0 && areaCount(WHITE) > 100 && countIn(ACCENT, 80, 196, 386, 304) == 0 && countIn(ACCENT, 100, 380, 366, 466) < 6000,
          "戻った画面: 値はふだんの白(緑の点滅はやめた)、水色の帯も無い");
    t = t0 + 2 * SAVED_FLASH_COUNT * SAVED_FLASH_MS + 100;
    upd(live, t);
    CHECK(g_hostSaves == saves0 + 1, "点滅のあとも、もう一度は保存しない");
  }
  holdOpen(live, t);
  ui::tap(BOTX, BOTY, t += 100);
  ui::update(live, ls, ps, si, t);
  CHECK(ui::screen() == ui::SC_SET_EDIT && ui::testFlashing() && g_hostSaves == saves0 + 1, "変えずに決定しても、押した帯が点滅する(保存はしない。2.4.5)");
  upd(live, t += 2 * SAVED_FLASH_COUNT * SAVED_FLASH_MS + 10);
  CHECK(ui::screen() == ui::SC_SET_CAT && !ui::testFlashing() && g_hostSaves == saves0 + 1, "点滅が終わったら項目の画面へ(保存はしない)");
  holdOpen(live, t);
  ui::tap(RX, MY, t += 100); ui::tap(RX, MY, t += 100);
  ui::tap(TOPX, TOPY, t += 100); upd(live, t);
  CHECK(ui::screen() == ui::SC_SET_CAT && set.shiftRpm == SET_SHIFT_DEFAULT - 100 && g_hostSaves == saves0 + 1, "上「‹ 戻る」は変えずに戻る(保存しない)");
  // もう一度変えて決定: 点滅が終わると項目の画面。送るのは戻ってから
  holdOpen(live, t);
  ui::tap(RX, MY, t += 100);
  ui::tap(BOTX, BOTY, t += 100); upd(live, t);
  CHECK(ui::screen() == ui::SC_SET_EDIT && g_hostSaves == saves0 + 2 && ui::testFlashing(), "もう一度変えて決定(点滅の間は変更の画面)");
  upd(live, t += 2 * SAVED_FLASH_COUNT * SAVED_FLASH_MS);
  CHECK(ui::screen() == ui::SC_SET_CAT && !ui::testFlashing() && set.shiftRpm == SET_SHIFT_DEFAULT, "点滅が終わって項目の画面");
  next(t);
  CHECK(ui::testSetItem() == 4, "左へスワイプで次へ(シフトポイントの中の回転数の輪)");
  prev(t);
  CHECK(ui::testSetItem() == 3 && !ui::testFlashing(), "戻る");
  // 上下限
  holdOpen(live, t);
  for (int i = 0; i < 60; i++) ui::tap(RX, MY, t += 10);
  CHECK(set.shiftRpm == SET_SHIFT_MAX, "上限で止まる");
  for (int i = 0; i < 80; i++) ui::tap(LX, MY, t += 10);
  CHECK(set.shiftRpm == SET_SHIFT_MIN, "下限で止まる");
  // 保存に失敗: 1 回目の「決定」では留まり、2 回目で抜ける(保存していないので点滅しない)
  g_hostSaveOk = false;
  upd(live, t);
  ui::tap(BOTX, BOTY, t += 100); upd(live, t);
  CHECK(ui::screen() == ui::SC_SET_EDIT, "保存に失敗したら変更画面に留まる");
  ui::tap(BOTX, BOTY, t += 100);
  ui::update(live, ls, ps, si, t);
  CHECK(ui::screen() == ui::SC_SET_EDIT && ui::testFlashing(), "もう一度「決定」で、押した帯が点滅してから抜ける(保存はしない。2.4.5)");
  upd(live, t += 2 * SAVED_FLASH_COUNT * SAVED_FLASH_MS + 10);
  CHECK(ui::screen() == ui::SC_SET_CAT && !ui::testFlashing(), "点滅が終わったら項目の画面へ");
  g_hostSaveOk = true;
  set.shiftRpm = SET_SHIFT_DEFAULT;
  // 明るさ(画面の中の 1 項目目): 変えたその場で反映、「‹ 戻る」で元に戻る
  ui::tap(TOPX, TOPY, t += 100); upd(live, t);
  prev(t);
  CHECK(ui::screen() == ui::SC_SET_LIST && ui::testSetCat() == 1, "設定の段に戻って 2 つ目のカテゴリ(画面。2.15.3)");
  holdOpen(live, t);
  holdOpen(live, t);
  CHECK(ui::screen() == ui::SC_SET_EDIT && ui::testSetItem() == 0, "画面の中の 1 項目目(明るさ)の変更");
  CHECK(ui::previewPct() == SET_BRIGHT_DEFAULT, "明るさの変更の画面の間は、その値で表示する(2.9.0)");
  ui::tap(LX, MY, t += 100); upd(live, t);
  CHECK(set.brightnessPct == SET_BRIGHT_DEFAULT - SET_BRIGHT_STEP && g_hostBrightness == set.brightnessPct && ui::previewPct() == set.brightnessPct, "明るさは左半分でその場で変わる");
  ui::tap(TOPX, TOPY, t += 100); upd(live, t);
  CHECK(set.brightnessPct == SET_BRIGHT_DEFAULT && g_hostBrightness == SET_BRIGHT_DEFAULT, "上「‹ 戻る」で明るさも元に戻る");
  CHECK(ui::screen() == ui::SC_SET_CAT && ui::previewPct() == -1, "変更の画面を出たら、明るさはライトのスイッチで決まる値に戻る(previewPct = -1。2.9.0)");
  // イルミネーションの明るさ(画面の中の 2 項目目。2.9.0: ライトのスイッチが入の間の明るさ。初期値 30 %、10〜100 % / 10)。明るさと同じく
  // 変えたその場で反映し、変更の画面の間はライトに関係なくその値で表示する
  next(t);
  CHECK(ui::screen() == ui::SC_SET_CAT && ui::testSetItem() == 1, "画面の中の 2 項目目 = イルミネーションの明るさ(2.9.0)");
  holdOpen(live, t);
  CHECK(ui::screen() == ui::SC_SET_EDIT && ui::testSetItem() == 1 && set.illumPct == SET_ILLUM_DEFAULT && ui::previewPct() == SET_ILLUM_DEFAULT,
        "イルミネーションの明るさの変更: 変更の画面の間はその値(初期値 30 %)で表示する");
  ui::tap(LX, MY, t += 100); upd(live, t);
  CHECK(set.illumPct == SET_ILLUM_DEFAULT - SET_ILLUM_STEP && g_hostBrightness == set.illumPct && ui::previewPct() == set.illumPct && set.brightnessPct == SET_BRIGHT_DEFAULT,
        "イルミネーションの明るさは左半分でその場で変わる(明るさは変えない)");
  ui::tap(TOPX, TOPY, t += 100); upd(live, t);
  CHECK(ui::screen() == ui::SC_SET_CAT && set.illumPct == SET_ILLUM_DEFAULT && g_hostBrightness == SET_ILLUM_DEFAULT && ui::previewPct() == -1,
        "上「‹ 戻る」で元の値に戻し、変更の画面を出る(previewPct = -1)");
  {
    const int saves0 = g_hostSaves;
    holdOpen(live, t);
    for (int i = 0; i < 12; i++) ui::tap(RX, MY, t += 100);
    upd(live, t);
    CHECK(set.illumPct == SET_ILLUM_MAX && ui::previewPct() == SET_ILLUM_MAX, "イルミネーションの明るさ: 上限 100 % で止まる");
    for (int i = 0; i < 12; i++) ui::tap(LX, MY, t += 100);
    upd(live, t);
    CHECK(set.illumPct == SET_ILLUM_MIN && ui::previewPct() == SET_ILLUM_MIN, "イルミネーションの明るさ: 下限 10 % で止まる");
    ui::tap(RX, MY, t += 100);
    ui::tap(BOTX, BOTY, t += 100);
    upd(live, t);
    CHECK(ui::screen() == ui::SC_SET_EDIT && g_hostSaves == saves0 + 1 && ui::testFlashing() && ui::previewPct() == 20, "下「決定」で保存(点滅の間はまだ変更の画面で、その値のまま)");
    upd(live, t += 2 * SAVED_FLASH_COUNT * SAVED_FLASH_MS + 10);
    CHECK(ui::screen() == ui::SC_SET_CAT && ui::testSetItem() == 1 && set.illumPct == 20 && ui::previewPct() == -1, "点滅が終わったら項目の画面へ(20 % を保存。previewPct = -1)");
    set.illumPct = SET_ILLUM_DEFAULT;
  }
  // 水温・過負荷(2.12.0: 3 つ目のカテゴリ): 水温の警告・過負荷 回転数・過負荷時間 黄・赤・過負荷がリセットされる時間・
  // メンテナンスまでの累積時間・累積時間 リセット(2.11.0 までの「時間の記録」)
  ui::tap(TOPX, TOPY, t += 100); upd(live, t);
  next(t); next(t);
  CHECK(ui::screen() == ui::SC_SET_LIST && ui::testSetCat() == 3, "4 つ目のカテゴリ = 警告・過負荷(2.14.0: 水温・過負荷から改名。2.15.3: 4 つ目)");
  holdOpen(live, t);
  CHECK(ui::screen() == ui::SC_SET_CAT && ui::testSetItem() == 5, "警告・過負荷の中の 1 項目目 = 水温の警告");
  next(t);
  CHECK(ui::screen() == ui::SC_SET_CAT && ui::testSetItem() == 6, "警告・過負荷の中の 2 項目目 = 燃料の警告(2.14.0)");
  {  // 2.14.0: 燃料の警告(初期値 20 %、5〜50 % を 5 ずつ)
    const int savesF = g_hostSaves;
    holdOpen(live, t);
    CHECK(ui::screen() == ui::SC_SET_EDIT && set.fuelWarnPct == SET_FUELWARN_DEFAULT && SET_FUELWARN_DEFAULT == 20, "燃料の警告の変更(初期値 20 %)");
    ui::tap(RX, MY, t += 100); ui::tap(RX, MY, t += 100);
    CHECK(set.fuelWarnPct == SET_FUELWARN_DEFAULT + 2 * SET_FUELWARN_STEP, "燃料の警告: 右半分で 5 ずつ上がる(30)");
    for (int i = 0; i < 20; i++) ui::tap(RX, MY, t += 10);
    CHECK(set.fuelWarnPct == SET_FUELWARN_MAX, "燃料の警告: 上限 50 で止まる");
    for (int i = 0; i < 20; i++) ui::tap(LX, MY, t += 10);
    CHECK(set.fuelWarnPct == SET_FUELWARN_MIN, "燃料の警告: 下限 5 で止まる");
    for (int i = 0; i < 4; i++) ui::tap(RX, MY, t += 10);
    ui::tap(BOTX, BOTY, t += 100);
    upd(live, t += 2 * SAVED_FLASH_COUNT * SAVED_FLASH_MS + 10);
    CHECK(ui::screen() == ui::SC_SET_CAT && ui::testSetItem() == 6 && set.fuelWarnPct == 25 && g_hostSaves == savesF + 1, "燃料の警告: 「決定」で保存して項目の画面へ(25)");
    set.fuelWarnPct = SET_FUELWARN_DEFAULT;
  }
  next(t);
  CHECK(ui::screen() == ui::SC_SET_CAT && ui::testSetItem() == 7, "警告・過負荷の中の 3 項目目 = 過負荷 回転数(2.12.0)");
  {
    const int saves1 = g_hostSaves;
    holdOpen(live, t);
    CHECK(ui::screen() == ui::SC_SET_EDIT && set.loadRpm == SET_LOADRPM_DEFAULT, "過負荷 回転数の変更(初期値 3000)");
    ui::tap(RX, MY, t += 100); ui::tap(RX, MY, t += 100); ui::tap(RX, MY, t += 100); ui::tap(RX, MY, t += 100); ui::tap(RX, MY, t += 100);
    CHECK(set.loadRpm == SET_LOADRPM_DEFAULT + 5 * SET_LOADRPM_STEP, "過負荷 回転数: 右半分で 100 ずつ上がる(3500)");
    for (int i = 0; i < 60; i++) ui::tap(RX, MY, t += 10);
    CHECK(set.loadRpm == SET_LOADRPM_MAX, "過負荷 回転数: 上限 6000 で止まる");
    for (int i = 0; i < 60; i++) ui::tap(LX, MY, t += 10);
    CHECK(set.loadRpm == SET_LOADRPM_MIN, "過負荷 回転数: 下限 2000 で止まる");
    for (int i = 0; i < 15; i++) ui::tap(RX, MY, t += 10);
    ui::tap(BOTX, BOTY, t += 100);
    upd(live, t += 2 * SAVED_FLASH_COUNT * SAVED_FLASH_MS + 10);
    CHECK(ui::screen() == ui::SC_SET_CAT && set.loadRpm == 3500 && g_hostSaves == saves1 + 1, "過負荷 回転数: 「決定」で保存して項目の画面へ(3500)");
  }
  prev(t); prev(t); prev(t);
  CHECK(ui::screen() == ui::SC_SET_CAT && ui::testSetItem() == 12, "警告・過負荷の中: 最初の前は最後 = 累積時間 リセット(8 項目目)");
  prev(t);
  CHECK(ui::testSetItem() == 11, "その前がメンテナンスまでの累積時間(7 項目目。2.12.0)");
  {
    const int saves1 = g_hostSaves;
    holdOpen(live, t);
    CHECK(ui::screen() == ui::SC_SET_EDIT && set.maintHours == SET_MAINT_DEFAULT, "メンテナンスまでの累積時間の変更(初期値 5 時間)");
    ui::tap(RX, MY, t += 100);
    CHECK(set.maintHours == SET_MAINT_DEFAULT + SET_MAINT_STEP, "メンテナンスまでの累積時間: 右半分で 1 時間ずつ上がる(6)");
    for (int i = 0; i < 20; i++) ui::tap(LX, MY, t += 10);
    CHECK(set.maintHours == SET_MAINT_MIN && SET_MAINT_MIN == 0, "メンテナンスまでの累積時間: 0(「切」)で止まる");
    for (int i = 0; i < 120; i++) ui::tap(RX, MY, t += 10);
    CHECK(set.maintHours == SET_MAINT_MAX, "メンテナンスまでの累積時間: 上限 99 時間で止まる");
    for (int i = 0; i < 87; i++) ui::tap(LX, MY, t += 10);
    ui::tap(BOTX, BOTY, t += 100);
    upd(live, t += 2 * SAVED_FLASH_COUNT * SAVED_FLASH_MS + 10);
    CHECK(ui::screen() == ui::SC_SET_CAT && set.maintHours == 12 && g_hostSaves == saves1 + 1, "メンテナンスまでの累積時間: 「決定」で保存して項目の画面へ(12 時間)");
  }
  next(t);
  CHECK(ui::testSetItem() == 12, "警告・過負荷の中の 8 項目目 = 累積時間 リセット(2.11.0 までの時間の記録)");
  {  // ▲ の横の数字は設定の過負荷 回転数(3500 と 3000 で絵が違う)
    static uint16_t fbT[gfx::W * gfx::H];
    ui::testRedraw();
    upd(live, t);
    memcpy(fbT, fb, sizeof(fbT));
    set.loadRpm = 3000;
    ui::testRedraw();
    upd(live, t);
    int diff = 0, diffTime = 0;
    for (int y = 200; y < 320; y++)
      for (int x = 100; x < 200; x++) diff += fb[y * gfx::W + x] != fbT[y * gfx::W + x];
    for (int y = 200; y < 320; y++)
      for (int x = 240; x < 390; x++) diffTime += fb[y * gfx::W + x] != fbT[y * gfx::W + x];
    set.loadRpm = 3500;
    ui::testRedraw();
    upd(live, t);
    CHECK(diff > 20 && diffTime == 0, "累積時間 リセットの項目の ▲ の横の回転数は設定の過負荷 回転数(時間はそのまま)");
  }
  {  // 累積時間 リセット(2.12.0: 本人 10/28「累積時間の入力はリセットと同じ画面に」「最初0:00:00が出て＋ーボタンで３０分ずつ」):
     // 変更の画面で 0:00:00 から 30 分ずつ値を入れ、下「リセット」で ▲ をその値、▼ を 0 にしてすぐ保存
    trip::setTimes(5025000, 7000);
    const int ts1 = g_hostTimeSaves, saves1 = g_hostSaves;
    holdOpen(live, t);
    CHECK(ui::screen() == ui::SC_SET_EDIT, "累積時間 リセット: 下「長押しで開く」で変更の画面(値を入れてからリセット)");
    ui::tap(TOPX, TOPY, t += 100); upd(live, t);
    CHECK(ui::screen() == ui::SC_SET_CAT && trip::aboveMs() == 5025000 && trip::belowMs() == 7000 && g_hostTimeSaves == ts1,
          "累積時間 リセット: 上「‹ 戻る」は消さない(水温・過負荷の中へ戻る)");
    holdOpen(live, t);
    load::testSet(49 * 60000 + 33000, true);  // 過負荷時間 49:33(本人 10/28「累積時間が０なのに過負荷４９：３３と表示されています」)
    ui::tap(BOTX, BOTY, t += 100);
    CHECK(trip::aboveMs() == 0 && trip::belowMs() == 0 && g_hostTimeSaves == ts1 + 1 && g_hostSaves == saves1,
          "累積時間 リセット: 0:00:00 のまま下「リセット」で 2 つとも 0 にして、すぐ保存(今までのリセットと同じ)");
    CHECK(load::valueMs() == 0, "累積時間 リセット: 過負荷時間も 0 に(過負荷時間は累積時間を超えない)");
    upd(live, t += 2 * SAVED_FLASH_COUNT * SAVED_FLASH_MS + 10);
    CHECK(ui::screen() == ui::SC_SET_CAT && ui::testSetItem() == 12, "累積時間 リセット: 点滅が終わったら項目の画面へ");
    trip::setTimes(5025000, 7000);
    holdOpen(live, t);
    ui::tap(RX, MY, t += 100); ui::tap(RX, MY, t += 100); ui::tap(RX, MY, t += 100); ui::tap(LX, MY, t += 100);  // 0:30:00 → 1:00:00 → 1:30:00 → 1:00:00
    CHECK(trip::aboveMs() == 5025000, "累積時間 リセット: 「リセット」を押すまで累積時間は変えない");
    load::testSet(49 * 60000 + 33000, true);
    ui::tap(BOTX, BOTY, t += 100);
    CHECK(trip::aboveMs() == 3600000 && trip::belowMs() == 0 && g_hostTimeSaves == ts1 + 2,
          "累積時間 リセット: + − で 30 分ずつ(1:00:00)。下「リセット」で ▲ をその値、▼ を 0 にして、すぐ保存");
    CHECK(load::valueMs() == 49 * 60000 + 33000, "累積時間 リセット: 過負荷時間 49:33 は 1:00:00 以下なのでそのまま");
    upd(live, t += 2 * SAVED_FLASH_COUNT * SAVED_FLASH_MS + 10);
    holdOpen(live, t);
    ui::tap(RX, MY, t += 100);
    ui::tap(BOTX, BOTY, t += 100);
    CHECK(trip::aboveMs() == 1800000 && load::valueMs() == 1800000, "累積時間 リセット: 0:30:00 なら過負荷時間 49:33 も 30:00 に");
    load::testReset();
    upd(live, t += 2 * SAVED_FLASH_COUNT * SAVED_FLASH_MS + 10);
    holdOpen(live, t);
    ui::tap(LX, MY, t += 100); ui::tap(LX, MY, t += 100);
    ui::tap(BOTX, BOTY, t += 100);
    upd(live, t += 2 * SAVED_FLASH_COUNT * SAVED_FLASH_MS + 10);
    CHECK(trip::aboveMs() == 0 && g_hostTimeSaves == ts1 + 4, "累積時間 リセット: 0:00:00 より下がらない(開くたびに 0:00:00 から)");
    holdOpen(live, t);
    for (int i = 0; i < TRIP_IN_MAX_H * 2 + 20; i++) ui::tap(RX, MY, t += 10);
    ui::tap(BOTX, BOTY, t += 100);
    upd(live, t += 2 * SAVED_FLASH_COUNT * SAVED_FLASH_MS + 10);
    CHECK(ui::screen() == ui::SC_SET_CAT && trip::aboveMs() == (uint32_t)TRIP_IN_MAX_H * 3600000u && g_hostTimeSaves == ts1 + 5,
          "累積時間 リセット: 上限 99:00:00 で止まる");
    trip::resetTimes();
  }
  set.loadRpm = SET_LOADRPM_DEFAULT;
  set.maintHours = SET_MAINT_DEFAULT;
  ui::tap(TOPX, TOPY, t += 100); upd(live, t);
  CHECK(ui::screen() == ui::SC_SET_LIST && ui::testSetCat() == 3, "カテゴリの中: 上「‹ 水温・過負荷」で設定の段");
  ui::tap(TOPX, TOPY, t += 100); upd(live, t);
  CHECK(ui::screen() == ui::SC_BOOST, "設定: 上の帯「‹ 設定」で来た画面へ");

  // ---------------- 8. 覚える画面と、設定から時間で戻る(2.3)
  CHECK(ui::homeScreen() == ui::SC_DRIVE, "まだ 1 分続けて見ていないので、覚えた画面はサーキットのまま");
  upd(live, t += HOME_CONFIRM_MS + 100);
  CHECK(ui::homeScreen() == ui::SC_BOOST, "タコを 1 分見ていたら覚える");
  upd(live, t += 4 * 60000);
  CHECK(ui::screen() == ui::SC_BOOST, "タコ: 4 分たっても自動では変わらない");
  swipe(live, t, -200, 0);
  CHECK(ui::screen() == ui::SC_DATA, "左へスワイプでデータ");
  longPress(live, t);
  CHECK(ui::screen() == ui::SC_SET_LIST, "データ: 長押しで設定");
  upd(live, t + 3 * 60000 - 2000);
  CHECK(ui::screen() == ui::SC_SET_LIST, "3 分たつ前は戻らない");
  upd(live, t + 3 * 60000 + 200);
  CHECK(ui::screen() == ui::SC_BOOST, "3 分で覚えた画面(タコ)に戻る(来た画面のデータではない)");
  t += 3 * 60000 + 1000;
  set.autoReturnMin = 1;
  longPress(live, t);
  ui::testShow(ui::SC_SET_CAT, 3);
  holdOpen(live, t);
  CHECK(ui::screen() == ui::SC_SET_EDIT, "設定の変更画面へ(シフトポイント)");
  ui::tap(RX, MY, t += 100); upd(live, t);
  saves0 = g_hostSaves;
  upd(live, t + 61000);
  CHECK(ui::screen() == ui::SC_BOOST && g_hostSaves == saves0 + 1, "変更画面からも 1 分(設定値)で戻り、変えた値は保存する");
  set.autoReturnMin = SET_AUTORET_DEFAULT;
  set.shiftRpm = SET_SHIFT_DEFAULT;
  // グループの中(2.4.0)からも時間で戻る
  set.autoReturnMin = 1;
  ui::testShow(ui::SC_SET_GRP, 1, 0);
  ui::testTouch(t += 100);
  upd(live, t);
  upd(live, t + 61000);
  CHECK(ui::screen() == ui::SC_BOOST, "グループの中からも 1 分(設定値)で覚えた画面に戻る");
  t += 62000;
  set.autoReturnMin = SET_AUTORET_DEFAULT;
  // サーキットを覚え直しておく(あとの試験のため)
  ui::testShow(ui::SC_DRIVE);
  upd(live, t += 100000);
  upd(live, t += HOME_CONFIRM_MS + 100);
  CHECK(ui::homeScreen() == ui::SC_DRIVE, "サーキットを 1 分見て覚え直す");

  // ---------------- 9. 全開の時間と走行時間(仕様書 6.3)
  {
    Signals d;
    memset(&d, 0, sizeof(d));
    d.linkUp = d.speedOk = d.throttleOk = true;
    uint32_t tt = t + 100000;
    d.speedKmh = 0; d.throttlePct = 100;
    trip::update(d, tt);
    uint32_t m0 = trip::movingMs(), w0 = trip::wotMs();
    for (int i = 0; i < 100; i++) trip::update(d, tt += 20);          // 停車中に全開 2 秒: どちらも数えない
    CHECK(trip::movingMs() == m0 && trip::wotMs() == w0, "停車中は走行時間も全開の時間も増えない");
    d.speedKmh = 40; d.throttlePct = 50;
    for (int i = 0; i < 300; i++) trip::update(d, tt += 20);          // 走行 6 秒、アクセル 50%
    CHECK(trip::movingMs() == m0 + 6000 && trip::wotMs() == w0, "走行中(アクセル 50%)は走行時間だけ増える");
    d.throttlePct = 96;
    for (int i = 0; i < 100; i++) trip::update(d, tt += 20);          // 全開 2 秒
    CHECK(trip::movingMs() == m0 + 8000 && trip::wotMs() == w0 + 2000, "全開(95% 以上)の間は両方増える");
    d.speedOk = false;
    for (int i = 0; i < 100; i++) trip::update(d, tt += 20);          // 車速の信号なし
    CHECK(trip::movingMs() == m0 + 8000 && trip::wotMs() == w0 + 2000, "車速の信号がない間は数えない");
  }

  // ---------------- 10. 受信の速度の自動合わせ
  {
    const uint32_t cand[] = METER_LINK_BAUD_CANDIDATES;
    MlSignals m = sigMsg(3000);
    uint8_t junk[64];
    for (int i = 0; i < 64; i++) junk[i] = (uint8_t)(i * 37 + 11) | 0x80;  // 同期の並び(A5 5A)を含まないごみ
    uint8_t sq = 0;
    // (a) 何も届かない: 速度を変えない
    mlink::begin();
    uint32_t tt = 1000, sw = 0;
    for (int i = 0; i < 2000; i++) sw += mlink::autoBaud(tt += 5, 0) ? 1 : 0;
    mlink::getStats(&st);
    CHECK(sw == 0 && mlink::baud() == cand[0] && !st.locked && st.baud == cand[0], "何も届かないときは速度を変えない");
    // (b) XIAO の起動ログ(短いごみ)→ 0.4 秒の無音 → 正しいフレーム: 速度を変えない
    mlink::begin();
    tt = 1000; sw = 0;
    for (int i = 0; i < 6; i++) {  // 30 ms の間に 384 バイトのごみ
      mlink::feed(junk, sizeof(junk), tt);
      sw += mlink::autoBaud(tt += 5, sizeof(junk)) ? 1 : 0;
    }
    for (int i = 0; i < 80; i++) sw += mlink::autoBaud(tt += 5, 0) ? 1 : 0;
    for (int i = 0; i < 150; i++) {  // 3 秒ぶんのフレーム
      auto f = frame(ML_TYPE_SIGNALS, sq++, &m, sizeof(m));
      mlink::feed(f.data(), f.size(), tt);
      for (int k = 0; k < 4; k++) sw += mlink::autoBaud(tt += 5, k == 0 ? f.size() : 0) ? 1 : 0;
    }
    mlink::getStats(&st);
    CHECK(sw == 0 && st.locked && st.baud == cand[0], "起動ログのあとに正しいフレームが来れば速度を変えない");
    // (c) 区間の境目をまたぐごみ → 2 秒の無音 → 正しいフレーム: 速度を変えない
    mlink::begin();
    tt = 1000; sw = 0;
    mlink::autoBaud(tt, 0);  // 区間の始まり = 1000
    tt += LINK_BAUD_WINDOW_MS - 15;
    for (int i = 0; i < 6; i++) {
      mlink::feed(junk, sizeof(junk), tt);
      sw += mlink::autoBaud(tt += 5, sizeof(junk)) ? 1 : 0;
    }
    for (int i = 0; i < 400; i++) sw += mlink::autoBaud(tt += 5, 0) ? 1 : 0;
    {
      auto f = frame(ML_TYPE_SIGNALS, sq++, &m, sizeof(m));
      mlink::feed(f.data(), f.size(), tt);
      sw += mlink::autoBaud(tt += 5, f.size()) ? 1 : 0;
    }
    mlink::getStats(&st);
    CHECK(sw == 0 && st.locked && st.baud == cand[0], "区間をまたぐ短いごみでは速度を変えない");
    // (d) ごみが続く(速度が合っていない): 1.5 秒ごとに次の候補へ移り、一巡して最初に戻る
    mlink::begin();
    tt = 1000; sw = 0;
    uint32_t got[8] = { 0 }, at[8] = { 0 };
    for (int i = 0; i < 1300 && sw < 8; i++) {  // 6.5 秒
      mlink::feed(junk, 40, tt);
      uint32_t nb = mlink::autoBaud(tt += 5, 40);
      if (nb) {
        got[sw] = nb;
        at[sw] = tt - 1000;
        sw++;
      }
    }
    CHECK(sw == 4 && got[0] == cand[1] && got[1] == cand[2] && got[2] == cand[3] && got[3] == cand[0], "ごみが続くと候補を順に試し、一巡する");
    CHECK(at[0] >= 1400 && at[0] <= 1600 && at[1] - at[0] >= 1400 && at[1] - at[0] <= 1600, "移るまでの時間は約 1.5 秒");
    mlink::getStats(&st);
    CHECK(!st.locked && st.baud == cand[0], "合うまでは「受信なし」");
    // (e) 合った速度で正しいフレームが来れば、そこで止まる。ごみが混じっても移らない
    sw = 0;
    for (int i = 0; i < 300; i++) {  // 6 秒。フレームごとにごみも 20 バイト混ぜる
      auto f = frame(ML_TYPE_SIGNALS, sq++, &m, sizeof(m));
      mlink::feed(junk, 20, tt);
      mlink::feed(f.data(), f.size(), tt);
      for (int k = 0; k < 4; k++) sw += mlink::autoBaud(tt += 5, k == 0 ? f.size() + 20 : 0) ? 1 : 0;
    }
    mlink::getStats(&st);
    CHECK(sw == 0 && st.locked && st.baud == cand[0], "正しいフレームが来ていれば、ごみが混じっても移らない");
    // (f) 送信が止まる: 「受信なし」になるが、速度は変えない
    for (int i = 0; i < 2000; i++) sw += mlink::autoBaud(tt += 5, 0) ? 1 : 0;
    mlink::getStats(&st);
    CHECK(sw == 0 && !st.locked && st.baud == cand[0], "送信が止まっても速度は変えない");
  }

  // ---------------- 11. 受信タスクと loop() の時刻のずれ、長い途切れ、保存中の誤りの扱い、バイト数
  {
    mlink::begin();
    MlSignals m = sigMsg(4100);
    uint8_t sq = 0;
    // loop() が now を読んだあとに届いたフレーム(受信タスクの時刻のほうが新しい)でも「受信あり」
    auto f = frame(ML_TYPE_SIGNALS, sq++, &m, sizeof(m));
    mlink::feed(f.data(), f.size(), 7003);
    mlink::getSignals(&s, 7000);
    CHECK(s.linkUp && s.rpm == 4100, "now より 3 ms 新しいフレームでも「受信あり」のまま");
    mlink::getSignals(&s, 7003 + LINK_TIMEOUT_MS + 1);
    CHECK(!s.linkUp, "そのあと途切れれば「信号なし」");
    // 長く途切れたあと、時刻が大きく進んでも「受信あり」に戻らない
    for (uint32_t tt = 7003; tt <= 7003 + 4000; tt += 5) mlink::tick(tt);
    mlink::getSignals(&s, 7003 + 0x7FFFFF00u);
    CHECK(!s.linkUp, "途切れたまま 24 日たっても「信号なし」");
    mlink::getSignals(&s, 7003 + 0x80000100u);
    CHECK(!s.linkUp, "途切れたまま 25 日たっても「信号なし」(時刻の差の符号が変わる所)");
    // 設定の保存中(grace)の CRC 誤りと欠落は数えない。終わったあとは数える
    uint32_t tt = 20000;
    auto good = [&](uint8_t seqNo) { auto g = frame(ML_TYPE_SIGNALS, seqNo, &m, sizeof(m)); mlink::feed(g.data(), g.size(), tt); };
    auto bad = [&](uint8_t seqNo) { auto g = frame(ML_TYPE_SIGNALS, seqNo, &m, sizeof(m)); g[9] ^= 0x10; mlink::feed(g.data(), g.size(), tt); };
    good(10);
    mlink::getStats(&st);
    uint32_t c0 = st.crcErrors, l0 = st.lostFrames;
    mlink::graceUntil(tt + 300);
    tt += 100; bad(11);
    tt += 20; good(15);  // 12〜14 が落ちた
    mlink::getStats(&st);
    CHECK(st.crcErrors == c0 && st.lostFrames == l0, "保存中の CRC 誤りと欠落は数えない");
    tt += 400; bad(16);
    tt += 20; good(19);  // 17・18 が落ちた(16 は壊れていたので 3 つぶん)
    mlink::getStats(&st);
    CHECK(st.crcErrors == c0 + 1 && st.lostFrames == l0 + 3, "保存が終わったあとの誤りと欠落は数える");
    // 1 秒あたりのバイト数
    mlink::begin();
    uint8_t junk[50];
    memset(junk, 0x33, sizeof(junk));
    mlink::tick(30000);
    for (int i = 0; i < 10; i++) mlink::feed(junk, sizeof(junk), 30100 + i * 50);
    mlink::tick(31000);
    mlink::getStats(&st);
    CHECK(st.bytesPerSec == 500 && st.framesPerSec == 0, "届いたバイト数(フレームにならなくても数える)");
  }

  // ---------------- 12. 画面全体の点滅(BLINK_WHOLE_SCREEN)。シフト点以上では点灯 BLINK_ON_FAST_MS、消灯 BLINK_OFF_MS
  {
    Signals b;
    memset(&b, 0, sizeof(b));
    b.linkUp = b.rpmOk = true;
    b.rpm = set.shiftRpm + 100;  // シフト点より上、点滅の終わり(+ RING_SOLID_OFFSET)より下
    const uint32_t ON = BLINK_ON_FAST_MS, OFF = BLINK_OFF_MS, P = ON + OFF;
    uint32_t tb = P * 10000;  // 点滅は点灯側から始まり、ON 後に消灯、さらに OFF 後に点灯
    ui::testTouch(tb - 20);
    ui::testShow(ui::SC_DATA);  // 前の試験の点滅の状態を捨てる
    ui::update(b, ls, ps, si, tb - 10);
    ui::testShow(ui::SC_DRIVE);
    ui::update(b, ls, ps, si, tb);
    gfx::dirtyClear();
    bool on = !ui::blankNow();
    int blinks0 = g_hostBlinks;
    ui::update(b, ls, ps, si, tb + ON - 1);
    bool stillOn = !ui::blankNow();
    ui::update(b, ls, ps, si, tb + ON);
    bool off = ui::blankNow();
    bool told = g_hostBlank == 1 && g_hostBlinks == blinks0 + 1;  // 消灯に切り替わったことが platBlink で 1 回だけ知らされる
    gfx::dirtyClear();
    ui::update(b, ls, ps, si, tb + ON + OFF - 1);
    bool stillOff = ui::blankNow();
    ui::update(b, ls, ps, si, tb + P);
    bool on2 = !ui::blankNow() && g_hostBlank == 0;
    gfx::dirtyClear();
    CHECK(BLINK_WHOLE_SCREEN == 0 || (on && stillOn && off && told && stillOff && on2), "シフト点 + 100 rpm: 点灯 BLINK_ON_FAST_MS → 消灯 BLINK_OFF_MS → 点灯(platBlink で知らせる)");
    CHECK(ui::blinkOnMs() == ON && ui::blinkOffMs() == OFF, "シフト点以上の点灯は BLINK_ON_FAST_MS、消灯は BLINK_OFF_MS");
    b.rpm = set.shiftRpm + RING_BLINK_OFFSET - 300;  // 点滅の始まりより下
    ui::update(b, ls, ps, si, tb + 2 * P);
    CHECK(!ui::blankNow() && ui::blinkOnMs() == 0 && ui::blinkOffMs() == 0 && g_hostBlank == 0, "点滅の始まりより下では消灯しない(点灯・消灯の時間 0)");
    b.rpm = set.shiftRpm + 100;
    ui::update(b, ls, ps, si, tb + 3 * P);
    ui::testShow(ui::SC_BOOST);
    ui::update(b, ls, ps, si, tb + 3 * P + 20);  // サーキット → タコ。点滅は続く(tb + 3P の始まりから ON 後に消灯)
    gfx::dirtyClear();
    ui::update(b, ls, ps, si, tb + 3 * P + ON);
    CHECK(ui::screen() == ui::SC_BOOST && (BLINK_WHOLE_SCREEN == 0 || ui::blankNow()), "ブースト計でも消灯する");
    gfx::dirtyClear();
    ui::testShow(ui::SC_DATA);
    ui::update(b, ls, ps, si, tb + 3 * P + ON + 20);
    gfx::dirtyClear();
    ui::update(b, ls, ps, si, tb + 4 * P + ON);
    CHECK(ui::screen() == ui::SC_DATA && !ui::blankNow() && g_hostBlank == 0, "走行画面とブースト計以外では消灯しない");
    gfx::dirtyClear();
  }

  // ---------------- 12a. 点滅の終わり(シフト点 + RING_SOLID_OFFSET)以上: 点滅せず、明るさは最大(BL_MAX)
  {
    Signals b;
    memset(&b, 0, sizeof(b));
    b.linkUp = b.rpmOk = true;
    const uint32_t ON = BLINK_ON_FAST_MS;
    uint32_t ts = 1500000;
    ui::testShow(ui::SC_DRIVE);
    b.rpm = set.shiftRpm + RING_SOLID_OFFSET - 1;
    ui::update(b, ls, ps, si, ts);
    CHECK(ui::blinkOnMs() == ON && ui::blinkLevel() != BL_MAX, "点滅の終わりの 1 rpm 下: まだ点滅(最大輝度ではない)");
    b.rpm = set.shiftRpm + RING_SOLID_OFFSET;
    ui::update(b, ls, ps, si, ts + 1);
    CHECK(ui::blinkOnMs() == 0 && !ui::blankNow() && ui::blinkLevel() == BL_MAX && g_hostLevel == BL_MAX, "点滅の終わり: 点滅せず、platBlink に BL_MAX");
    int blinks0 = g_hostBlinks;
    for (uint32_t dt = 2; dt <= 1000; dt++) ui::update(b, ls, ps, si, ts + dt);
    CHECK(g_hostBlinks == blinks0 && !ui::blankNow() && ui::blinkLevel() == BL_MAX, "最大輝度の間は 1 秒たっても消灯しない(platBlink は呼ばれない)");
    ui::BlinkStats bs;
    ui::blinkStats(&bs, true);
    CHECK(bs.onMs == 0 && bs.offMs == 0, "最大輝度の間は点灯・消灯の時間 0(5 秒ごとの行に点滅は出ない)");
    b.rpm = set.shiftRpm + 100;  // 下回ると点滅に戻る
    ui::update(b, ls, ps, si, ts + 1001);
    CHECK(ui::blinkOnMs() == ON && ui::blinkLevel() != BL_MAX, "点滅の終わりを下回ると点滅に戻る(最大輝度をやめる)");
    gfx::dirtyClear();
    // アナログ計: 回転計の針が動き、針の跡が残らない(針を動かしたあとの絵 = 最初から描いた絵)。最大輝度も効く
    // (2.4.0: ピークが PEAK_MIN_RPM 以上なら印は針の下に出したままなので、基準の絵は PEAK_MIN_RPM 未満の 2000 rpm で取る)
    ui::testShow(ui::SC_BOOST);
    b.boostOk = true; b.boostBar = 1.2f;
    static uint16_t fbS[gfx::W * gfx::H];
    b.rpm = 2000;
    // 直前の 6000 rpm のピークホールドを消してから、基準の絵を取る
    ui::testPeakReset();
    ui::update(b, ls, ps, si, ts + 2000);
    const uint32_t t0 = ts + 2100 + TACH_PEAK_HOLD_MS + 4000u * 1000u / TACH_PEAK_FALL_RPM_PER_S;
    ui::update(b, ls, ps, si, t0);
    memcpy(fbS, fb, sizeof(fbS));
    gfx::dirtyClear();
    b.rpm = 6000;
    ui::update(b, ls, ps, si, t0 + 10);
    CHECK(memcmp(fbS, fb, sizeof(fbS)) != 0 && ui::blinkLevel() == BL_MAX, "アナログ計: 回転数で針が動く。6000 で最大輝度");
    b.rpm = 2000;
    b.boostBar = 1.2f;
    ui::update(b, ls, ps, si, t0 + 20);
    CHECK(memcmp(fbS, fb, sizeof(fbS)) != 0 && ui::testPeakDrawn(), "アナログ計: 針を戻した直後はピークホールドの印が 6000 に残る(最初の絵と違う)");
    // 2.4.4: 印は TACH_PEAK_HOLD_MS(1.5 秒)止まってから TACH_PEAK_FALL_RPM_PER_S で今の回転数まで下がり、ピークを付けてから
    // TACH_PEAK_SHOW_MS(5 秒)で消える。消えたら最初の絵に戻る
    ui::update(b, ls, ps, si, t0 + 10 + TACH_PEAK_HOLD_MS - 100);
    CHECK(ui::testPeakRpm() == 6000.0f && ui::testPeakDrawn(), "アナログ計: TACH_PEAK_HOLD_MS(1.5 秒)の間は 6000 で止まる(2.4.4)");
    ui::update(b, ls, ps, si, t0 + 10 + TACH_PEAK_HOLD_MS + 1000);
    CHECK(fabsf(ui::testPeakRpm() - (6000.0f - TACH_PEAK_FALL_RPM_PER_S)) < 30.0f && ui::testPeakDrawn(), "アナログ計: そのあと 2000 rpm/秒で下がる(1 秒で 4000)");
    // 2.4.5: 印が PEAK_MIN_RPM(3000)を切ったら消す(6000 → 3000 は止まる 1.5 秒 + 下がる 1.5 秒)
    const uint32_t tFall = t0 + 10 + TACH_PEAK_HOLD_MS + 3000u * 1000u / TACH_PEAK_FALL_RPM_PER_S;
    ui::update(b, ls, ps, si, tFall - 100);
    CHECK(ui::testPeakDrawn() && ui::testPeakRpm() > 3000.0f, "アナログ計: 3000 を切る手前では印がまだ出ている");
    ui::update(b, ls, ps, si, tFall + 100);
    CHECK(memcmp(fbS, fb, sizeof(fbS)) == 0 && !ui::testPeakDrawn(), "アナログ計: 印が 3000 を切ると消え、最初の絵と 1 画素も違わない(針・帯・印の跡が残らない。2.4.5)");
    // 2.4.0: 回転数がピークを超えても印は出したまま(針の下で一緒に動く)。下がるとその新しいピークに印
    b.rpm = 6000;
    ui::update(b, ls, ps, si, tFall + 110);
    b.rpm = 4000;
    ui::update(b, ls, ps, si, tFall + 120);
    CHECK(ui::testPeakDrawn(), "アナログ計: 6000 から下がると印を出す");
    b.rpm = 6200;
    ui::update(b, ls, ps, si, tFall + 130);
    CHECK(ui::testPeakDrawn(), "アナログ計: 回転数がピーク(6000)を超えても印は出したまま(針の下。2.4.0)");
    b.rpm = 2000;
    ui::update(b, ls, ps, si, tFall + 140);
    CHECK(ui::testPeakDrawn(), "アナログ計: 下がると新しいピーク(6200)に印を出す");
    ui::update(b, ls, ps, si, tFall + 130 + TACH_PEAK_HOLD_MS + 3200u * 1000u / TACH_PEAK_FALL_RPM_PER_S + 100);
    CHECK(memcmp(fbS, fb, sizeof(fbS)) == 0, "アナログ計: 新しいピーク(6200)も 3000 を切ると消え、最初の絵に戻る");
    gfx::dirtyClear();
    ui::testShow(ui::SC_DATA);
    ui::update(b, ls, ps, si, tFall + 1000);
    CHECK(ui::screen() == ui::SC_DATA && ui::blinkLevel() == BL_NORMAL && g_hostLevel == BL_NORMAL, "ほかの画面では設定の明るさに戻る");
    gfx::dirtyClear();
  }

  // ---------------- 12c. アナログ計の水温・燃料の札とブーストの数字(2026-10-22): 札は注意・警告のときだけ(中心の下)。
  //                   2.14.0: 燃料は 燃料の警告(初期 20 %)未満で警告(赤い札、点滅)、+10 % 未満で注意(黒地に暗い黄の枠の札、点滅なし)。
  //                   札や数字が変わっても針は壊れず、最初から描いたものと同じになる
  {
    Signals b;
    memset(&b, 0, sizeof(b));
    b.linkUp = b.rpmOk = true;
    b.rpm = 3000;
    b.waterOk = true; b.waterC = 90;
    b.fuelOk = true; b.fuelPct = 50;
    b.boostOk = true; b.boostBar = 0.65f;
    uint32_t tc = 65000000;  // (tc / ALARM_BLINK_HALF_MS) が偶数 = 異常の点滅の点灯側
    ui::testShow(ui::SC_BOOST);
    ui::update(b, ls, ps, si, tc);
    auto px = [&](int x, int y) { return fb[y * gfx::W + x]; };
    auto countIn = [&](int x0, int y0, int x1, int y1, uint16_t c) {
      int n = 0;
      for (int y = y0; y < y1; y++)
        for (int x = x0; x < x1; x++)
          if (px(x, y) == c) n++;
      return n;
    };
    const int bx0 = AN_BADGE_X, bx1 = AN_BADGE_X + AN_BADGE_W, by0 = AN_BADGE_Y, by1 = AN_BADGE_Y + AN_BADGE_PITCH + AN_BADGE_H;
    CHECK(countIn(bx0, by0, bx1, by1, gfx::rgb(0xE3241B)) == 0, "札: 水温 90 ℃・燃料 50 % では出ない");
    CHECK(countIn(BOOST_NUM_X - 160, BOOST_NUM_BASE - 50, BOOST_NUM_X, BOOST_NUM_BASE, gfx::rgb(0xFFFFFF)) > 300, "ブーストの今の値を白い数字で出す(10/23)");
    // ブーストの輪の角度(2.8.0 の決まり): 0 bar = 左下 120°、1.4 bar = 真上 270°、2.0 bar = 端 320°。その間はそれぞれ比例
    auto boostDeg = [](float bar) { return bar <= 1.4f ? 120.0f + 150.0f * bar / 1.4f : 270.0f + 50.0f * (bar - 1.4f) / 0.6f; };
    auto ringPx = [&](float deg) {  // 輪の太さの真ん中の画素
      const float r = (BOOST_RING_R_IN + BOOST_RING_R_OUT) * 0.5f, a = deg * 3.14159265f / 180.0f;
      return px((int)(233 + r * cosf(a)), (int)(233 + r * sinf(a)));
    };
    CHECK(ringPx(boostDeg(0.3f)) == gfx::rgb(0xA9AFBA), "ブーストの輪: 0.65 bar のとき 0.3 bar の所はトーンを落とした白");
    CHECK(ringPx(boostDeg(1.2f)) == gfx::rgb(0x161E2A), "ブーストの輪: 1.2 bar の所は地の色");
    b.boostBar = 1.4f;  // 2.8.0: 1.4 bar で真上(0 時)
    ui::update(b, ls, ps, si, tc);
    {
      const float rm = (BOOST_MARK_R_IN + BOOST_MARK_R_OUT) * 0.5f;
      CHECK(px(233, (int)(233 - rm)) == gfx::rgb(0xFFFFFF), "ブーストの輪: 1.4 bar のとき先端の白い目印が真上(0 時。2.8.0)");
    }
    CHECK(ringPx(265.0f) == gfx::rgb(0xA9AFBA) && ringPx(275.0f) == gfx::rgb(0x2E1A1C), "ブーストの輪: 1.4 bar のとき真上の手前まで白、真上から先は赤の範囲の地");
    b.boostBar = 0.65f;
    ui::update(b, ls, ps, si, tc);
    gfx::dirtyClear();
    static uint16_t fbC[gfx::W * gfx::H];
    b.fuelPct = set.fuelWarnPct + FUEL_CAUTION_ABOVE_PCT - 1;  // 29 %: 注意(2.14.0)
    ui::update(b, ls, ps, si, tc + 2 * ALARM_BLINK_HALF_MS);
    CHECK(countIn(bx0, AN_BADGE_Y, bx1, AN_BADGE_Y + AN_BADGE_H, gfx::rgb(0xE0B000)) > 300 && countIn(bx0, by0, bx1, by1, gfx::rgb(0xE3241B)) == 0
          && countIn(bx0 + 4, AN_BADGE_Y + 4, bx1 - 4, AN_BADGE_Y + AN_BADGE_H - 4, gfx::rgb(0x000000)) > 2000,
          "札: 燃料 29 % は注意 = 黒地に暗い黄の枠と文字(赤は無い。2.14.0)");
    memcpy(fbC, fb, sizeof(fbC));
    ui::testRedraw();
    ui::update(b, ls, ps, si, tc + 2 * ALARM_BLINK_HALF_MS);
    CHECK(memcmp(fbC, fb, sizeof(fbC)) == 0, "注意の札の絵 = 同じ時刻に最初から描いた絵");
    gfx::dirtyClear();
    ui::update(b, ls, ps, si, tc + 3 * ALARM_BLINK_HALF_MS);
    CHECK(gfx::dirtyCount() == 0, "札: 注意は点滅しない(消灯側の時刻でも描き直さない)");
    gfx::dirtyClear();
    b.fuelPct = set.fuelWarnPct - 1;  // 19 %: 警告の札(赤。1 つだけ: 上の段)
    b.rpm = 1000;  // 針も動かす
    ui::update(b, ls, ps, si, tc + 2 * ALARM_BLINK_HALF_MS);
    CHECK(countIn(bx0, AN_BADGE_Y, bx1, AN_BADGE_Y + AN_BADGE_H, gfx::rgb(0xE3241B)) > 2000 &&
          countIn(bx0, AN_BADGE_Y + AN_BADGE_PITCH, bx1, AN_BADGE_Y + AN_BADGE_PITCH + AN_BADGE_H, gfx::rgb(0xE3241B)) == 0, "札: 燃料 19 % で上の段に赤い札が出る(下の段は空)");
    memcpy(fbC, fb, sizeof(fbC));
    ui::testRedraw();
    ui::update(b, ls, ps, si, tc + 2 * ALARM_BLINK_HALF_MS);
    CHECK(memcmp(fbC, fb, sizeof(fbC)) == 0, "札が出て針が動いたあとの絵 = 同じ時刻に最初から描いた絵");
    gfx::dirtyClear();
    b.waterC = 115;  // 警告温度(110)以上: 2 段
    b.boostBar = 1.8f;  // 赤の範囲(2.8.0: 1.4 bar = 真上から)
    b.rpm = 5000;
    ui::update(b, ls, ps, si, tc + 3 * ALARM_BLINK_HALF_MS);  // 消灯側
    CHECK(countIn(bx0, by0, bx1, by1, gfx::rgb(0x8E130D)) > 4000, "札: 2 つとも出て、点滅の消灯側は暗い赤");
    // 2.8.0: 1.8 bar は 270 + 50 × 0.4 / 0.6 = 303.3°
    CHECK(ringPx(260.0f) == gfx::rgb(0xA9AFBA) && ringPx(290.0f) == gfx::rgb(0x9E3A33), "ブーストの輪: 1.8 bar のとき真上の手前は白、真上から先は赤(2.8.0)");
    CHECK(ringPx(312.0f) == gfx::rgb(0x2E1A1C), "ブーストの輪: 1.8 bar の先(312°)は赤の範囲の地(端は 320°)");
    memcpy(fbC, fb, sizeof(fbC));
    ui::testRedraw();
    ui::update(b, ls, ps, si, tc + 3 * ALARM_BLINK_HALF_MS);
    CHECK(memcmp(fbC, fb, sizeof(fbC)) == 0, "札が 2 つ・ブーストが赤の範囲の絵 = 同じ時刻に最初から描いた絵");
    gfx::dirtyClear();
    b.fuelPct = set.fuelWarnPct + FUEL_CAUTION_ABOVE_PCT + FUEL_ALARM_HYST_PCT;  // 31 %: 燃料の注意も終わる(水温だけ)
    b.waterOk = false;  // 水温の信号もなくなる: 札は出ない
    b.boostOk = false;  // ブーストの信号がない: 帯なし、数字は「– –」
    b.rpm = 2000;
    ui::update(b, ls, ps, si, tc + 4 * ALARM_BLINK_HALF_MS);
    CHECK(countIn(bx0, by0, bx1, by1, gfx::rgb(0xE3241B)) == 0 && countIn(bx0, by0, bx1, by1, gfx::rgb(0x8E130D)) == 0
          && countIn(bx0, by0, bx1, by1, gfx::rgb(0xE0B000)) == 0, "札: 注意・警告が終わると消える");
    CHECK(countIn(BOOST_NUM_X - 200, BOOST_NUM_BASE - 56, BOOST_NUM_X, BOOST_NUM_BASE, gfx::rgb(0x29C5FF)) == 0, "ブーストの信号がない: 水色の数字は消える");
    memcpy(fbC, fb, sizeof(fbC));
    ui::testRedraw();
    ui::update(b, ls, ps, si, tc + 4 * ALARM_BLINK_HALF_MS);
    CHECK(memcmp(fbC, fb, sizeof(fbC)) == 0, "札と帯が消えた絵 = 同じ時刻に最初から描いた絵(跡が残らない)");
    gfx::dirtyClear();
  }

  // ---------------- 12d. 走行画面の注意・警告(2.14.0。2026-10-22 の上下の赤い塗りはやめた): 背景は塗らず、弧の伸びた所とアイコンの色で出す。
  //                   燃料は 燃料の警告 + 10 % 未満で注意(暗い黄、点滅なし)、燃料の警告 未満で警告(赤、点滅。消灯側は暗い赤)。
  //                   水温は 警告温度 − 5 ℃ で注意、警告温度で警告。戻る側は境目から 1 ℃ / 1 % 離れてから
  {
    Signals b;
    memset(&b, 0, sizeof(b));
    b.linkUp = b.rpmOk = true;
    b.rpm = 2000;  // 背景は黒
    b.gearOk = true; b.gear = '2';
    b.waterOk = true; b.waterC = 90;
    b.fuelOk = true; b.fuelPct = set.fuelWarnPct + FUEL_CAUTION_ABOVE_PCT + 5;  // 35 %
    uint32_t td = 66000000;  // 警告の点滅の点灯側
    ui::testShow(ui::SC_DRIVE);
    ui::update(b, ls, ps, si, td);
    auto px = [&](int x, int y) { return fb[y * gfx::W + x]; };
    const uint16_t BLACK = gfx::rgb(0x000000), RED = gfx::rgb(0xE3241B), DIMRED = gfx::rgb(0x8E130D), PALE = gfx::rgb(0xE0B000), WHITE = gfx::rgb(0xFFFFFF);
    auto arcPx = [&](float deg) {  // 弧の太さの真ん中の画素
      const float a = deg * 3.14159265f / 180.0f, r = (ARC_R_IN + ARC_R_OUT) * 0.5f;
      return px((int)(233 + r * cosf(a)), (int)(233 + r * sinf(a)));
    };
    const float fuel10 = FUEL_ARC_START_DEG - ARC_SWEEP_DEG * 0.1f;  // 燃料 10 % の所(伸びた所の中)
    const float water80 = WATER_ARC_START_DEG + ARC_SWEEP_DEG * (80.0f - WATER_BAR_MIN_C) / (WATER_BAR_MAX_C - WATER_BAR_MIN_C);  // 水温 80 ℃ の所(70 ℃ の青より上)
    // 2.13.0 まで塗っていた所のうち、弧にもアイコンにも掛からない点: 燃料は (233, 300)、水温は (233, 165)
    CHECK(px(233, 300) == BLACK && px(233, 165) == BLACK, "正常: 塗らない");
    CHECK(arcPx(fuel10) == WHITE && arcPx(water80) == WHITE, "燃料 35 %: 10 % の所は白(伸びた所)。水温 90 ℃: 80 ℃ の所は白");
    gfx::dirtyClear();
    b.fuelPct = set.fuelWarnPct + FUEL_CAUTION_ABOVE_PCT - 1;  // 29 %: 注意
    ui::update(b, ls, ps, si, td + 2 * ALARM_BLINK_HALF_MS);
    CHECK(gfx::dirtyCount() > 0 && arcPx(fuel10) == PALE && px(233, 300) == BLACK && px(233, 165) == BLACK, "燃料 29 %: 注意 = 伸びた所が暗い黄、背景は塗らない(2.14.0)");
    static uint16_t fbD[gfx::W * gfx::H];
    memcpy(fbD, fb, sizeof(fbD));
    ui::testRedraw();
    ui::update(b, ls, ps, si, td + 2 * ALARM_BLINK_HALF_MS);
    CHECK(memcmp(fbD, fb, sizeof(fbD)) == 0, "燃料の注意の絵 = 同じ時刻に最初から描いた絵");
    gfx::dirtyClear();
    ui::update(b, ls, ps, si, td + 3 * ALARM_BLINK_HALF_MS);  // 警告なら消灯側の時刻
    CHECK(gfx::dirtyCount() == 0 && arcPx(fuel10) == PALE, "燃料 29 %: 注意は点滅しない");
    b.fuelPct = set.fuelWarnPct - 1;  // 19 %: 警告
    ui::update(b, ls, ps, si, td + 4 * ALARM_BLINK_HALF_MS);  // 点灯側
    CHECK(arcPx(fuel10) == RED && px(233, 300) == BLACK, "燃料 19 %: 警告の点灯側は伸びた所が赤、背景は塗らない");
    memcpy(fbD, fb, sizeof(fbD));
    ui::testRedraw();
    ui::update(b, ls, ps, si, td + 4 * ALARM_BLINK_HALF_MS);
    CHECK(memcmp(fbD, fb, sizeof(fbD)) == 0, "燃料の警告(点灯側)の絵 = 同じ時刻に最初から描いた絵");
    gfx::dirtyClear();
    ui::update(b, ls, ps, si, td + 5 * ALARM_BLINK_HALF_MS);  // 消灯側
    CHECK(gfx::dirtyCount() > 0 && arcPx(fuel10) == DIMRED && px(233, 300) == BLACK, "燃料 19 %: 消灯側は伸びた所が暗い赤、背景は塗らない");
    memcpy(fbD, fb, sizeof(fbD));
    ui::testRedraw();
    ui::update(b, ls, ps, si, td + 5 * ALARM_BLINK_HALF_MS);
    CHECK(memcmp(fbD, fb, sizeof(fbD)) == 0, "燃料の警告(消灯側)の絵 = 同じ時刻に最初から描いた絵");
    gfx::dirtyClear();
    b.waterC = set.warnTempC - WATER_CAUTION_BELOW_C;  // 105 ℃: 水温の注意(境目そのもの)
    ui::update(b, ls, ps, si, td + 6 * ALARM_BLINK_HALF_MS);
    CHECK(arcPx(water80) == PALE && px(233, 165) == BLACK, "水温 105 ℃(警告温度 − 5): 注意 = 伸びた所が暗い黄、上も塗らない");
    b.waterC = 112;
    ui::update(b, ls, ps, si, td + 8 * ALARM_BLINK_HALF_MS);  // 点灯側
    CHECK(arcPx(water80) == RED && arcPx(fuel10) == RED && px(233, 165) == BLACK && px(233, 300) == BLACK, "水温 112 ℃ と燃料 19 %: 上下とも赤、背景はどちらも塗らない");
    int centerWhite = 0;  // 真ん中の文字(白。2.10.0: ギアから接続の状態に変えた)はそのまま
    for (int y = 170; y < 296; y++)
      for (int x = 160; x < 306; x++)
        if (px(x, y) == WHITE) centerWhite++;
    memcpy(fbD, fb, sizeof(fbD));
    ui::testRedraw();
    ui::update(b, ls, ps, si, td + 8 * ALARM_BLINK_HALF_MS);
    CHECK(memcmp(fbD, fb, sizeof(fbD)) == 0 && centerWhite > 1000, "上下とも警告の絵 = 最初から描いた絵(真ん中の文字は残る)");
    // 戻る側の幅(ヒステリシス): 境目から 1 ℃ / 1 % 離れるまで今の段のまま(警告 → 注意、注意 → 正常とも)
    b.waterC = set.warnTempC - 0.5f;  // 109.5: まだ警告
    b.fuelPct = set.fuelWarnPct + 0.5f;  // 20.5: まだ警告
    ui::update(b, ls, ps, si, td + 10 * ALARM_BLINK_HALF_MS);
    CHECK(arcPx(water80) == RED && arcPx(fuel10) == RED, "警告温度 − 0.5 ℃・燃料の警告 + 0.5 %: まだ警告のまま");
    b.waterC = set.warnTempC - 1.5f;  // 108.5: 注意へ
    b.fuelPct = set.fuelWarnPct + 1.0f;  // 21: 注意へ
    ui::update(b, ls, ps, si, td + 12 * ALARM_BLINK_HALF_MS);
    CHECK(arcPx(water80) == PALE && arcPx(fuel10) == PALE, "警告温度 − 1.5 ℃・燃料の警告 + 1 %: 注意に戻る");
    b.waterC = set.warnTempC - WATER_CAUTION_BELOW_C - 0.5f;  // 104.5: まだ注意
    b.fuelPct = set.fuelWarnPct + FUEL_CAUTION_ABOVE_PCT + 0.5f;  // 30.5: まだ注意
    ui::update(b, ls, ps, si, td + 14 * ALARM_BLINK_HALF_MS);
    CHECK(arcPx(water80) == PALE && arcPx(fuel10) == PALE, "注意の境目から 0.5 戻っただけでは注意のまま");
    b.waterC = set.warnTempC - WATER_CAUTION_BELOW_C - 1.5f;  // 103.5: 正常
    b.fuelPct = set.fuelWarnPct + FUEL_CAUTION_ABOVE_PCT + 1.0f;  // 31: 正常
    ui::update(b, ls, ps, si, td + 16 * ALARM_BLINK_HALF_MS);
    CHECK(arcPx(water80) == WHITE && arcPx(fuel10) == WHITE, "注意の境目から 1.5 ℃ / 1 % 戻ったら正常");
    b.waterC = 118;  // 正常から一気に警告温度以上(2 段上がる)
    b.fuelPct = 50;
    ui::update(b, ls, ps, si, td + 18 * ALARM_BLINK_HALF_MS);
    CHECK(arcPx(water80) == RED && arcPx(fuel10) == WHITE, "正常から警告温度以上: いっぺんに警告");
    b.waterC = 90;  // 警告から一気に正常(2 段戻る)
    ui::update(b, ls, ps, si, td + 20 * ALARM_BLINK_HALF_MS);
    CHECK(arcPx(water80) == WHITE, "警告から大きく下がったら、いっぺんに正常");
    gfx::dirtyClear();
  }

  // ---------------- 12b. 点滅の速さ: 消灯は BLINK_OFF_MS で一定。点灯は始まり(シフト点 + RING_BLINK_OFFSET)で BLINK_ON_SLOW_MS、
  //                   シフト点で BLINK_ON_FAST_MS、間は比例
  {
    Signals b;
    memset(&b, 0, sizeof(b));
    b.linkUp = b.rpmOk = true;
    const int start = set.shiftRpm + RING_BLINK_OFFSET;
    const int span = set.shiftRpm - start;
    uint32_t tr = 70000000;
    ui::testShow(ui::SC_DRIVE);
    b.rpm = start - 1;
    ui::update(b, ls, ps, si, tr);
    CHECK(ui::blinkOnMs() == 0 && ui::blinkOffMs() == 0, "始まりの 1 rpm 下: 点滅しない");
    b.rpm = start;
    ui::update(b, ls, ps, si, tr += 1);
    CHECK(ui::blinkOnMs() == BLINK_ON_SLOW_MS && ui::blinkOffMs() == BLINK_OFF_MS, "始まり: 点灯は BLINK_ON_SLOW_MS、消灯は BLINK_OFF_MS");
    b.rpm = start + span / 2;
    ui::update(b, ls, ps, si, tr += 1);
    CHECK(ui::blinkOnMs() == (BLINK_ON_SLOW_MS + BLINK_ON_FAST_MS) / 2 && ui::blinkOffMs() == BLINK_OFF_MS, "始まりとシフト点の中間: 点灯はその中間、消灯は同じ");
    b.rpm = set.shiftRpm;
    ui::update(b, ls, ps, si, tr += 1);
    CHECK(ui::blinkOnMs() == BLINK_ON_FAST_MS, "シフト点: 点灯は BLINK_ON_FAST_MS");
    b.rpm = set.shiftRpm + RING_SOLID_OFFSET - 1;
    ui::update(b, ls, ps, si, tr += 1);
    CHECK(ui::blinkOnMs() == BLINK_ON_FAST_MS, "シフト点より上(点滅の終わりの手前まで): BLINK_ON_FAST_MS のまま");
    gfx::dirtyClear();
    // 回転数を 1 秒で始まりからシフト点まで上げる(1 ms ごとに update)。消灯の時間はいつも BLINK_OFF_MS、点灯の時間は
    // 遅い側と速い側の範囲に収まり、だんだん短くなる(位相が飛んで極端に短い・長い間隔が出ない)
    ui::testShow(ui::SC_DATA);  // いったん点滅を止める
    ui::update(b, ls, ps, si, tr += 1);
    ui::testShow(ui::SC_DRIVE);
    uint32_t t0 = tr + 1, lastEdge = 0, prevOn = 0, gaps = 0, badGap = 0, growGap = 0, badOff = 0;
    bool prevBlank = false;
    ui::BlinkStats bs0;
    ui::blinkStats(&bs0, true);
    for (uint32_t dt = 0; dt <= 1000; dt++) {
      b.rpm = start + (int)(span * dt / 1000);
      ui::update(b, ls, ps, si, t0 + dt);
      bool bl = ui::blankNow();
      if (bl != prevBlank) {
        if (lastEdge) {
          uint32_t gap = t0 + dt - lastEdge;
          gaps++;
          if (bl) {  // 点灯 → 消灯: 終わった区間は点灯
            if (gap < BLINK_ON_FAST_MS || gap > BLINK_ON_SLOW_MS) badGap++;
            if (prevOn && gap > prevOn) growGap++;
            prevOn = gap;
          } else if (gap != BLINK_OFF_MS) {  // 消灯 → 点灯: 終わった区間は消灯
            badOff++;
          }
        }
        lastEdge = t0 + dt;
        prevBlank = bl;
      }
    }
    ui::BlinkStats bs;
    ui::blinkStats(&bs, false);
    CHECK(gaps >= 8 && badGap == 0, "速さを上げながらの点灯の時間は、速い側と遅い側の範囲に収まる");
    CHECK(badOff == 0, "消灯の時間はいつも BLINK_OFF_MS");
    CHECK(growGap == 0, "点灯の時間はだんだん短くなる(位相が飛ばない)");
    CHECK(bs.toggles >= 8 && bs.lateMaxMs == 0 && bs.lateOver == 0, "1 ms ごとに見ていれば切り替えの遅れは 0");
    b.rpm = 850;
    ui::update(b, ls, ps, si, t0 + 1001);
    CHECK(!ui::blankNow() && ui::blinkOnMs() == 0, "点滅の範囲を下回ると点灯に戻る");
    gfx::dirtyClear();
  }

  // ---------------- 13. 設定の「デモ」(2.4.0: 最後の 8 項目目。2.9.0: 9 項目目。2.10.0: 13 項目目。2.12.0: その他の中の 1 項目目 = ITEMS の 15 番目)
  {
    Signals d;
    memset(&d, 0, sizeof(d));
    uint32_t td = 50000000;
    set.demoOn = 0;
    ui::testShow(ui::SC_SET_CAT, 15);
    holdOpen(d, td);  // 触れた時刻を操作した時刻にする(先に update すると、前の操作から時間がたっていて自動で戻る)
    CHECK(ui::screen() == ui::SC_SET_EDIT, "その他の中の 1 項目目で「デモ」の変更画面へ");
    ui::tap(366, 233, td += 100);
    CHECK(set.demoOn == 1, "右半分(入)でデモが入");
    ui::tap(366, 233, td += 100);
    CHECK(set.demoOn == 1, "もう一度押しても入のまま");
    int sv = g_hostSaves;
    ui::tap(233, 400, td += 100);
    ui::update(d, ls, ps, si, td);
    CHECK(ui::screen() == ui::SC_SET_EDIT && g_hostSaves == sv + 1 && ui::testFlashing(), "「決定」で保存し、下の帯が点滅(2.4.3)");
    ui::update(d, ls, ps, si, td + 2 * SAVED_FLASH_COUNT * SAVED_FLASH_MS + 10);
    CHECK(ui::screen() == ui::SC_SET_CAT && ui::testSetItem() == 15 && !ui::testFlashing(), "点滅が終わったらデモの項目へ");
    set.demoOn = 0;
    gfx::dirtyClear();
  }

  // ---------------- 14. 異常の表示の点滅(水温が警告温度以上、燃料が少ない): ALARM_BLINK_HALF_MS ごとに描き直す
  {
    static uint16_t fbA[gfx::W * gfx::H], fbB[gfx::W * gfx::H];
    Signals a;
    memset(&a, 0, sizeof(a));
    a.linkUp = a.rpmOk = a.waterOk = a.fuelOk = a.gearOk = true;
    a.rpm = 3000; a.waterC = 118; a.fuelPct = 8; a.gear = '3';
    uint32_t ta = (uint32_t)ALARM_BLINK_HALF_MS * 40000;  // (ta / ALARM_BLINK_HALF_MS) が偶数 = 点灯
    ui::testShow(ui::SC_DRIVE);
    ui::update(a, ls, ps, si, ta);
    memcpy(fbA, fb, sizeof(fbA));
    gfx::dirtyClear();
    ui::update(a, ls, ps, si, ta + ALARM_BLINK_HALF_MS);
    bool redrawn = gfx::dirtyCount() > 0;
    memcpy(fbB, fb, sizeof(fbB));
    gfx::dirtyClear();
    ui::update(a, ls, ps, si, ta + 2 * ALARM_BLINK_HALF_MS);
    CHECK(redrawn && memcmp(fbA, fbB, sizeof(fbA)) != 0, "走行画面: 異常の表示が消灯側で描き変わる");
    CHECK(memcmp(fbA, fb, sizeof(fbA)) == 0, "走行画面: 1 周期後は点灯側と同じ絵");
    gfx::dirtyClear();
    a.waterC = 90; a.fuelPct = 50;  // 正常に戻す(戻る側の幅 1 ℃ / 1 % より大きく下げる)
    ui::update(a, ls, ps, si, ta + 3 * ALARM_BLINK_HALF_MS);
    memcpy(fbA, fb, sizeof(fbA));
    gfx::dirtyClear();
    ui::update(a, ls, ps, si, ta + 4 * ALARM_BLINK_HALF_MS);
    CHECK(gfx::dirtyCount() == 0 && memcmp(fbA, fb, sizeof(fbA)) == 0, "走行画面: 正常なら点滅しない(描き直しなし)");
    gfx::dirtyClear();
    // データ画面でも同じ
    a.waterC = 118; a.fuelPct = 8;
    ui::testShow(ui::SC_DATA);
    ui::update(a, ls, ps, si, ta + 8 * ALARM_BLINK_HALF_MS);
    ui::update(a, ls, ps, si, ta + 8 * ALARM_BLINK_HALF_MS + 60);
    memcpy(fbA, fb, sizeof(fbA));
    gfx::dirtyClear();
    ui::update(a, ls, ps, si, ta + 9 * ALARM_BLINK_HALF_MS);
    ui::update(a, ls, ps, si, ta + 9 * ALARM_BLINK_HALF_MS + 60);
    CHECK(memcmp(fbA, fb, sizeof(fbA)) != 0, "データ画面: 異常の表示が消灯側で描き変わる");
    gfx::dirtyClear();
  }

  // ---------------- 15. 受信の状態の RaceChrono・IMU(2.4.0: グループ)。下の点の判定、向きの補正、送信の入・切、上の帯で戻る
  {
    Signals d;
    memset(&d, 0, sizeof(d));
    uint32_t tr = 60000000;
    const uint16_t GREEN = gfx::rgb(0x22E36A), RED = gfx::rgb(0xE3241B);
    // 下の点(n 個、y 330、間隔 26)の i 個目の色(今のページの点も、真ん中はその判定の色)
    auto dotCol = [&](int n, int i) { return fb[330 * gfx::W + (int)(233 - 26 * (n - 1) * 0.5f + 26 * i)]; };
    ui::testShow(ui::SC_SET_INFO, 3);
    holdOpen(d, tr);
    CHECK(ui::screen() == ui::SC_SET_GRP && ui::testGroup() == 3 && ui::testPage() == 0, "受信の状態 4 ページ目(RaceChrono)の「長押しで開く」で中へ");
    si.rc.enabled = true; si.rc.bleOk = true; si.rc.connected = true; si.rc.gpsOk = true; si.rc.fixType = 3; si.rc.numSV = 9; si.rc.lat = 355812345; si.rc.lon = 1396821234;
    si.rc.imuOk = true; si.rc.imuLevel = true; si.rc.imuForward = true; si.rc.imuPidOk = 3; si.rc.imuPerSec = 40;
    ui::update(d, ls, ps, si, tr += 600);
    ui::update(d, ls, ps, si, tr += 600);
    CHECK(ui::screen() == ui::SC_SET_GRP, "値が変わっても画面はそのまま");
    {
      char v[48];
      CHECK(ui::testInfoItem(3, 2, ls, ps, si, tr, v, sizeof(v)) == 1 && strcmp(v, "CAN 0/s GPS 0/s IMU 40/s") == 0, "2.14.2: 送った数に IMU の数/秒");
      SysInfo s2 = si; s2.rc.imuPidOk = 1;
      CHECK(ui::testInfoItem(3, 2, ls, ps, s2, tr, v, sizeof(v)) == 0 && strcmp(v, "CAN 0/s GPS 0/s IMU F2未設定") == 0, "2.14.2: ヨーレートの PID を頼まれていなければ F2未設定");
      s2.rc.imuPidOk = 0;
      CHECK(ui::testInfoItem(3, 2, ls, ps, s2, tr, v, sizeof(v)) == 0 && strcmp(v, "CAN 0/s GPS 0/s IMU 未設定") == 0, "2.14.2: どちらも頼まれていなければ 未設定(待ち)");
    }
    // RaceChrono の点(3 個): 1 個目は送信の入・切(判定なし)、2 個目 = 接続、3 個目 = 送った数
    CHECK(dotCol(3, 1) == GREEN && dotCol(3, 2) == GREEN, "RaceChrono: 接続中なら 接続・送った数 の点が緑");
    si.rc.bleOk = false;  // BLE を開始できない: 2 個目(接続)が赤
    ui::update(d, ls, ps, si, tr += 600);
    CHECK(dotCol(3, 1) == RED, "RaceChrono: BLE を開始できないと 2 個目(接続)の点が赤");
    si.rc.bleOk = true;
    // IMU の点(2 個): 加速度・向きの補正。IMU が応答しないと 1 個目が赤
    ui::testShow(ui::SC_SET_GRP, 0, 2);
    ui::testTouch(tr);
    ui::update(d, ls, ps, si, tr += 600);
    CHECK(dotCol(2, 0) == GREEN && dotCol(2, 1) == GREEN, "IMU: 正常なら 2 個とも緑");
    si.rc.imuOk = false;
    ui::update(d, ls, ps, si, tr += 600);
    CHECK(dotCol(2, 0) == RED, "IMU: 応答しないと 1 個目(加速度)の点が赤");
    si.rc.imuOk = true;
    ui::update(d, ls, ps, si, tr + 4 * 60000);
    CHECK(ui::screen() == ui::SC_DRIVE, "グループの中: 自動で覚えた画面(サーキット)に戻る");
    ui::testShow(ui::SC_SET_GRP, 0, 2);
    ui::update(d, ls, ps, si, tr += 100);
    ui::tap(233, 60, tr += 100);
    ui::update(d, ls, ps, si, tr);
    CHECK(ui::screen() == ui::SC_SET_INFO && ui::testPage() == 2, "IMU の中: 上の「‹ IMU」で受信の状態の IMU のページへ");
    ui::testShow(ui::SC_SET_GRP, 0, 2);
    ui::update(d, ls, ps, si, tr += 100);
    int resets0 = g_hostImuResets;
    holdOpen(d, tr);  // 「加速度」のページには下の操作が無い(何も起きない)
    CHECK(ui::screen() == ui::SC_SET_GRP && ui::testPage() == 0, "「加速度」のページは下の帯の長押しでも何もしない");
    ui::swipe(1, tr += 100);       // 次 → 「向きの補正」
    ui::update(d, ls, ps, si, tr += 600);  // 描くと下に「長押しで開く」が出る
    holdOpen(d, tr);  // 確認の画面(2.4.3。前は押すとすぐ捨てていた)
    CHECK(ui::screen() == ui::SC_SET_RESET && g_hostImuResets == resets0, "IMU の「向きの補正」の下「長押しで開く」で確認の画面(まだ捨てない)");
    ui::tap(233, 60, tr += 100);   // 上「‹ 戻る」= 捨てずに戻る
    ui::update(d, ls, ps, si, tr);
    CHECK(ui::screen() == ui::SC_SET_GRP && ui::testGroup() == 2 && ui::testPage() == 1 && g_hostImuResets == resets0, "確認: 上「‹ 戻る」は捨てずに向きの補正のページへ");
    ui::update(d, ls, ps, si, tr += 600);
    holdOpen(d, tr);
    ui::tap(233, 400, tr += 100);  // 赤い「取り直す」(タップ)
    ui::update(d, ls, ps, si, tr);
    CHECK(ui::screen() == ui::SC_SET_GRP && ui::testGroup() == 2 && ui::testPage() == 1 && g_hostImuResets == resets0 + 1, "確認: 下「取り直す」で覚えた向きを捨て(1 回だけ)、向きの補正のページへ");
    // RaceChrono の 1 ページ目「送信」(入・切)
    set.rcOn = 1;
    ui::testShow(ui::SC_SET_GRP, 0, 3);
    ui::update(d, ls, ps, si, tr += 100);  // 描くと下に「長押しで開く」が出る
    holdOpen(d, tr);
    CHECK(ui::screen() == ui::SC_SET_EDIT, "RaceChrono の 1 ページ目「送信」の「長押しで開く」で変更画面へ");
    ui::tap(100, 233, tr += 100);
    CHECK(set.rcOn == 0, "左半分(切)で切");
    ui::tap(100, 233, tr += 100);
    CHECK(set.rcOn == 0, "もう一度押しても切のまま");
    int sv = g_hostSaves;
    ui::tap(233, 400, tr += 100);
    ui::update(d, ls, ps, si, tr);
    CHECK(ui::screen() == ui::SC_SET_EDIT && set.rcOn == 0 && g_hostSaves == sv + 1 && ui::testFlashing(), "「決定」で保存し、下の帯が点滅(2.4.3)");
    ui::update(d, ls, ps, si, tr + 2 * SAVED_FLASH_COUNT * SAVED_FLASH_MS + 10);
    CHECK(ui::screen() == ui::SC_SET_GRP && ui::testGroup() == 3 && ui::testPage() == 0 && !ui::testFlashing(), "点滅が終わったら RaceChrono の 1 ページ目へ");
    tr += 1900;
    holdOpen(d, tr);
    ui::tap(233, 60, tr += 100);  // 変えずに「‹ 戻る」
    ui::update(d, ls, ps, si, tr);
    CHECK(ui::screen() == ui::SC_SET_GRP && ui::testGroup() == 3 && g_hostSaves == sv + 1, "変更画面の「‹ 戻る」で RaceChrono の 1 ページ目へ(保存しない)");
    ui::tap(233, 60, tr += 100);
    ui::update(d, ls, ps, si, tr);
    CHECK(ui::screen() == ui::SC_SET_INFO && ui::testPage() == 3, "RaceChrono の中: 上の「‹ RaceChrono」で受信の状態の RaceChrono のページへ");
    set.rcOn = SET_RC_DEFAULT;
    memset(&si.rc, 0, sizeof(si.rc));
    gfx::dirtyClear();
  }

  // ---------------- 16. GPS(UBX の解析): NAV-PVT、ACK、チェックサム誤り、長いメッセージの読み飛ばし、ごみ
  {
    gnss::begin();
    // NAV-PVT(92 バイト)を組み立てる。2026-10-14 03:15:30.250、3D、衛星 11、東京駅あたり、48.3 km/h、方位 123.45°
    uint8_t pay[92];
    memset(pay, 0, sizeof(pay));
    auto put16 = [&](int off, uint16_t v) { pay[off] = (uint8_t)v; pay[off + 1] = (uint8_t)(v >> 8); };
    auto put32 = [&](int off, uint32_t v) { for (int i = 0; i < 4; i++) pay[off + i] = (uint8_t)(v >> (8 * i)); };
    put32(0, 123456789);          // iTOW
    put16(4, 2026); pay[6] = 10; pay[7] = 14; pay[8] = 3; pay[9] = 15; pay[10] = 30;
    pay[11] = 0x07;               // validDate | validTime | fullyResolved
    put32(16, (uint32_t)250000000);  // nano
    pay[20] = 3;                  // fixType 3D
    pay[21] = 0x01;               // gnssFixOK
    pay[23] = 11;                 // numSV
    put32(24, (uint32_t)1396821234);  // lon
    put32(28, (uint32_t)355812345);   // lat
    put32(36, (uint32_t)45000);       // hMSL [mm]
    put32(60, (uint32_t)13417);       // gSpeed [mm/s] = 48.30 km/h
    put32(64, (uint32_t)12345000);    // headMot [1e-5 deg] = 123.45°
    put16(76, 150);                   // pDOP 1.50
    std::vector<uint8_t> msg = { 0xB5, 0x62, 0x01, 0x07, 92, 0 };
    msg.insert(msg.end(), pay, pay + 92);
    uint8_t ckA = 0, ckB = 0;
    for (size_t i = 2; i < msg.size(); i++) { ckA = (uint8_t)(ckA + msg[i]); ckB = (uint8_t)(ckB + ckA); }
    msg.push_back(ckA);
    msg.push_back(ckB);
    int got = 0;
    for (size_t i = 0; i < msg.size(); i++) got += gnss::feed(&msg[i], 1, 5000);  // 1 バイトずつ
    gnss::Fix f;
    CHECK(got == 1 && gnss::pvtCount() == 1 && gnss::latest(&f), "NAV-PVT を 1 バイトずつ受けて 1 つ完成");
    CHECK(f.fixOk && f.fixType == 3 && f.numSV == 11 && !f.diffSoln, "fix の種類と衛星数");
    CHECK(f.timeOk && f.year == 2026 && f.month == 10 && f.day == 14 && f.hour == 3 && f.min == 15 && f.sec == 30 && f.nano == 250000000, "日時");
    CHECK(f.lat == 355812345 && f.lon == 1396821234 && f.hMSL == 45000 && f.gSpeed == 13417 && f.headMot == 12345000 && f.pDOP == 150 && f.rxMs == 5000, "位置・高さ・速度・方位・精度");
    // まとめて 2 つ + ACK-ACK + NAK
    std::vector<uint8_t> two(msg);
    two.insert(two.end(), msg.begin(), msg.end());
    uint8_t ack[] = { 0xB5, 0x62, 0x05, 0x01, 2, 0, 0x06, 0x8A, 0x98, 0xC1 };  // ACK-ACK for CFG-VALSET(チェックサムは下で計算)
    { uint8_t a = 0, b = 0; for (int i = 2; i < 8; i++) { a = (uint8_t)(a + ack[i]); b = (uint8_t)(b + a); } ack[8] = a; ack[9] = b; }
    uint8_t nak[10]; memcpy(nak, ack, 10); nak[3] = 0x00;
    { uint8_t a = 0, b = 0; for (int i = 2; i < 8; i++) { a = (uint8_t)(a + nak[i]); b = (uint8_t)(b + a); } nak[8] = a; nak[9] = b; }
    two.insert(two.end(), ack, ack + 10);
    two.insert(two.end(), nak, nak + 10);
    got = gnss::feed(two.data(), two.size(), 6000);
    CHECK(got == 2 && gnss::pvtCount() == 3 && gnss::ackCount() == 1 && gnss::nakCount() == 1 && gnss::badCount() == 0, "続けて届いた NAV-PVT 2 つと ACK・NAK");
    // チェックサムが合わない(1 ビット壊す)
    std::vector<uint8_t> bad(msg);
    bad[30] ^= 0x01;
    got = gnss::feed(bad.data(), bad.size(), 7000);
    CHECK(got == 0 && gnss::badCount() == 1 && gnss::pvtCount() == 3, "チェックサムの合わない NAV-PVT は使わない");
    // 長い別のメッセージ(600 バイト)を読み飛ばし、その後の NAV-PVT を拾う
    std::vector<uint8_t> lng = { 0xB5, 0x62, 0x02, 0x15, (uint8_t)(600 & 0xFF), (uint8_t)(600 >> 8) };
    for (int i = 0; i < 600; i++) lng.push_back((uint8_t)i);
    { uint8_t a = 0, b = 0; for (size_t i = 2; i < lng.size(); i++) { a = (uint8_t)(a + lng[i]); b = (uint8_t)(b + a); } lng.push_back(a); lng.push_back(b); }
    lng.insert(lng.end(), msg.begin(), msg.end());
    got = gnss::feed(lng.data(), lng.size(), 8000);
    CHECK(got == 1 && gnss::pvtCount() == 4 && gnss::badCount() == 1, "長いメッセージを読み飛ばして次の NAV-PVT を拾う");
    // ごみ(NMEA の文)の中の NAV-PVT
    std::vector<uint8_t> junk;
    const char *nmea = "$GNGGA,031530.00,3534.87,N,13940.93,E,1,11,1.5,45.0,M,39.0,M,,*5C\r\n";
    junk.insert(junk.end(), nmea, nmea + strlen(nmea));
    junk.push_back(0xB5);  // 偽の同期
    junk.push_back(0x11);
    junk.insert(junk.end(), msg.begin(), msg.end());
    junk.insert(junk.end(), nmea, nmea + strlen(nmea));
    got = gnss::feed(junk.data(), junk.size(), 9000);
    CHECK(got == 1 && gnss::pvtCount() == 5, "NMEA のごみと偽の同期の間の NAV-PVT を拾う");
    // 設定メッセージの形: CFG-VALSET、層、鍵の数
    uint8_t cfg[128];
    size_t n = gnss::buildConfig(cfg, sizeof(cfg), 25);
    CHECK(n > 8 && cfg[0] == 0xB5 && cfg[1] == 0x62 && cfg[2] == 0x06 && cfg[3] == 0x8A && n == (size_t)(cfg[4] | (cfg[5] << 8)) + 8, "CFG-VALSET の枠");
    CHECK(cfg[6] == 0 && cfg[7] == RC_GPS_CFG_LAYERS, "版 0、層は config.h の値");
    {
      uint8_t a = 0, b = 0;
      for (size_t i = 2; i < n - 2; i++) { a = (uint8_t)(a + cfg[i]); b = (uint8_t)(b + a); }
      CHECK(cfg[n - 2] == a && cfg[n - 1] == b, "CFG-VALSET のチェックサム");
      // 鍵を数える(4 + 値の大きさ)。RATE_MEAS = 40 ms が入っている
      size_t pos = 10;
      int keys = 0;
      bool meas40 = false;
      while (pos + 4 <= n - 2) {
        uint32_t key = (uint32_t)cfg[pos] | ((uint32_t)cfg[pos + 1] << 8) | ((uint32_t)cfg[pos + 2] << 16) | ((uint32_t)cfg[pos + 3] << 24);
        int sz = (int)((key >> 28) & 7);
        int vn = sz == 3 ? 2 : sz == 4 ? 4 : 1;
        if (key == 0x30210001 && vn == 2 && (cfg[pos + 4] | (cfg[pos + 5] << 8)) == 40) meas40 = true;
        pos += 4 + (size_t)vn;
        keys++;
      }
      CHECK(keys == 7 && pos == n - 2 && meas40, "測位の設定は鍵 7 個、測位の間隔 40 ms(25 回/秒)");
    }
    n = gnss::buildSignals(cfg, sizeof(cfg));
    CHECK(n > 8 && cfg[2] == 0x06 && cfg[3] == 0x8A && cfg[7] == RC_GPS_CFG_LAYERS && n == (size_t)(cfg[4] | (cfg[5] << 8)) + 8, "衛星系の設定も CFG-VALSET");
    {
      uint8_t a = 0, b = 0;
      for (size_t i = 2; i < n - 2; i++) { a = (uint8_t)(a + cfg[i]); b = (uint8_t)(b + a); }
      size_t pos = 10;
      int keys = 0, on = 0;
      while (pos + 4 <= n - 2) {
        uint32_t key = (uint32_t)cfg[pos] | ((uint32_t)cfg[pos + 1] << 8) | ((uint32_t)cfg[pos + 2] << 16) | ((uint32_t)cfg[pos + 3] << 24);
        int sz = (int)((key >> 28) & 7);
        int vn = sz == 3 ? 2 : sz == 4 ? 4 : 1;
        if (vn == 1 && cfg[pos + 4]) on++;
        pos += 4 + (size_t)vn;
        keys++;
      }
      CHECK(cfg[n - 2] == a && cfg[n - 1] == b && keys == 9 && on == 6 && pos == n - 2, "衛星系の設定: 鍵 9 個(入 6 = GPS・Galileo・QZSS、切 3 = BeiDou・GLONASS・SBAS)、チェックサム");
    }
    n = gnss::buildBaud(cfg, sizeof(cfg), 115200);
    CHECK(n == 8 + 4 + 8 && cfg[10] == 0x01 && cfg[11] == 0x00 && cfg[12] == 0x52 && cfg[13] == 0x40 && cfg[14] == 0x00 && cfg[15] == 0xC2 && cfg[16] == 0x01 && cfg[17] == 0x00,
          "速度の設定: 鍵 0x40520001 と 115200(4 バイト)");
    CHECK(gnss::buildConfig(cfg, 16, 25) == 0, "出力が小さすぎるときは 0");
    // 2.13.0: M10 の OTP の高性能設定(SAM-M10Q 統合マニュアル 2.1.5)。設定列・問い合わせ・リセットの枠とチェックサム、応答の読み取り
    {
      auto ckOk = [](const uint8_t *m, size_t n) {
        if (n < 8 || m[0] != 0xB5 || m[1] != 0x62) return false;
        size_t len = (size_t)(m[4] | (m[5] << 8));
        if (n != len + 8) return false;
        uint8_t a = 0, b = 0;
        for (size_t i = 2; i < n - 2; i++) { a = (uint8_t)(a + m[i]); b = (uint8_t)(b + a); }
        return m[n - 2] == a && m[n - 1] == b;
      };
      uint8_t m[64];
      size_t n1 = gnss::buildOtpHighPerf(0, m, sizeof(m));
      CHECK(n1 == 24 && m[2] == 0x06 && m[3] == 0x41 && m[6] == 0x03 && m[22] == 0x8F && m[23] == 0x0D && ckOk(m, n1), "OTP 1 本目: CFG-OTP、24 バイト、チェックサム 8F 0D");
      size_t n2 = gnss::buildOtpHighPerf(1, m, sizeof(m));
      CHECK(n2 == 36 && m[2] == 0x06 && m[3] == 0x41 && m[6] == 0x04 && m[34] == 0xDE && m[35] == 0xAE && ckOk(m, n2), "OTP 2 本目: CFG-OTP、36 バイト、チェックサム DE AE");
      // 2 本目の中に 192 MHz(0x0B71B000)と 96 MHz(0x05B8D800)の値が入っている
      CHECK(m[22] == 0x00 && m[23] == 0xB0 && m[24] == 0x71 && m[25] == 0x0B && m[30] == 0x00 && m[31] == 0xD8 && m[32] == 0xB8 && m[33] == 0x05, "OTP 2 本目: 192 MHz と 96 MHz の値");
      size_t n3 = gnss::buildOtpValgetPoll(m, sizeof(m));
      CHECK(n3 == 28 && m[2] == 0x06 && m[3] == 0x8B && m[26] == 0x4C && m[27] == 0x15 && ckOk(m, n3), "OTP の確認: VALGET の問い合わせ、28 バイト、チェックサム 4C 15");
      size_t n4 = gnss::buildMonVerPoll(m, sizeof(m));
      CHECK(n4 == 8 && m[2] == 0x0A && m[3] == 0x04 && m[4] == 0 && m[5] == 0 && ckOk(m, n4), "MON-VER の問い合わせ: 中身なしの 8 バイト");
      size_t n5 = gnss::buildReset(m, sizeof(m));
      CHECK(n5 == 12 && m[2] == 0x06 && m[3] == 0x04 && m[6] == 0 && m[7] == 0 && m[8] == 0 && ckOk(m, n5), "CFG-RST: ハードウェアリセット、ホットスタート");
      CHECK(gnss::buildOtpHighPerf(1, m, 20) == 0 && gnss::buildOtpValgetPoll(m, 10) == 0, "出力が小さすぎるときは 0");
      // 応答の読み取り: マニュアルの期待する応答 → 設定済み。値が違う応答 → 未設定。ACK/NAK の数え分け。MON-VER の版
      gnss::begin();
      CHECK(gnss::otpHighPerfState() == 0 && !gnss::monVer(nullptr, 0, nullptr, 0), "読む前: 応答なし、版なし");
      static const uint8_t resp[] = { 0xB5, 0x62, 0x06, 0x8B, 0x24, 0x00, 0x01, 0x04, 0x00, 0x00, 0x01, 0x00, 0xA4, 0x40, 0x00, 0xB0, 0x71, 0x0B, 0x03, 0x00, 0xA4, 0x40, 0x00, 0xB0, 0x71, 0x0B,
                                      0x05, 0x00, 0xA4, 0x40, 0x00, 0xB0, 0x71, 0x0B, 0x0A, 0x00, 0xA4, 0x40, 0x00, 0xD8, 0xB8, 0x05, 0x76, 0x81 };
      gnss::feed(resp, sizeof(resp), 1000);
      uint32_t v = 0;
      CHECK(gnss::valgetCount() == 1 && gnss::valgetValue(0x40A4000A, &v) && v == 0x05B8D800 && gnss::valgetValue(0x40A40003, &v) && v == 0x0B71B000 && !gnss::valgetValue(0x40A40002, &v),
            "VALGET の応答: 鍵の値を取れる、無い鍵は false");
      CHECK(gnss::otpHighPerfState() == 1, "マニュアルの期待する応答 → 設定済み");
      uint8_t resp2[sizeof(resp)];
      memcpy(resp2, resp, sizeof(resp));
      resp2[15] = 0x00; resp2[16] = 0x6E; resp2[17] = 0x02;  // 1 つ目の鍵を 0x026E0000 に(既定のクロックの想定)
      { uint8_t a = 0, b = 0; for (size_t i = 2; i < sizeof(resp2) - 2; i++) { a = (uint8_t)(a + resp2[i]); b = (uint8_t)(b + a); } resp2[sizeof(resp2) - 2] = a; resp2[sizeof(resp2) - 1] = b; }
      gnss::feed(resp2, sizeof(resp2), 1100);
      CHECK(gnss::valgetCount() == 2 && gnss::otpHighPerfState() == 2, "値が違う応答 → 未設定");
      static const uint8_t ackOtp[] = { 0xB5, 0x62, 0x05, 0x01, 0x02, 0x00, 0x06, 0x41, 0x4F, 0x78 };
      static const uint8_t ackValget[] = { 0xB5, 0x62, 0x05, 0x01, 0x02, 0x00, 0x06, 0x8B, 0x99, 0xC2 };
      static const uint8_t nakValget[] = { 0xB5, 0x62, 0x05, 0x00, 0x02, 0x00, 0x06, 0x8B, 0x98, 0xBD };
      gnss::feed(ackOtp, sizeof(ackOtp), 1200);
      gnss::feed(ackOtp, sizeof(ackOtp), 1300);
      gnss::feed(ackValget, sizeof(ackValget), 1400);
      gnss::feed(nakValget, sizeof(nakValget), 1500);
      CHECK(gnss::ackOtpCount() == 2 && gnss::nakOtpCount() == 0 && gnss::nakValgetCount() == 1 && gnss::ackCount() == 3 && gnss::nakCount() == 1 && gnss::badCount() == 0,
            "ACK/NAK: CFG-OTP の ACK 2、VALGET の ACK 1・NAK 1");
      // MON-VER: swVersion 30 文字、hwVersion 10 文字、拡張 2 つ(各 30)= 100 バイト
      uint8_t mv[8 + 100];
      memset(mv, 0, sizeof(mv));
      mv[0] = 0xB5; mv[1] = 0x62; mv[2] = 0x0A; mv[3] = 0x04; mv[4] = 100; mv[5] = 0;
      memcpy(mv + 6, "ROM SPG 5.10 (7b202e)", 21);
      memcpy(mv + 36, "000A0000", 8);
      memcpy(mv + 46, "PROTVER=34.10", 13);
      memcpy(mv + 76, "MOD=MAX-M10S", 12);
      { uint8_t a = 0, b = 0; for (size_t i = 2; i < 106; i++) { a = (uint8_t)(a + mv[i]); b = (uint8_t)(b + a); } mv[106] = a; mv[107] = b; }
      gnss::feed(mv, sizeof(mv), 1600);
      char sw[32], hw[12];
      CHECK(gnss::monVerCount() == 1 && gnss::monVer(sw, sizeof(sw), hw, sizeof(hw)) && strcmp(sw, "ROM SPG 5.10 (7b202e)") == 0 && strcmp(hw, "000A0000") == 0, "MON-VER: 版を読める");
      CHECK(strncmp(sw, RC_GPS_OTP_FW_PREFIX, strlen(RC_GPS_OTP_FW_PREFIX)) == 0, "版が手順の対象(ROM SPG 5.10)で始まる");
      gnss::begin();
      CHECK(gnss::otpHighPerfState() == 0 && gnss::ackOtpCount() == 0 && gnss::monVerCount() == 0, "begin で OTP の受信もリセット");
    }
  }

  // ---------------- 17. RaceChrono DIY の符号化(GPS 20 バイト、日時 3 バイト、CAN)
  {
    gnss::Fix f;
    memset(&f, 0, sizeof(f));
    f.fixOk = true; f.fixType = 3; f.numSV = 11; f.timeOk = true;
    f.year = 2026; f.month = 10; f.day = 14; f.hour = 3; f.min = 15; f.sec = 30; f.nano = 250000000;
    f.lat = 355812345; f.lon = 1396821234; f.hMSL = 45000; f.gSpeed = 13417; f.headMot = 12345000; f.pDOP = 150;
    uint8_t g[20];
    rcdiy::encodeGpsMain(f, 5, g);
    // 参照: 仕様書の式を直接書いたもの
    uint32_t tt = 15 * 30000 + 30 * 500 + 250 / 2;  // 465125
    CHECK(g[0] == ((5 << 5) | ((tt >> 16) & 0x1F)) && g[1] == ((tt >> 8) & 0xFF) && g[2] == (tt & 0xFF), "GPS: sync 5 と正時からの時刻");
    CHECK(g[3] == ((1 << 6) | 11), "GPS: fix 1(GPS)と衛星 11");
    CHECK(g[4] == 0x15 && g[5] == 0x35 && g[6] == 0x43 && g[7] == 0xF9, "GPS: 緯度 355812345 = 0x153543F9(上位が先)");
    CHECK(g[8] == 0x53 && g[9] == 0x41 && g[10] == 0xCC && g[11] == 0xF2, "GPS: 経度 1396821234 = 0x5341CCF2");
    CHECK(((g[12] << 8) | g[13]) == (45 + 500) * 10, "GPS: 高さ (m + 500) × 10");
    CHECK(((g[14] << 8) | g[15]) == 4830, "GPS: 速度 48.30 km/h × 100");
    CHECK(((g[16] << 8) | g[17]) == 12345, "GPS: 方位 123.45° × 100");
    CHECK(g[18] == 15 && g[19] == 0xFF, "GPS: 精度 1.5 × 10、VDOP なし");
    f.diffSoln = true;
    rcdiy::encodeGpsMain(f, 0, g);
    CHECK(g[3] == ((2 << 6) | 11), "GPS: 補正ありは fix 2");
    f.diffSoln = false;
    f.hMSL = 3000000; f.gSpeed = 100000;  // 3000 m、360 km/h
    rcdiy::encodeGpsMain(f, 0, g);
    CHECK(((g[12] << 8) | g[13]) == ((3000 + 500) | 0x8000) && ((g[14] << 8) | g[15]) == (3600 | 0x8000), "GPS: 高さ 3000 m と 360 km/h は粗い刻み(上位ビット)");
    f.hMSL = 45000; f.gSpeed = 13417; f.headMot = -1000000;  // −10°
    rcdiy::encodeGpsMain(f, 0, g);
    CHECK(((g[16] << 8) | g[17]) == 35000, "GPS: 負の方位は 0〜360 に直す");
    f.fixOk = false;
    rcdiy::encodeGpsMain(f, 7, g);
    CHECK(g[0] >> 5 == 7 && g[3] == 11 && g[4] == 0x7F && g[5] == 0xFF && g[6] == 0xFF && g[7] == 0xFF && g[8] == 0x7F && g[9] == 0xFF && g[12] == 0xFF && g[13] == 0xFF && g[14] == 0xFF && g[16] == 0xFF && g[18] == 0xFF,
          "GPS: 測位なしのときは位置・高さ・速度・方位・精度が「無効」の値");
    f.fixOk = true;
    uint8_t tm[3];
    rcdiy::encodeGpsTime(f, 5, tm);
    uint32_t code = (2026 - 2000) * 8928 + (10 - 1) * 744 + (14 - 1) * 24 + 3;  // 239139
    CHECK(rcdiy::dateHourCode(f) == code && tm[0] == ((5 << 5) | ((code >> 16) & 0x1F)) && tm[1] == ((code >> 8) & 0xFF) && tm[2] == (code & 0xFF), "日時: sync 5 と日・時の符号");
    f.hour = 4;
    CHECK(rcdiy::dateHourCode(f) == code + 1, "日時: 時が進むと符号が 1 増える");
    uint8_t c[20];
    uint8_t d[8] = { 0x11, 0x22, 0x33, 0x44, 0x55, 0x66, 0x77, 0x88 };
    size_t cn = rcdiy::encodeCan(0x0618A001, d, 8, c);
    CHECK(cn == 12 && c[0] == 0x01 && c[1] == 0xA0 && c[2] == 0x18 && c[3] == 0x06 && memcmp(c + 4, d, 8) == 0, "CAN: ID は下位が先、中身はそのまま");
    CHECK(rcdiy::encodeCan(0x1FFFFF01, d, 3, c) == 7 && c[3] == 0x1F && c[4] == 0x11 && c[6] == 0x33, "CAN: 長さ 3");
  }

  // ---------------- 18. RaceChrono の PID フィルタ(0x0002 への命令)
  {
    rcdiy::filterReset();
    CHECK(!rcdiy::filterPass(0x0618A001, 1000) && rcdiy::filterCount() == 0, "最初は全部拒否");
    uint8_t allow[] = { 2, 0x00, 0x64, 0x06, 0x18, 0xA0, 0x01 };  // PID 0618A001 を 100 ms 間隔で
    rcdiy::filterCommand(allow, sizeof(allow));
    CHECK(rcdiy::filterCount() == 1 && rcdiy::filterPass(0x0618A001, 1000), "許可した PID は通る");
    CHECK(!rcdiy::filterPass(0x0618A001, 1050), "間隔 100 ms の途中は通らない");
    CHECK(rcdiy::filterPass(0x0618A001, 1100), "100 ms たてば通る");
    CHECK(!rcdiy::filterPass(0x0210A006, 1100), "許可していない PID は通らない");
    CHECK(rcdiy::filterAllowed(0x0618A001) && !rcdiy::filterAllowed(0x0618A0F1), "2.14.2: filterAllowed は頼まれている PID だけ true(間隔は進めない)");
    uint8_t allow2[] = { 2, 0x00, 0x00, 0x02, 0x10, 0xA0, 0x06 };  // 間隔 0 = 毎回
    rcdiy::filterCommand(allow2, sizeof(allow2));
    CHECK(rcdiy::filterCount() == 2 && rcdiy::filterPass(0x0210A006, 1100) && rcdiy::filterPass(0x0210A006, 1101), "間隔 0 の PID は毎回通る");
    uint8_t allow3[] = { 2, 0x01, 0xF4, 0x06, 0x18, 0xA0, 0x01 };  // 同じ PID を 500 ms に変える
    rcdiy::filterCommand(allow3, sizeof(allow3));
    CHECK(rcdiy::filterCount() == 2 && !rcdiy::filterPass(0x0618A001, 1500) && rcdiy::filterPass(0x0618A001, 1600), "同じ PID の命令は間隔を変えるだけ");
    uint8_t deny[] = { 0 };
    rcdiy::filterCommand(deny, 1);
    CHECK(rcdiy::filterCount() == 0 && !rcdiy::filterPass(0x0618A001, 2000) && !rcdiy::filterPass(0x0210A006, 2000), "全部拒否で許可が消える");
    uint8_t all[] = { 1, 0x00, 0xC8 };  // 全部許可、200 ms
    rcdiy::filterCommand(all, 3);
    CHECK(rcdiy::filterCount() == -1 && rcdiy::filterPass(0x12345678, 3000) && !rcdiy::filterPass(0x12345678, 3100) && rcdiy::filterPass(0x12345679, 3100) && rcdiy::filterPass(0x12345678, 3200),
          "全部許可は PID ごとに 200 ms 間隔");
    uint8_t all0[] = { 1, 0x00, 0x00 };
    rcdiy::filterCommand(all0, 3);
    CHECK(rcdiy::filterPass(0x1, 1) && rcdiy::filterPass(0x1, 1), "全部許可(間隔 0)は毎回通る");
    uint8_t shortCmd[] = { 2, 0x00 };
    rcdiy::filterCommand(shortCmd, 2);  // 短すぎる命令は無視
    rcdiy::filterCommand(deny, 1);
    for (uint32_t i = 0; i < 60; i++) {  // 表のあふれ(48 個)
      uint8_t a[] = { 2, 0, 0, (uint8_t)(i >> 24), (uint8_t)(i >> 16), (uint8_t)(i >> 8), (uint8_t)i };
      rcdiy::filterCommand(a, 7);
    }
    CHECK(rcdiy::filterCount() == 48 && rcdiy::filterPass(47, 5000) && !rcdiy::filterPass(59, 5000), "許可の表は 48 個まで(それ以上は無視)");
    // 車の CAN は RC_CAN_MIN_MS より詰めない(2.0.0: c6_can_link が 20 ms 間隔で送るようになったので、RaceChrono へ送る量を 1.x と同じに保つ)
    rcdiy::filterReset();
    uint8_t allow20[] = { 2, 0x00, 0x14, 0x06, 0x18, 0xA0, 0x01 };  // RaceChrono が 20 ms 間隔を頼む
    rcdiy::filterCommand(allow20, sizeof(allow20));
    CHECK(rcdiy::filterPass(0x0618A001, 6000, RC_CAN_MIN_MS) && !rcdiy::filterPass(0x0618A001, 6020, RC_CAN_MIN_MS) && !rcdiy::filterPass(0x0618A001, 6049, RC_CAN_MIN_MS)
              && rcdiy::filterPass(0x0618A001, 6050, RC_CAN_MIN_MS),
          "車の CAN: 頼まれた間隔(20 ms)より RC_CAN_MIN_MS(50 ms)が長ければ 50 ms");
    CHECK(rcdiy::filterPass(0x0618A001, 6070), "最短の間隔を渡さないとき(IMU)は頼まれた間隔のまま");
    uint8_t allow200[] = { 2, 0x00, 0xC8, 0x02, 0x10, 0xA0, 0x06 };  // 200 ms
    rcdiy::filterCommand(allow200, sizeof(allow200));
    CHECK(rcdiy::filterPass(0x0210A006, 7000, RC_CAN_MIN_MS) && !rcdiy::filterPass(0x0210A006, 7100, RC_CAN_MIN_MS) && rcdiy::filterPass(0x0210A006, 7200, RC_CAN_MIN_MS),
          "車の CAN: 頼まれた間隔の方が長ければそちら(200 ms)");
    rcdiy::filterCommand(all0, 3);
    CHECK(rcdiy::filterPass(0x77, 8000, RC_CAN_MIN_MS) && !rcdiy::filterPass(0x77, 8030, RC_CAN_MIN_MS) && rcdiy::filterPass(0x77, 8050, RC_CAN_MIN_MS) && rcdiy::filterPass(0x78, 8050, RC_CAN_MIN_MS),
          "全部許可(間隔 0)でも、車の CAN は PID ごとに RC_CAN_MIN_MS");
    rcdiy::filterReset();
  }

  // ---------------- 19. IMU の向きの補正(停車中の重力で「上」、発進の加速で「前」、走行中の長期平均、付け直しの検出、保存と復元)
  {
    imu::begin();
    // センサーは前に 30° 傾けて付いているとする: 車の上 = センサーの (0, −sin30, cos30)、車の前 = (0, cos30, sin30)、右 = (1, 0, 0)
    const float s30 = 0.5f, c30 = 0.8660254f;
    auto sensor = [&](float lon, float lat, float vert, float *x, float *y, float *z) {  // 車の座標 [g](vert は重力込み)→ センサー
      *x = lat;
      *y = lon * c30 - vert * s30;
      *z = lon * s30 + vert * c30;
    };
    float x, y, z, lon, lat, vert;
    uint32_t t = 100000;
    auto still = [&](float tiltLon, int samples) {  // 停車(坂なら重力の前後成分 tiltLon)
      for (int i = 0; i < samples; i++) {
        sensor(tiltLon, 0, sqrtf(1.0f - tiltLon * tiltLon), &x, &y, &z);
        imu::sample(x, y, z, true, 0.0f, t);
        t += 20;
      }
    };
    auto launch = [&](float aLon, float aLat, float kmhEnd) {  // 発進: 3 km/h から kmhEnd まで、0.2 秒ごとに車速が増える
      float kmh = 3.0f;
      for (int i = 0; kmh <= kmhEnd; i++) {
        sensor(aLon, aLat, 1.0f, &x, &y, &z);
        imu::sample(x, y, z, true, kmh, t);
        t += 20;
        if (i % 10 == 9) kmh += 2.1f;  // 0.2 秒で 2.1 km/h ≈ 0.3 g
      }
    };
    still(0, 175);  // 3.5 秒
    CHECK(imu::levelOk() && !imu::forwardOk() && imu::calVersion() == 1, "停車 3 秒で「上」を覚える(「前」はまだ)");
    sensor(0, 0, 1.0f, &x, &y, &z);
    imu::sample(x, y, z, true, 0.0f, t);
    imu::car(&lon, &lat, &vert);
    CHECK(fabsf(vert) < 0.01f, "「上」を覚えると、停車中の上下の加速度は 0(重力を引いた値)");
    launch(0.3f, 0, 10.0f);  // 10 km/h までの発進(後退の想定)では覚えない
    CHECK(!imu::forwardOk(), "IMU_FWD_DONE_KMH に届かない発進では「前」を覚えない");
    still(0, 20);
    launch(0.3f, 0, 25.0f);
    CHECK(imu::forwardOk() && imu::calVersion() == 2, "15 km/h を超える発進の加速で「前」を覚える");
    sensor(0.3f, 0, 1.0f, &x, &y, &z);
    imu::sample(x, y, z, true, 30.0f, t);
    imu::car(&lon, &lat, &vert);
    CHECK(fabsf(lon - 0.3f) < 0.02f && fabsf(lat) < 0.02f && fabsf(vert) < 0.02f, "加速 0.3 g を車の座標で前後 +0.30 に直す");
    sensor(0, 0.4f, 1.0f, &x, &y, &z);
    imu::sample(x, y, z, true, 30.0f, t += 20);
    imu::car(&lon, &lat, &vert);
    CHECK(fabsf(lon) < 0.02f && fabsf(lat - 0.4f * (float)IMU_LAT_SIGN) < 0.02f, "右 0.4 g を横 +0.40(IMU_LAT_SIGN)に直す");
    float gl, gt, gv;
    imu::toCar(0, -s30 * 10.0f, c30 * 10.0f, &gl, &gt, &gv);  // 車の上の軸まわりに 10 deg/s
    CHECK(fabsf(gv - 10.0f) < 0.05f && fabsf(gl) < 0.05f, "ジャイロ: 上の軸まわりの回転をそのまま取り出す");
    // 「前」の 2 回目以降は少しずつ寄せる。左に 0.1 g 曲がりながらの発進(約 18° ずれ)で、向きは 18° ほどは動かない
    still(0, 20);
    launch(0.3f, -0.1f, 25.0f);
    float cal[9], cal2[9];
    imu::exportCal(cal);
    {
      float fdot = cal[4] * c30 + cal[5] * s30;  // 覚えた「前」と本当の前の内積
      CHECK(imu::forwardOk() && fdot > 0.995f, "曲がりながらの発進では「前」が 5° 以上は動かない(少しずつ寄せる)");
    }
    // 保存と復元
    imu::exportCal(cal);
    CHECK(cal[6] == 1.0f && cal[7] == 1.0f && fabsf(cal[1] + s30) < 0.01f && fabsf(cal[2] - c30) < 0.01f, "保存する値: 上 (0, −0.5, 0.87)、済の印");
    imu::reset();
    CHECK(!imu::levelOk() && !imu::forwardOk(), "試験用の reset で忘れる");
    imu::importCal(cal);
    imu::exportCal(cal2);
    CHECK(imu::levelOk() && imu::forwardOk() && memcmp(cal, cal2, sizeof(float) * 9) == 0, "復元すると同じ向きに戻る(重力の大きさも)");
    float broken[9] = { 0, 0, 0, 0, 0, 0, 1, 1, 0 };
    imu::reset();
    imu::importCal(broken);
    CHECK(!imu::levelOk() && !imu::forwardOk(), "壊れた保存値(長さ 0 のベクトル)は使わない");
    imu::importCal(cal);
    // 坂での停車(上が 15° ずれる)では「上」を変えない
    uint32_t ver = imu::calVersion();
    still(-0.2588f, 175 * 3);  // 上り坂で 10 秒
    imu::exportCal(cal2);
    CHECK(imu::calVersion() == ver && imu::forwardOk() && fabsf(cal2[2] - c30) < 0.005f, "坂での停車では「上」を変えない");
    // 走行中の長期平均: 坂で覚えてしまった「上」(15° ずれ)が、平らな道を 20 分走ると直る
    imu::reset();
    still(-0.2588f, 175);
    imu::exportCal(cal2);
    CHECK(imu::levelOk() && fabsf(cal2[2] - c30) > 0.03f, "坂で最初に覚えた「上」はずれている");
    for (int i = 0; i < 50 * 60 * 30; i++) {  // 30 分(時定数 10 分の 3 倍)、30 km/h、加速なし
      sensor(0, 0, 1.0f, &x, &y, &z);
      imu::sample(x, y, z, true, 30.0f, t);
      t += 20;
    }
    imu::exportCal(cal2);
    CHECK(fabsf(cal2[1] + s30) < 0.02f && fabsf(cal2[2] - c30) < 0.02f && imu::calVersion() > 1, "30 分の走行で「上」が正しい向きに寄る(版も進む)");
    // 付け直し(60° ずれ)が 5 回続いたら覚え直し、「前」を忘れる
    imu::reset();
    imu::importCal(cal);
    ver = imu::calVersion();
    for (int k = 0; k < IMU_RELEARN_COUNT - 1; k++) {
      for (int i = 0; i < 175; i++) {
        imu::sample(0.866f, 0, 0.5f, true, 0.0f, t);  // 60° 違う向きで停車
        t += 20;
      }
      imu::sample(0, 0, 1.0f, true, 10.0f, t += 20);  // 間に少し動く(停車の区間を区切る)
      imu::sample(0, 0, 1.0f, true, 10.0f, t += 20);
    }
    CHECK(imu::calVersion() == ver && imu::forwardOk(), "大きく違う「上」が 4 回では変えない");
    for (int i = 0; i < 175; i++) {
      imu::sample(0.866f, 0, 0.5f, true, 0.0f, t);
      t += 20;
    }
    imu::exportCal(cal2);
    CHECK(imu::calVersion() == ver + 1 && imu::levelOk() && !imu::forwardOk() && fabsf(cal2[0] - 0.866f) < 0.02f, "5 回続いたら「上」を覚え直し、「前」は忘れる");
    // 車速の信号が無いとき(机の上)。覚える前の向きは「画面を立てて(+X が上)、背面(+Z)が前」
    imu::reset();
    imu::sample(1.0f, 0, 0, false, 0.0f, t += 20);
    imu::car(&lon, &lat, &vert);
    CHECK(fabsf(lon) < 0.001f && fabsf(lat) < 0.001f && fabsf(vert) < 0.001f, "覚える前: 画面を立てた向き(+X が上)で 0/0/0");
    imu::sample(0, 0, 1.0f, false, 0.0f, t += 20);  // 伏せる(背面が上)
    imu::car(&lon, &lat, &vert);
    CHECK(fabsf(lon - 1.0f) < 0.001f && fabsf(lat) < 0.001f && fabsf(vert + 1.0f) < 0.001f, "覚える前: 伏せると前後 +1.0、上下 −1.0(車が真上を向いた形)");
    imu::sample(0, 0, -1.0f, false, 0.0f, t += 20);  // 仰向け
    imu::car(&lon, &lat, &vert);
    CHECK(fabsf(lon + 1.0f) < 0.001f && fabsf(lat) < 0.001f && fabsf(vert + 1.0f) < 0.001f, "覚える前: 仰向けで前後 −1.0、上下 −1.0");
    imu::sample(0, -1.0f, 0, false, 0.0f, t += 20);
    imu::car(&lon, &lat, &vert);
    CHECK(fabsf(lat + 1.0f * (float)IMU_LAT_SIGN) < 0.001f && fabsf(lon) < 0.001f && fabsf(vert + 1.0f) < 0.001f, "覚える前: −Y が上(右端を下げた形)で横 −1.0(IMU_LAT_SIGN)、上下 −1.0");
    // 値が揺れていれば覚えない(走行中かもしれない)
    for (int i = 0; i < 300; i++) {
      float j = (i & 1) ? 0.04f : -0.04f;  // 直前との差 0.08 g の揺れ
      imu::sample(1.0f, j, 0, false, 0.0f, t);
      t += 20;
    }
    CHECK(!imu::levelOk() && !imu::stillNow(), "車速が無く値が揺れている間は「上」を覚えない");
    // 立てて 20° 後ろへ傾けて置く(倍率が 1.1 のセンサー)。3 秒動かなければ、その向きが「上」、大きさ 1.1 が重力
    const float c20 = 0.9396926f, s20 = 0.3420201f;
    for (int i = 0; i < 175; i++) {
      imu::sample(1.1f * c20, 0, 1.1f * s20, false, 0.0f, t);
      t += 20;
    }
    imu::exportCal(cal2);
    imu::car(&lon, &lat, &vert);
    CHECK(imu::levelOk() && !imu::forwardOk() && imu::stillNow() && fabsf(cal2[0] - c20) < 0.01f && fabsf(cal2[2] - s20) < 0.01f, "車速が無くても、立てた向きで 3 秒動かなければ「上」を覚える(「前」は覚えない)");
    CHECK(fabsf(imu::gravity() - 1.1f) < 0.005f && fabsf(vert) < 0.005f && fabsf(lon) < 0.005f && fabsf(cal2[8] - 1.1f) < 0.005f, "重力の大きさ 1.1 g を覚え(保存値にも入る)、停車中の値は 0/0/0 になる(倍率のずれを直す)");
    for (int i = 0; i < 175; i++) {  // さらに 3.5 秒: 静止は続いている
      imu::sample(1.1f * c20, 0, 1.1f * s20, false, 0.0f, t);
      t += 20;
    }
    CHECK(imu::stillNow(), "静止の判定は 3 秒の区間をまたいで続く");
    imu::sample(1.1f * c20, 0.11f, 1.1f * s20, false, 0.0f, t += 20);  // 右 0.1 g(センサーの値では 0.11)
    imu::car(&lon, &lat, &vert);
    CHECK(fabsf(lat - 0.1f * (float)IMU_LAT_SIGN) < 0.005f && fabsf(vert) < 0.005f && fabsf(lon) < 0.005f, "横 0.1 g も倍率を直して出る");
    // 立て直す(20° 戻す): 車速が無いので置いた向きに合わせ直す(車速があるときは 25° 未満のずれでは動かさない)
    for (int i = 0; i < 180; i++) {
      imu::sample(1.1f, 0, 0, false, 0.0f, t);
      t += 20;
    }
    imu::exportCal(cal2);
    imu::car(&lon, &lat, &vert);
    CHECK(fabsf(cal2[0] - 1.0f) < 0.01f && fabsf(vert) < 0.005f && fabsf(lon) < 0.005f, "車速が無いときは置き直した向きに「上」を合わせ直す");
    // 伏せたまま(初期の上から 90°)では、車速が無くても「上」を変えない(試験で伏せたり仰向けにしたりしても値が読める)
    uint32_t v0 = imu::calVersion();
    for (int i = 0; i < 300; i++) {
      imu::sample(0, 0, 1.1f, false, 0.0f, t);
      t += 20;
    }
    imu::exportCal(cal2);
    imu::car(&lon, &lat, &vert);
    CHECK(imu::calVersion() == v0 && fabsf(cal2[0] - 1.0f) < 0.01f && !imu::stillNow() && fabsf(lon - 1.0f) < 0.01f && fabsf(vert + 1.0f) < 0.01f, "伏せて置いても「上」は変えない(前後 +1.0、上下 −1.0 のまま)");
    for (int i = 0; i < 60; i++) {  // 手で動かすと静止でなくなる
      imu::sample(1.1f + 0.3f * ((i & 1) ? 1 : -1), 0, 0, false, 0.0f, t);
      t += 20;
    }
    CHECK(!imu::stillNow() && imu::levelOk(), "動かすと静止ではなくなるが、覚えた「上」は残る");
    imu::reset();
  }
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
