katsuhaa/abarth595-round-gauge/pc_test/render_main.cpp

// render_main.cpp - PC 上で表示器の各画面を描いて BMP に書き出す(キャンバスの絵と見比べる用)
// 使い方: render <出力フォルダ> [prop]   prop を付けると、数字を幅のそろっていない形(キャンバスと同じ)で描く
#include "../meter_display/app.h"
#include "../meter_display/gfx.h"
#include "../meter_display/ui.h"
#include <stdio.h>
#include <stdlib.h>
#include <string.h>
#include <string>
#include "pc_util.h"

static uint16_t fb[gfx::W * gfx::H];
static float scratch[gfx::W * (gfx::H + 2)];
static Settings set;  // main で settingsDefaults(2.10.0)
static LinkStats ls;
static PerfStats ps;
static SysInfo si;
static std::string outdir;

static void saveShot(const char *name) {
  saveBmp(outdir + "/" + name + ".bmp", fb, gfx::W, gfx::H);
}

static Signals sig(int rpm, char gear, float water, float fuel, bool wOk = true, bool fOk = true, float boost = 0.0f, bool bOk = true) {
  Signals s;
  memset(&s, 0, sizeof(s));
  s.linkUp = true;
  s.rpmOk = true; s.rpm = rpm;
  s.gearOk = gear != 0; s.gear = gear;
  s.waterOk = wOk; s.waterC = water;
  s.fuelOk = fOk; s.fuelPct = fuel;
  s.boostOk = bOk; s.boostBar = boost;
  s.speedOk = true; s.speedKmh = 0;
  s.throttleOk = true; s.throttlePct = 0;
  return s;
}

static uint32_t now = 100000;  // (now / 50) が偶数 = 点滅の点灯側
static bool g_keepPeak = false;  // 次の絵だけ、前の絵のピークホールドを残す(ふだんは絵ごとに消す)
static void shot(const char *name, const Signals &s, ui::Screen sc, int a = 0, int b = 0) {
  if (!g_keepPeak) ui::testPeakReset();
  g_keepPeak = false;
  ui::testShow(sc, a, b);
  ui::testTouch(now);  // 時刻が進んでいても自動で走行画面に戻らないように(10/22: Data の絵が走行画面になっていた)
  ui::update(s, ls, ps, si, now);
  ui::update(s, ls, ps, si, now + 100);  // 走行以外の画面の 2 回目(値の行など)。点滅は同じ側
  saveShot(name);
  printf("%-22s dirty=%d px=%u missing=%u\n", name, gfx::dirtyCount(), (unsigned)gfx::dirtyPixels(), (unsigned)gfx::missingGlyphs());
  gfx::dirtyClear();
}

extern size_t g_hostCanPreN;  // plat_pc.cpp: 「前後で比べる」の前の記録(NVS の代わり)
static void canFrame(uint32_t id, const uint8_t d[8], uint8_t dlc, uint32_t t, uint8_t bus = 0) {
  cantab::onFrame(bus, 1, id, dlc, d, t);
}

int main(int argc, char **argv) {
  outdir = argc > 1 ? argv[1] : ".";
  bool tabular = !(argc > 2 && !strcmp(argv[2], "prop"));
  settingsDefaults(&set);
  gfx::begin(fb, scratch);
  mlink::begin();
  cantab::begin();
  odo::begin();  // 2.15.0
  ui::begin(&set);
  gfx::setTabularDigits(tabular);
  memset(&ls, 0, sizeof(ls));
  memset(&ps, 0, sizeof(ps));
  memset(&si, 0, sizeof(si));

  // ---- 走行画面の 5 状態(仕様書 5.9)
  shot("Drive", sig(4200, '3', 92, 62), ui::SC_DRIVE);
  shot("DriveIdle", sig(850, 'N', 88, 12), ui::SC_DRIVE);
  shot("DriveHot", sig(5600, '4', 112, 45), ui::SC_DRIVE);
  shot("DriveRed", sig(6300, '3', 97, 41), ui::SC_DRIVE);
  shot("DriveNoData", sig(3400, '2', 0, 0, false, false), ui::SC_DRIVE);

  // ---- アナログ計(仕様書に無いページ)。絵ごとに 10 秒進める(ピークホールドは shot が絵ごとに消す)
  shot("Boost", sig(4200, '3', 92, 62, true, true, 1.25f), ui::SC_BOOST);
  now += 10000;
  shot("BoostIdle", sig(850, 'N', 88, 62, true, true, -0.52f), ui::SC_BOOST);        // 負圧: 帯は 0(目印だけ)
  now += 10000;
  shot("BoostMax", sig(5000, '4', 92, 62, true, true, 2.35f), ui::SC_BOOST);         // 目盛の上限で止まる
  now += 10000;
  shot("BoostShift", sig(6300, '3', 97, 41, true, true, 1.6f), ui::SC_BOOST);        // シフト点以上: 回転計の目盛・数字・針が全部赤(2.4.0)
  now += 10000;
  shot("BoostBelowShift", sig(5600, '3', 97, 41, true, true, 1.5f), ui::SC_BOOST);   // シフト点の手前: ふだんの色
  now += 10000;
  shot("BoostNoData", sig(3400, '2', 90, 50, true, true, 0, false), ui::SC_BOOST);   // ブーストの信号なし: ブースト計の帯と目印なし
  now += 10000;
  shot("BoostHalf", sig(3000, '2', 90, 50, true, true, 0.74f), ui::SC_BOOST);
  now += 10000;
  shot("BoostHot", sig(5600, '4', 112, 12, true, true, 0.9f), ui::SC_BOOST);         // 水温の異常と燃料の異常(右下の弧とアイコンが赤)
  {
    Signals sp = sig(5600, '4', 112, 12, true, true, 0.9f);
    sp.sportOk = sp.sport = true;
    shot("BoostSportHot", sp, ui::SC_BOOST);  // 2.11.0: スポーツモードの「SPORT」と、水温・燃料の札
    sp = sig(4200, '3', 92, 62, true, true, 1.25f);
    sp.sportOk = sp.sport = true;
    shot("BoostSport", sp, ui::SC_BOOST);  // 2.11.0: スポーツモードの「SPORT」
  }
  now += 10000;
  shot("BoostPeakUp", sig(6400, '3', 92, 62, true, true, 1.4f), ui::SC_BOOST);       // 6400 まで上げてから
  now += 200;
  g_keepPeak = true;
  shot("BoostPeak", sig(4200, '3', 92, 62, true, true, 0.6f), ui::SC_BOOST);         // 4200 に下げる: ピークホールドの印が 6400 に残る
  now += 10000;

  // ---- サーキット(10/23): ピークホールドの三角形、3000rpm 以下の経過時間
  {
    shot("DrivePeakUp", sig(6000, '3', 92, 62), ui::SC_DRIVE);
    now += 200;
    g_keepPeak = true;
    shot("DrivePeak", sig(4200, '3', 92, 62), ui::SC_DRIVE);   // ピーク 6000 が残る
    now += 10000;
    g_keepPeak = true;
    shot("DriveLowPeak", sig(2600, '2', 92, 62), ui::SC_DRIVE);  // 10 秒たつとピークは今の回転数まで下がり切って、三角形は消える
    // N が 1 分続いた: ギアの所に「▼ 3000rpm」と経過時間(2:35)
    Signals n = sig(850, 'N', 96, 55);
    uint32_t t0 = now;
    ui::testShow(ui::SC_DRIVE);
    for (uint32_t t = t0; t <= t0 + 155000; t += 1000) {
      ui::testTouch(t);
      ui::update(n, ls, ps, si, t);
      gfx::dirtyClear();
    }
    now = t0 + 155000;
    shot("DriveIdleTime", n, ui::SC_DRIVE);
    // 2.10.0: 高負荷時間 31:10 と、その下に ▼ 3000rpm 2:35(キャンバス C3)。2.12.0: 「過負荷」(赤)
    si.timeOk = true; si.utc = 1793065338u;  // 2026-10-27 10:42:18(日本時間)
    load::testSet(1870000, true);
    shot("DriveLoadIdle", n, ui::SC_DRIVE);
    // 2.12.0: クールダウン(黄に達したあと 3000 未満が 1:30 → タイトル「クールダウン」、リセットまでの残り 3:30 を水色。▼ は出さない)
    load::update(n, set, now - 90000);
    load::update(n, set, now);
    shot("DriveLoadCool", n, ui::SC_DRIVE);
    {  // 2.12.0: メンテナンスの印(過負荷時間と ▼ の下)
      const uint32_t a0 = trip::aboveMs(), b0 = trip::belowMs();
      trip::setTimes(18000000u, 0);
      shot("DriveMaintLoad", n, ui::SC_DRIVE);
      trip::setTimes(a0, b0);
    }
    // 高負荷時間の機能が切(黄・赤とも 0): 2.9.0 と同じ ▼ 3000rpm と大きい経過時間
    load::testReset();
    set.loadYellowMin = 0; set.loadRedMin = 0;
    shot("DriveLoadOffIdle", n, ui::SC_DRIVE);
    set.loadRpm = 4500;  // 2.12.0: ▼ の数字は設定の過負荷 回転数
    shot("DriveLoadRpm4500", n, ui::SC_DRIVE);
    settingsDefaults(&set);
    si.timeOk = false;
    now += 20000;
  }

  // ---- サーキット(2.10.0): 時計と真ん中(キャンバス C1〜C4・N1〜N3)
  {
    si.timeOk = true; si.utc = 1793065338u;  // 10:42:18
    ls.locked = true; ls.infoValid = true; ls.info.proto_ver = METER_LINK_PROTO_VER; ls.info.can_fps[0] = 1015; ls.info.can_fps[1] = 143;
    si.rc.gpsOn = true; si.rc.gpsOk = true; si.rc.fixType = 3; si.rc.numSV = 12; si.rc.pvtPerSec = 25;
    si.rc.enabled = true; si.rc.imuOk = true; si.rc.bleOk = true; si.rc.connected = true;
    shot("DriveStatus", sig(850, 'N', 92, 62), ui::SC_DRIVE);  // N1: すべて正常
    si.timeOk = false; si.rc.fixType = 0; si.rc.numSV = 3; si.rc.connected = false;
    shot("DriveStatusWait", sig(850, 'N', 92, 62), ui::SC_DRIVE);  // N2: 測位待ち・未接続(時刻なしで針なし)
    si.rc.gpsOk = false; si.rc.enabled = false; si.rc.imuOk = false; si.rc.bleOk = false;
    shot("DriveStatusNg", sig(850, 'N', 92, 62), ui::SC_DRIVE);  // N3: 送信が切・GPS が届かない
    ls.locked = false; ls.infoValid = false;
    shot("DriveStatusCanNg", sig(850, 'N', 92, 62), ui::SC_DRIVE);  // CAN も受けていない(起動から INFO_LINK_GRACE_MS 後)
    ls.locked = true; ls.infoValid = true;
    si.rc.gpsOk = true; si.rc.fixType = 3; si.rc.numSV = 12; si.rc.enabled = true; si.rc.imuOk = true; si.rc.bleOk = true; si.rc.connected = true;
    load::testSet(200000, true);  // 時刻なし・黄になったあと減った過負荷時間 3:20(白。2.12.1: 黄になる前の白は出さない)
    shot("DriveLoadWait", sig(1800, '2', 92, 62), ui::SC_DRIVE);
    si.timeOk = true;
    load::testSet(920000, false);  // C2: 5600 rpm・高負荷時間 15:20(黄)
    shot("DriveLoadYellow", sig(5600, '4', 92, 62), ui::SC_DRIVE);
    load::testSet(1860000, false);  // 31:00(赤。クールダウン前)。4400 rpm(2.12.0: 背景は黄の手前まで黒)
    shot("DriveLoadRed", sig(4400, '3', 96, 40), ui::SC_DRIVE);
    load::testSet(3725000, true);  // 1 時間以上(時:分:秒)
    shot("DriveLoadHour", sig(2500, '3', 96, 40), ui::SC_DRIVE);
    load::testReset();
    // C1: 4200 rpm・ピーク 6100 を真ん中に(2.12.0: 背景は黒)。ピークの印は回転数がはっきり上がったときに出す(3000 → 6100)
    auto peakUp = [&](int to) {
      ui::testPeakReset();
      ui::testShow(ui::SC_DRIVE);
      ui::testTouch(now);
      ui::update(sig(3000, '3', 92, 62), ls, ps, si, now);
      ui::update(sig(to, '3', 92, 62), ls, ps, si, now + 100);
      gfx::dirtyClear();
      now += 300;
    };
    peakUp(6100);
    g_keepPeak = true;
    shot("DrivePeak2", sig(4200, '3', 92, 62), ui::SC_DRIVE);
    now += 10000;
    peakUp(6100);  // 2.12.1: 印が下がり始めても、真ん中の数字は黄のまま(2.11.0〜2.12.0 は白)
    now += TACH_PEAK_HOLD_MS + 500;
    g_keepPeak = true;
    shot("DrivePeakFall", sig(4200, '3', 92, 62), ui::SC_DRIVE);
    now += 10000;
    // 背景が黄色のときの針とピーク(紺)
    peakUp(6040);
    g_keepPeak = true;
    shot("DrivePeakYellow", sig(5500, '3', 92, 62), ui::SC_DRIVE);
    now += 10000;
    // 2.12.0: 回転数の輪 = 片側(右斜め下から真上へ。シフト点で真上)。ピークの三角は右側だけ
    set.ringOne = 1;
    shot("DriveOne1800", sig(1800, '2', 92, 62), ui::SC_DRIVE);
    shot("DriveOne4200", sig(4200, '3', 92, 62), ui::SC_DRIVE);
    shot("DriveOne5600", sig(5600, '4', 92, 62), ui::SC_DRIVE);
    shot("DriveOneShift", sig(6000, '4', 92, 62), ui::SC_DRIVE);
    peakUp(5600);
    g_keepPeak = true;
    shot("DriveOnePeak", sig(4200, '3', 92, 62), ui::SC_DRIVE);
    set.ringOne = 0;
    now += 10000;
    // 針が 1 秒ずつ進む(少しずつ描いたもの。最初から描いたものと比べる試験は run_tests.sh)
    {
      Signals s = sig(850, 'N', 92, 62);
      ui::testShow(ui::SC_DRIVE);
      for (int k = 0; k < 75; k++) {
        si.utc = 1793065338u + (uint32_t)k;
        ui::testTouch(now);
        ui::update(s, ls, ps, si, now);
        gfx::dirtyClear();
        now += 1000;
      }
      shot("DriveClockStep", s, ui::SC_DRIVE);  // 2.11.0: 状態が変わらないまま 10 秒を過ぎたので、真ん中はデジタル時計
    }
    shot("DriveClockYellow", sig(5500, '3', 92, 62), ui::SC_DRIVE);  // 2.11.0: シフト点の手前(背景が黄)の針の色
    shot("DriveClockRed", sig(6300, '4', 92, 62), ui::SC_DRIVE);     // 2.11.0: シフト点を超えた(背景が赤)の針の色
    si.timeOk = false;
    memset(&si.rc, 0, sizeof(si.rc));
    memset(&ls, 0, sizeof(ls));
  }

  // ---- キャンバスの絵(C1〜C4・N1〜N3・T1・T2)と同じ値・同じ時刻の絵(見比べ用。2.10.0)
  {
    ls.locked = true; ls.infoValid = true; ls.info.proto_ver = METER_LINK_PROTO_VER; ls.info.can_fps[0] = 1015;
    si.rc.gpsOn = true; si.rc.gpsOk = true; si.rc.fixType = 3; si.rc.numSV = 12; si.rc.enabled = true; si.rc.imuOk = true; si.rc.bleOk = true; si.rc.connected = true;
    const uint32_t base = 1793065338u;  // 10:42:18
    auto rise = [&](int to, int water, float fuel) {
      ui::testPeakReset();
      ui::testShow(ui::SC_DRIVE);
      ui::testTouch(now);
      ui::update(sig(3000, '3', (float)water, fuel), ls, ps, si, now);
      ui::update(sig(to, '3', (float)water, fuel), ls, ps, si, now + 100);
      gfx::dirtyClear();
      now += 300;
    };
    si.timeOk = true; si.utc = base;
    rise(6100, 92, 62);
    g_keepPeak = true;
    shot("CanvasC1", sig(4200, '3', 92, 62), ui::SC_DRIVE);
    now += 10000;
    si.utc = base + 257;  // 10:46:35
    load::testSet(920000, false);
    shot("CanvasC2", sig(5600, '4', 95, 55), ui::SC_DRIVE);
    {  // C3: N で 2:35 アイドリング
      Signals n = sig(850, 'N', 96, 55);
      ui::testShow(ui::SC_DRIVE);
      const uint32_t t0 = now;
      load::testReset();
      for (uint32_t t = t0; t <= t0 + 155000; t += 1000) {
        ui::testTouch(t);
        ui::update(n, ls, ps, si, t);
        gfx::dirtyClear();
      }
      now = t0 + 155000;
      si.utc = base + 949;  // 10:58:07
      load::testSet(1870000, true);
      shot("CanvasC3", n, ui::SC_DRIVE);
      now += 20000;
    }
    si.timeOk = false;
    load::testSet(740000, false);  // C4: 電源を入れた直後(時刻なし)・過負荷時間 12:20(黄。2.12.1: 黄になる前の白は出さない)
    shot("CanvasC4", sig(850, '2', 96, 55), ui::SC_DRIVE);
    load::testReset();
    si.timeOk = true; si.utc = base + 2542;  // 11:24:40
    shot("CanvasN1", sig(850, 'N', 88, 55), ui::SC_DRIVE);
    si.timeOk = false; si.rc.fixType = 0; si.rc.numSV = 3; si.rc.connected = false;
    shot("CanvasN2", sig(850, 'N', 45, 55), ui::SC_DRIVE);
    si.rc.gpsOk = false; si.rc.enabled = false; si.rc.imuOk = false; si.rc.bleOk = false;
    shot("CanvasN3", sig(850, 'N', 88, 55), ui::SC_DRIVE);
    shot("CanvasT1", sig(4200, '3', 92, 62, true, true, 1.25f), ui::SC_BOOST);
    now += 10000;
    shot("CanvasT2", sig(5600, '4', 112, 12, true, true, 0.9f), ui::SC_BOOST);
    now += 10000;
    memset(&si.rc, 0, sizeof(si.rc));
    memset(&ls, 0, sizeof(ls));
  }

  // ---- データ画面(10/23): GPS・IMU・CAN の値と、3000rpm 超・以下の累計時間
  {
    trip::setTimes(5025000, 45296000);  // 1:23:45 と 12:34:56
    ls.infoValid = true; ls.info.proto_ver = METER_LINK_PROTO_VER; ls.info.can_fps[0] = 1015; ls.info.can_fps[1] = 143;
    si.rc.enabled = true; si.rc.gpsOn = true; si.rc.gpsOk = true; si.rc.fixType = 3; si.rc.numSV = 11; si.rc.pvtPerSec = 25; si.rc.imuOk = true;
    si.rc.gLon = 0.32f; si.rc.gLat = -0.85f;
    Signals s = sig(4200, '3', 92, 62);
    shot("Data", s, ui::SC_DATA);  // 2.12.0: 下の行はメンテナンスまでの残り(5 時間 − 1:23:45 = 3:36:15)
    set.maintHours = 0;
    shot("DataMaintOff", s, ui::SC_DATA);  // メンテナンスが切: 今までどおり ▼
    set.maintHours = 99;
    shot("DataMaint99", s, ui::SC_DATA);   // 残り 97:36:15(いちばん長い)
    set.maintHours = SET_MAINT_DEFAULT;
    trip::setTimes(18000000u, 45296000);
    shot("DataMaintDue", s, ui::SC_DATA);  // 5 時間に達した: 赤の「メンテナンス」
    trip::setTimes(5025000, 45296000);
    si.rc.fixType = 0; si.rc.numSV = 3; si.rc.pvtPerSec = 0; si.rc.imuOk = false; ls.info.can_fps[1] = 0;
    shot("DataNg", s, ui::SC_DATA);
    Signals a = sig(5600, '4', 112, 12);
    shot("DataAlarm", a, ui::SC_DATA);
    // 2.5.0: 外周の回転数の輪。振り切り(全周が赤)と、行の字がいちばん長くなる値(輪に掛からないこと)
    si.rc.fixType = 3; si.rc.numSV = 99; si.rc.pvtPerSec = 25; si.rc.imuOk = true; si.rc.gLon = -1.99f; si.rc.gLat = -1.99f;
    ls.info.can_fps[0] = 9999; ls.info.can_fps[1] = 9999;
    trip::setTimes(359999000u, 359999000u);  // 99:59:59
    shot("DataRingMax", sig(8000, '3', 118, 100), ui::SC_DATA);
    shot("DataRingIdle", sig(850, 'N', -18, 100), ui::SC_DATA);
    trip::setTimes(5025000, 45296000);
    memset(&si.rc, 0, sizeof(si.rc));
    memset(&ls, 0, sizeof(ls));
  }

  // ---- CAN確認: 基準を取ったあとに 3 か所が変わった状態
  {
    uint8_t d0618[8] = { 0x00, 0x00, 0x0D, 0x6C, 0x00, 0x00, 0x00, 0x00 };
    uint8_t d0810[4] = { 0x01, 0xFE, 0x70, 0x00 };
    uint8_t d0628[8] = { 0xFF, 0x24, 0x00, 0x80, 0x0B, 0x00, 0x00, 0x20 };
    uint8_t dstat[8] = { 0x20, 0x0D, 0x40, 0x7F, 0x00, 0x49, 0x20, 0x02 };
    canFrame(0x0618A001, d0618, 8, 100);
    canFrame(0x0810A000, d0810, 4, 100);
    d0628[5] = 0x00;
    canFrame(0x0628A001, d0628, 8, 100);
    canFrame(0x0A18A000, dstat, 8, 100);
    canFrame(0x04214001, dstat, 8, 100, 1);
    Signals s0 = sig(4200, '3', 92, 62);
    shot("CanTop0", s0, ui::SC_CAN);  // 記録 0 回
    cantab::record();  // 1 回目: 全部が候補
    // 履歴(折れ線)用に b7 を動かす
    static const uint8_t wave[] = { 0, 0, 0, 0, 40, 76, 76, 76, 76, 12, 0, 0, 0, 0, 50, 66, 66, 36, 25, 25, 25, 25, 25 };
    uint32_t t = 200;
    for (unsigned i = 0; i < sizeof(wave); i++) {
      for (int k = 0; k < 8; k++) {
        d0618[7] = wave[i];
        canFrame(0x0618A001, d0618, 8, t);
        cantab::tick(t);
        t += 100;
      }
    }
    d0628[5] = 0x20; canFrame(0x0628A001, d0628, 8, 1000);
    d0810[2] = 0x10; canFrame(0x0810A000, d0810, 4, 2000);
    d0618[7] = 0x4C; canFrame(0x0618A001, d0618, 8, t + 3000);
    cantab::tick(t + 3000);
    cantab::record();  // 2 回目: 1〜8 回だけ変わった 0628(b5)・0810(b2)が残る(0618 の b7 は 184 回変わったので外れる)
    Signals s = sig(4200, '3', 92, 62);
    shot("CanTop", s, ui::SC_CAN);
    shot("CanId", s, ui::SC_CAN_ID, 0);
    shot("CanId2", s, ui::SC_CAN_ID, 1);
    shot("CanDetail", s, ui::SC_CAN_DETAIL, 0, 7);
    shot("CanDetailB", s, ui::SC_CAN_DETAIL, 2, 5);
    shot("CanRedo", s, ui::SC_CAN_REDO);
  }

  // ---- 設定(2.4.0: 8 項目。受信の状態は CAN・GPS・IMU・RaceChrono のグループ、本体の状態は FPS・起動。
  //      2.9.0: 2 番目にイルミネーションの明るさ(絵の名前は 2.4.0 の番号のまま、足した項目は SetIllum))
  {
    Signals s = sig(4200, '3', 92, 62);
    trip::setTimes(5025000, 45296000);
    // 2.12.0: 設定の段 = カテゴリ(SetCat*)、カテゴリの中 = 項目(ITEMS の並び。受信の状態・本体の状態・走行記録はカテゴリの段から中へ)。
    // 2.15.3: 走行記録が 1 つ目(7 つ)
    const char *cats[] = { "SetCat0Odo", "SetCat1Screen", "SetCat2Shift", "SetCat3Warn", "SetCat4Info", "SetCat5Sys", "SetCat6Other" };
    for (int c = 0; c < 7; c++) shot(cats[c], s, ui::SC_SET_LIST, c);
    const char *items[] = { "Set1Bright", "SetIllum", "Set7Auto", "Set4Shift", "SetRing", "Set5Warn", "SetFuelWarn", "SetLoadRpm", "SetLoadY", "SetLoadR",
                            "SetLoadRs", "SetMaint", "Set6Time", nullptr, nullptr, "Set8Demo", "SetDefaults" };  // 2.14.0: SetFuelWarn(燃料の警告)
    for (int i = 0; i < 17; i++)
      if (items[i]) shot(items[i], s, ui::SC_SET_CAT, i);
    // 2.12.0: 累積時間がメンテナンスの時間に達した(水温・過負荷のカテゴリ・累積時間 リセットの項目と確認の画面は赤の「メンテナンス」)
    trip::setTimes(18000000u, 45296000);
    shot("SetCat3WarnDue", s, ui::SC_SET_LIST, 3);  // 2.15.3: 警告・過負荷は 4 つ目
    shot("Set6TimeDue", s, ui::SC_SET_CAT, 12);
    trip::setTimes(5025000, 45296000);
    set.maintHours = 0;  // メンテナンスが切: 今までどおり ▲▼ と「2 つとも 0 に戻す」
    shot("Set6TimeOff", s, ui::SC_SET_CAT, 12);
    shot("SettingsMaintOff", s, ui::SC_SET_EDIT, 11);  // 0 = 「切」
    set.maintHours = SET_MAINT_DEFAULT;
    shot("SettingsBright", s, ui::SC_SET_EDIT, 0);
    shot("SettingsIllum", s, ui::SC_SET_EDIT, 1);  // 2.9.0: 名前は 2 行
    shot("SettingsShift", s, ui::SC_SET_EDIT, 3);
    shot("SettingsRing", s, ui::SC_SET_EDIT, 4);  // 2.12.0: 回転数の輪(両側)
    set.ringOne = 1;
    shot("SettingsRingOne", s, ui::SC_SET_EDIT, 4);  // 片側
    shot("SetRingOne", s, ui::SC_SET_CAT, 4);
    set.ringOne = 0;
    shot("SettingsWarn", s, ui::SC_SET_EDIT, 5);
    shot("SettingsFuelWarn", s, ui::SC_SET_EDIT, 6);  // 2.14.0: 燃料の警告
    shot("SettingsLoadRpm", s, ui::SC_SET_EDIT, 7);  // 2.12.0: 過負荷 回転数
    shot("SettingsLoadY", s, ui::SC_SET_EDIT, 8);
    set.loadRedMin = 0;
    shot("SettingsLoadROff", s, ui::SC_SET_EDIT, 9);  // 0 = 「切」
    set.loadRedMin = SET_LOADR_DEFAULT;
    shot("SettingsLoadRs", s, ui::SC_SET_EDIT, 10);
    shot("SettingsMaint", s, ui::SC_SET_EDIT, 11);  // 2.12.0: メンテナンスまでの累積時間

    shot("SettingsAuto", s, ui::SC_SET_EDIT, 2);
    set.demoOn = 1;
    shot("SettingsDemo", s, ui::SC_SET_EDIT, 15);
    set.demoOn = 0;
    shot("SettingsRcSend", s, ui::SC_SET_EDIT, 0, 1);
    shot("SetReset", s, ui::SC_SET_EDIT, 12);  // 2.12.0: 累積時間 リセットは変更の画面(0:00:00 から 30 分ずつ)
    {
      ui::testShow(ui::SC_SET_EDIT, 12);
      ui::testTouch(now);
      ui::update(s, ls, ps, si, now);
      for (int k = 0; k < 5; k++) ui::tap(366, 233, now + 10 + k);  // 2:30:00
      ui::update(s, ls, ps, si, now + 20);
      saveShot("SetResetIn");
      printf("%-22s missing=%u\n", "SetResetIn", (unsigned)gfx::missingGlyphs());
      gfx::dirtyClear();
    }
    shot("SetDefaultsConfirm", s, ui::SC_SET_RESET, 2);
    // 保存したあとの点滅(2.4.3): 変更の画面で、押した「決定」の帯が消える(1 回目)・点く(1 回目)。その間は値が太い
    {
      ui::testShow(ui::SC_SET_EDIT, 3);
      ui::testTouch(now);
      ui::update(s, ls, ps, si, now);
      ui::tap(366, 233, now + 10);  // + 100
      ui::tap(233, 400, now + 20);  // 決定
      ui::update(s, ls, ps, si, now + 20);
      saveShot("SavedFlash1");
      ui::update(s, ls, ps, si, now + 20 + SAVED_FLASH_MS + 10);
      saveShot("SavedFlash2");
      printf("%-22s missing=%u\n", "SavedFlash", (unsigned)gfx::missingGlyphs());
      gfx::dirtyClear();
      set.shiftRpm = SET_SHIFT_DEFAULT;
    }
    ls.baud = 921600; ls.locked = true; ls.framesPerSec = 248; ls.crcErrors = 0; ls.lostFrames = 0; ls.infoValid = true;
    ls.info.proto_ver = METER_LINK_PROTO_VER; ls.info.flags = ML_F_SIM; ls.info.can_fps[0] = 1015; ls.info.can_fps[1] = 143;
    strcpy(ls.info.name, "c6dbg r1");
    ps.fps = 58; ps.loopMaxMs = 21; ps.pageMaxUs = 61000; ps.pageFrames = 5400; ps.pageAvgUs = 21400; ps.pageSlowUs = 111000;
    ps.histN = PERF_FPS_SECS;  // 直近 3 分: ふだん 40〜50、背景の色を塗り直す秒は 9〜20
    for (int i = 0; i < PERF_FPS_SECS; i++) ps.fpsHist[i] = (uint8_t)((i % 37) < 30 ? 44 + (i * 7) % 7 : 9 + (i * 5) % 12);
    si.axpOk = true; si.powerOnSrc = 0x04;
    si.cpu.ok = true;
    snprintf(si.cpu.model, sizeof(si.cpu.model), "ESP32-S3");
    si.cpu.rev = 2; si.cpu.cores = 2; si.cpu.cpuMHz = 240; si.cpu.flashBytes = 16u << 20; si.cpu.flashHz = 80000000;
    si.cpu.heapBytes = 327680; si.cpu.heapFree = 184320; si.cpu.psramBytes = 8u << 20; si.cpu.psramFree = 7340032; si.cpu.tempOk = true; si.cpu.tempC = 41.25f;
    // 受信の状態(グループのまとめ)と CAN の中
    shot("InfoCan", s, ui::SC_SET_INFO, 0);
    shot("CanBaud", s, ui::SC_SET_GRP, 0, 0);
    shot("CanReader", s, ui::SC_SET_GRP, 3, 0);
    shot("CanBus", s, ui::SC_SET_GRP, 4, 0);
    {
      const uint8_t f[8] = { 0x20, 0x0D, 0x40, 0x7B, 0x00, 31, 0x20, 0x3D };  // 2.7.0: 燃料 C-CAN 0A18A000 b5 = 31 %
      veh::onFrame(0, 1, VEH_ID_FUEL, 8, f, now);
    }
    shot("CanFuel", s, ui::SC_SET_GRP, 5, 0);
    // 2.9.0: ライト(B-CAN 06214000 b0 の 0x08)。不明 → 切(電源を入れて 0.8 秒で最初に受けた)→ 入 → 受信なし
    shot("CanLightNone", s, ui::SC_SET_GRP, 6, 0);
    {
      uint8_t l[8] = { 0x20, 0x00, 0x40, 0x00, 0x00, 0x55, 0x0B, 0x00 };  // 10/26 の写真(スイッチ 切)
      veh::onFrame(1, 1, VEH_ID_LIGHT, 8, l, 800);
      veh::onFrame(1, 1, VEH_ID_LIGHT, 8, l, now - 1000);
      shot("CanLightOff", s, ui::SC_SET_GRP, 6, 0);
      l[0] = 0x28;  // 写真(スイッチ 入)
      veh::onFrame(1, 1, VEH_ID_LIGHT, 8, l, now - 500);
      shot("CanLightOn", s, ui::SC_SET_GRP, 6, 0);
      now += VEH_LIGHT_TIMEOUT_MS + 1000;
      shot("CanLightLost", s, ui::SC_SET_GRP, 6, 0);
    }
    shot("CanCheck", s, ui::SC_SET_GRP, 7, 0);
    // 本体の状態
    shot("SysFps", s, ui::SC_SET_GRP, 0, 4);
    ps.pageFrames = 3;  // 描いた回が少ない(受信が無いとき)
    shot("SysFpsFew", s, ui::SC_SET_GRP, 0, 4);
    ps.pageFrames = 100;
    shot("SysCpu", s, ui::SC_SET_GRP, 1, 4);
    shot("SysClock", s, ui::SC_SET_GRP, 2, 4);
    shot("SysTemp", s, ui::SC_SET_GRP, 3, 4);
    shot("SysRam", s, ui::SC_SET_GRP, 4, 4);
    shot("SysPsram", s, ui::SC_SET_GRP, 5, 4);
    shot("SysFlash", s, ui::SC_SET_GRP, 6, 4);
    shot("SysBoot", s, ui::SC_SET_GRP, 7, 4);
    ls.locked = false; ls.infoValid = false; si.axpOk = false; ls.crcErrors = 3; ls.bytesPerSec = 1480; ls.framesPerSec = 0;
    shot("CanNoLink", s, ui::SC_SET_GRP, 2, 0);
    shot("InfoCanNg", s, ui::SC_SET_INFO, 0);
    shot("Set2InfoNg", s, ui::SC_SET_LIST, 4);  // 2.12.0: 受信の状態は 4 つ目のカテゴリ(2.15.3: 5 つ目)
    si.rc.enabled = true; si.rc.bleOk = true; si.rc.connected = true; si.rc.canPerSec = 62; si.rc.gpsPerSec = 25; si.rc.gpsOn = true; si.rc.gpsOk = true; si.rc.fixType = 3; si.rc.numSV = 11;
    si.rc.pvtPerSec = 25; si.rc.lat = 355812345; si.rc.lon = 1396821234; si.rc.gpsKmh = 48.3f; si.rc.imuOk = true; si.rc.imuLevel = true; si.rc.imuForward = true;
    si.rc.gLon = 0.32f; si.rc.gLat = -0.85f;
    shot("InfoGps", s, ui::SC_SET_INFO, 1);
    shot("InfoImu", s, ui::SC_SET_INFO, 2);
    shot("InfoRc", s, ui::SC_SET_INFO, 3);
    shot("GpsFix", s, ui::SC_SET_GRP, 0, 1);
    shot("GpsPos", s, ui::SC_SET_GRP, 1, 1);
    shot("GpsSpeed", s, ui::SC_SET_GRP, 2, 1);
    shot("ImuAcc", s, ui::SC_SET_GRP, 0, 2);
    shot("ImuCal", s, ui::SC_SET_GRP, 1, 2);
    shot("ImuReset", s, ui::SC_SET_RESET, 1);
    shot("RcSend", s, ui::SC_SET_GRP, 0, 3);
    si.rc.enabled = false;  // 入にしたが、動いているのは切(次の起動から)
    shot("RcSendPending", s, ui::SC_SET_GRP, 0, 3);
    si.rc.enabled = true;
    shot("RcLink", s, ui::SC_SET_GRP, 1, 3);
    shot("RcRate", s, ui::SC_SET_GRP, 2, 3);
    memset(&si.rc, 0, sizeof(si.rc));
    si.rc.enabled = true; si.rc.bleOk = true; si.rc.imuOk = true;
    shot("RcIdle", s, ui::SC_SET_GRP, 1, 3);
    memset(&si.rc, 0, sizeof(si.rc));
    shot("RcOff", s, ui::SC_SET_GRP, 1, 3);
    shot("GpsOff", s, ui::SC_SET_GRP, 0, 1);
    shot("InfoRcOff", s, ui::SC_SET_INFO, 3);
    memset(&si.rc, 0, sizeof(si.rc));
  }

  // ---- 触れたときの案内(2.3.0。タッチが決まった所。2.4.0: 上に「‹ スワイプ ›」、下に「長押し ▶ 設定」。上下対称)
  {
    Signals s = sig(4200, '3', 92, 62);
    const ui::Screen scs[3] = { ui::SC_DRIVE, ui::SC_BOOST, ui::SC_DATA };
    const char *nm[3] = { "GuideCircuit", "GuideTach", "GuideData" };
    for (int k = 0; k < 3; k++) {
      ui::testShow(scs[k]);
      ui::testTouch(now);
      ui::update(s, ls, ps, si, now);
      ui::touchDown(233, 233, now + 10);
      ui::update(s, ls, ps, si, now + 10 + TOUCH_CONFIRM_MS + 10);
      saveShot(nm[k]);
      printf("%-22s guide=%d missing=%u\n", nm[k], (int)ui::testGuide(), (unsigned)gfx::missingGlyphs());
      if (k == 0) {  // 指がずれた: 案内のまま、長押しの札が灰
        ui::touchMove(233 + HOLD_CANCEL_PX + 5, 233, now + 10 + TOUCH_CONFIRM_MS + 30);
        ui::update(s, ls, ps, si, now + 10 + TOUCH_CONFIRM_MS + 40);
        saveShot("GuideCancel");
        printf("%-22s guide=%d mode=%d\n", "GuideCancel", (int)ui::testGuide(), ui::testGuideMode());
      }
      ui::touchUp(now + 10 + TOUCH_CONFIRM_MS + 60);
      ui::testShow(scs[k]);
      gfx::dirtyClear();
      now += 5000;
    }
  }

  // ---- 長押しの途中(押したまま、表示を出してから外周が 6 割ほど進んだ所。2.4.0: 案内のまま、スワイプの札が灰で外周が回る)
  {
    Signals s = sig(4200, '3', 92, 62);
    const uint32_t at = HOLD_SHOW_MS + (HOLD_MS - HOLD_SHOW_MS) * 6 / 10;
    const ui::Screen scs[3] = { ui::SC_DRIVE, ui::SC_BOOST, ui::SC_DATA };
    const char *nm[3] = { "HoldCircuit", "HoldTach", "HoldData" };
    for (int k = 0; k < 3; k++) {
      ui::testShow(scs[k]);
      ui::testTouch(now);
      ui::update(s, ls, ps, si, now);
      ui::touchDown(233, 233, now);
      ui::update(s, ls, ps, si, now + TOUCH_CONFIRM_MS + 10);
      ui::update(s, ls, ps, si, now + HOLD_SHOW_MS + 10);
      ui::update(s, ls, ps, si, now + at);
      saveShot(nm[k]);
      if (k == 0) {  // 長押しの途中で指がずれた: 外周を消し、案内のまま長押しの札が灰
        ui::touchMove(233, 233 + HOLD_CANCEL_PX + 5, now + at + 5);
        ui::update(s, ls, ps, si, now + at + 10);
        saveShot("HoldCancel");
        printf("%-22s guide=%d mode=%d holding=%d\n", "HoldCancel", (int)ui::testGuide(), ui::testGuideMode(), (int)ui::testHolding());
      }
      ui::touchUp(now + at + 20);
      ui::testShow(scs[k]);
      gfx::dirtyClear();
      now += 5000;
    }
    now += 20000;
  }

  // ---- 設定の中の「長押しで開く」(2.4.4): 右の矢印を押して決まった所(2.5.0: 帯は変えない)、長押しの途中(帯が水色、外周が 6 割)、
  // 動いて取り消した所(帯の字が灰)
  {
    Signals s = sig(4200, '3', 92, 62);
    const uint32_t at = HOLD_SHOW_MS + (HOLD_MS - HOLD_SHOW_MS) * 6 / 10;
    ui::testShow(ui::SC_SET_LIST, 5);  // 2.15.0: 本体の状態は 6 つ目のカテゴリ
    ui::testTouch(now);
    ui::update(s, ls, ps, si, now);
    ui::touchDown(366, 233, now + 10);
    ui::update(s, ls, ps, si, now + 10 + TOUCH_CONFIRM_MS + 10);
    saveShot("MenuTap");
    ui::touchMove(366, 233 + HOLD_CANCEL_PX + 5, now + 10 + TOUCH_CONFIRM_MS + 15);  // 縦に動かして離す(タップにもスワイプにもしない)
    ui::touchUp(now + 10 + TOUCH_CONFIRM_MS + 20);
    now += 1000;
    ui::update(s, ls, ps, si, now);
    ui::touchDown(233, 400, now + 10);
    ui::update(s, ls, ps, si, now + 10 + TOUCH_CONFIRM_MS + 10);
    ui::update(s, ls, ps, si, now + 10 + at);
    saveShot("MenuHold");
    ui::touchMove(233 + HOLD_CANCEL_PX + 5, 400, now + 10 + at + 5);
    ui::update(s, ls, ps, si, now + 10 + at + 10);
    saveShot("MenuCancel");
    printf("%-22s guide=%d mode=%d holding=%d missing=%u\n", "MenuCancel", (int)ui::testGuide(), ui::testGuideMode(), (int)ui::testHolding(), (unsigned)gfx::missingGlyphs());
    ui::touchUp(now + 10 + at + 20);
    ui::testShow(ui::SC_SET_LIST, 5);
    gfx::dirtyClear();
    now += 5000;
  }

  // ---- 走行記録(2.15.0。仕様書 odo_log_spec.md 第 3 版 7 章)。50 日分の記録を作る(日本時間 11/8(日)が今日)
  {
    Signals s = sig(850, 'N', 88, 62);
    shot("OdoWait", s, ui::SC_ODO, 0, 0);  // GPS の時刻が分かる前
    odo::Input in;
    memset(&in, 0, sizeof(in));
    in.odoOk = in.odoHave = in.speedOk = in.timeOk = true;
    in.odoKm = 23000;
    const uint32_t day0 = gtime::epoch(2026, 9, 19, 1, 0, 0);  // 日本時間 9/19 10:00
    uint32_t to = 1000, above = 0;
    for (int dd = 0; dd <= 50; dd++) {
      const int km = (dd % 7 == 3) ? 0 : 8 + (dd * 37) % 45;  // 走らない日もある
      in.utc = day0 + (uint32_t)dd * 86400u;
      in.speedKmh = 0;
      odo::update(in, to += 1000);
      in.odoKm += (uint32_t)km;
      above += km > 30 ? (uint32_t)(km * 9000) : 0;
      in.aboveMs = above;
      in.speedKmh = 40;
      odo::update(in, to += 1000);
      in.speedKmh = 0;
      to += ODO_MIN_INTERVAL_MS;
      in.utc += 3600;
      odo::update(in, to);
    }
    si.timeOk = true;
    si.utc = in.utc;
    shot("SetOdo", s, ui::SC_SET_LIST, 0);             // 設定の走行記録(今の ODO。2.15.3: 1 つ目)
    shot("OdoYear", s, ui::SC_ODO, 0, 0);              // 1 年(今年。2.15.2)
    shot("OdoQuarter", s, ui::SC_ODO, 1, 0);           // 3 ヶ月(10〜12 月)
    shot("OdoQuarterBack", s, ui::SC_ODO, 1, 45);      // 7〜9 月(記録の始まり。前へは送れない)
    shot("OdoMonth", s, ui::SC_ODO, 2, 0);             // 1 ヶ月(今月)
    shot("OdoMonthBack", s, ui::SC_ODO, 2, 10);        // 10 月
    shot("OdoWeek", s, ui::SC_ODO, 3, 0);              // 1 週(今週)
    shot("OdoWeekBack", s, ui::SC_ODO, 3, 7);          // 先週
    shot("OdoDay", s, ui::SC_ODO, 4, 0);               // 1 日(今日)
    shot("OdoDayNoRun", s, ui::SC_ODO, 4, 5);          // 走らなかった日(その前の ODO)
    shot("SysOdo", s, ui::SC_SET_GRP, 8, 4);
    printf("%-22s missing=%u\n", "Odo", (unsigned)gfx::missingGlyphs());
  }

  // ---- そのほかの状態
  {
    Signals s = sig(4200, '3', 92, 62, true, true, 0.9f);
    s.sim = true; s.scene = 7;
    shot("DriveSim", s, ui::SC_DRIVE);
    shot("BoostSim", s, ui::SC_BOOST);
    shot("DataSim", s, ui::SC_DATA);
    {  // 2.12.0: メンテナンスの印(累積時間がメンテナンスの時間に達した。本人 10/28「メンテナンスの表示は全ての画面で表示してください」)
      const uint32_t a0 = trip::aboveMs(), b0 = trip::belowMs();
      trip::setTimes(18000000u, 0);
      shot("DriveMaint", sig(2500, '3', 92, 62), ui::SC_DRIVE);              // 真ん中の下に赤の「メンテナンス」
      shot("DriveMaintSim", s, ui::SC_DRIVE);                                 // デモ: 「SIM 7」は上、「メンテナンス」は下
      shot("DriveMaintFuel", sig(2500, '3', 92, 6), ui::SC_DRIVE);            // 燃料の警告でも赤のまま(2.14.0: 下を赤く塗らない)
      shot("DriveMaintRed", sig(6600, '4', 92, 62), ui::SC_DRIVE);            // 背景が赤の上は白
      shot("BoostMaint", sig(2500, '3', 92, 62, true, true, 0.4f), ui::SC_BOOST);         // 札の段に赤の「メンテナンス」
      shot("BoostMaintWater", sig(2500, '3', 112, 62, true, true, 0.4f), ui::SC_BOOST);   // 水温の札の下の段
      shot("BoostMaintBoth", sig(2500, '3', 112, 6, true, true, 0.4f), ui::SC_BOOST);     // 2 段とも水温・燃料: 出さない
      shot("BoostMaintSim", s, ui::SC_BOOST);
      shot("DataMaintSim", s, ui::SC_DATA);
      trip::setTimes(a0, b0);
    }
    Signals down;
    memset(&down, 0, sizeof(down));
    shot("DriveNoLink", down, ui::SC_DRIVE);
    shot("BoostNoLink", down, ui::SC_BOOST);
    shot("DataNoLink", down, ui::SC_DATA);
    Signals hot = sig(2000, '5', 104, 100);
    shot("DataHot3", hot, ui::SC_DATA);
    Signals hot2 = sig(6100, '2', 118, 3);
    shot("DataAlarm3", hot2, ui::SC_DATA);
    // 2.14.0: 注意(暗い黄、点滅なし。水温は 警告温度 − 5 ℃ から、燃料は 燃料の警告 + 10 % 未満から)と警告(赤、点滅)。背景は塗らない
    shot("DriveCaution", sig(2500, '3', 106, 25), ui::SC_DRIVE);
    shot("BoostCaution", sig(2500, '3', 106, 25, true, true, 0.4f), ui::SC_BOOST);
    shot("DataCaution", sig(2500, '3', 106, 25), ui::SC_DATA);
    shot("DriveWarn", sig(2500, '3', 112, 12), ui::SC_DRIVE);  // 点灯側
    shot("BoostWarn", sig(2500, '3', 112, 12, true, true, 0.4f), ui::SC_BOOST);
    shot("BoostCautionWarn", sig(2500, '3', 106, 12, true, true, 0.4f), ui::SC_BOOST);  // 水温は注意、燃料は警告
    shot("DriveCold", sig(1500, '1', 35, 100), ui::SC_DRIVE);
    shot("Drive5900", sig(5900, '2', 69, 15.5f), ui::SC_DRIVE);
    now += BLINK_ON_FAST_MS;  // 点滅の消灯の側(画面全体を消す設定では絵は同じで、明るさだけが変わる)
    shot("DriveRedOff", sig(6300, '3', 97, 41), ui::SC_DRIVE);
    now -= BLINK_ON_FAST_MS;
    now += ALARM_BLINK_HALF_MS;  // 異常の表示の消灯の側
    shot("DriveIdleOff", sig(850, 'N', 88, 12), ui::SC_DRIVE);
    shot("DriveHotOff", sig(5600, '4', 112, 45), ui::SC_DRIVE);
    shot("DataAlarmOff", sig(5600, '4', 112, 12), ui::SC_DATA);
    now -= ALARM_BLINK_HALF_MS;
    shot("DataCold", sig(1200, 'N', -5.4f, 100), ui::SC_DATA);    // 氷点下: 「−5」
    shot("DataCold2", sig(900, 'N', -18, 9), ui::SC_DATA);        // 氷点下 2 桁 + 燃料が少ない
    shot("DriveCold2", sig(900, 'R', -18, 9), ui::SC_DRIVE);      // バーは左端で止まる。ギアは R
    Signals odd = sig(3000, 'P', 80, 50);                         // 表示できないギアの文字 → 「–」
    odd.gearOk = false;
    shot("DriveGearUnknown", odd, ui::SC_DRIVE);
  }
  // ---- オープニング(2.5.0: 覚えた画面ごとに 3 種類。時刻で進む)
  {
    LinkStats lo;
    memset(&lo, 0, sizeof(lo));
    SysInfo so;
    memset(&so, 0, sizeof(so));
    so.touchOk = true; so.nvsOk = true; so.rc.enabled = true; so.rc.bleOk = true; so.rc.imuOk = true; so.rc.gpsOn = true; so.rc.gpsOk = true;
    Signals o = sig(850, 'N', 62, 74, true, true, -0.55f);
    struct Mark { int kind; uint32_t at; const char *name; };
    const Mark marks[] = {
      { 0, OPC_SCAN_MS / 2, "OpenCircuit1" },                                     // 白い光が下から上へ走る
      { 0, OPC_SCAN_MS + OPC_FLASH_MS + OPC_RISE_MS * 8 / 10, "OpenCircuit2" },  // 点いていく
      { 0, OPC_SCAN_MS + OPC_FLASH_MS + OPC_RISE_MS + 100, "OpenCircuit3" },     // 全部点いて背景も赤(リミッター)
      { 0, OPC_SCAN_MS + OPC_FLASH_MS + OPC_RISE_MS + OPC_LIMIT_MS + OPC_FALL_MS / 4, "OpenCircuit4" },  // 消えていく
      { 0, OPC_TOTAL_MS - OPC_CLOCK_MS / 2, "OpenCircuit5" },                     // 時計と真ん中が浮かぶ途中(2.10.0)
      { 0, OPC_TOTAL_MS - 10, "OpenCircuit6" },                                   // 浮かび終わる所
      { 1, OPT_UP_MS * 4 / 10, "OpenTach1" },                                     // 針が通った所から文字盤が出る
      { 1, OPT_UP_MS + OPT_TOP_MS / 2, "OpenTach2" },                             // 振り切り(赤)
      { 1, OPT_UP_MS + OPT_TOP_MS + OPT_DOWN_MS * 6 / 10, "OpenTach3" },          // 戻っていく
      { 2, OPD_RING_MS + OPD_ROW_MS + OPD_CHECK_MS / 2, "OpenData1" },            // 2 行目を確かめている
      { 2, OPD_TOTAL_MS - 100, "OpenData2" },                                     // 全部出た(輪が緑、版)
    };
    const uint32_t t0 = 300000;
    int kind = -1;
    uint32_t tt = 0, base = 0;
    for (const Mark &m : marks) {
      if (m.kind != kind) {
        kind = m.kind;
        base = t0 + 10000u * (uint32_t)(kind + 1);
        tt = base;
        ui::testShow(ui::SC_OPENING, kind);
      }
      for (; tt <= base + m.at; tt += 5) {
        lo.locked = tt - base >= 700;
        ui::update(o, lo, ps, so, tt);
        gfx::dirtyClear();
      }
      saveShot(m.name);
      printf("%-22s level=%d screen=%d\n", m.name, (int)ui::blinkLevel(), (int)ui::screen());
    }
    so.touchOk = false;  // NG: 輪が赤
    ui::testShow(ui::SC_OPENING, 2);
    for (tt = t0 + 50000; tt <= t0 + 50000 + OPD_TOTAL_MS - 100; tt += 5) {
      ui::update(o, lo, ps, so, tt);
      gfx::dirtyClear();
    }
    saveShot("OpenDataNg");
    ui::testShow(ui::SC_OPENING, 0);  // 覚えた画面をサーキットに戻す
    ui::tap(233, 233, t0 + 60000);
    ui::testShow(ui::SC_DRIVE);
  }
  // ---- CAN確認の「前後で比べる」(2.6.0。2.16.0 で作り直し): 待ち(残りの秒)・記録なし・記録中・前を記録した・候補・一覧(ビット・
  //      後は受信なし(今は受けていない)・前は受信なし)・やり直す・CAN のページ。表を空にするので最後に描く(ほかの CAN確認の絵を変えない)
  {
    Signals s = sig(4200, '3', 92, 62);
    g_hostCanPreN = 0;
    cantab::begin();
    // st = 0: ふだん(前)、1: 制御 OFF(後)。0A18A006 b0 01 / 03・b1 00 / 0C、0030A002 は前だけ、0x456 は後だけ
    auto feed = [&](uint32_t from, uint32_t to, int st) {
      for (uint32_t tt = from; tt < to; tt += 20) {
        uint8_t a[8] = { (uint8_t)(st ? 0x03 : 0x01), (uint8_t)(st ? 0x0C : 0x00), (uint8_t)(tt / 20), 0, 0, 0, (uint8_t)((tt / 100) & 0x1F), 0 };
        uint8_t b[8] = { (uint8_t)(tt / 20), (uint8_t)(tt / 7), 1, 2, 3, 4, 5, 6 };
        canFrame(0x0A18A006, a, 8, tt);
        canFrame(0x0A18A001, b, 8, tt);
        if (st == 0) {
          uint8_t e[8] = { 0x1C, 0x40, 0, 0, 0, 0, 0, 0 };
          canFrame(0x0030A002, e, 8, tt);
        } else {
          const uint8_t f[3] = { 0xAA, 0x55, 0x01 };
          cantab::onFrame(0, 0, 0x456, 3, f, tt);
        }
        cantab::tick(tt);
      }
    };
    const uint32_t t0 = now;
    feed(t0, t0 + 3000, 0);
    now = t0 + 3000;
    shot("CanPpWait", s, ui::SC_CAN_PP);  // 下の帯に「待ち 12 秒」(灰)
    feed(t0 + 3000, t0 + 16000, 0);
    now = t0 + 16000;
    shot("CanPp0", s, ui::SC_CAN_PP);  // 記録なし、下「前を記録」
    cantab::ppStart(now);
    feed(now, now + 3000, 0);
    now += 3000;
    shot("CanPpRec", s, ui::SC_CAN_PP);  // 前を記録中、下「記録中 7 秒」(灰)
    feed(now, now + CAN_PP_WIN_MS - 3000, 0);
    now += CAN_PP_WIN_MS - 3000;
    cantab::ppPoll(now);
    shot("CanPp1", s, ui::SC_CAN_PP);  // 前を記録した、下「後を記録」
    cantab::begin();  // 電源を入れ直す(記録は残る)
    const uint32_t t2 = now + 600000;
    feed(t2, t2 + 16000, 1);
    now = t2 + 16000;
    cantab::ppStart(now);
    feed(now, now + CAN_PP_WIN_MS, 1);
    now += CAN_PP_WIN_MS;
    cantab::ppPoll(now);
    shot("CanPpResult", s, ui::SC_CAN_PP);       // 候補 4 件、前 1 回 後 1 回、件数の移り変わり
    shot("CanPpList", s, ui::SC_CAN_ID, 0, 1);   // 1/4  前は受信なし(0x456)
    shot("CanPpList2", s, ui::SC_CAN_ID, 1, 1);  // 2/4  後は受信なし(0030A002、今は受信していない)
    shot("CanPpList3", s, ui::SC_CAN_ID, 2, 1);  // 3/4  b0&02  01 → 03
    shot("CanPpList4", s, ui::SC_CAN_ID, 3, 1);  // 4/4  b1&0C  00 → 0C
    shot("CanPpRedo", s, ui::SC_CAN_REDO, 1);
    shot("CanPpPage", s, ui::SC_SET_GRP, 8, 0);
    g_hostCanPreN = 0;
    cantab::begin();
  }
  // ---- 押した帯の反転(2.7.0): タッチが決まった所。CAN確認の「変化を記録」・設定の上の帯・赤い帯・前後で比べるの「前を記録」。
  //      縦に動かして取り消してから離す(操作はしない)
  {
    Signals s = sig(4200, '3', 92, 62);
    auto press = [&](const char *name, ui::Screen sc, int a, int x, int y) {
      ui::testShow(sc, a);
      ui::testTouch(now);
      ui::update(s, ls, ps, si, now);
      ui::touchDown(x, y, now + 10);
      ui::update(s, ls, ps, si, now + 10 + TOUCH_CONFIRM_MS + 10);
      saveShot(name);
      printf("%-22s screen=%d\n", name, (int)ui::screen());
      ui::touchMove(x, y > 233 ? y - HOLD_CANCEL_PX - 5 : y + HOLD_CANCEL_PX + 5, now + 10 + TOUCH_CONFIRM_MS + 15);
      ui::touchUp(now + 10 + TOUCH_CONFIRM_MS + 20);
      ui::update(s, ls, ps, si, now + 10 + TOUCH_CONFIRM_MS + 30);
      gfx::dirtyClear();
      now += 1000;
    };
    press("PressCan", ui::SC_CAN, 0, 233, 400);
    press("PressSetTop", ui::SC_SET_LIST, 0, 233, 60);
    press("PressRedo", ui::SC_CAN_REDO, 0, 233, 400);
    uint8_t a[8] = { 0x20, 0x0D, 0x40, 0x7B, 0x00, 31, 0x20, 0x3D };
    for (uint32_t tt = now; tt < now + 16000; tt += 20) {
      canFrame(0x0A18A000, a, 8, tt);
      cantab::tick(tt);
    }
    now += 16000;
    press("PressPp", ui::SC_CAN_PP, 0, 233, 400);
    g_hostCanPreN = 0;
    cantab::begin();
  }
  printf("missing glyphs total: %u\n", (unsigned)gfx::missingGlyphs());
  return gfx::missingGlyphs() ? 1 : 0;
}
