katsuhaa/abarth595-round-gauge/meter_display/ui.cpp

// ui.cpp - 画面(サーキット・タコ・データ・設定・CAN確認)
//
// 座標・大きさ・色は ui_spec.md(キャンバス版 23)の値。文字の位置(ベースライン)は、キャンバスの絵を
// ブラウザーで描いて測った値。章番号は ui_spec.md のもの。
// 仕様書のあとで変えた所: 枠をなくした(2026-10-13)、水温と燃料を輪の内側の円弧にした、ブースト計のページを足した(2026-10-14)。
// 10/23: 画面の名前をサーキット(走行)・タコ(ブースト計)・データにした。3 つはスワイプで切り替え、長押しで設定(2.1.0)。
// 設定は 1 画面 1 項目(2.3.0: 7 項目。RaceChrono と CAN確認は受信の状態の中)で、上の帯・下の帯・真ん中の左右の 4 つの範囲で
// 操作する(config.h の ZONE_*)。
// 2.10.0: サーキットの輪の内側に時計を足し、真ん中をピークの回転数・高負荷時間・接続の状態の出し分けにした(ギアはタコへ)。
// 仕様書は Project の circuit_screen_spec.md 第 3 版、絵はキャンバス「595 メーター サーキット画面・タコ画面 案」。
#include "ui.h"
#include "gfx.h"
#include <math.h>
#include <stdio.h>
#include <string.h>

namespace ui {

using gfx::rgb;

// ---------------------------------------------------------------- 色(9.1)
// 背景は仕様書の紺(#0A1E46)から黒に変えた(2026-10-14。AMOLED では黒が最もコントラストが高い)。
// 走行画面の背景は回転数で黄・赤になる(4 章。2.12.0: 緑はやめて黄の手前まで黒)。
static const uint16_t C_BG = rgb(0x000000);           // 背景(黒)
static const uint16_t C_TRACK = rgb(0x1F3A70);        // 走行画面の弧の地
static const uint16_t C_HBAR = rgb(0x274F9C);         // データ画面の横棒の地
static const uint16_t C_WHITE = rgb(0xFFFFFF);
static const uint16_t C_LABEL = rgb(0xA9C0E8);        // 名前、単位、アイコン
static const uint16_t C_WATER_BLUE = rgb(0x2F8BFF);   // 水温の 70℃ 未満
static const uint16_t C_WARN_TRACK = rgb(0x6A1C26);   // 水温の警告温度から上の地
static const uint16_t C_ALARM = rgb(0xE3241B);        // 異常のときの枠と下地
static const uint16_t C_ALARM_TRACK = rgb(0x8E130D);  // 異常のときのバーの地
static const uint16_t C_ALARM_UNIT = rgb(0xFFE3DC);   // 異常のときの単位
static const uint16_t C_CAUTION = rgb(0xE0B000);      // 注意(暗い黄。2.14.0: 警告の手前の段。点滅しない。本人 10/30「黄色がクリームに見えるので暗い黄色に」で #FFEE99 → #E0B000)
static const uint16_t C_ACCENT = rgb(0x5FD0FF);       // 押せる所の印
static const uint16_t C_ORANGE = rgb(0xFF4600);
static const uint16_t C_PEAK = rgb(0xFFD000);         // 回転計のピークホールドの印(黄)
static const uint16_t C_DOT_OFF = rgb(0x5A606A);      // 状態の点: 待ち・切(データ画面の行と、サーキットの接続の状態)
static const uint16_t C_DOT_OK = rgb(0x22E36A);       // 状態の点: 正常

// 輪の色と背景の色(3.3、4 章)。並びは 灰・青・緑・黄・赤
struct Rgb8 {
  uint8_t r, g, b;
};
static const Rgb8 RING_C[5] = { { 0x8D, 0x97, 0xAD }, { 0x2B, 0x7B, 0xFF }, { 0x22, 0xE3, 0x6A }, { 0xFF, 0xDC, 0x00 }, { 0xFF, 0x2A, 0x2A } };
// 2.12.0: 背景は黄の手前まで黒(本人 10/28「回転数の警告 → 黄色までは背景を黒に」。2.11.0 までは緑の所(5800 なら 4000〜)を緑 #0E7A3C)
static const Rgb8 BACK_C[5] = { { 0x00, 0x00, 0x00 }, { 0x00, 0x00, 0x00 }, { 0x00, 0x00, 0x00 }, { 0xC4, 0xA0, 0x00 }, { 0xA3, 0x15, 0x15 } };

static inline uint16_t to565(Rgb8 c) {
  return rgb(((uint32_t)c.r << 16) | ((uint32_t)c.g << 8) | c.b);
}
static uint8_t mix8(uint8_t a, uint8_t b, int num, int den) {
  return (uint8_t)((a * (den - num) + b * num + den / 2) / den);
}
// 背景の明るさで、文字とアイコンの色を変える(枠をなくしたので、背景の上に直接描く)
static int lum565(uint16_t c) {  // 0〜255
  int r = ((c >> 11) & 31) * 255 / 31, g = ((c >> 5) & 63) * 255 / 63, b = (c & 31) * 255 / 31;
  return (r * 299 + g * 587 + b * 114) / 1000;
}
static bool isBright(uint16_t bg) {
  return lum565(bg) > 120;
}
static uint16_t fgOn(uint16_t bg) {  // 数字
  return isBright(bg) ? rgb(0x06132E) : rgb(0xFFFFFF);
}
static uint16_t labelOn(uint16_t bg) {  // 名前・単位・アイコン
  if (bg == C_BG) return C_LABEL;  // 黒の上ではほかの画面と同じ色
  return isBright(bg) ? gfx::blend(bg, 0x0000, 190) : gfx::blend(bg, 0xFFFF, 170);
}
// 異常の色: 背景が赤っぽいときは赤が見えないので白
static bool isReddish(uint16_t bg) {
  int r = (bg >> 11) & 31, g = (bg >> 5) & 63;
  return r > 16 && g < 24;
}
static uint16_t alarmOn(uint16_t bg) {
  return isReddish(bg) ? rgb(0xFFFFFF) : C_ALARM;
}
// 異常のときの弧の地と、点滅の消灯側の色(暗い赤。赤っぽい背景では少し明るい赤)
static uint16_t alarmDimOn(uint16_t bg) {
  return isReddish(bg) ? gfx::blend(bg, 0xFFFF, 70) : C_ALARM_TRACK;
}
// 注意の色(2.14.0): 暗い黄。背景が明るい(黄)ときは暗い黄が見えないので暗い琥珀色
static uint16_t cautionOn(uint16_t bg) {
  return isBright(bg) ? rgb(0x6E5200) : C_CAUTION;
}
static uint16_t segOffOn(uint16_t bg) {  // 消えているマスは描かない(背景と同じ色)
  return bg;
}

// 仕様書 4.2 の計算。sp はシフト点
static Rgb8 colorAt(const Rgb8 table[5], int rpm, int sp) {
  const int thr[4] = { sp + RING_BLUE_OFFSET, sp + RING_GREEN_OFFSET, sp + RING_YELLOW_OFFSET, sp + RING_RED_OFFSET };
  int i = 0;
  while (i < 4 && rpm >= thr[i]) i++;
  if (i == 4) return table[4];
  int start = thr[i] - RING_BLEND_RPM;
  if (rpm < start) return table[i];
  Rgb8 a = table[i], b = table[i + 1];
  int num = rpm - start;
  return Rgb8{ mix8(a.r, b.r, num, RING_BLEND_RPM), mix8(a.g, b.g, num, RING_BLEND_RPM), mix8(a.b, b.b, num, RING_BLEND_RPM) };
}
// 片側で点くマスの数。0 のときは RING_IDLE_MARK が 1 なら一番下のマスだけを橙で点ける
static int litPerSide(int rpm, int sp) {
  int first = sp - 11 * RING_STEP_RPM;
  int n = 0;
  for (int k = 0; k < 12; k++) {
    if (rpm >= first + RING_STEP_RPM * k) n++;
  }
  return n;
}

// ---------------------------------------------------------------- 共通
static Screen g_sc = SC_DRIVE;
static bool g_full = true;       // 次の update で画面全体を描き直す
static Settings *g_set = nullptr;
static uint32_t g_lastActMs = 0; // 最後に操作した時刻(自動で戻る用)
static uint32_t g_nextMs = 0;    // 走行以外の画面を次に見直す時刻
static uint8_t g_waterLvl = 0, g_fuelLvl = 0;  // 水温・燃料の段(2.14.0): 0 = 正常、1 = 注意(暗い黄)、2 = 警告(赤・点滅)
static bool g_alarmOff = false;  // 警告の表示の点滅の消灯側(update で時刻から決める)
static bool g_simShown = false;
static bool g_blank = false;  // 画面全体の点滅の消灯の間
static uint8_t g_level = BL_NORMAL;  // 画面全体の明るさの段階(BlinkLevel)
static bool g_tagsDirty = false;  // 走行画面の背景を塗り直したので「SIM」を描き直す
static bool g_tagsLost = false;   // 「SIM」の印の所が一部消されたかもしれない(updTags が消して描き直す)
static uint8_t g_sceneShown = 0;

static const float PI_F = 3.14159265f;

static float textC(const FontData &f, float cx, float base, const char *s, uint16_t c) {
  return gfx::drawText(f, cx - gfx::textWidth(f, s) * 0.5f, base, s, c);
}
static void textR(const FontData &f, float xr, float base, const char *s, uint16_t c) {
  gfx::drawText(f, xr - gfx::textWidth(f, s), base, s, c);
}

// ASCII は fa、それ以外(日本語)は fj で描く。「°」(U+00B0)は英数字の書体で描く(2.4.3: 温度の「°C」。日本語の書体だと間が空く)
static bool isAsciiLike(const char *s) {
  return ((uint8_t)s[0]) < 0x80 || ((uint8_t)s[0] == 0xC2 && (uint8_t)s[1] == 0xB0);
}
static int runLen(const char *s) {
  bool a = isAsciiLike(s);
  int n = 0;
  while (s[n] && isAsciiLike(s + n) == a) {
    uint8_t c = (uint8_t)s[n];
    n += (c < 0x80) ? 1 : (c >= 0xF0) ? 4 : (c >= 0xE0) ? 3 : 2;
  }
  return n;
}
static float mixWidth(const FontData &fa, const FontData &fj, const char *s) {
  float w = 0;
  char buf[48];
  while (*s) {
    int n = runLen(s);
    if (n > (int)sizeof(buf) - 1) n = sizeof(buf) - 1;
    memcpy(buf, s, n);
    buf[n] = 0;
    w += gfx::textWidth(isAsciiLike(s) ? fa : fj, buf);
    s += n;
  }
  return w;
}
static float mixDraw(const FontData &fa, const FontData &fj, float x, float base, const char *s, uint16_t c) {
  char buf[48];
  while (*s) {
    int n = runLen(s);
    if (n > (int)sizeof(buf) - 1) n = sizeof(buf) - 1;
    memcpy(buf, s, n);
    buf[n] = 0;
    x = gfx::drawText(isAsciiLike(s) ? fa : fj, x, base, buf, c);
    s += n;
  }
  return x;
}


static bool g_holdShown = false;  // 長押しの途中の表示(案内のまま、スワイプの札を灰にして外周。2.4.0)を出している
static bool g_guideShown = false;  // 触れたときの案内(上の「‹ スワイプ ›」、下の「長押し ▶ 設定」)を出している(2.3.0)
static bool g_pageFrame = false;  // 直前の update が、サーキット・タコをふだんどおり描いた回(pageFrame)
static Screen g_homeSaved = SC_DRIVE;  // 覚えた画面(次の起動・時間で戻るとき)
static Screen g_homeCur = SC_DRIVE;    // 今の(最後に見た)サーキット・タコ・データ(設定の「設定」で戻る先)
static uint32_t g_homeSinceMs = 0;  // 今のサーキット・タコ・データを出し始めた時刻(覚える画面の判定)
static bool g_homeRestart = false;  // 次の update で g_homeSinceMs を数え直す(試験の testShow)
static float g_hideA = -1.0f;    // タコのオープニング: 文字盤のうち、この角度 [度] から OPT_HIDE_A1 までを隠している(-1 = 隠していない。2.5.0)
static bool g_barForce = false;  // 次の updBoost で、ブーストの帯を変わっていなくても消して描き直す(タコのオープニングで文字盤を写したとき)
static void go(Screen sc) {
  g_sc = sc;
  g_full = true;
  g_nextMs = 0;
  g_holdShown = false;
  g_guideShown = false;
  g_hideA = -1.0f;  // 2.5.0: 画面が替わったら文字盤は隠さない(タコのオープニングを飛ばしたとき)
  g_barForce = false;
}
Screen screen() {
  return g_sc;
}
bool blankNow() {
  return g_blank;
}

// ---------------------------------------------------------------- 点滅(回転数が「シフト点 + RING_BLINK_OFFSET」以上)
// 消灯・点灯の切り替えの時刻をここで管理する。消灯の時間は一定(BLINK_OFF_MS)、点灯の時間は回転数で決まる(始まりで
// BLINK_ON_SLOW_MS、シフト点以上で BLINK_ON_FAST_MS、その間は比例)。次の切り替えは前の切り替えの時刻に、その側の時間を足して
// 決める(速さが変わっても位相が飛ばない)。
// 始めるときは点灯側から始め、最初の切り替えは半周期後(途中の位相から始めると、最初の消灯が一瞬だけになることがある)。
// 「シフト点 + RING_SOLID_OFFSET」以上では点滅せず、明るさを最大にする(BL_MAX)。
static bool g_blinkActive = false;
static bool g_blinkOff = false;      // 消灯の側
static uint32_t g_blinkEdgeMs = 0;   // 次に切り替える時刻
static uint32_t g_blinkOn = 0;       // いまの点灯の時間(点滅していなければ 0)
static uint32_t g_blinkToggles = 0, g_blinkLateMax = 0, g_blinkLateOver = 0;

static uint32_t blinkOnFor(int rpm, int sp) {
  const int start = sp + RING_BLINK_OFFSET;
  if (rpm >= sp || sp <= start) return BLINK_ON_FAST_MS;
  if (rpm <= start) return BLINK_ON_SLOW_MS;
  return (uint32_t)(BLINK_ON_SLOW_MS + (BLINK_ON_FAST_MS - BLINK_ON_SLOW_MS) * (rpm - start) / (sp - start));
}
static void setLevel(uint8_t level) {
  if (level == g_level) return;
  g_level = level;
  g_blank = level == BL_OFF;
  platBlink(level);
}
// 回転数 rpm(ok = 信号あり)から、点滅・最大輝度の段階を決める。onPage = サーキット・タコ(ほかの画面では点灯側に戻る)。
// 2.5.0: オープニングは仮の回転数でこれを呼ぶ(本物と同じ決まりで点滅・最大輝度にする)
static void blinkRun(bool ok, int rpm, bool onPage, uint32_t now) {
  const int sp = g_set->shiftRpm;
  const bool solid = ok && onPage && rpm >= sp + RING_SOLID_OFFSET;  // 点滅せず最大輝度
  const bool active = ok && onPage && !solid && rpm >= sp + RING_BLINK_OFFSET;
  if (!active) {
    g_blinkActive = false;
    g_blinkOff = false;
    g_blinkOn = 0;
    setLevel(solid ? BL_MAX : BL_NORMAL);
    return;
  }
  const uint32_t on = blinkOnFor(rpm, sp);
  g_blinkOn = on;
  if (!g_blinkActive) {
    g_blinkActive = true;
    g_blinkOff = false;
    g_blinkEdgeMs = now + on;
  } else if ((int32_t)(now - g_blinkEdgeMs) >= 0) {
    uint32_t late = now - g_blinkEdgeMs;
    g_blinkOff = !g_blinkOff;
    g_blinkToggles++;
    if (late > g_blinkLateMax) g_blinkLateMax = late;
    if (late * 5 > BLINK_OFF_MS) g_blinkLateOver++;
    const uint32_t next = g_blinkOff ? BLINK_OFF_MS : on;  // これから続く側の時間
    g_blinkEdgeMs = (late < next) ? g_blinkEdgeMs + next : now + next;  // 大きく遅れたら、いまから数え直す
  }
  if (BLINK_WHOLE_SCREEN) setLevel(g_blinkOff ? BL_OFF : BL_NORMAL);
  else setLevel(BL_NORMAL);
}
void blinkPoll(const Signals &s, uint32_t now) {
  if (g_sc == SC_OPENING) return;  // オープニングの間は、オープニングが仮の回転数で blinkRun を呼ぶ
  blinkRun(s.rpmOk, s.rpm, g_sc == SC_DRIVE || g_sc == SC_BOOST, now);
}
static void blinkReset() {  // 点滅をやめて設定の明るさに戻す(オープニングの終わり。次の画面の段階は次の blinkPoll で決まる)
  g_blinkActive = false;
  g_blinkOff = false;
  g_blinkOn = 0;
  setLevel(BL_NORMAL);
}
uint8_t blinkLevel() {
  return g_level;
}
bool blinkDue(uint32_t now) {
  return g_blinkActive && (int32_t)(now - g_blinkEdgeMs) >= 0;
}
uint32_t blinkOnMs() {
  return g_blinkOn;
}
uint32_t blinkOffMs() {
  return g_blinkOn ? BLINK_OFF_MS : 0;
}
void blinkStats(BlinkStats *out, bool reset) {
  out->onMs = g_blinkOn;
  out->offMs = g_blinkOn ? BLINK_OFF_MS : 0;
  out->toggles = g_blinkToggles;
  out->lateMaxMs = g_blinkLateMax;
  out->lateOver = g_blinkLateOver;
  if (reset) g_blinkToggles = g_blinkLateMax = g_blinkLateOver = 0;
}

// ================================================================ 走行画面(3〜5 章)
// 輪のマス: 片側 12 マス(k = 0〜11、下から上。右側は左右反転)+ 真下(k = 12)と真上(k = 13)の 1 マスずつ = 全周 26 マス
// (10/21: 真上と真下の切れ目を埋めた。シフト点で全周が点く。真下は 1 マス目と、真上は 12 マス目と一緒に点く)。
// 26 マスを等間隔に並べる(間隔 360/26°、すき間 RING_GAP_DEG)。片側の 12 マスは、仕様書 3.1 の「97+14k° から 12°」とほぼ同じ位置
static const int RING_SEGS = 14;             // 形の数(片側 12 + 真下 + 真上)
static const int RING_SEG_BOTTOM = 12, RING_SEG_TOP = 13;
static const float RING_PITCH_DEG = 360.0f / 26.0f;
static uint8_t *g_segMask[RING_SEGS];
static gfx::Rect g_segRect[RING_SEGS];
// 2.12.0: 片側の輪(設定「回転数の輪」= 片側。config.h の RING_ONE_*)。マス k = 0〜RING_ONE_SEGS−1 を 4 時の位置から右回りに真上へ
// (最後 = 真上 = シフト点)。両側のマスとは別の形を作っておき、描くときに g_ringOne で選ぶ。間隔は、1 マス目の外の端が RING_ONE_START_DEG、
// 最後のマスの真ん中が真上(270°)になる幅。マスの色は「置き場」k ごとに持つ(両側は 0〜13、片側は 0〜RING_ONE_SEGS−1)
static const int RING_SLOTS = RING_ONE_SEGS > RING_SEGS ? RING_ONE_SEGS : RING_SEGS;
static uint16_t g_segCol[RING_SLOTS];
static const float RING_ONE_PITCH_DEG = (270.0f - RING_ONE_START_DEG + RING_GAP_DEG * 0.5f) / ((float)RING_ONE_SEGS - 0.5f);
static uint8_t *g_oneMask[RING_ONE_SEGS];
static gfx::Rect g_oneRect[RING_ONE_SEGS];
static bool g_ringOne = false;  // 描いている輪が片側(走行画面は設定が変わったら全部を描き直す。オープニングは始めに決める)
static uint16_t g_bgCol = 0;
static uint32_t g_bgMs = 0;
static uint32_t g_waterKey = 0, g_fuelKey = 0;

// マス k の中心の角度(3 時が 0°、時計回り)。k = 0〜11 は左側(真下から上へ)、12 = 真下、13 = 真上
static float segCenterDeg(int k) {
  if (k == RING_SEG_BOTTOM) return 90.0f;
  if (k == RING_SEG_TOP) return 270.0f;
  return 90.0f + RING_PITCH_DEG * (k + 1);
}
// 片側の輪のマス k の中心の角度(3 時が 0°、時計回り。最後 = 真上の 270°、0 = 4 時のすぐ下。2.12.0)
static float oneCenterDeg(int k) {
  return 270.0f - RING_ONE_PITCH_DEG * (float)(RING_ONE_SEGS - 1 - k);
}
// 片側の輪で点くマスの数(1 マス目はシフト点 − (RING_ONE_SEGS − 1) × RING_ONE_STEP_RPM = 両側の 1 マス目と同じ回転数。2.12.0)
static int litOne(int rpm, int sp) {
  const int first = sp - (RING_ONE_SEGS - 1) * RING_ONE_STEP_RPM;
  int n = 0;
  for (int k = 0; k < RING_ONE_SEGS; k++)
    if (rpm >= first + RING_ONE_STEP_RPM * k) n++;
  return n;
}
static int ringLit(int rpm, int sp) {  // 今の輪で点くマスの数(両側は片側の数)
  return g_ringOne ? litOne(rpm, sp) : litPerSide(rpm, sp);
}
static int ringFull() {  // 全部点いたときの数
  return g_ringOne ? RING_ONE_SEGS : 12;
}
// マス k(n マス点いているとき。両側は片側の数)が点いているか
static bool segLit(int k, int n) {
  if (g_ringOne) return k < RING_ONE_SEGS && k < n;  // 2.12.0: 片側
  if (k >= RING_SEGS) return false;
  if (k == RING_SEG_BOTTOM) return n >= 1;
  if (k == RING_SEG_TOP) return n >= 12;
  return k < n;
}
// マスの形: 中心 (233, 233)、半径 RING_R_IN〜RING_R_OUT、中心の角度 c ± 幅 w / 2(w = 間隔 − すき間)。pool に作る(入らなければ nullptr)
static const int RING_POOL_BYTES = (RING_SEGS + RING_ONE_SEGS) * 80 * 80;  // 2.12.0: 片側のマスのぶんも
static void segShape(float c, float w, uint8_t *&pool, uint8_t *poolEnd, uint8_t **mask, gfx::Rect *rect) {
  *mask = nullptr;
  if (!pool) return;
  gfx::Pt p[20];
  int n = 0;
  float a0 = c - w * 0.5f;
  for (int i = 0; i <= 8; i++) {
    float a = (a0 + w * i / 8) * PI_F / 180.0f;
    p[n++] = { 233 + RING_R_OUT * cosf(a), 233 + RING_R_OUT * sinf(a) };
  }
  for (int i = 8; i >= 0; i--) {
    float a = (a0 + w * i / 8) * PI_F / 180.0f;
    p[n++] = { 233 + RING_R_IN * cosf(a), 233 + RING_R_IN * sinf(a) };
  }
  float x0 = 1e9f, y0 = 1e9f, x1 = -1e9f, y1 = -1e9f;
  for (int i = 0; i < n; i++) {
    if (p[i].x < x0) x0 = p[i].x;
    if (p[i].y < y0) y0 = p[i].y;
    if (p[i].x > x1) x1 = p[i].x;
    if (p[i].y > y1) y1 = p[i].y;
  }
  gfx::Rect r = { (int16_t)floorf(x0), (int16_t)floorf(y0), (int16_t)ceilf(x1), (int16_t)ceilf(y1) };
  *rect = r;
  if (pool + (r.x1 - r.x0) * (r.y1 - r.y0) > poolEnd) return;
  *mask = pool;
  pool += (r.x1 - r.x0) * (r.y1 - r.y0);
  gfx::polyBegin(r);
  gfx::polyAdd(p, n);
  gfx::polyToMask(*mask);
}
static void buildRing() {
  uint8_t *pool = (uint8_t *)platAlloc(RING_POOL_BYTES);
  uint8_t *poolEnd = pool ? pool + RING_POOL_BYTES : nullptr;
  for (int k = 0; k < RING_SEGS; k++) segShape(segCenterDeg(k), RING_PITCH_DEG - RING_GAP_DEG, pool, poolEnd, &g_segMask[k], &g_segRect[k]);
  for (int k = 0; k < RING_ONE_SEGS; k++) segShape(oneCenterDeg(k), RING_ONE_PITCH_DEG - RING_GAP_DEG, pool, poolEnd, &g_oneMask[k], &g_oneRect[k]);
}

static void drawSeg(int k, uint16_t c) {
  g_segCol[k] = c;
  if (g_ringOne) {  // 2.12.0: 片側(左右反転しない)
    if (k < RING_ONE_SEGS && g_oneMask[k]) gfx::maskReplace(g_oneMask[k], g_oneRect[k], false, c, g_bgCol);
    return;
  }
  if (k >= RING_SEGS || !g_segMask[k]) return;
  gfx::maskReplace(g_segMask[k], g_segRect[k], false, c, g_bgCol);  // 縁は今の背景の色と混ぜる
  if (k < 12) gfx::maskReplace(g_segMask[k], g_segRect[k], true, c, g_bgCol);  // 右側は左右反転(x → 466−x)。真上・真下は 1 つ
}
// マス k が描く所の四角を r に入れ、数を返す(両側の片側 12 マスは左右の 2 つ、使わない置き場は 0。2.12.0)
static int segRects(int k, gfx::Rect r[2]) {
  if (g_ringOne) {
    if (k >= RING_ONE_SEGS) return 0;
    r[0] = g_oneRect[k];
    return 1;
  }
  if (k >= RING_SEGS) return 0;
  r[0] = g_segRect[k];
  if (k >= 12) return 1;
  r[1] = { (int16_t)(gfx::W - r[0].x1), r[0].y0, (int16_t)(gfx::W - r[0].x0), r[0].y1 };
  return 2;
}

static float clampf(float v, float lo, float hi) {
  return v < lo ? lo : (v > hi ? hi : v);
}

// 水温と燃料の円弧(config.h の ARC_*)。弧の先の位置を 1/4 度刻みで求める(この刻みで変わったときだけ描き直す)
static int waterArcQ(const Signals &s) {
  return (int)(4.0f * ARC_SWEEP_DEG * (clampf(s.waterC, WATER_BAR_MIN_C, WATER_BAR_MAX_C) - WATER_BAR_MIN_C) / (WATER_BAR_MAX_C - WATER_BAR_MIN_C) + 0.5f);
}
static int fuelArcQ(const Signals &s) {
  return (int)(4.0f * ARC_SWEEP_DEG * clampf(s.fuelPct, 0, 100) / 100.0f + 0.5f);
}
static void arc(float a0, float a1, uint16_t c) {
  gfx::fillArc(233, 233, ARC_R_IN, ARC_R_OUT, a0, a1, c);
}
// 弧のある側(上 = 水温、下 = 燃料)を、半径 ALARM_FILL_R の円の中で横一直線に切った形で塗る(10/22)。
// 弧・アイコン・「– –」はこの中に収まるので、描き直すときはこれで消す(オープニング)。2.14.0: 警告でも赤く塗らなくなったので、消すためだけに使う。
// clear: なめらかにせず、縁から 2 px 外まで c 一色にする(前に赤く塗った縁の画素が残らない。輪の内側 RING_R_IN には届かない)。
// それ以外: 円の縁は画素の途中で切れるので、1 行ずつ fillRectF で塗る(左右の端がなめらかになる。下地は消した直後の背景)
static void fillSide(bool top, uint16_t c, bool clear) {
  const float R = clear ? ALARM_FILL_R + 2.0f : ALARM_FILL_R;
  const int y0 = top ? (int)(233 - R) : ALARM_FUEL_Y0;
  const int y1 = top ? ALARM_WATER_Y1 : (int)(233 + R) + 1;
  for (int y = y0; y < y1; y++) {
    float dy = (float)y + 0.5f - 233.0f;
    float d2 = R * R - dy * dy;
    if (d2 <= 0) continue;
    float hw = sqrtf(d2);
    if (clear) {
      int x0 = (int)floorf(233.0f - hw), x1 = (int)ceilf(233.0f + hw);
      gfx::fillRect(x0, y, x1 - x0, 1, c);
    } else {
      gfx::fillRectF(233.0f - hw, (float)y, 233.0f + hw, (float)(y + 1), c);
    }
  }
}
// 水温・燃料の段(2.14.0): 0 = 正常、1 = 注意(暗い黄)、2 = 警告(赤・点滅)。本人 10/30「まず、薄い黄色にしてから赤い警告にしたい」
// 「しきい値−５度の時点で燃料と同じように薄い黄色から警告表示に移行する」。
// 境目そのもの(ヒステリシスなし。上がる側の判定と、オープニングのデモ): 水温は 警告温度 − WATER_CAUTION_BELOW_C で注意、警告温度で警告。
// 燃料は 燃料の警告 + FUEL_CAUTION_ABOVE_PCT 未満で注意、燃料の警告 未満で警告
static uint8_t waterLevelOf(float c) {
  return c >= (float)g_set->warnTempC ? 2 : (c >= (float)(g_set->warnTempC - WATER_CAUTION_BELOW_C) ? 1 : 0);
}
static uint8_t fuelLevelOf(float p) {
  return p < (float)g_set->fuelWarnPct ? 2 : (p < (float)(g_set->fuelWarnPct + FUEL_CAUTION_ABOVE_PCT) ? 1 : 0);
}
// 今の段 cur から次の段を決める(update)。上がるのは境目そのもの。戻るのは、今の段の境目から WATER_ALARM_HYST_C / FUEL_ALARM_HYST_PCT ぶん
// 離れてから(境目でちらつかない)。離れていれば 2 段いっぺんに戻る
static uint8_t waterLevelHyst(float c, uint8_t cur) {
  uint8_t lvl = waterLevelOf(c);
  if (lvl < cur) {
    const float edge = cur == 2 ? (float)g_set->warnTempC : (float)(g_set->warnTempC - WATER_CAUTION_BELOW_C);
    if (c >= edge - WATER_ALARM_HYST_C) lvl = cur;
  }
  return lvl;
}
static uint8_t fuelLevelHyst(float p, uint8_t cur) {
  uint8_t lvl = fuelLevelOf(p);
  if (lvl < cur) {
    const float edge = cur == 2 ? (float)g_set->fuelWarnPct : (float)(g_set->fuelWarnPct + FUEL_CAUTION_ABOVE_PCT);
    if (p < edge + FUEL_ALARM_HYST_PCT) lvl = cur;
  }
  return lvl;
}
// 注意・警告のときの、弧の伸びた所とアイコンの色(2.14.0)。警告は点滅(点灯側は赤、消灯側は暗い赤。赤っぽい背景では白と薄い赤)
static uint16_t levelColor(uint8_t lvl, uint16_t bg) {
  if (lvl == 2) return g_alarmOff ? alarmDimOn(bg) : alarmOn(bg);
  return cautionOn(bg);
}

// 水温(5.4、5.6、5.7 を円弧にしたもの)。上の弧: 左端(220°)から時計回りに伸びる。
// 2.10.0: 弧は時計の内側(ARC_R_IN〜ARC_R_OUT)、アイコン(32 px)は弧の右端の先(342°、半径 116。仕様書 circuit_screen_spec.md 4.1)。
// 2.14.0: 注意は伸びた所とアイコンを暗い黄に、警告は赤にして点滅(消灯側は暗い赤)。弧の地は正常と同じ(警告温度から上は暗い赤)。
// 背景は塗らない(2.13.0 までは警告の点灯側に上側を fillSide で赤く塗っていた。本人 10/30「警告が目につきすぎて気になってしまうので、
// 背景は黒のままにしてください」)。
// clean = true: 背景を塗った直後(消す必要がない。サーキットでは時計の内側の絵 innerDraw がいつも塗ってから描く)。
// false はオープニングだけ(時計を出す前に、画面へ直接描き直す)
static const int ICON_M = 32;  // アイコンの大きさ(ICON_WATER_M・ICON_FUEL_M)
static const int ICON_WATER_X = 327, ICON_WATER_Y = 181, ICON_FUEL_X = 107, ICON_FUEL_Y = 253;
static void drawWaterPanel(const Signals &s, bool clean) {
  const float A0 = WATER_ARC_START_DEG, A1 = WATER_ARC_START_DEG + ARC_SWEEP_DEG;
  const uint8_t lvl = s.waterOk ? g_waterLvl : 0;
  if (!clean) {
    fillSide(true, g_bgCol, true);
    gfx::fillRect(ICON_WATER_X, ICON_WATER_Y, ICON_M, ICON_M, g_bgCol);
  }
  gfx::drawIcon(ICON_WATER_M, ICON_WATER_X, ICON_WATER_Y, lvl ? levelColor(lvl, g_bgCol) : labelOn(g_bgCol));
  if (!s.waterOk) {
    textC(FONT_NUM600_34, 233, 129, "– –", labelOn(g_bgCol));  // 弧の真ん中(半径 116)
    return;
  }
  const float span = WATER_BAR_MAX_C - WATER_BAR_MIN_C;
  float ae = A0 + waterArcQ(s) * 0.25f;
  float aw = A0 + ARC_SWEEP_DEG * (clampf((float)g_set->warnTempC, WATER_BAR_MIN_C, WATER_BAR_MAX_C) - WATER_BAR_MIN_C) / span;
  float ab = A0 + ARC_SWEEP_DEG * (WATER_BLUE_END_C - WATER_BAR_MIN_C) / span;
  if (aw >= A1 - 0.1f) {
    arc(A0, A1, C_TRACK);
  } else {
    arc(A0, A1, C_WARN_TRACK);
    arc(A0, aw, C_TRACK);
  }
  if (lvl) {
    arc(A0, ae, levelColor(lvl, g_bgCol));
    return;
  }
  arc(A0, ae, C_WATER_BLUE);
  if (ae > ab) arc(ab, ae, C_WHITE);
}

// 燃料(5.5、5.6、5.7 を円弧にしたもの)。下の弧: 左端(140°)から反時計回り(角度が減る向き)に伸びる。
// 2.10.0: アイコン(32 px)は弧の左端の先(162°、半径 116)。0〜燃料の警告(設定。2.14.0)の地は暗い赤(10/22)。注意・警告の描き方は水温と同じ
static void drawFuelPanel(const Signals &s, bool clean) {
  const float A1 = FUEL_ARC_START_DEG, A0 = FUEL_ARC_START_DEG - ARC_SWEEP_DEG;
  const uint8_t lvl = s.fuelOk ? g_fuelLvl : 0;
  if (!clean) {
    fillSide(false, g_bgCol, true);
    gfx::fillRect(ICON_FUEL_X, ICON_FUEL_Y, ICON_M, ICON_M, g_bgCol);
  }
  gfx::drawIcon(ICON_FUEL_M, ICON_FUEL_X, ICON_FUEL_Y, lvl ? levelColor(lvl, g_bgCol) : labelOn(g_bgCol));
  if (!s.fuelOk) {
    textC(FONT_NUM600_34, 233, 361, "– –", labelOn(g_bgCol));
    return;
  }
  float as = A1 - fuelArcQ(s) * 0.25f;
  const float aw = A1 - ARC_SWEEP_DEG * (float)g_set->fuelWarnPct / 100.0f;  // 警告になる残量の所
  arc(A0, aw, C_TRACK);
  arc(aw, A1, C_WARN_TRACK);
  arc(as, A1, lvl ? levelColor(lvl, g_bgCol) : C_WHITE);
}

// 3000rpm 以下の経過時間(config.h の IDLE_*)。update のたびに記録する(どの画面でも)。2.12.0: 回転数は設定の「過負荷 回転数」(初期値 3000)
static uint32_t g_lowSinceMs = 0;  // 回転数が過負荷 回転数未満になった時刻(0 = 今は以上、信号なし)
static uint32_t g_nSinceMs = 0;    // ギアが N になった時刻(0 = N ではない)
static void idleTrack(const Signals &s, uint32_t now) {
  if (s.rpmOk && s.rpm < g_set->loadRpm) {  // 2.12.0: 過負荷時間とそろえて「以下」→「未満」
    if (!g_lowSinceMs) g_lowSinceMs = now ? now : 1;
  } else {
    g_lowSinceMs = 0;
  }
  if (s.gearOk && s.gear == 'N') {
    if (!g_nSinceMs) g_nSinceMs = now ? now : 1;
  } else {
    g_nSinceMs = 0;
  }
}
// ▼ 3000rpm と経過時間を出すときは、その秒数。出さないときは -1
static int idleShowSec(uint32_t now) {
  if (!g_lowSinceMs || !g_nSinceMs || (uint32_t)(now - g_nSinceMs) < IDLE_SHOW_AFTER_N_MS) return -1;
  uint32_t sec = (uint32_t)(now - g_lowSinceMs) / 1000;
  return sec > 359999 ? 359999 : (int)sec;
}

static void triDown(float cx, float cy, float size, uint16_t c) {  // 下向きの正三角形(中心 cx, cy、一辺 size)
  const float h = size * 0.866f;
  gfx::Pt p[3] = { { cx - size * 0.5f, cy - h * 0.5f }, { cx + size * 0.5f, cy - h * 0.5f }, { cx, cy + h * 0.5f } };
  gfx::polyBegin(gfx::Rect{ (int16_t)(cx - size), (int16_t)(cy - size), (int16_t)(cx + size + 1), (int16_t)(cy + size + 1) });
  gfx::polyAdd(p, 3);
  gfx::polyFill(c);
}
static void triUp(float cx, float cy, float size, uint16_t c) {
  const float h = size * 0.866f;
  gfx::Pt p[3] = { { cx, cy - h * 0.5f }, { cx + size * 0.5f, cy + h * 0.5f }, { cx - size * 0.5f, cy + h * 0.5f } };
  gfx::polyBegin(gfx::Rect{ (int16_t)(cx - size), (int16_t)(cy - size), (int16_t)(cx + size + 1), (int16_t)(cy + size + 1) });
  gfx::polyAdd(p, 3);
  gfx::polyFill(c);
}

// 回転数のピークホールド(10/23): 輪の両側、画面の端に付く黄色の三角形(config.h の PEAK_TRI_*)。
// 位置はピークの回転数が輪のマスのどこに当たるか(1 マス目〜12 マス目、マスの間は比例)。左側の角度 a、右側は 180 − a
static int peakTriKey(const Signals &s);
static gfx::Rect ptsRect(const gfx::Pt *p, int n);
static bool rectsOverlap(const gfx::Rect &a, const gfx::Rect &b);
static void needlePoints(int key, float rIn, float rOut, float wIn, float wOut, gfx::Pt p[4]);
static bool peakHolding(const Signals &s);  // ピークを過ぎた(真ん中の数字を黄にする。2.11.0。2.12.1: 印が下がり始めても黄)
static void fmtTime(char *out, size_t n, uint32_t ms);
static void peakTriPoints(int key, bool right, gfx::Pt p[3]) {
  float a = key * 0.25f;
  if (right) a = 180.0f - a;
  const float ar = a * PI_F / 180.0f, ca = cosf(ar), sa = sinf(ar);
  const float nx = -sa, ny = ca;
  const float bx = 233 + PEAK_TRI_R_BASE * ca, by = 233 + PEAK_TRI_R_BASE * sa;
  p[0] = { bx + nx * PEAK_TRI_HALF_W, by + ny * PEAK_TRI_HALF_W };
  p[1] = { bx - nx * PEAK_TRI_HALF_W, by - ny * PEAK_TRI_HALF_W };
  p[2] = { 233 + PEAK_TRI_R_TIP * ca, 233 + PEAK_TRI_R_TIP * sa };
}
static gfx::Rect peakTriRect(int key, bool right) {
  gfx::Pt p[3];
  peakTriPoints(key, right, p);
  return ptsRect(p, 3);
}
static void drawPeakTris(int key) {
  for (int r = g_ringOne ? 1 : 0; r < 2; r++) {  // 2.12.0: 片側の輪は 1 つだけ(peakTriKey の角度を反転した所)
    gfx::Pt p[3];
    peakTriPoints(key, r != 0, p);
    gfx::polyBegin(ptsRect(p, 3));
    gfx::polyAdd(p, 3);
    gfx::polyFill(C_PEAK);
  }
}
static int g_triKey = -1;  // 描いてある三角形の角度 [1/4 度]。-1 = なし
static float g_peakTop = -1.0f;  // ピークの三角を出している間の最高の回転数(真ん中の数字。三角が下がっても下げない。2.10.0)。-1 = 出していない

// 描いた内容を表す数(これが変わったら描き直す)
static uint32_t waterKey(const Signals &s) {
  if (!s.waterOk) return 1;
  return 2 | ((uint32_t)g_waterLvl << 2) | ((g_waterLvl == 2 && g_alarmOff) ? 16 : 0) | ((uint32_t)waterArcQ(s) << 5) | ((uint32_t)g_set->warnTempC << 16);
}
static uint32_t fuelKey(const Signals &s) {
  if (!s.fuelOk) return 1;
  return 2 | ((uint32_t)g_fuelLvl << 2) | ((g_fuelLvl == 2 && g_alarmOff) ? 16 : 0) | ((uint32_t)fuelArcQ(s) << 5) | ((uint32_t)g_set->fuelWarnPct << 16);  // 2.14.0: 地の境目(燃料の警告)も
}
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
