katsuhaa/abarth595-round-gauge/(commit log)

2026-10-22 Initial import: meter_display firmware with 10/23 UI, C6 CAN link, PC tests, CAD, CAN logs
    最初の登録: 10/23 の画面を入れた表示器のファーム、C6 の CAN 中継、PC の試験、CAD、CAN のログ
    [595merter-replace-60.FCStd, 595merter-replace-70.FCStd, 595merter-replace-back.FCStd, 595merter-replace.FCStd, merter.FCStd, obd2-can-reader.FCStd]
2026-10-22 Add version numbers (meter 1.0.0, c6can 1.0.0); stop holding gear on clutch bit; revert fuel filter to Rev.5
    版を付けた(表示器 1.0.0、C6 1.0.0。オープニングと設定の上の帯に表示)。クラッチのビットでギアを止めるのをやめた(1 速が出にくい原因)。燃料のなましは Rev.5(60 秒の平均)に戻した(Rev.6 はまだ入れない)
    [c6_can_link.ino, config.h, meter_display.ino, ui.cpp]
2026-10-22 c6_can_link 1.1.0: 燃料のなましを安定判定つきの 600 秒ローパスに置き換え
    - 30 秒ハイパス(生 − 短い平均)で安定かどうかを判定
    - 600 秒の指数平均は安定時、または生 < 平均(減る方向)のときだけ更新
    - 給油はエンジン再始動後(回転数 0 か回転数なしが 20 秒以上)の最初の値だけで判定。走行中・停止中は増やさない
    - FUEL_EMPTY_RAW 134 → 120(仮。警告灯の値で確定)
    - HB 行に 生 / hp / lp / 安定 / 停止後 を出し、実車で検証できるようにした
    c6_can_link 1.1.0: replace fuel smoothing with stability-gated 600 s low-pass
    - 30 s high-pass (raw - short EMA) deci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
    [c6_can_link.ino]
2026-10-23 表示器 2.0.0 / C6 2.0.0: 値への換算・ギアの推定・燃料のなましを表示器へ移し、C6 は生データの転送だけにした
    - 表示器: CAN の生データから回転数・アクセル・車速・クラッチ・水温・ブースト・リバース・燃料を求める veh を追加。ギアの推定と燃料のなまし(Rev.6)も C6 から移した
    - 燃料: IG ON 直後の b5 = 0 を捨てる(約 15 分 0 % のままだった原因)。なましの値を他のデータと同じ saveTimes(60 秒ごと、変わったときだけ)で NVS に書き、起動時はその値から始める。給油は保存値との比較で判定
    - 値のフレーム(MlSignals)が届い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
2026-10-23 表示器 2.0.1: タッチの読み取りのあとに 0xAB を書くのをやめた。受信の状態の「描画」をサーキット・タコの 1 回の最長にした
    - タッチ: 読んだあとに D0 00 AB を書くと、次の知らせの前に読み直したとき b[0] = 0xAB が返り「離した」になっていた(長押しが途中で切れてタップになり、設定に入ってすぐ戻る)。書くのをやめた(ESPHome の issue 21010 / PR 21034、Waveshare の esp_lcd_touch_cst9217 と同じ)
    - 描画: 直近 1 秒に送った回数ではなく、サーキット・タコで 1 回描いて送るのにかかった最長を「max 22 ms (45 fps)」の形で出す。画面を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
    [app.h, config.h, fuzz_main.cpp, meter_display.ino, render_main.cpp, ui.cpp, ui.h, unit_main.cpp]
2026-10-23 表示器 2.1.0: サーキット・タコ・データの操作をスワイプと長押しにした
    - 左へスワイプで次の画面、右へスワイプで前の画面(サーキット、タコ、データの順に回る)。離したときに、横に 80 px 以上、横が縦の 2 倍以上動いていればスワイプ
    - 長押し 0.4 秒で設定(前回見ていた項目)。押している間は暗くして外周が一周し、上に「設定」。指が 30 px 以上動いたら長押しを取り消す。設定に入ったあと離してもタップにしない
    - 短いタップは何もしない(押したままで画面が回る動きはやめた)
    - 押している間の知らせごと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
2026-10-23 表示器 2.2.0: 実車で試した結果を反映(長押し・スワイプ・ピークホールド・「正常」の判定)、受信の状態に「燃料」を足した
    - 長押しを 0.4 秒から 0.8 秒に。暗くする表示は長押しの半分から出し、外周はそこから一周する(スワイプの途中で出てうるさかった)
    - スワイプの横の幅を 80 px から 160 px に(80 px は画面で約 7.5 mm で、小さく動かしただけで替わっていた)
    - ピークホールド: 3000 rpm 以上のピークで、回転数が下がっているときだけ出す。回転数がピークを超えたら消す。時間で下がり、今の回転数まで下がったら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
2026-10-24 表示器 2.5.0: 操作と設定・受信の状態を作り直し、オープニングを 3 種類に、データ画面に回転数の輪を足した
    - タッチは 0.1 秒押し続けたら決める(短いタッチは何もしない)。どの画面も離したときに決める。左へスワイプで次、右へで前
    - サーキット・タコ・データ: 触れたら案内(上に「‹ スワイプ ›」、下に「長押し ▶ 設定」)。長押しは 0.4 秒で外周が回り始め、1.2 秒で設定。80 px 動いたら取り消し
    - 設定の中: 上の帯で 1 つ上へ、左右の半分で前・次(スワイプでも送る)。メニューは画面のどこかの長押しで開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
2026-10-24 表示器 2.7.0: 燃料を C-CAN 0A18A000 b5(%)に直した。長押しの外周が出たあとに離したら何もしない。押した帯を反転する。CAN確認に「前後で比べる」(2.6.0)
    - 燃料: 2.6.0 までの B-CAN 0C014003 b5 は燃料ではなかった(純正の燃料計が満タン近くのまま 189 → 135 → 115 と動いた)。C-CAN 0A18A000 b5 が残りの %(10/22 のログ 3 本で 35 → 33 → 31、給油して 100)。なまし・給油の判定・NVS への保存をやめ、0 と 100 超は捨てる。受信の状態 → CAN の「燃料」は表示に使っている %
    - 長押しの表示(外周)が出たあと、HOLD_MS の前に離したらタップにし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
2026-10-24 表示器 2.8.0: ブーストを C-CAN 0A1CA001 b2 × 0.02 bar に直した。タコのブーストの輪は 1.4 bar を真上にした
    - ブースト: 2.7.0 までの 0A18A001 b4 は燃料の量(b4-b5 の 16 ビット、瞬間の燃料流量)だった。減速の燃料カットで 0 になり、クラッチを踏んで 900〜1300 rpm に落ちると戻る。全開で 0A1CA001 b2 が平らな間は回転数に比例する。ブーストは 0A1CA001 b2 × 0.02 bar(10/22 の全開で最大 68 = 1.36 bar)。信号なしの判定も 0A1CA001 で行う
    - タコ: ブーストの輪は、真上(0 時)を 1.4 bar、端を 2.0 bar にした(2.7.0 は真上が 1.5 bar)。0〜1.4 bar は左下から真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
2026-10-25 CAD: git で管理するのを 595merter.FCStd と obd2-can-link.FCStd だけにした
    - それ以外の 6 ファイル(595merter-replace.FCStd・595merter-replace-60.FCStd・595merter-replace-70.FCStd・595merter-replace-back.FCStd・merter.FCStd・obd2-can-reader.FCStd)を git から外し、FCBak と一緒に cad/backup/ に移した。cad/backup/ は .gitignore で除外
    CAD: track only 595merter.FCStd and obd2-can-link.FCStd
    - The other six files (595merter-replace.FCStd, 595merter-replace-60.FCStd, 595merter-replace-70.FCStd, 595merter-replace-back.FCStd, merter.FCStd, obd2-can-reader.FCStd) are removed from git and moved to cad/backup/ with the FCBak files; cad/backup/ is ignored in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
    [595merter-replace-60.FCStd, 595merter-replace-70.FCStd, 595merter-replace-back.FCStd, 595merter-replace.FCStd, 595merter.FCStd, merter.FCStd, obd2-can-link.FCStd, obd2-can-reader.FCStd]
2026-10-26 表示器 2.9.0: ライトのスイッチが入の間はイルミネーションの明るさにする
    - B-CAN 06214000 b0 の 0x08(ライトのスイッチ)が入の間は、ふだんの明るさを設定の新しい項目「イルミネーションの明るさ」(2 番目、初期値 30 %)にする。点滅の消灯と最大輝度(シフト点 + 200 以上、オープニングの赤)は今のまま
    - 最初に受けた値はすぐ使い、そのあとは 0.3 秒続いたら切り替える。5 秒受けなければ受信の状態に「受信なし」と出し、明るさは最後の状態のまま
    - 明るさの 2 項目は、変更の画面の間はその値で表示する
    - 受信の状態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
2026-10-27 表示器 2.10.0: サーキット画面に時計・高負荷時間・接続の状態、タコにギア、設定にデフォルトに戻す
    - サーキット: 回転数の輪の内側にアナログ時計(GPS の時刻 + 9 時間)。水温・燃料の弧を内側(半径 98〜134)へ。真ん中はピークの回転数・高負荷時間・接続の状態を出し分ける
    - 高負荷時間: 3000 rpm 以上で増え、未満で減る。3000 rpm 以下が設定の時間続いたら 0。電源が切れていた時間を GPS の時刻で引く
    - タコ: ブースト圧を上に小さく、下にギア。警告の札を下へ
    - 設定: 高負荷時間 黄・赤、クールダウン時間、高負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
2026-10-28 表示器 2.11.0: 時計を Apple Watch 風に、ピークの数字の色、デジタル時計、タコに SPORT
    時計の針と目盛を Apple Watch 風にした(時針・分針は枠白中黒の四角、目盛 60 本、秒針は縁付きの赤い正三角形)。ピークの回転数は、ピークを過ぎて印が止まっている間だけ黄、加速中と下がっている間は白。サーキットの真ん中はふだんデジタル時計にし、接続の状態は変わってから 10 秒と時刻が分からない間だけ。デモ表示の間は GPS の時刻が分かるまでビルドした時刻から時計を進める。高負荷時間のタイトルを「高負荷」にして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
2026-10-28 表示器 2.12.0: 回転数の輪の片側、設定のカテゴリ、過負荷とクールダウン、累積時間のメンテナンス
    設定に「回転数の輪」(両側・片側)。片側は 4 時の位置から右回りに真上まで 23 マス(200 rpm ごと)で、シフト点が真上。ピークの三角も 1 つ。走行画面の背景は黄の手前まで黒。設定を 6 つのカテゴリ(画面・シフトポイント・水温・過負荷・受信の状態・本体の状態・その他)にまとめ、左右で送って長押しで中へ。「高負荷時間」を「過負荷時間」に、「時間の記録」を「累積時間」にした。設定「過負荷 回転数」(初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
2026-10-28 表示器 2.12.1: 黄になる前の過負荷時間と、ピークを過ぎたあとの白い数字を出さない
    サーキットの真ん中の過負荷時間は、黄(黄が切なら赤)になってから 0 に戻るまで出す。黄になる前の白は出さない(過負荷 回転数を少し超えて下がると、ピークの三角が消えてから 1 秒を切るまでの間、白の「過負荷 0:01」が一瞬出ていた)。「黄になった」は電源を切ると忘れる。ピークの数字は、ピークを過ぎたら三角が消えるまで黄のまま。白は今の回転数が数字の 100 rpm 以内まで上がっている間(加速中)だけ(今までは印が下が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
2026-10-29 CAD: 595merter.FCStd を更新(大体固まった版)
    CAD: update 595merter.FCStd (mostly settled design)
    [595merter.FCStd]
2026-10-29 表示器 2.13.0: M100(u-blox M10)の OTP 高性能設定を起動時に自動で書き、GPS+Galileo で測位 20 回/秒にする。受信の状態 → GPS に「OTP」。仕様書を ui_spec.md に統合
    meter 2.13.0: write the u-blox M10 OTP high-performance setting at boot (verified via MON-VER/VALGET), GPS+Galileo at 20 Hz; add GPS > OTP status page; merge the spec into ui_spec.md
2026-10-30 表示器 2.14.4: GPS の受信を「IO17」・送信を「IO18」に入れ替え(10/31 の試験で確定。M100 が問い合わせに答える)、M100 への送信を普通の UART に(オープンドレインと受信ピンの自動判定を削除)。水温・燃料の警告を 2 段(注意 = 暗い黄、警告 = 赤の点滅、背景は塗らない)、設定に「燃料の警告」。受信の状態に IMU の送信数と「IMU 未設定」
    meter 2.14.4: swap GPS pins (RX = IO17, TX = IO18, confirmed on 10/31; the M100 now answers polls) and drive the M100 as a plain UART (drop open-drain TX and RX pin auto-detect); two-level coolant/fuel warnings (caution = dark yellow, warning = blinki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
    [app.cpp, app.h, config.h, meter_display.ino, render_main.cpp, ui.cpp, unit_main.cpp]
2026-10-30 表示器 2.14.5: M100 の OTP 高性能化を u-blox の手順どおりに実行(確認の問い合わせ VALGET 層 4 の NAK はまだ書いていない印として書き、リセット後に高性能の値が返れば済み)。書くのはこの表示器で一度だけ(NVS の印 otpw)
    meter 2.14.5: run the M10 OTP high-performance write per the u-blox procedure (a NAK to the layer-4 VALGET check means not yet written; write, reset, then verify 192/96 MHz); write at most once per display (NVS flag otpw)
    [config.h, meter_display.ino]
2026-11-09 表示器 2.15.0: 走行記録。B-CAN 0C014003 の ODO とその日の過走行時間を、10 km/h 以下かリバースのときに 60 秒以上あけてパーティション spiffs に 32 バイトずつ追記(28,672 件、輪のように使う)。日付は GPS の時刻(日本時間)。設定に「走行記録」(今の ODO): 3 ヶ月 → 1 ヶ月 → 1 週(日曜始まり)→ 1 日と長押しで細かい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
    Display 2.15.0: odometer log. Append the B-CAN 0C014003 odometer and the day's over-rpm time as 32-byte records to the spiffs partition (28,672 recor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
2026-11-09 表示器 2.15.2: 2.15.0 がビルドできなかったのを直す(走行記録のシリアル出力の文字列 3 か所に改行が入っていた)。走行記録の一番上に 1 年を足す(設定の「走行記録」の長押しで今年の画面、長押しで 3 ヶ月 → 1 ヶ月 → 1 週 → 1 日)
    Display 2.15.2: fix the 2.15.0 build error (three odometer-log serial strings contained raw newlines). Add a 1-year level on top of the odometer log (the settings entry opens the current year; long press drills down to 3 months, 1 month, 1 week and 1 day).
    [app.cpp, app.h, config.h, gen_assets.py, meter_display.ino, render_main.cpp, ui.cpp, ui.h]
2026-11-09 表示器 2.15.3: 設定のカテゴリの並びで「走行記録」を一番最初に(設定に入ったとき最初に出る)
    Display 2.15.3: make the odometer log the first settings category (shown first when entering settings).
2026-11-12 表示器 2.16.0: CAN確認の「前後で比べる」を作り直し、時計の針を塗りつぶし(短針 白・長針 黄)、目盛を太く
    - 前後で比べる: 「前を記録」「後を記録」を交互に何回でも押して絞る(押してから 10 秒が 1 回の記録)。候補はビット単位(前ではいつも同じ値、後ではいつもその逆)と、後は受信なし・前は受信なしの ID。記録は NVS に保存し、電源を切っても続けられる
    - 時計の時針・分針: 枠のみから塗りつぶしに。時針は白、分針は黄(背景が黄のときは紺)。細い黒の縁つき
    - 時計の目盛を太く(毎時 3 から 4.5 px、1 分ごと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
